DAwesomEL/BachelorProsjekt/Pictures/Components/Buck converter.jpg

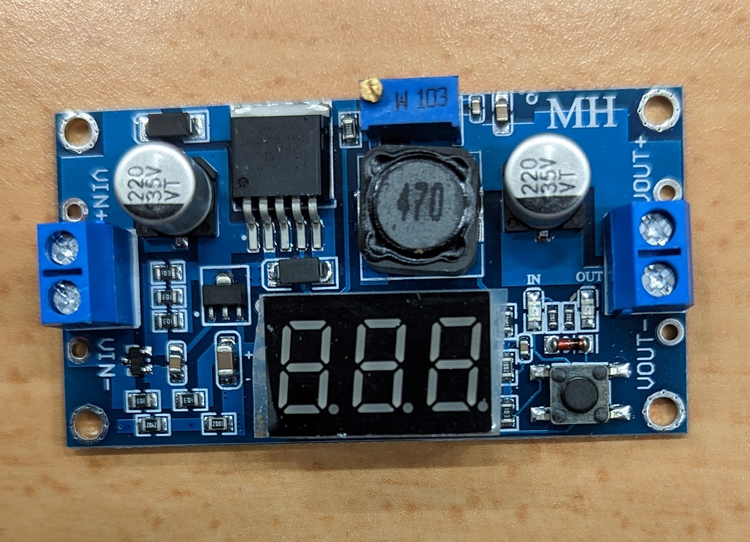
Pictures/Components/Buck converter.jpg
