DAwesomEL/BachelorProsjekt/Pictures/Components/Battery pack.jpg

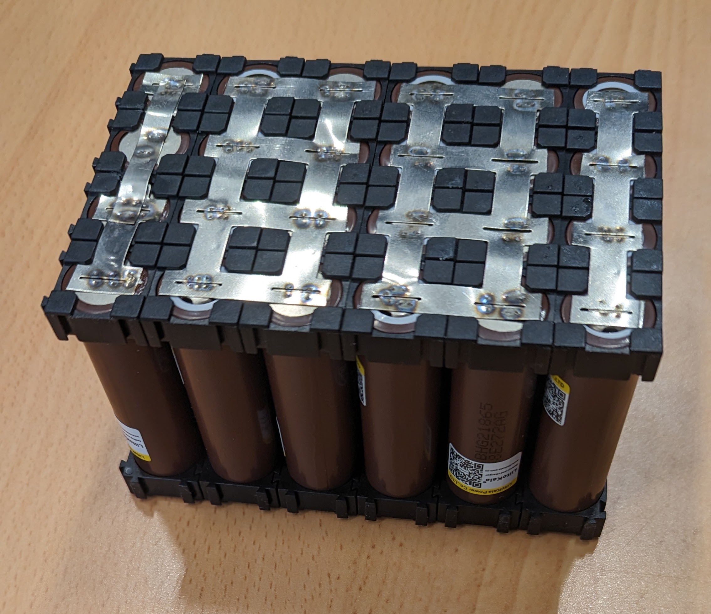
Pictures/Components/Battery pack.jpg
