DAwesomEL/BachelorProsjekt/NOTES/Ting vi har lært.docx

# Ting vi har lært

- Burde dimesjonere oppgjengede hull til oppborringsdiameter, hvis det da ikke gjenges opp kan dette gjøres etterpå. Hvis ikke kan en mennesklig feil gjøre at man må lage en helt ny del.
