DAwesomEL/BachelorProsjekt/NOTES/ToDo.docx

ToDo:

- Søke ntnu
  - Laste opp document når det kommer
- Beregne på akselerasjon
- Større vegg (sirkel rund hull for lokk før torsjon aksling) + deksel over motor hvis motoren blir varm
- Albue ledd
- Legge inn slepering i underarm
