DAwesomEL/BachelorProsjekt/NOTES/Gripper.docx

# Gripper

For å gjøre det simplest mulig, er det bare en motor som driver gripemekanismen. For å gjøre dette må alle fingrene styres av samme motor. Hensyn for at en av fingrene stopper før de andre kan det må tas hensyn til.

Dobbel vippe. Vippe 1: en side til tommel, andre til begge fingrene, vippe 2: festet I en av tauene fra vippe 1 og går til en finger hver. Dette løser alle problemene ved å bruke bare en motor. Trenger trinser og avansert print. Fingrene er trådbaserte. Bruk denne motoren: https://no.rs-online.com/web/p/dc-motors/2456102
