DAwesomEL/BachelorProsjekt/NOTES/Møte uke 6.docx

# Møte uke 6

Skal vi sette opp faste møter fra nå av? Hvilket tidspunkt passer isåfall?

Svar: Sett opp en repeterende outlook kalender invitasjon møter.

Dobbel eller enkel motor I skulder? Kapasisteten blir litt lav med en motor(og det er uten e.e), og vi har funnet en god løsning for beltedrift, men det blir en kontrollutfordring. Vil dette i så fall se bra ut i selve oppgaven? Sterkere motor er veldig vanskelig å finne. Vi kan gire ned motoren mer, men det tar mye plass så er ikke egentlig et alternativ.

Svar:

Beltedrift: Er et smalere belte mindre stift? Går det bra med så liten radius på pulley og idler? 15mm eller 9mm (må bestille 9 men er billig og gir mer mening til det vi lager)

Svar: Kjøp 9 mm

Maskinering av Akslinger fra m10 og m12 maskinskruer, kan det gjøres på huset, hjelp av Harald?

Svar: Vi gjør et forsøk

Vi tenker å bruke simeringer på akselene i kombinasjon med deep groove ball bearings. Tanker? For torsjon av albue, trengs det en thrustbearing?

Svar:

Har Morten fått tak i noen motorkontrollere?

Svar: Fikse selv, få nummer på mail fra Morten

Festeplate av alu, mulig å frese Harald?

Todo videre:

Prøve å flytte motorene bak, for å åpne opp området forran sensorene. Dele parten slik at den blir enklere å lage i alu etter hvert
