DAwesomEL/BachelorProsjekt/NOTES/Regning og gjøremål uke 3.docx

Armen må være 80cm lang fra skulder for å rekke opp til heisknappene. Moment i skulderledd varierer jo derfor av vekt på armen, men all last i hånd vil være mulig på 80cm fra skulderledd. Dette gjør at motorene må være kraftige

Antall | Type | Nummer | Bruk | Pris
4 | Motor | SKU:FIT0186 | 1 krage, 2 skulder, 1 rotasjon overarm | 4 * 290
3 | Motor | SKU:FIT0493 | 1 Albue, 2 end effector posisjonering | 3 * 300

Misc: Teppe fra europris, kartnåler

Gir: RS har løse gir

Motorkontroller

Batterilading?

MONOARM?!?!?!?!?
