DAwesomEL/BachelorProsjekt/NOTES/Presentasjonsforberedende.docx

Spørsmål

- Norsk? Vi kan velge ja
- Hva skal vi fokusere på å ha med i presentasjonen? Alt vi har gjort, så oppsummere rapporten på en måte. +
- Hvordan skal vi rette på de tingene som vi vet at er gjort feil i rapporten? Ha bisetning i muntlig tale på presentasjonen
- Får vi uttelling for å utvikle videre?

Velkommen til denne Bachelor presentasjonen. I dag vil vi vise frem manipulatorene for Loomo roboten som vi har designet og produsert, og tingene den kan gjøre.

Vi har brukt Dynamikk, Kinematikk,

Welcome to this Bachelor presentation. We will today present the manipulators of the Loomo robot and its capabilities.
