DAwesomEL/BachelorProsjekt/Bachelor video/Pictures/DiagonalManipulator.jpg

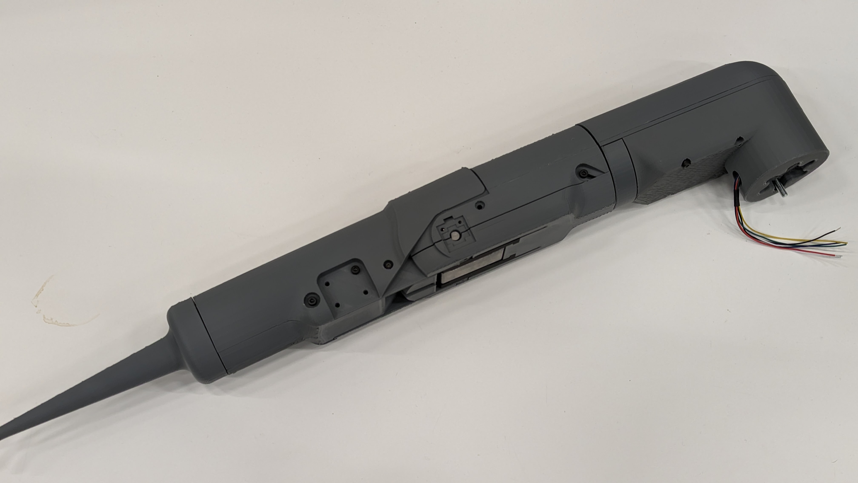
Bachelor video/Pictures/DiagonalManipulator.jpg
