DAwesomEL/BachelorProsjekt/Bachelor video/Pictures/HighHorizontalManipualtor.jpg

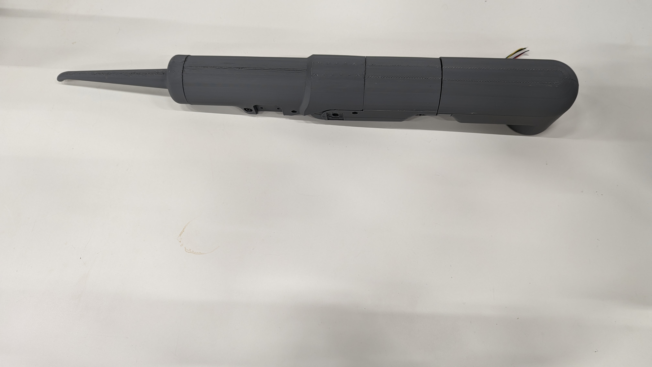
Bachelor video/Pictures/HighHorizontalManipualtor.jpg
