DAwesomEL/BachelorProsjekt/Bachelor video/Pictures/original_7249c3d5-0262-4994-b765-07d0fb0c7d41_PXL_20230512_184123654.jpg

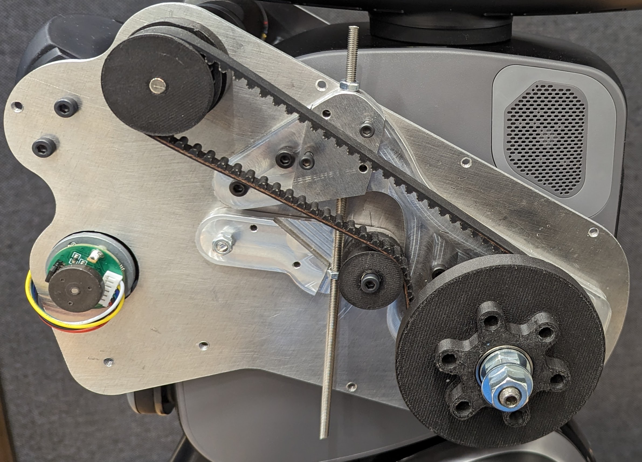
Bachelor video/Pictures/original_7249c3d5-0262-4994-b765-07d0fb0c7d41_PXL_20230512_184123654.jpg
