DAwesomEL/BachelorProsjekt/Bachelor video/Pictures/original_b9bfd44d-96fb-4090-b2bf-ea5d4d30f23f_PXL_20230512_185030678.jpg

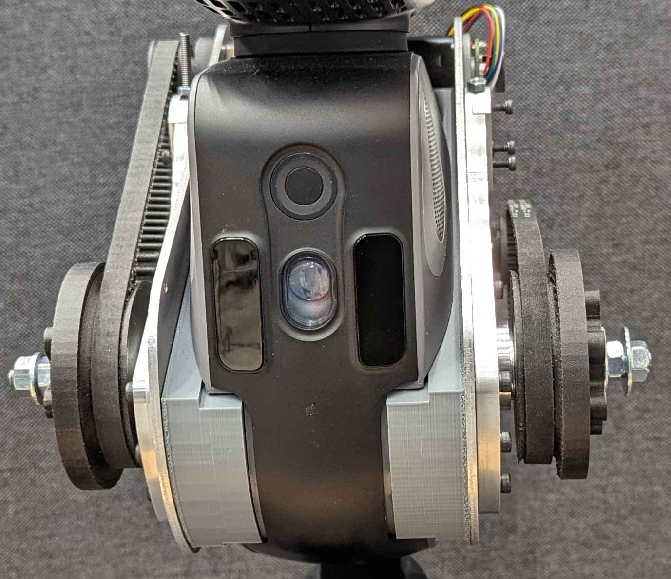
Bachelor video/Pictures/original_b9bfd44d-96fb-4090-b2bf-ea5d4d30f23f_PXL_20230512_185030678.jpg
