DAwesomEL/BachelorProsjekt/Bachelor video/Pictures/original_f11c79bc-f89f-42e6-9544-27d91f9917c7_PXL_20230512_184504795.jpg

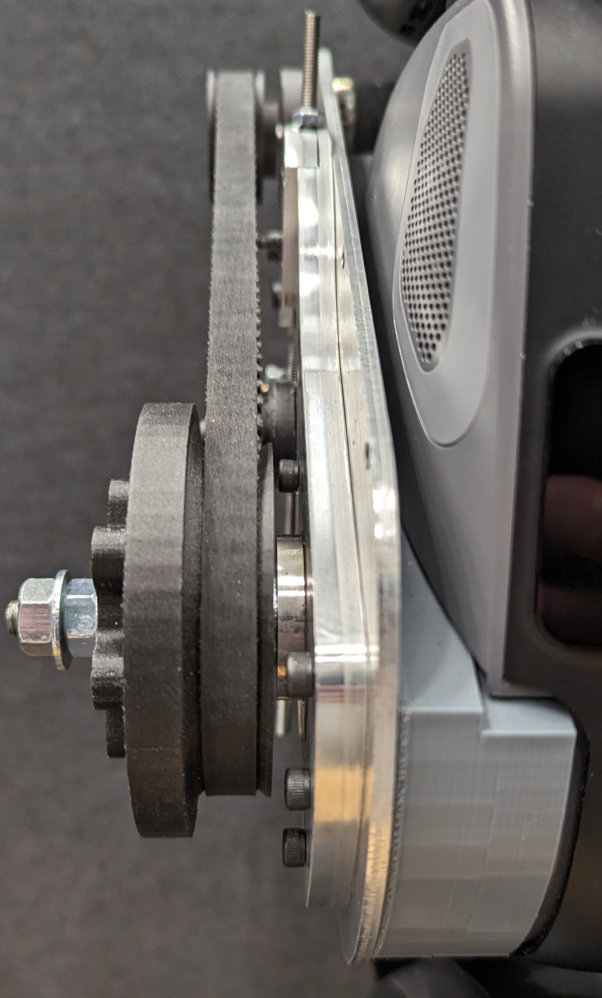
Bachelor video/Pictures/original_f11c79bc-f89f-42e6-9544-27d91f9917c7_PXL_20230512_184504795.jpg
