DAwesomEL/BachelorProsjekt/Bachelor video/Pictures/PXL_20230216_081418842.jpg

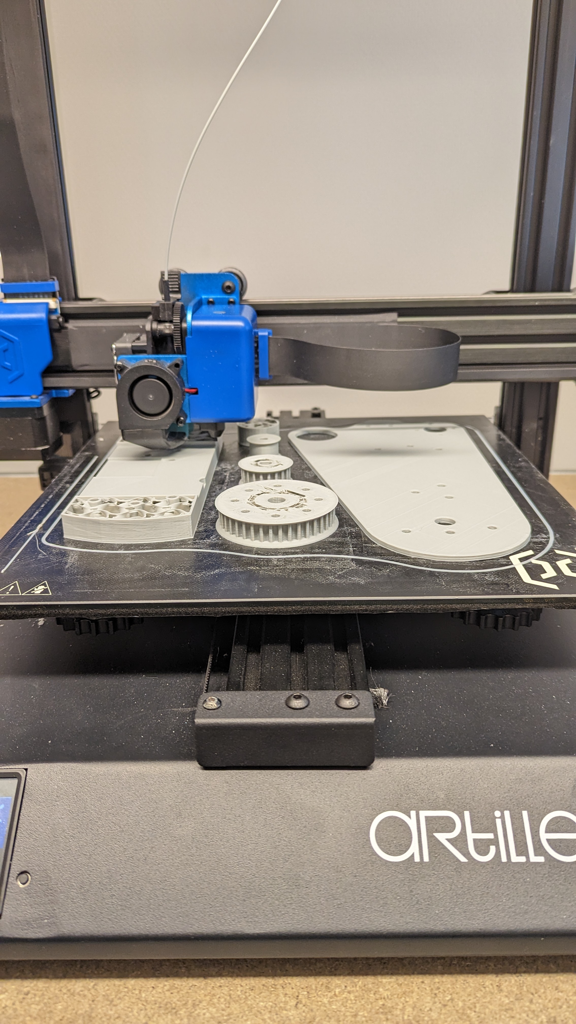
Bachelor video/Pictures/PXL_20230216_081418842.jpg
