DAwesomEL/BachelorProsjekt/Bachelor video/Pictures/PXL_20230216_141814692.jpg

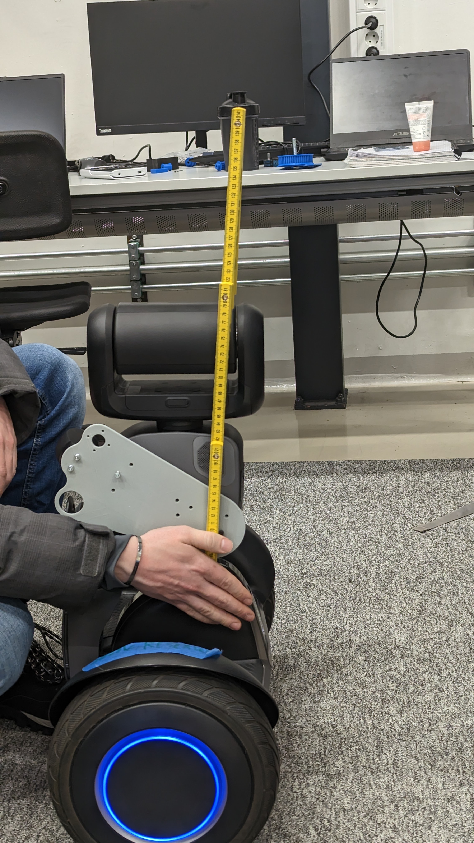
Bachelor video/Pictures/PXL_20230216_141814692.jpg
