DAwesomEL/BachelorProsjekt/Bachelor video/Pictures/PXL_20230216_141823561.jpg

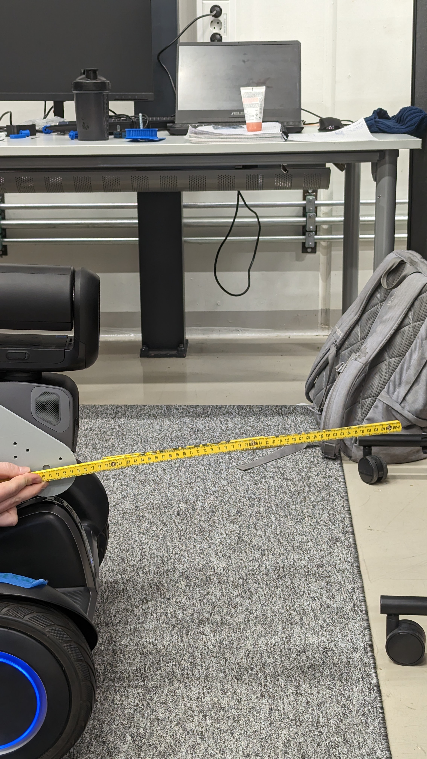
Bachelor video/Pictures/PXL_20230216_141823561.jpg
