DAwesomEL/BachelorProsjekt/Bachelor video/Pictures/PXL_20230405_074010291.jpg

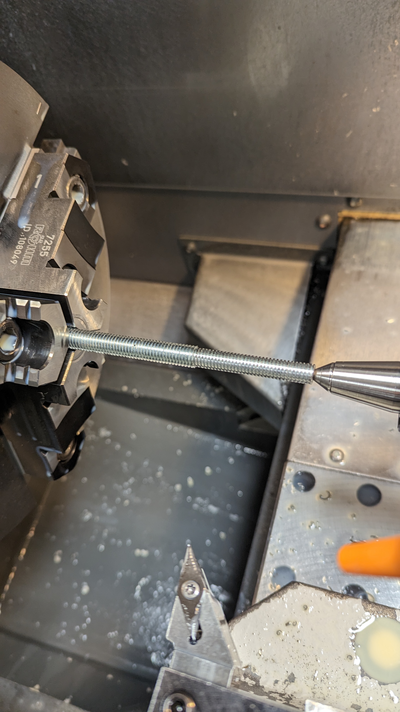
Bachelor video/Pictures/PXL_20230405_074010291.jpg
