DAwesomEL/BachelorProsjekt/Bachelor video/Pictures/PXL_20230425_102538347.jpg

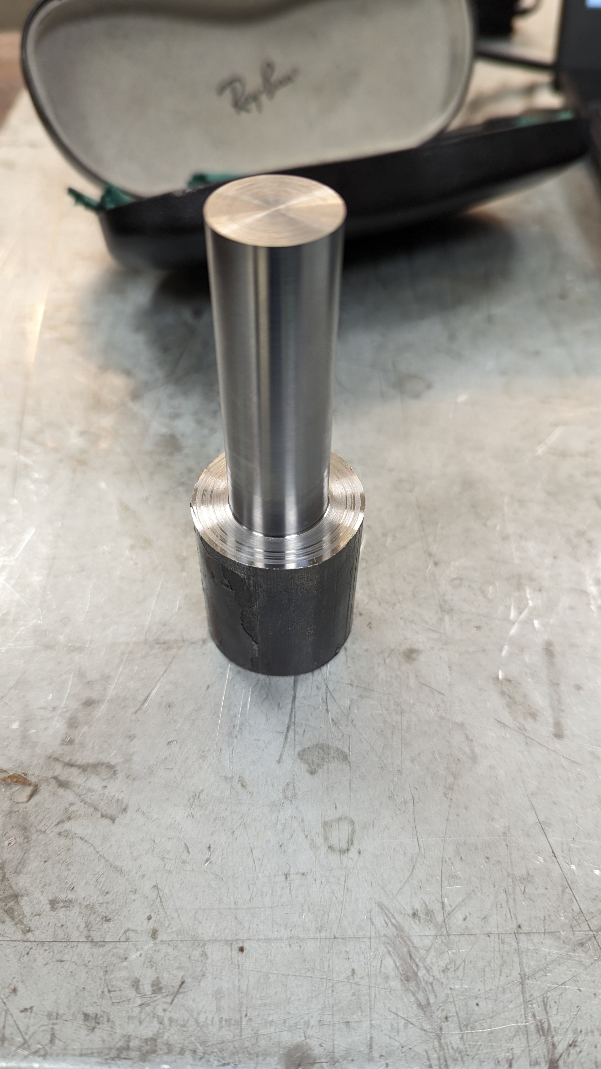
Bachelor video/Pictures/PXL_20230425_102538347.jpg
