DAwesomEL/BachelorProsjekt/Bachelor video/Pictures/PXL_20230426_081251921.jpg

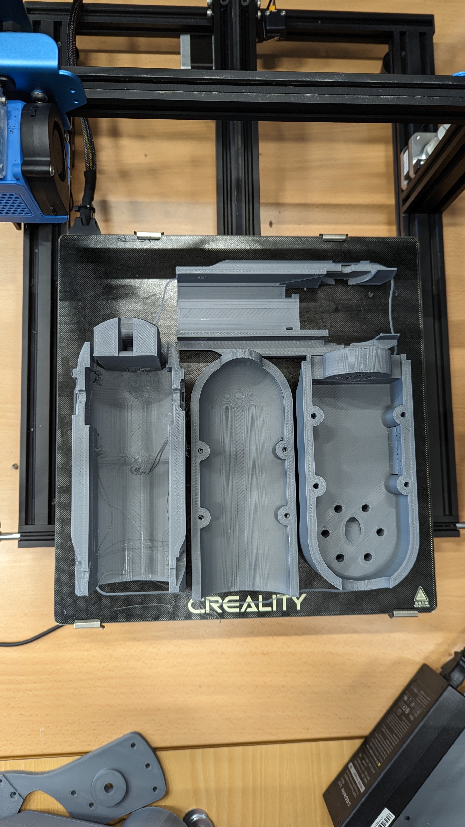
Bachelor video/Pictures/PXL_20230426_081251921.jpg
