DAwesomEL/BachelorProsjekt/Bachelor video/Pictures/PXL_20230428_134609052.jpg

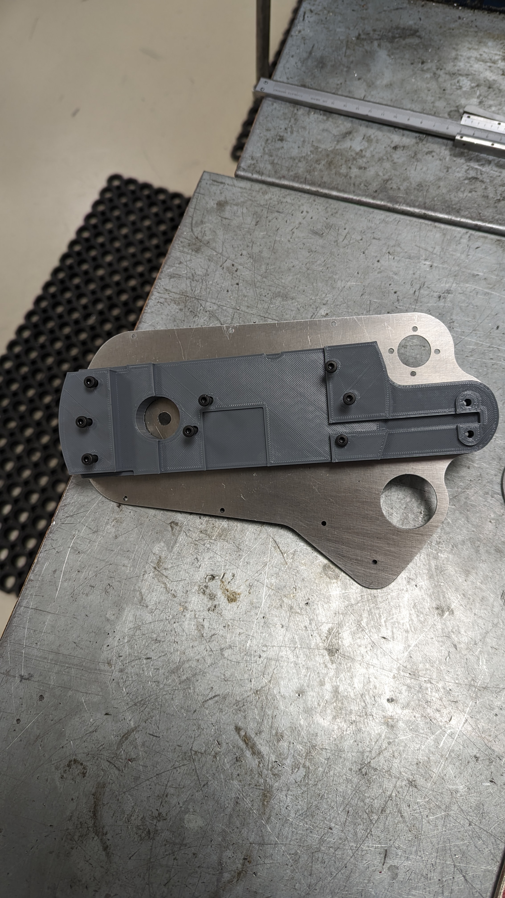
Bachelor video/Pictures/PXL_20230428_134609052.jpg
