DAwesomEL/BachelorProsjekt/Bachelor video/Pictures/PXL_20230429_090824855.jpg

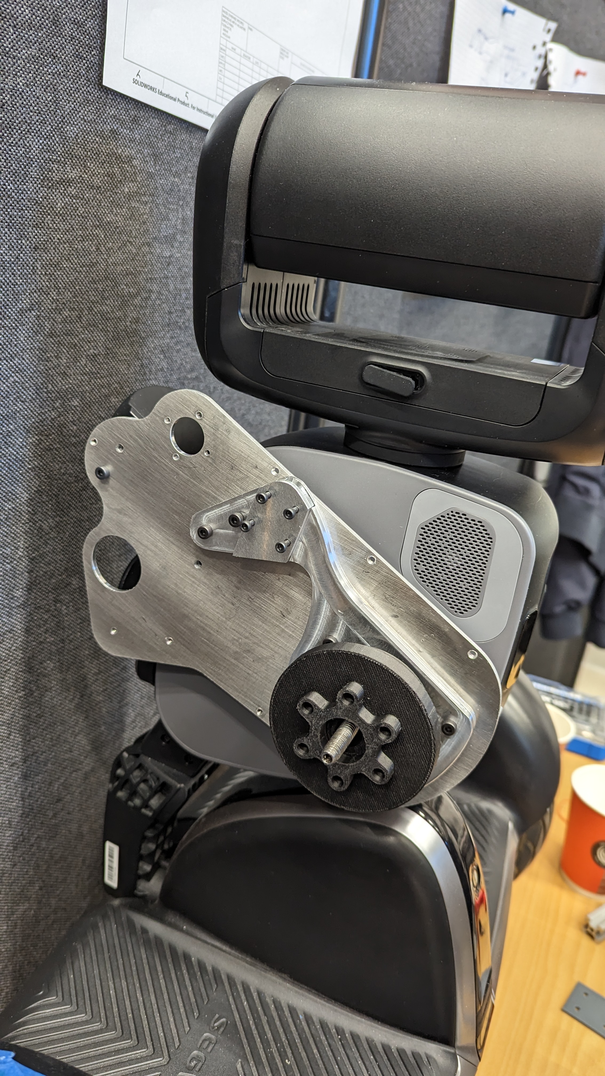
Bachelor video/Pictures/PXL_20230429_090824855.jpg
