DAwesomEL/BachelorProsjekt/Bachelor video/Pictures/PXL_20230430_144859800.jpg

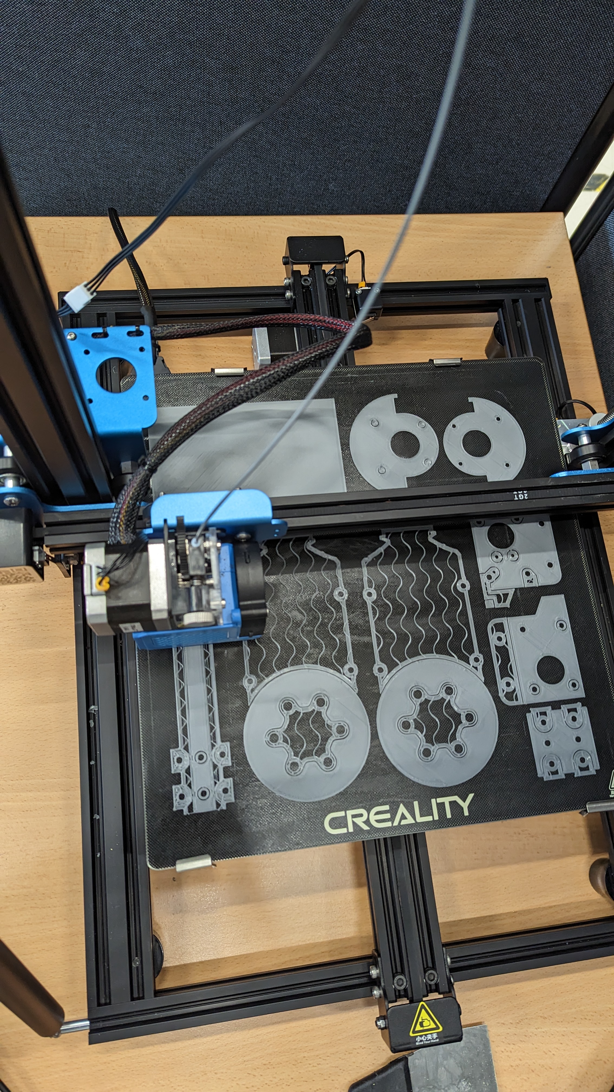
Bachelor video/Pictures/PXL_20230430_144859800.jpg
