DAwesomEL/BachelorProsjekt/Bachelor video/Pictures/PXL_20230506_135338604.jpg

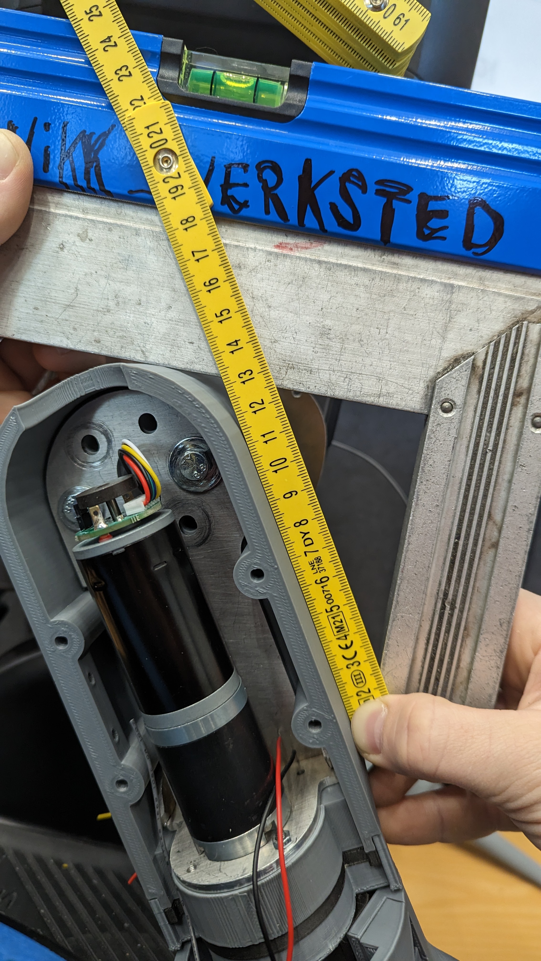
Bachelor video/Pictures/PXL_20230506_135338604.jpg
