DAwesomEL/BachelorProsjekt/Bachelor video/Pictures/PXL_20230509_191600151.jpg

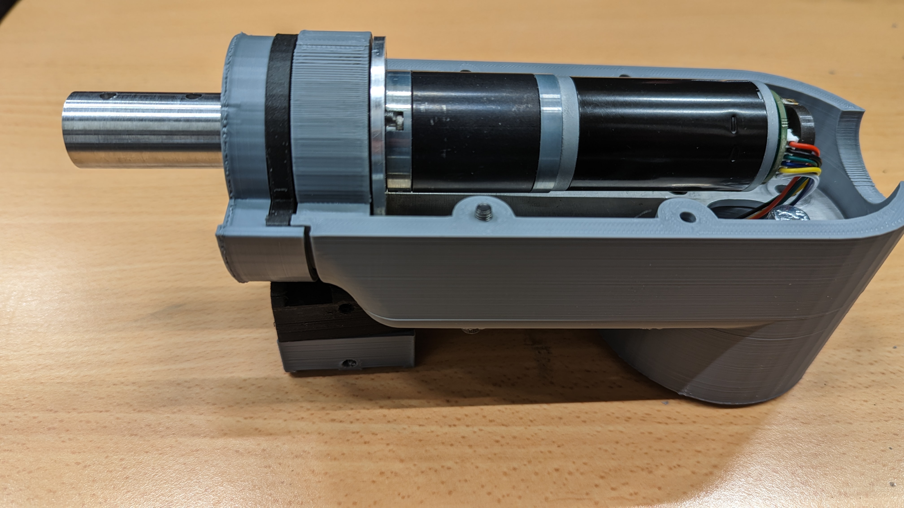
Bachelor video/Pictures/PXL_20230509_191600151.jpg
