DAwesomEL/BachelorProsjekt/Bachelor video/Pictures/PXL_20230512_173815619.jpg

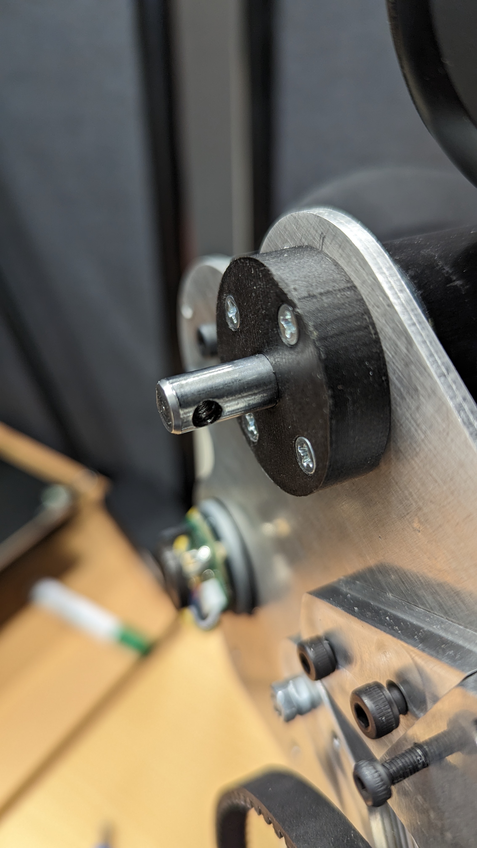
Bachelor video/Pictures/PXL_20230512_173815619.jpg
