DAwesomEL/BachelorProsjekt/Bachelor video/Pictures/SeperatedHorizontalManipulator.jpg

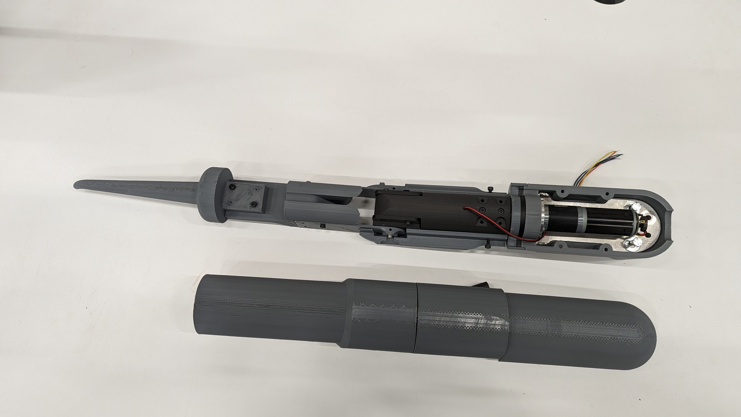
Bachelor video/Pictures/SeperatedHorizontalManipulator.jpg
