DAwesomEL/BachelorProsjekt/Bachelor video/Pictures/Shoulder link.jpg

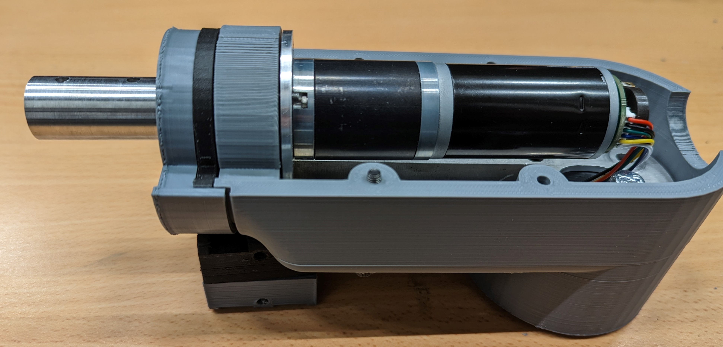
Bachelor video/Pictures/Shoulder link.jpg
