DAwesomEL/BachelorProsjekt/Bachelor video/VideoPicture.PNG

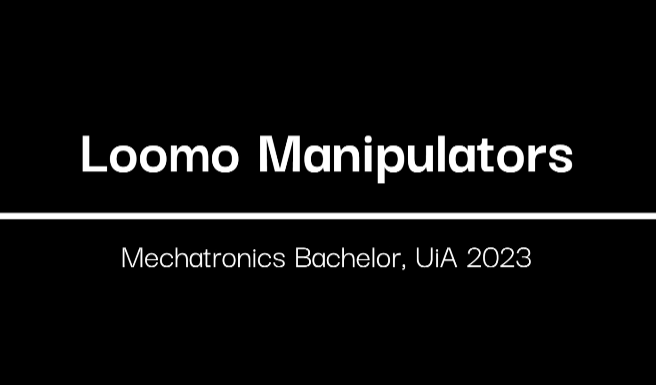
Bachelor video/VideoPicture.PNG
