DAwesomEL/BachelorProsjekt/Literature/Mechanics/A textbook of machine design_ Karwa/Capture.PNG

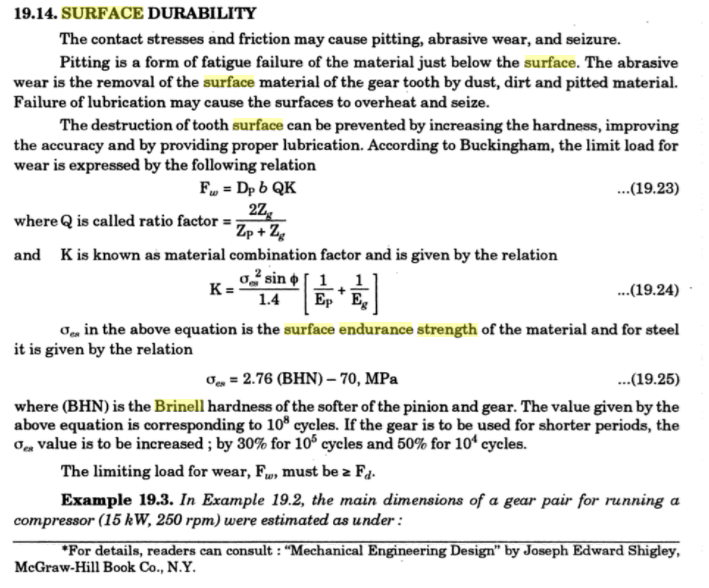
Literature/Mechanics/A textbook of machine design_ Karwa/Capture.PNG
