DAwesomEL/BachelorProsjekt/NOTES/Innkjøpsliste estimat.png

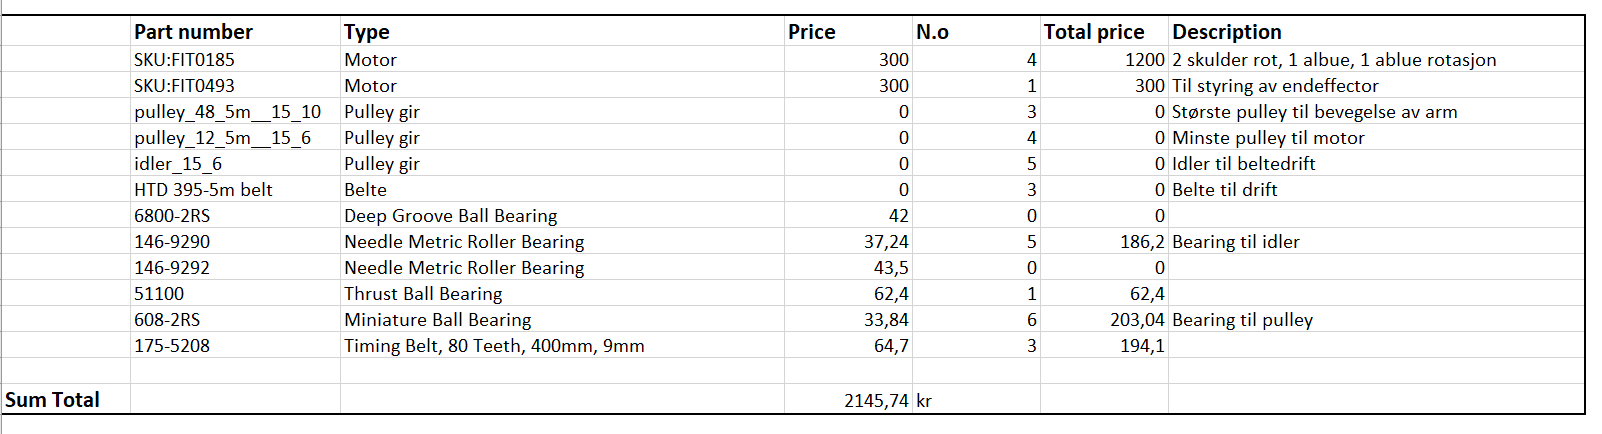
NOTES/Innkjøpsliste estimat.png
