DAwesomEL/BachelorProsjekt/NOTES/ReceiptBiltema1.jpg

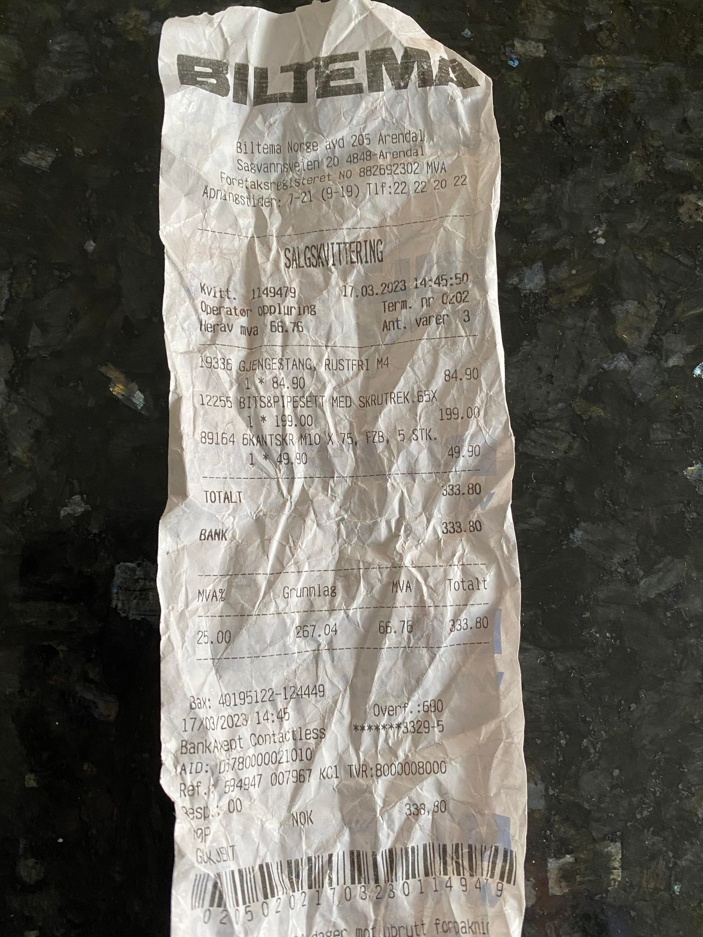
NOTES/ReceiptBiltema1.jpg
