DAwesomEL/BachelorProsjekt/Pictures/Android studio/User interface.png

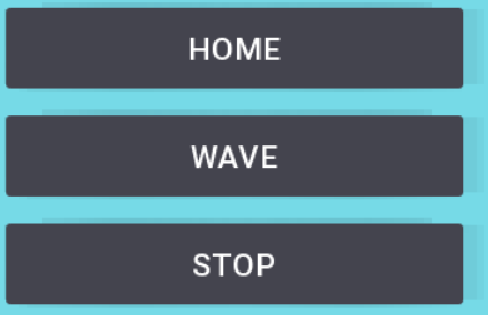
Pictures/Android studio/User interface.png
