DAwesomEL/BachelorProsjekt/Pictures/Angular top speed/SpeedCalcBotPos.PNG

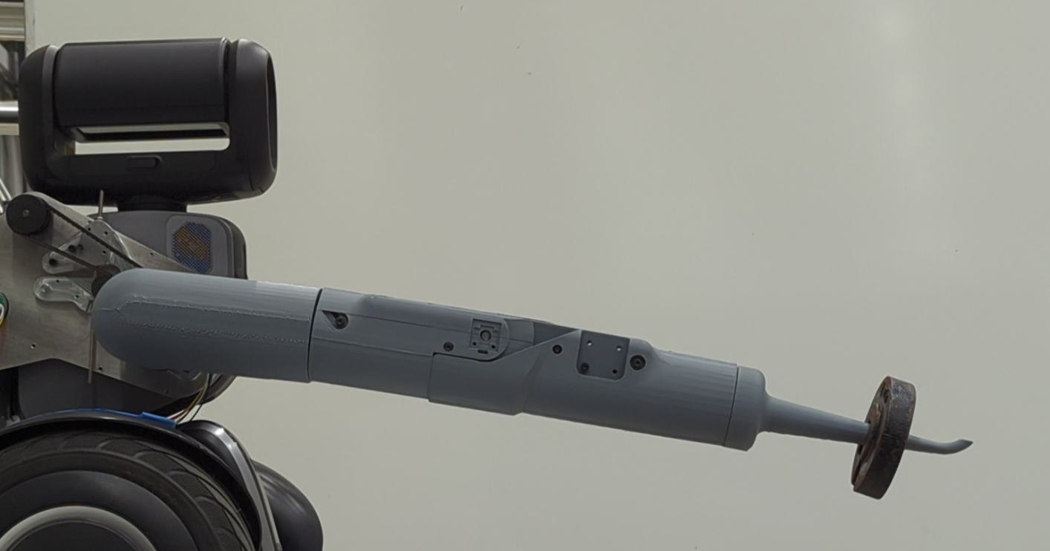
Pictures/Angular top speed/SpeedCalcBotPos.PNG
