DAwesomEL/BachelorProsjekt/Pictures/Angular top speed/SpeedCalcMidPos.PNG

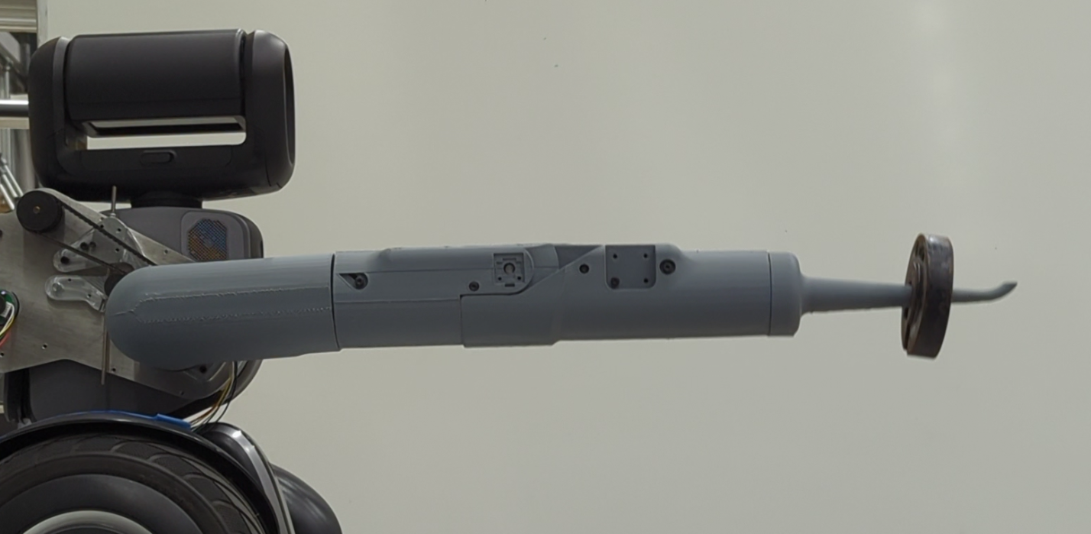
Pictures/Angular top speed/SpeedCalcMidPos.PNG
