DAwesomEL/BachelorProsjekt/Pictures/Angular top speed/SpeedCalcTopAndBot.png

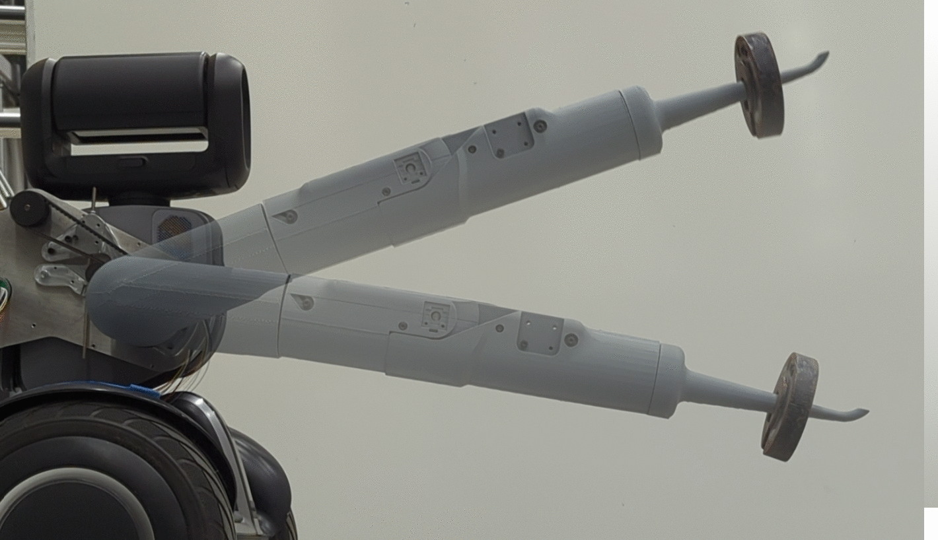
Pictures/Angular top speed/SpeedCalcTopAndBot.png
