DAwesomEL/BachelorProsjekt/Pictures/Angular top speed/SpeedCalcTopAndBotLines.png

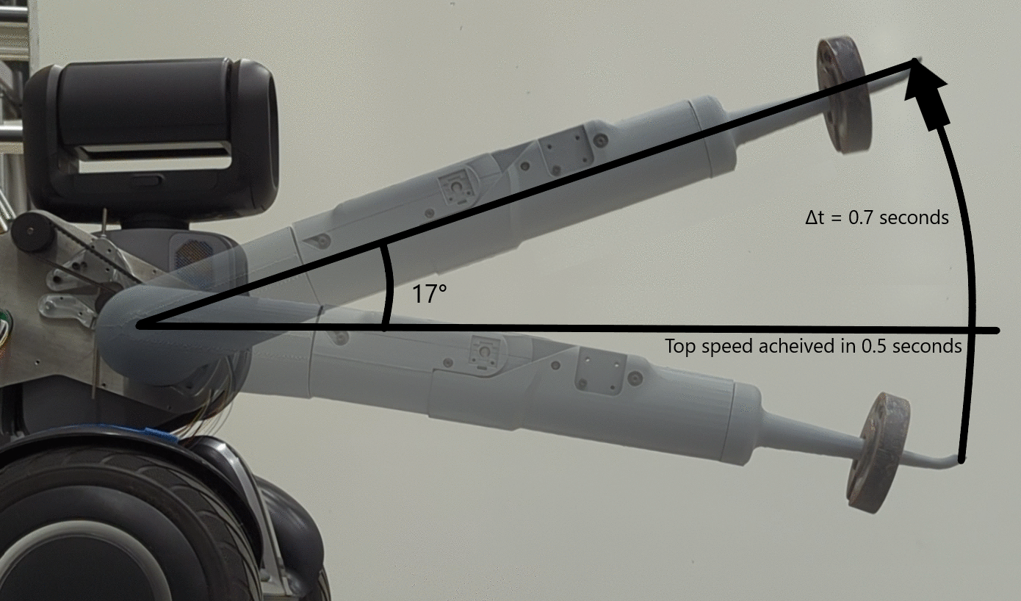
Pictures/Angular top speed/SpeedCalcTopAndBotLines.png
