DAwesomEL/BachelorProsjekt/Pictures/Angular top speed/SpeedCalcTopPos.PNG

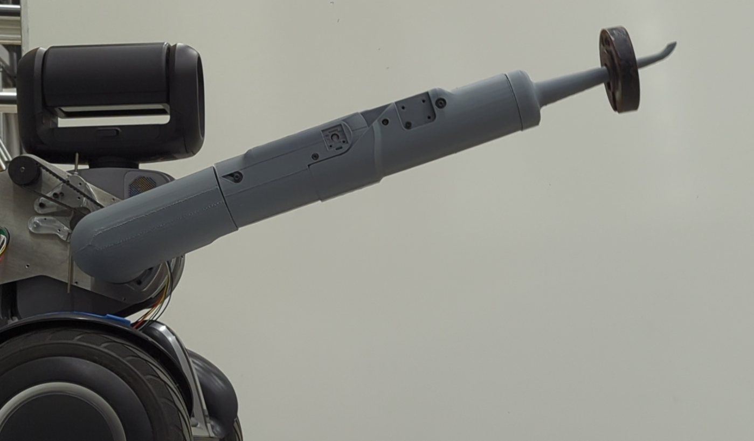
Pictures/Angular top speed/SpeedCalcTopPos.PNG
