DAwesomEL/BachelorProsjekt/Pictures/Arduino Code/CompFilter class.PNG

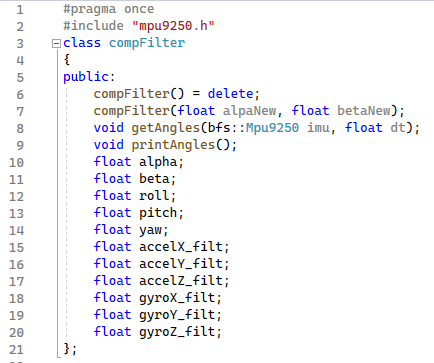
Pictures/Arduino Code/CompFilter class.PNG
