DAwesomEL/BachelorProsjekt/Pictures/Arduino Code/MagnetEncoder class.PNG

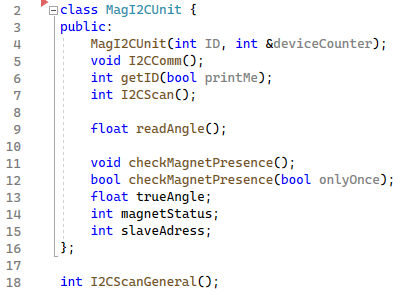
Pictures/Arduino Code/MagnetEncoder class.PNG
