DAwesomEL/BachelorProsjekt/Pictures/Arduino Code/Motor class.PNG

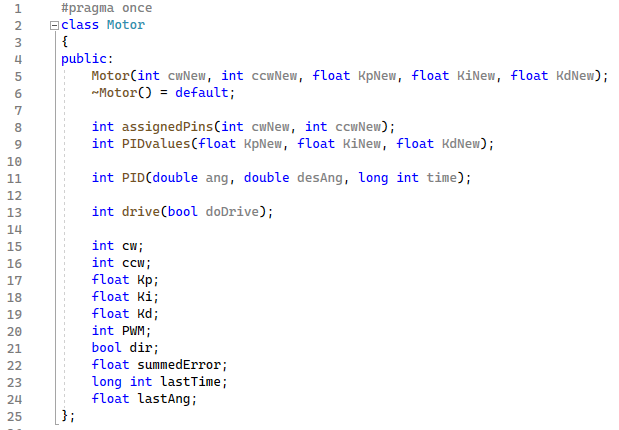
Pictures/Arduino Code/Motor class.PNG
