DAwesomEL/BachelorProsjekt/Pictures/Arm movement pictures/downInClose.png

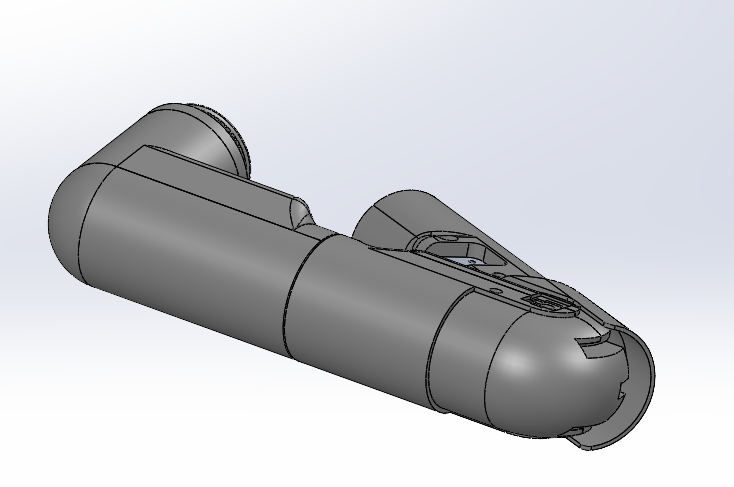
Pictures/Arm movement pictures/downInClose.png
