DAwesomEL/BachelorProsjekt/Pictures/Arm movement pictures/downInOpen.png

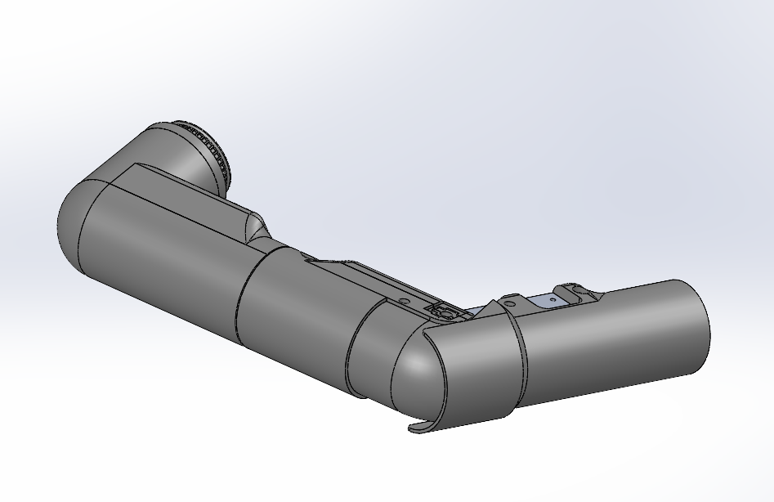
Pictures/Arm movement pictures/downInOpen.png
