DAwesomEL/BachelorProsjekt/Pictures/Arm movement pictures/downOutClose.png

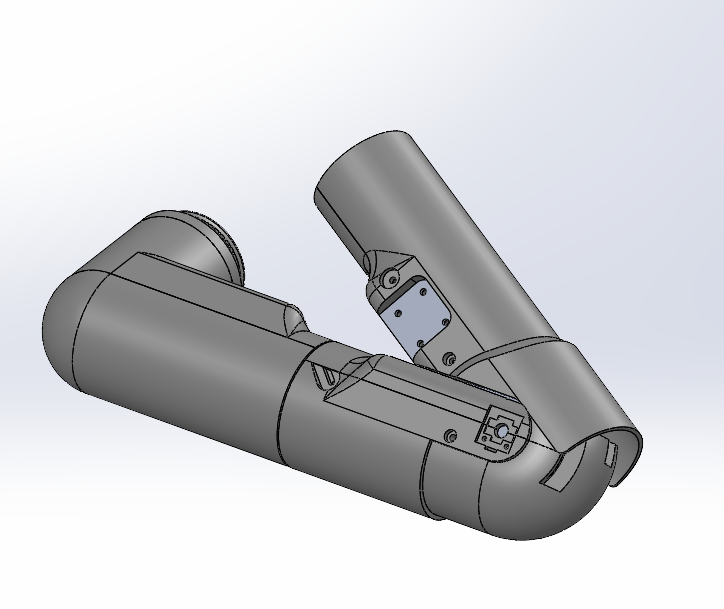
Pictures/Arm movement pictures/downOutClose.png
