DAwesomEL/BachelorProsjekt/Pictures/Arm movement pictures/upOutClose.png

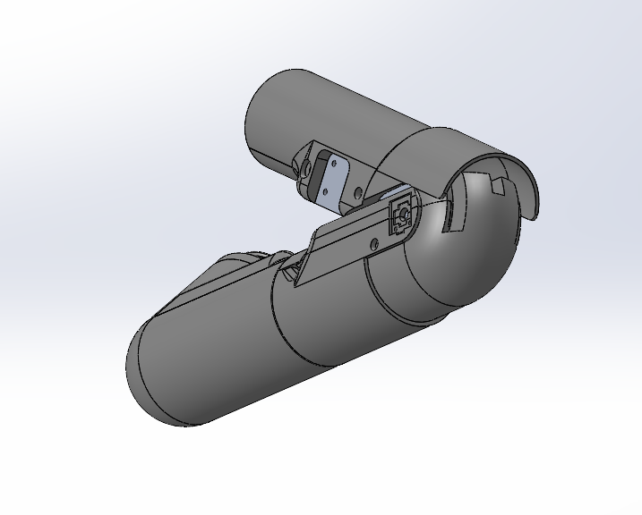
Pictures/Arm movement pictures/upOutClose.png
