DAwesomEL/BachelorProsjekt/Pictures/Bearing/AxialRotation upperarm.jpg

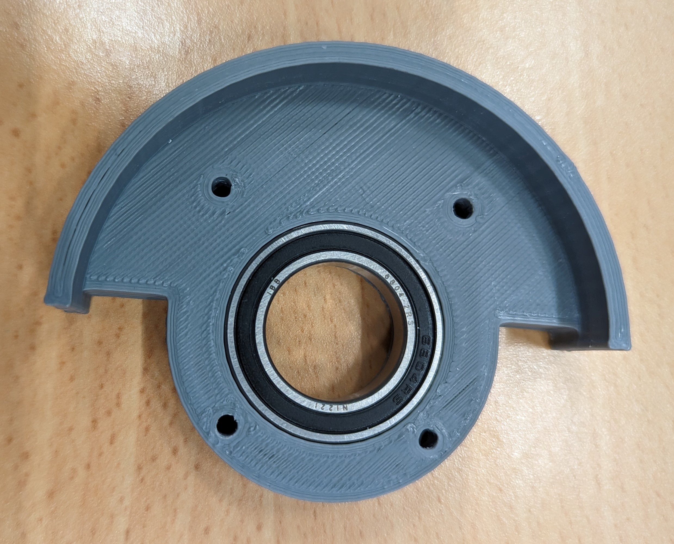
Pictures/Bearing/AxialRotation upperarm.jpg
