DAwesomEL/BachelorProsjekt/Pictures/Bearing/Axlesupport.jpg

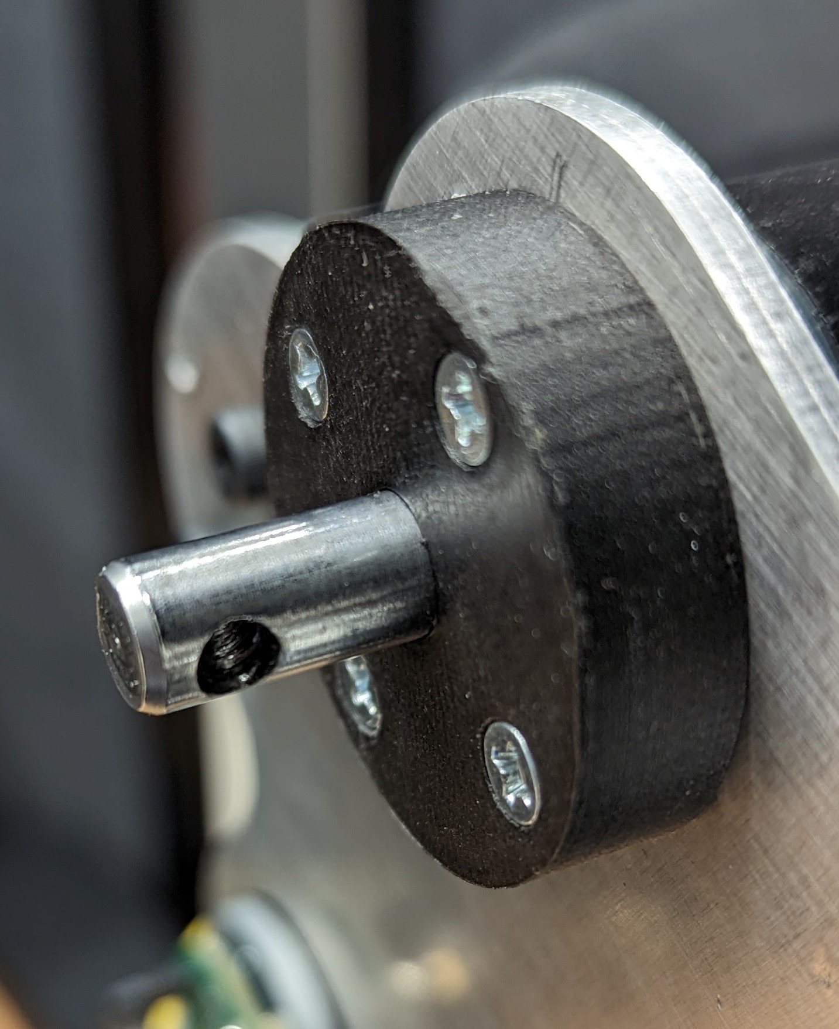
Pictures/Bearing/Axlesupport.jpg
