DAwesomEL/BachelorProsjekt/Pictures/Bearing/Idler mounted.jpg

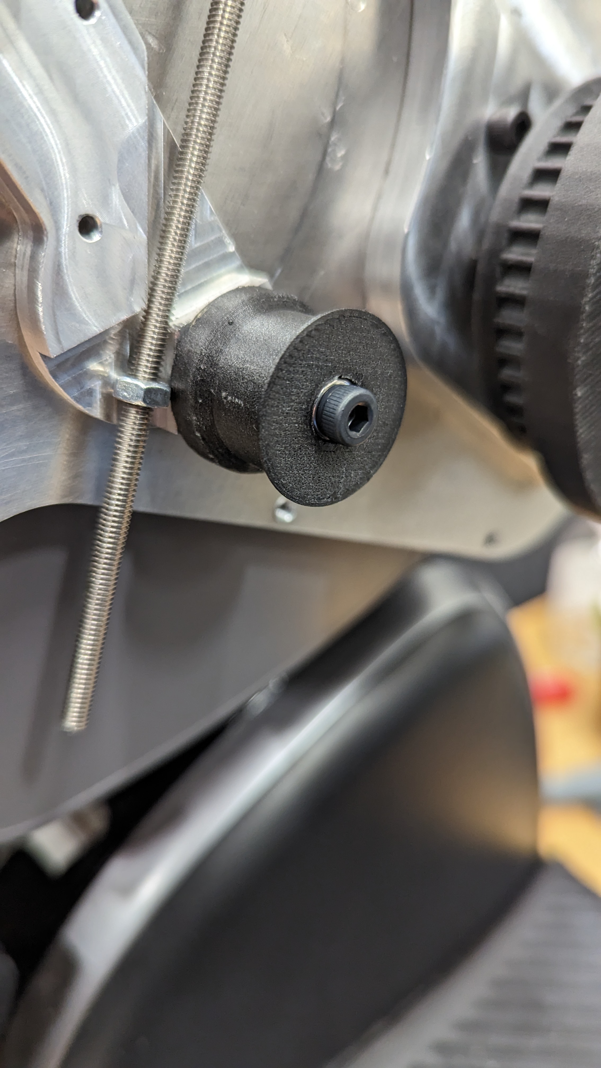
Pictures/Bearing/Idler mounted.jpg
