DAwesomEL/BachelorProsjekt/Pictures/Bearing/Idler.jpg

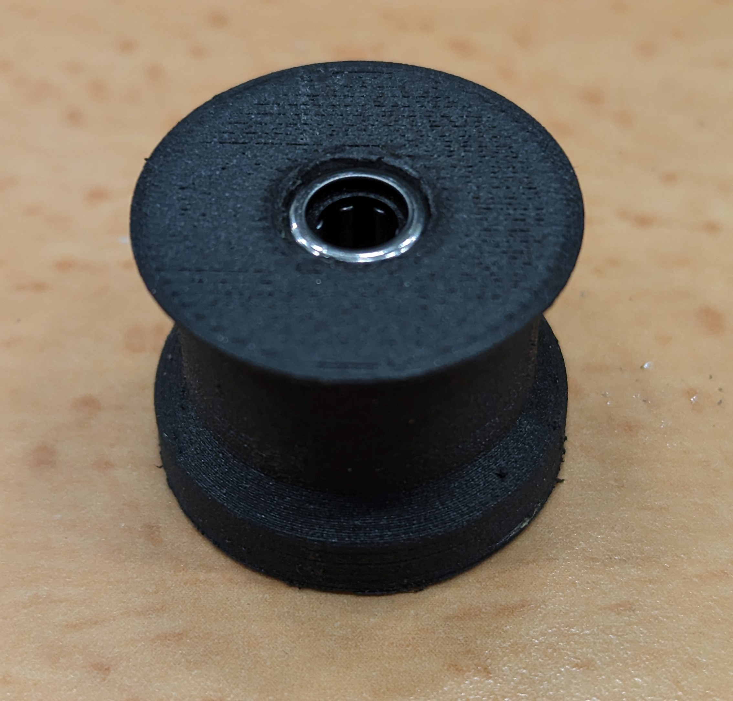
Pictures/Bearing/Idler.jpg
