DAwesomEL/BachelorProsjekt/Pictures/Bearing/Large pulley back.jpg

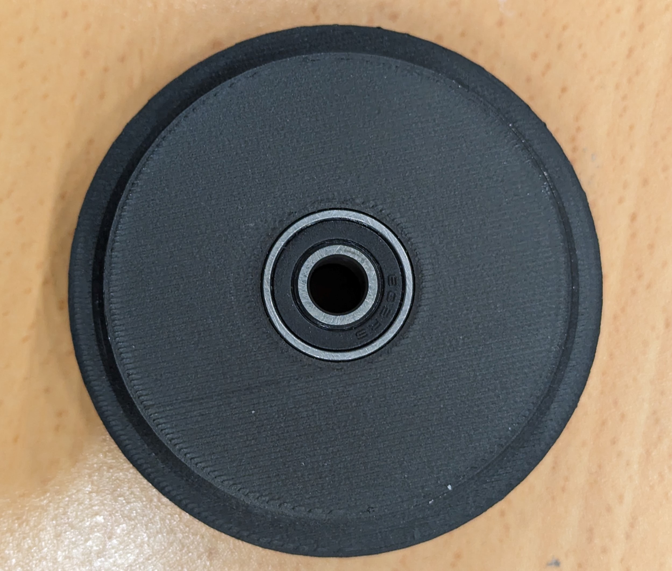
Pictures/Bearing/Large pulley back.jpg
