DAwesomEL/BachelorProsjekt/Pictures/Bearing/Large pulley front.jpg

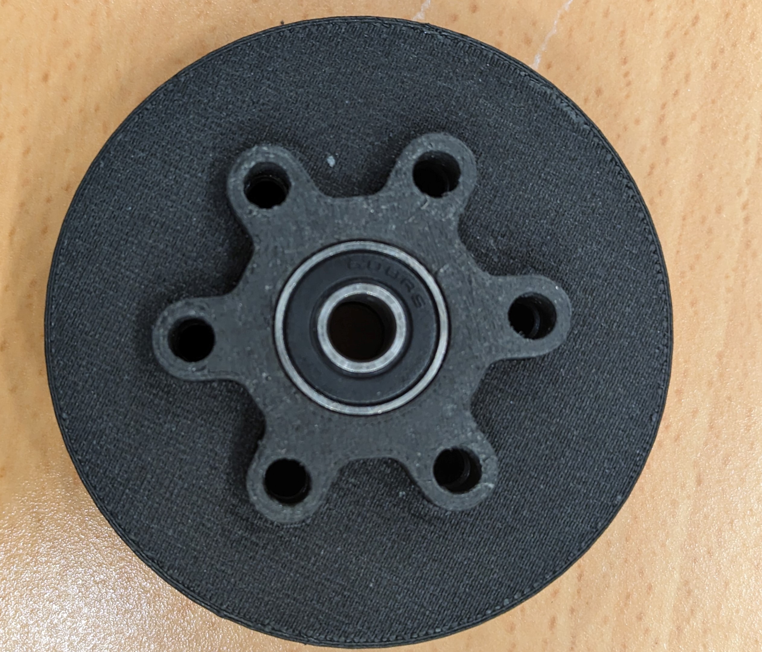
Pictures/Bearing/Large pulley front.jpg
