DAwesomEL/BachelorProsjekt/Pictures/Bearing/Large pulley mounted.jpg

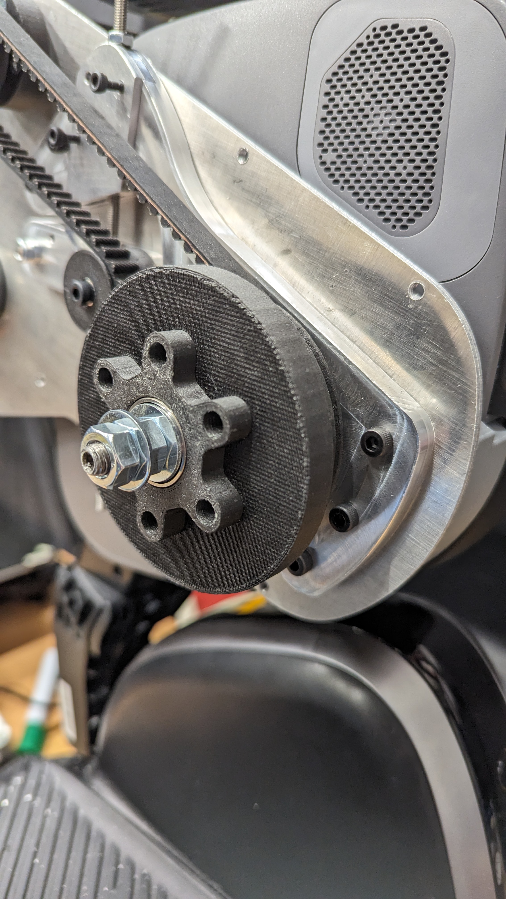
Pictures/Bearing/Large pulley mounted.jpg
