DAwesomEL/BachelorProsjekt/Pictures/Bearing/Small pulley.jpg

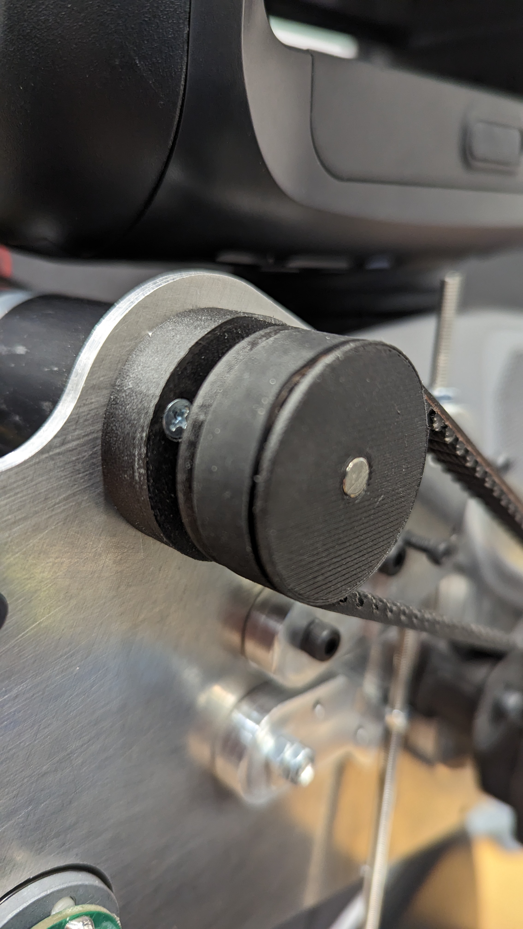
Pictures/Bearing/Small pulley.jpg
