DAwesomEL/BachelorProsjekt/Pictures/Bearing/Torsionaxle.jpg

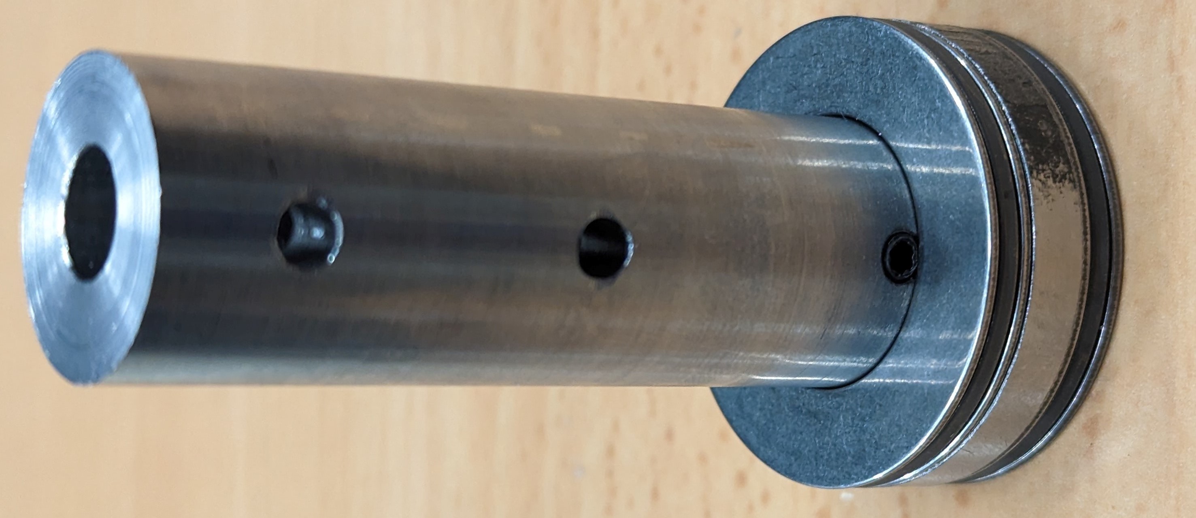
Pictures/Bearing/Torsionaxle.jpg
