DAwesomEL/BachelorProsjekt/Pictures/Center of mass with relaxed.PNG

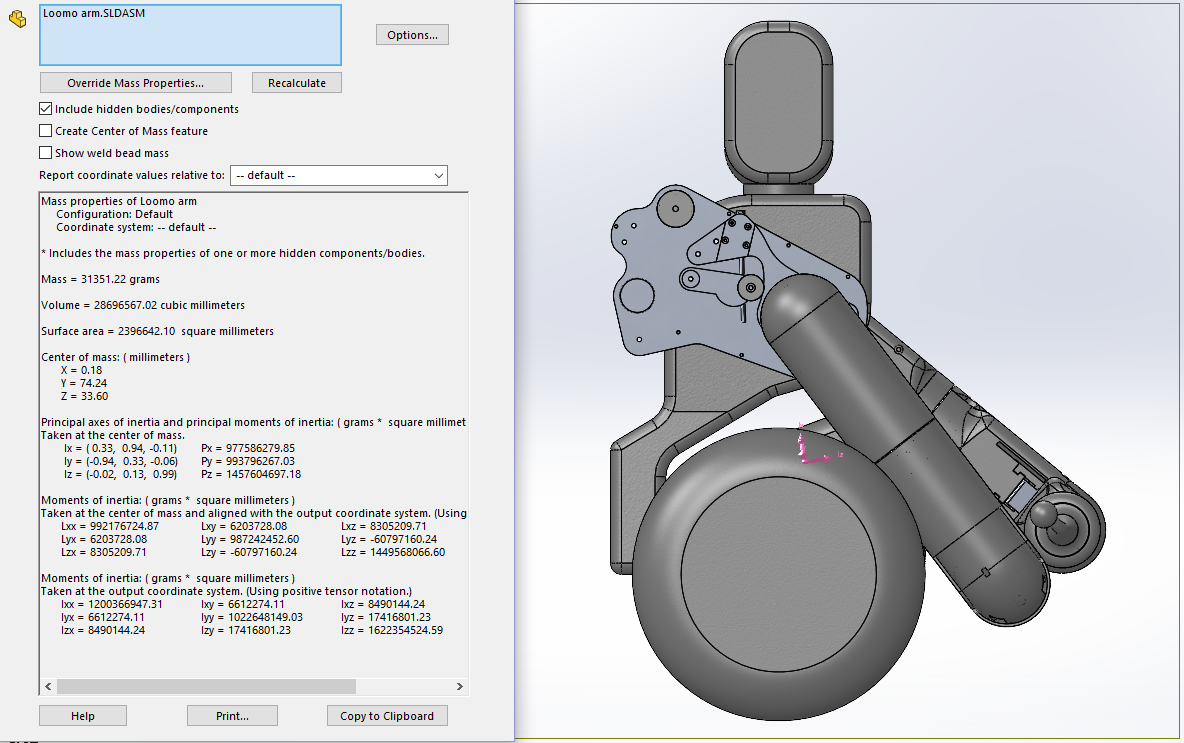
Pictures/Center of mass with relaxed.PNG
