DAwesomEL/BachelorProsjekt/Pictures/Center of mass with straight arms.PNG

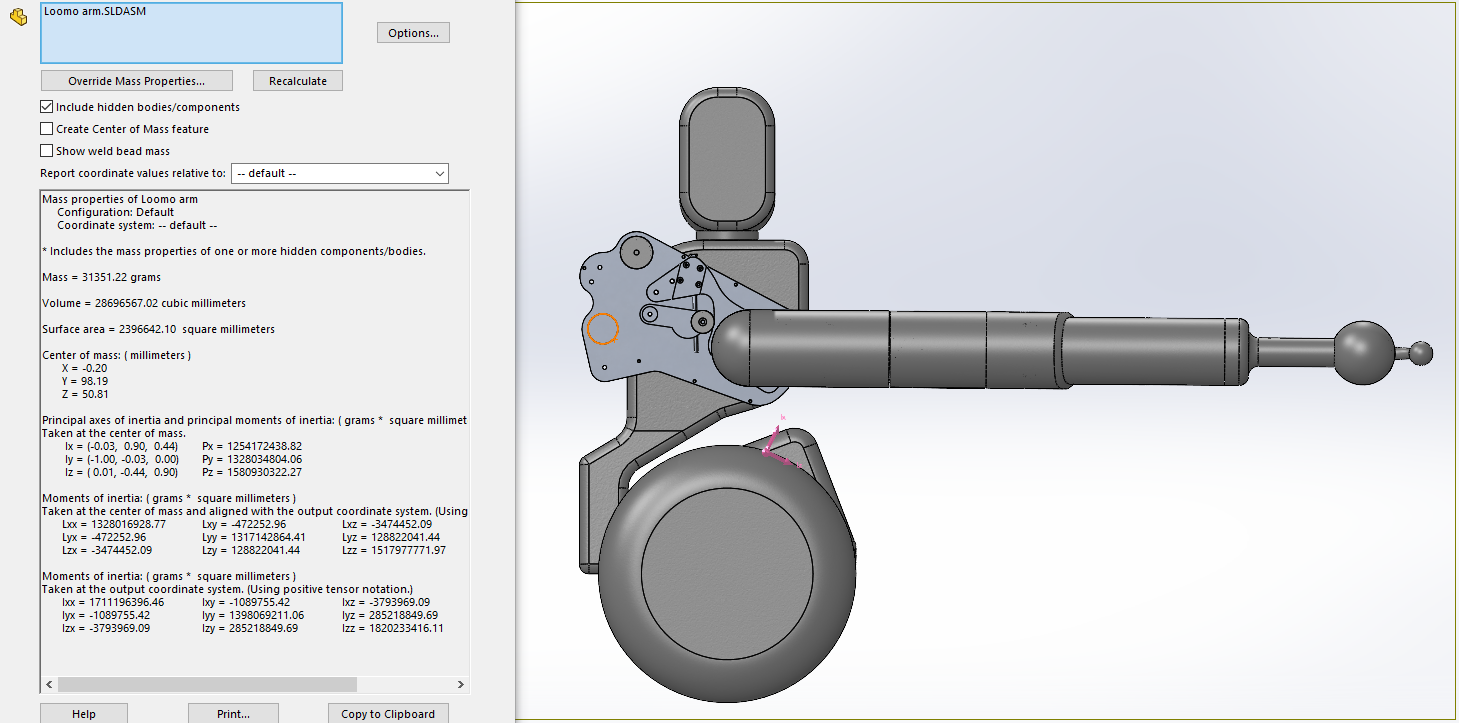
Pictures/Center of mass with straight arms.PNG
