DAwesomEL/BachelorProsjekt/Pictures/ComparasonTables/Arm Length.PNG

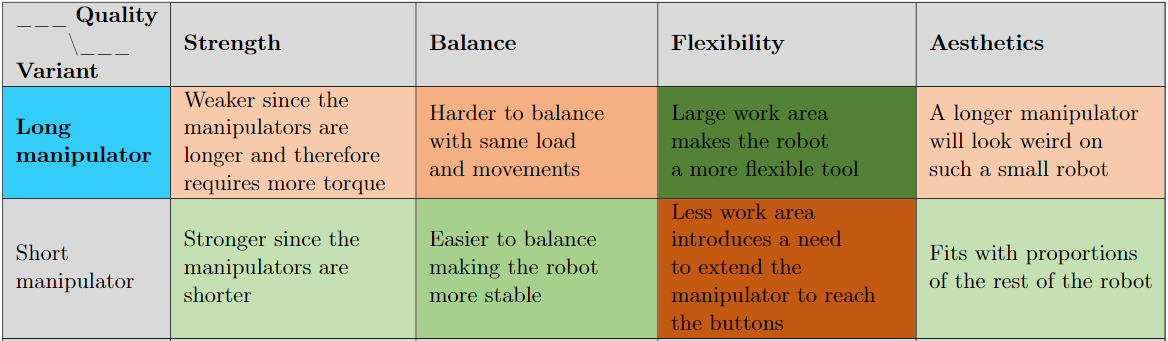
Pictures/ComparasonTables/Arm Length.PNG
