DAwesomEL/BachelorProsjekt/Pictures/ComparasonTables/DOFs.PNG

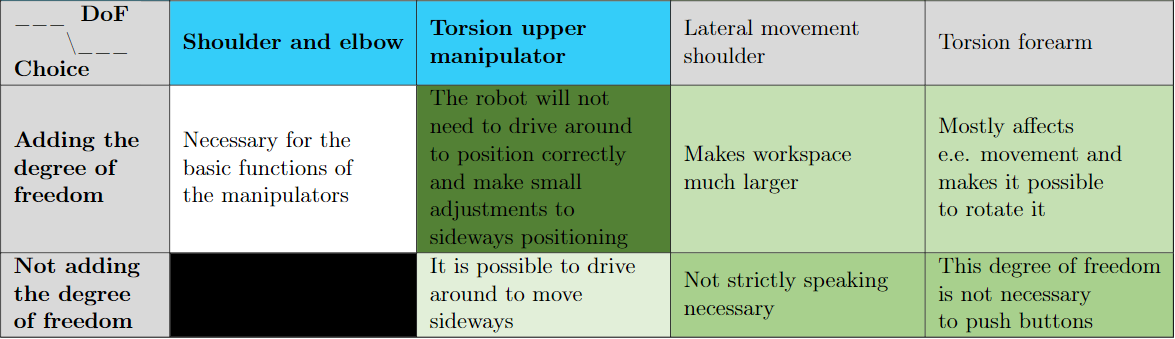
Pictures/ComparasonTables/DOFs.PNG
