DAwesomEL/BachelorProsjekt/Pictures/ComparasonTables/Shoulder and Drive.PNG

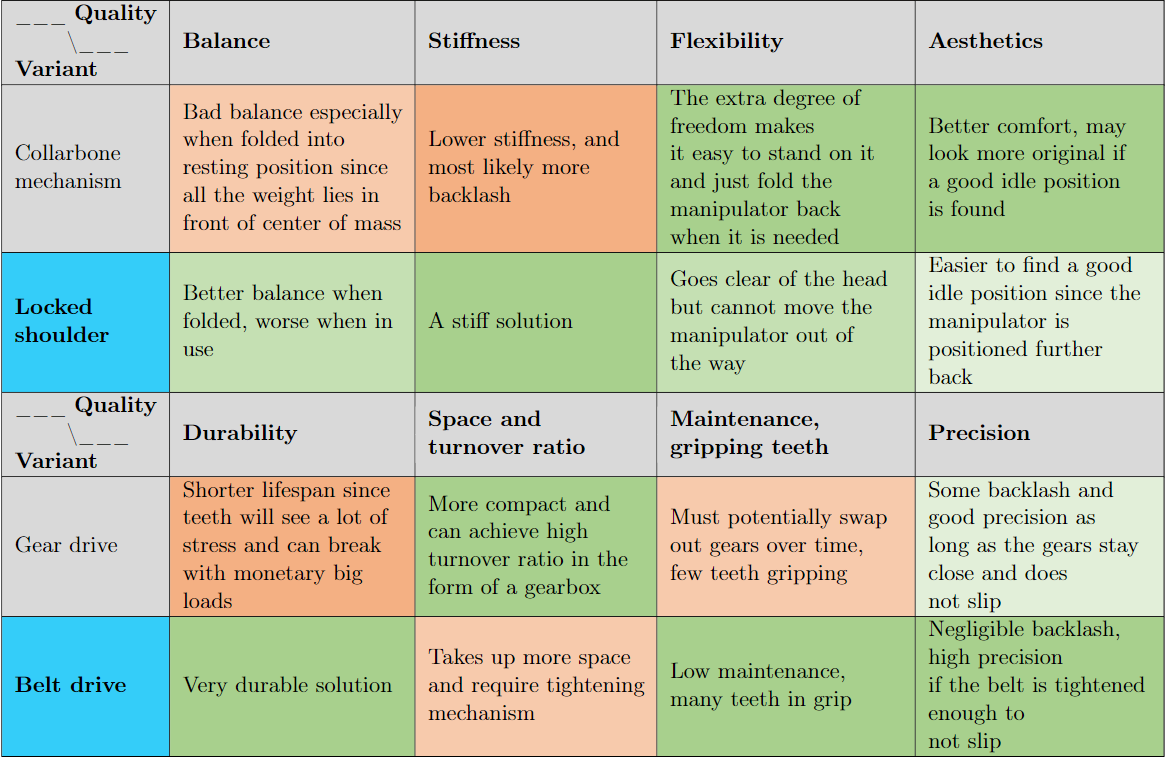
Pictures/ComparasonTables/Shoulder and Drive.PNG
