DAwesomEL/BachelorProsjekt/Pictures/FBD/Actual.png

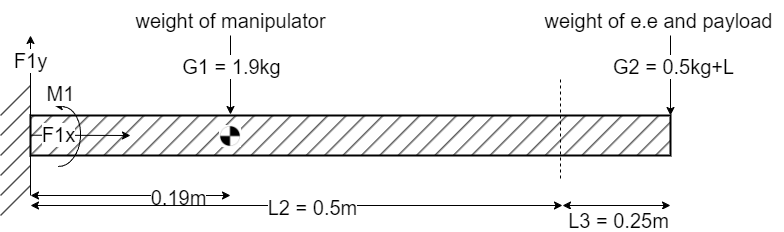
Pictures/FBD/Actual.png
