DAwesomEL/BachelorProsjekt/Pictures/FBD/ASB diagram cut 1.png

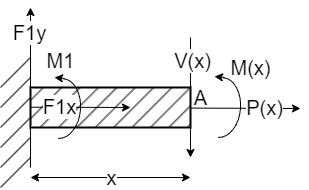
Pictures/FBD/ASB diagram cut 1.png
