DAwesomEL/BachelorProsjekt/Pictures/FBD/ASB diagram cut 2.png

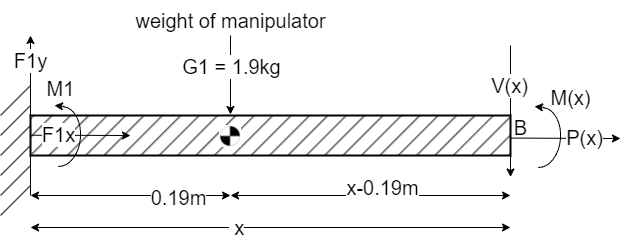
Pictures/FBD/ASB diagram cut 2.png
