DAwesomEL/BachelorProsjekt/Pictures/FBD/ASB graph.jpg

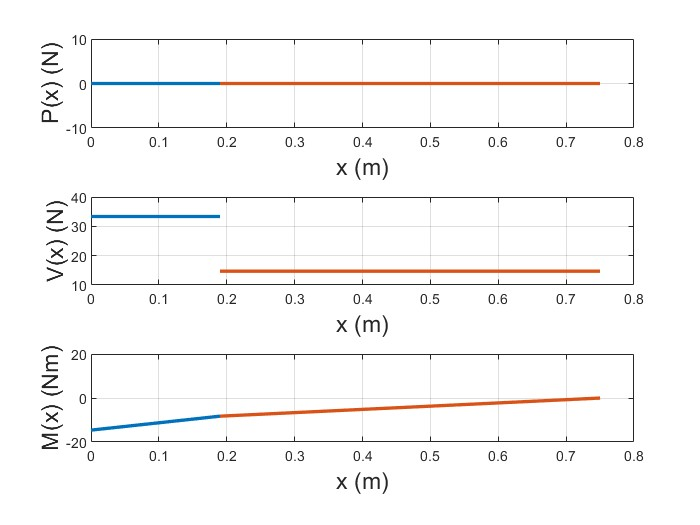
Pictures/FBD/ASB graph.jpg
