DAwesomEL/BachelorProsjekt/Pictures/FBD/Assumed.png

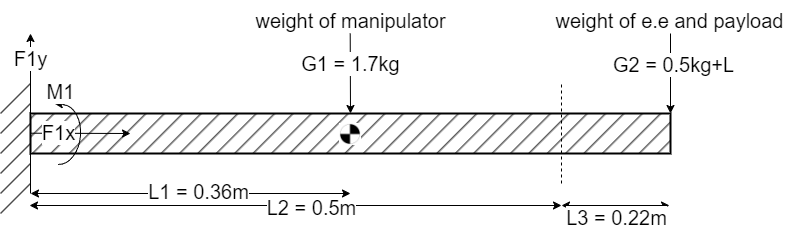
Pictures/FBD/Assumed.png
