DAwesomEL/BachelorProsjekt/Pictures/FBD/Elbow payload capacity.png

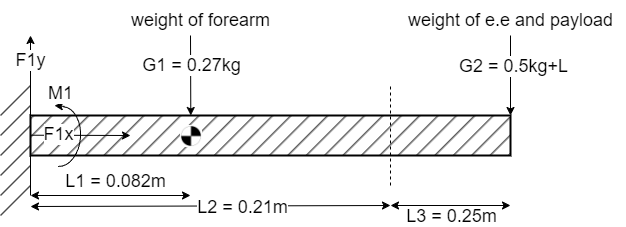
Pictures/FBD/Elbow payload capacity.png
