DAwesomEL/BachelorProsjekt/Pictures/FEM/EXTRANEW FEM/Convergence Study Sideways.png

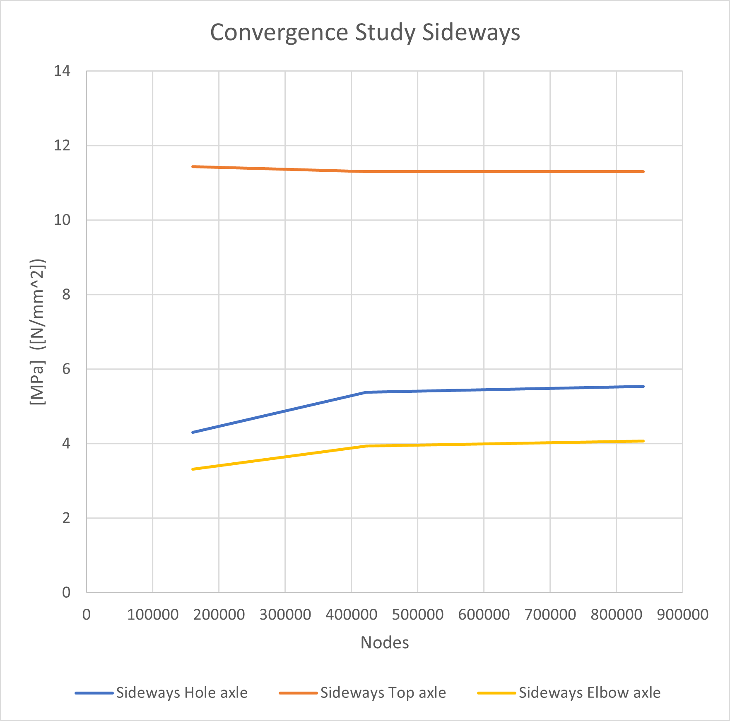
Pictures/FEM/EXTRANEW FEM/Convergence Study Sideways.png
