DAwesomEL/BachelorProsjekt/Pictures/FEM/EXTRANEW FEM/Convergence Study Upwards.png

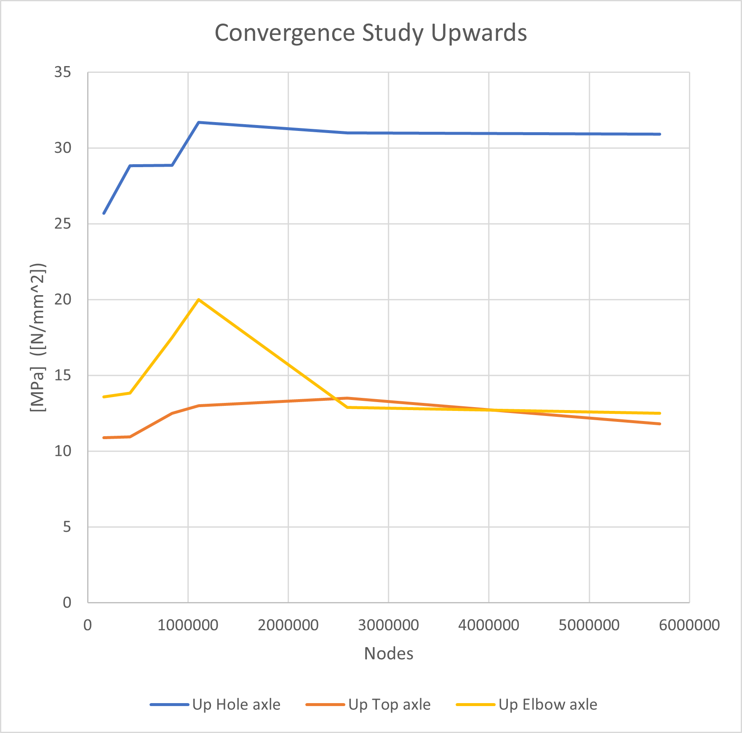
Pictures/FEM/EXTRANEW FEM/Convergence Study Upwards.png
