DAwesomEL/BachelorProsjekt/Pictures/FEM/EXTRANEW FEM/SidewaysDisplacement.PNG

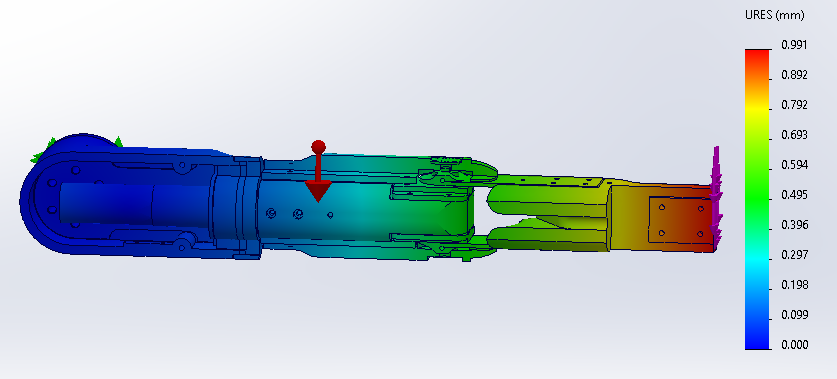
Pictures/FEM/EXTRANEW FEM/SidewaysDisplacement.PNG
