DAwesomEL/BachelorProsjekt/Pictures/FEM/EXTRANEW FEM/SidewaysProbe1.PNG

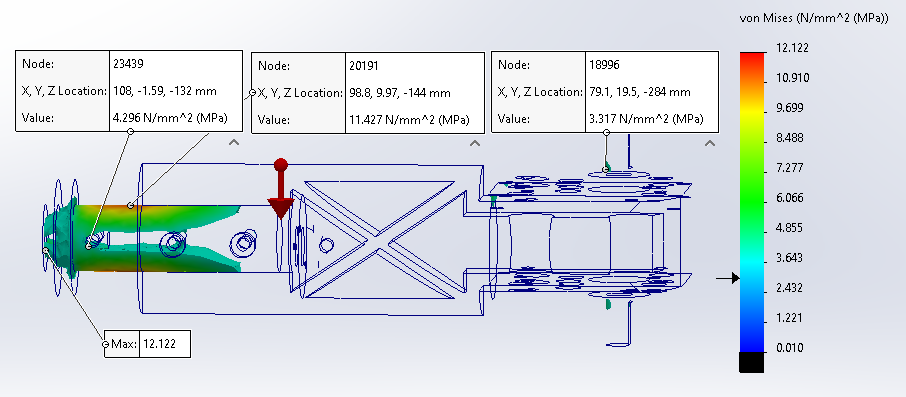
Pictures/FEM/EXTRANEW FEM/SidewaysProbe1.PNG
