DAwesomEL/BachelorProsjekt/Pictures/FEM/EXTRANEW FEM/SidewaysProbe2.PNG

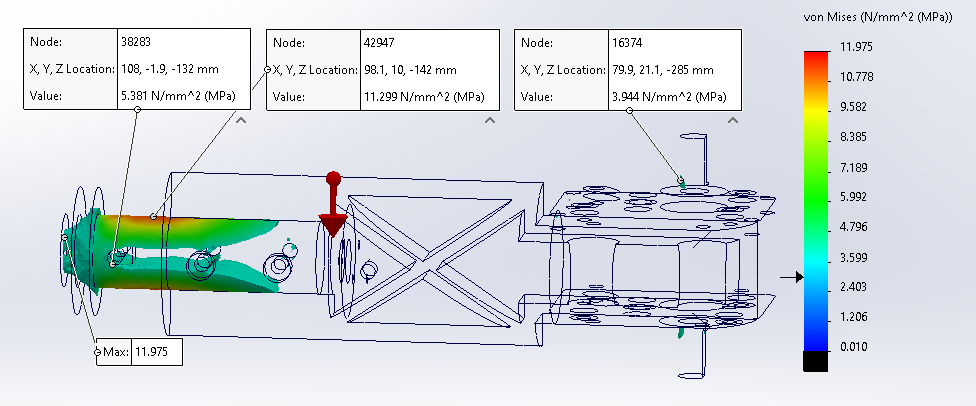
Pictures/FEM/EXTRANEW FEM/SidewaysProbe2.PNG
