DAwesomEL/BachelorProsjekt/Pictures/FEM/EXTRANEW FEM/SidewaysProbe3.PNG

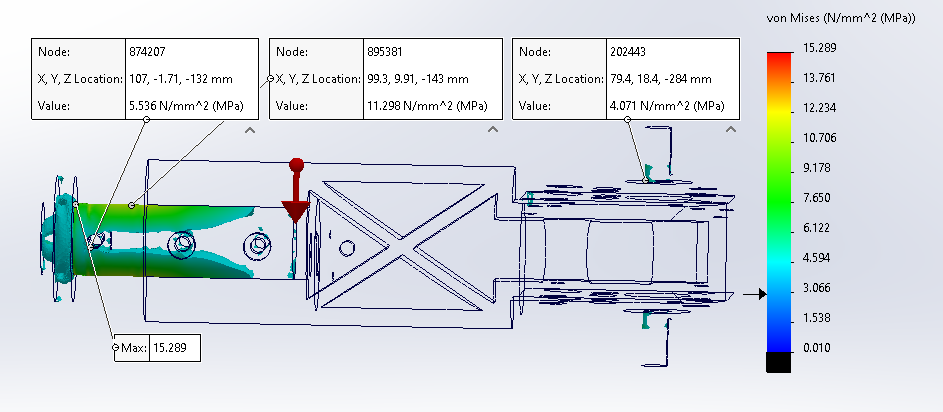
Pictures/FEM/EXTRANEW FEM/SidewaysProbe3.PNG
