DAwesomEL/BachelorProsjekt/Pictures/FEM/EXTRANEW FEM/Strain6.PNG

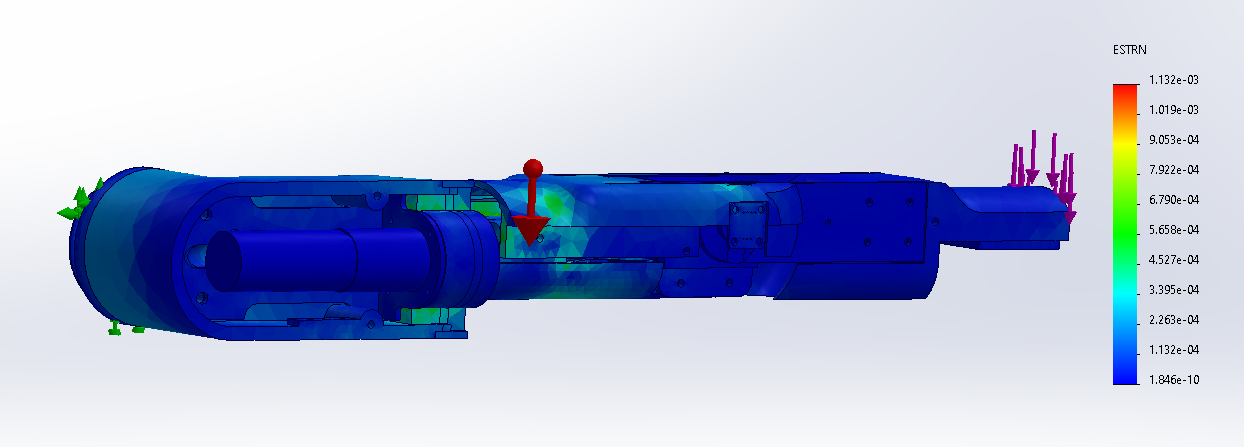
Pictures/FEM/EXTRANEW FEM/Strain6.PNG
