DAwesomEL/BachelorProsjekt/Pictures/FEM/EXTRANEW FEM/UpAllparts6.PNG

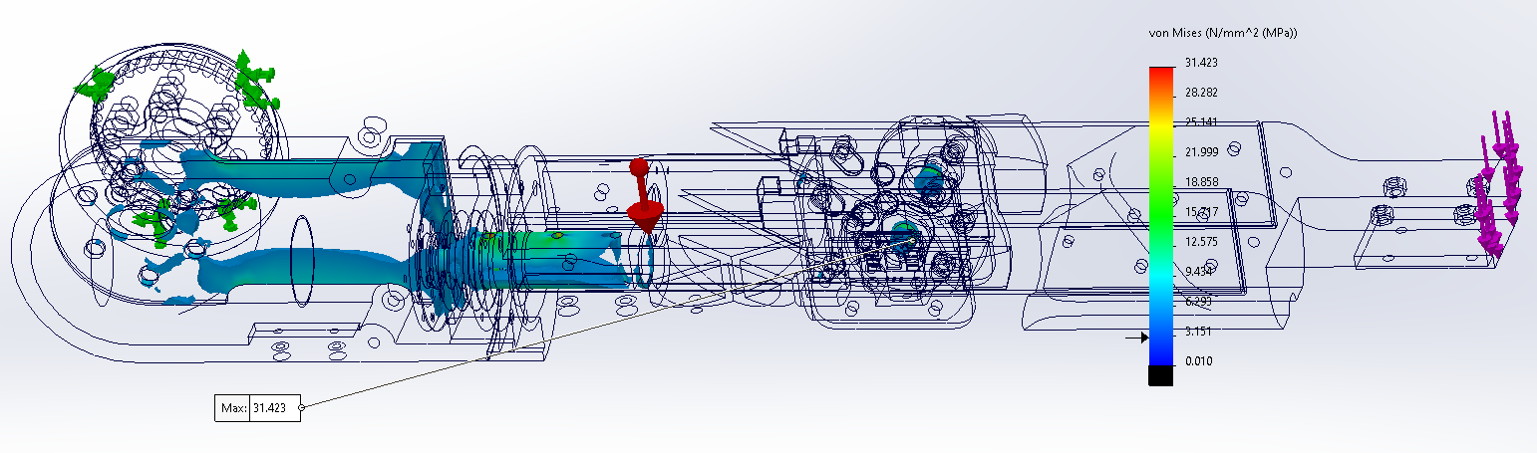
Pictures/FEM/EXTRANEW FEM/UpAllparts6.PNG
