DAwesomEL/BachelorProsjekt/Pictures/FEM/EXTRANEW FEM/UpDisplacement6.PNG

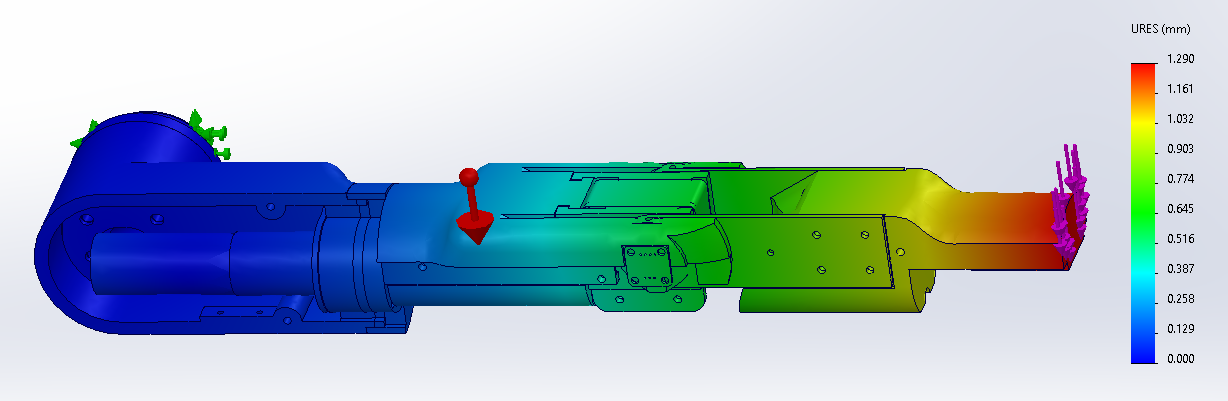
Pictures/FEM/EXTRANEW FEM/UpDisplacement6.PNG
