DAwesomEL/BachelorProsjekt/Pictures/FEM/EXTRANEW FEM/UpDisplacement.PNG

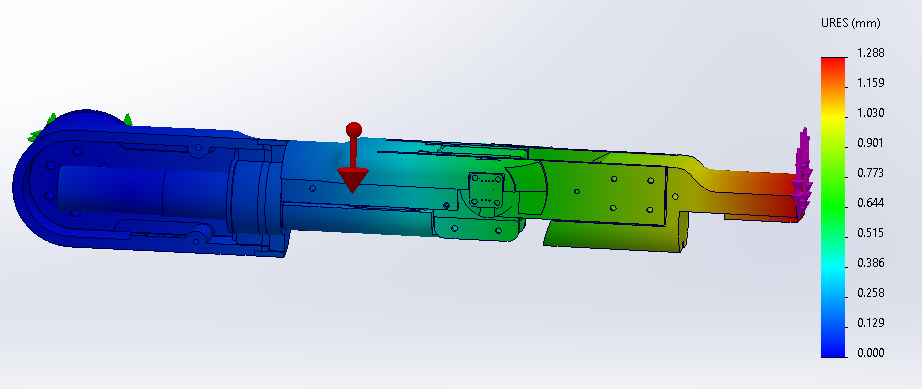
Pictures/FEM/EXTRANEW FEM/UpDisplacement.PNG
