DAwesomEL/BachelorProsjekt/Pictures/FEM/EXTRANEW FEM/UpMesh1.PNG

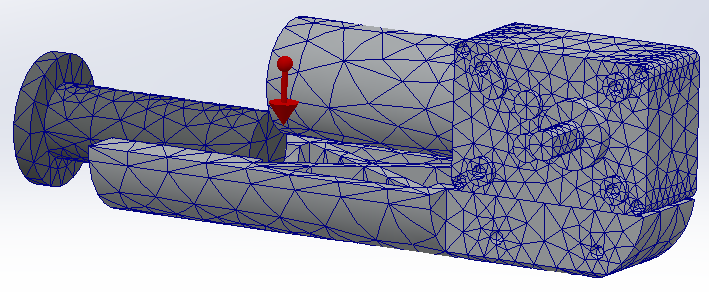
Pictures/FEM/EXTRANEW FEM/UpMesh1.PNG
