DAwesomEL/BachelorProsjekt/Pictures/FEM/EXTRANEW FEM/UpMesh2.PNG

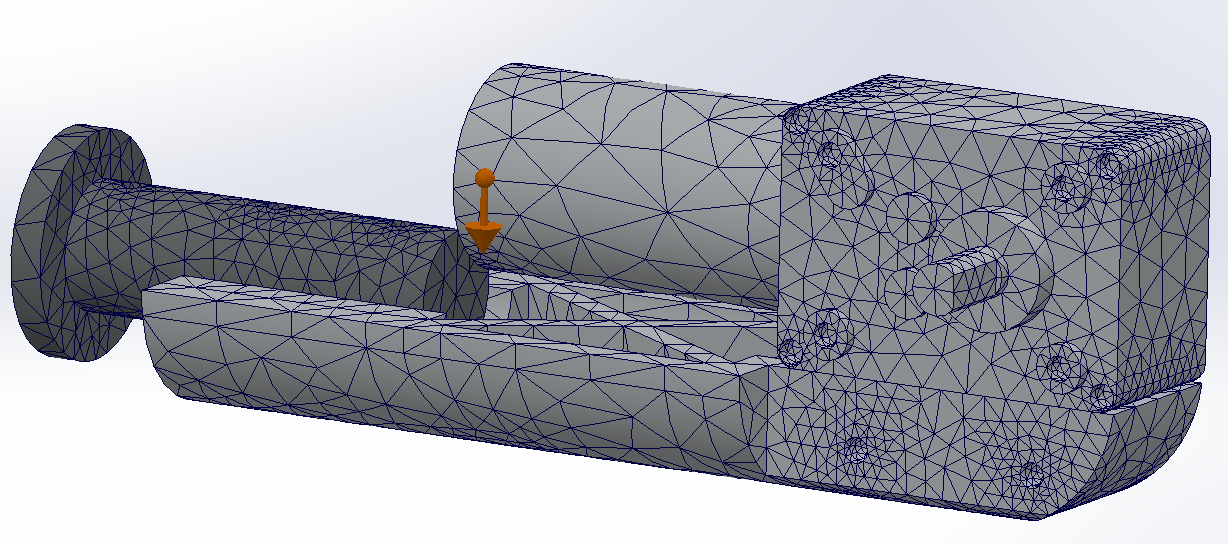
Pictures/FEM/EXTRANEW FEM/UpMesh2.PNG
