DAwesomEL/BachelorProsjekt/Pictures/FEM/EXTRANEW FEM/UpMesh3.PNG

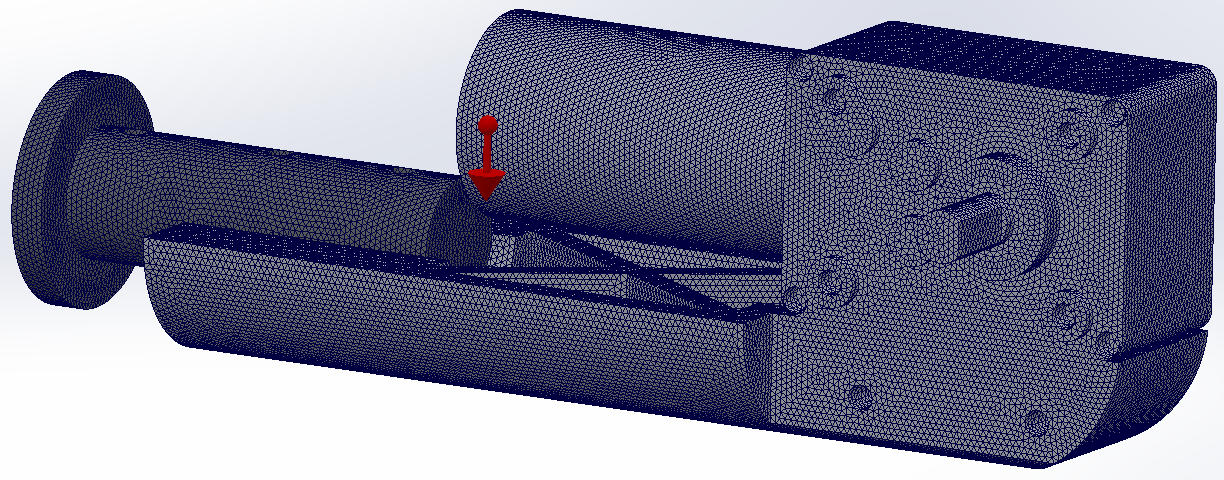
Pictures/FEM/EXTRANEW FEM/UpMesh3.PNG
