DAwesomEL/BachelorProsjekt/Pictures/FEM/EXTRANEW FEM/UpMesh4.PNG

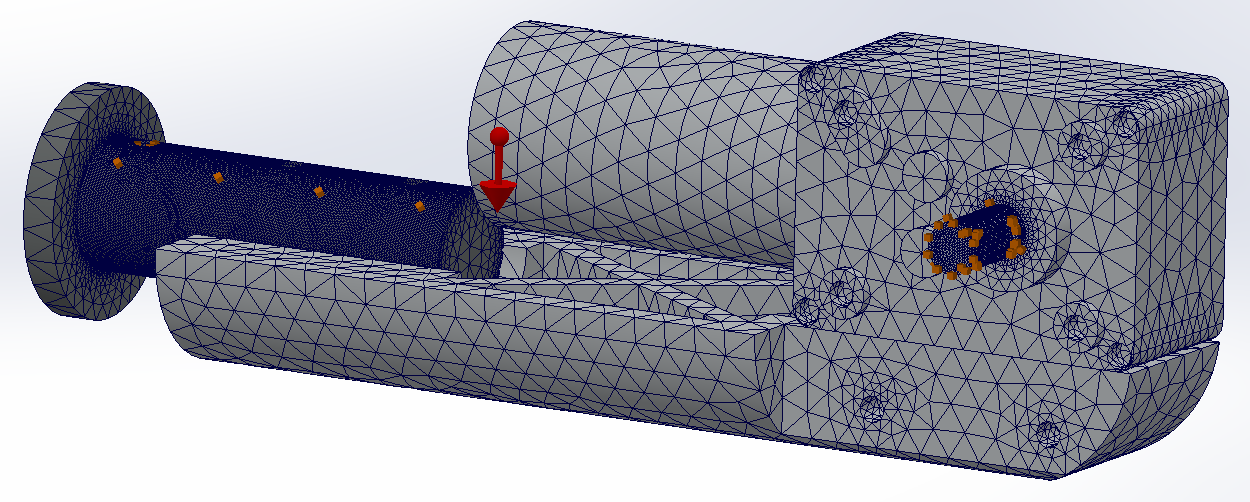
Pictures/FEM/EXTRANEW FEM/UpMesh4.PNG
