DAwesomEL/BachelorProsjekt/Pictures/FEM/EXTRANEW FEM/UpMesh5.PNG

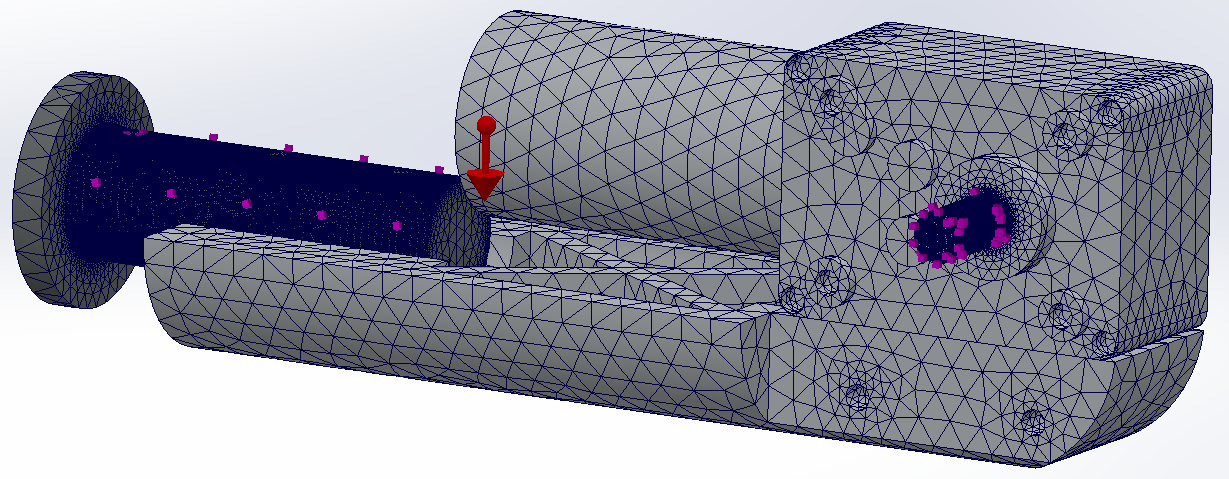
Pictures/FEM/EXTRANEW FEM/UpMesh5.PNG
