DAwesomEL/BachelorProsjekt/Pictures/FEM/EXTRANEW FEM/UpProbe1.PNG

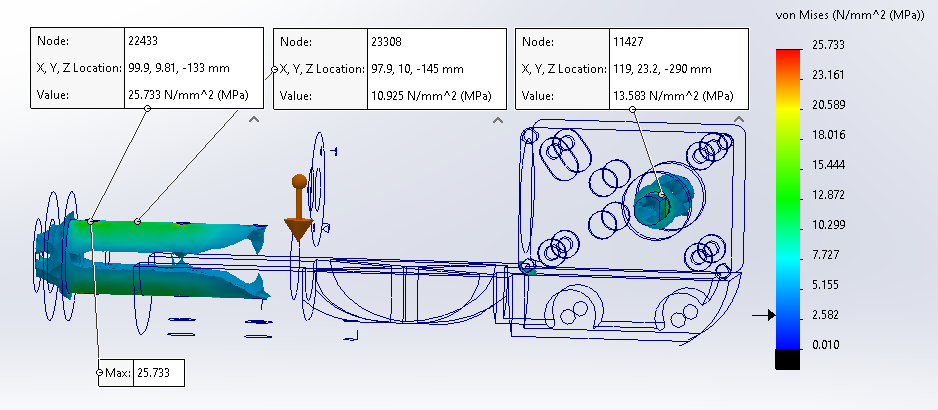
Pictures/FEM/EXTRANEW FEM/UpProbe1.PNG
