DAwesomEL/BachelorProsjekt/Pictures/FEM/EXTRANEW FEM/UpProbe2.PNG

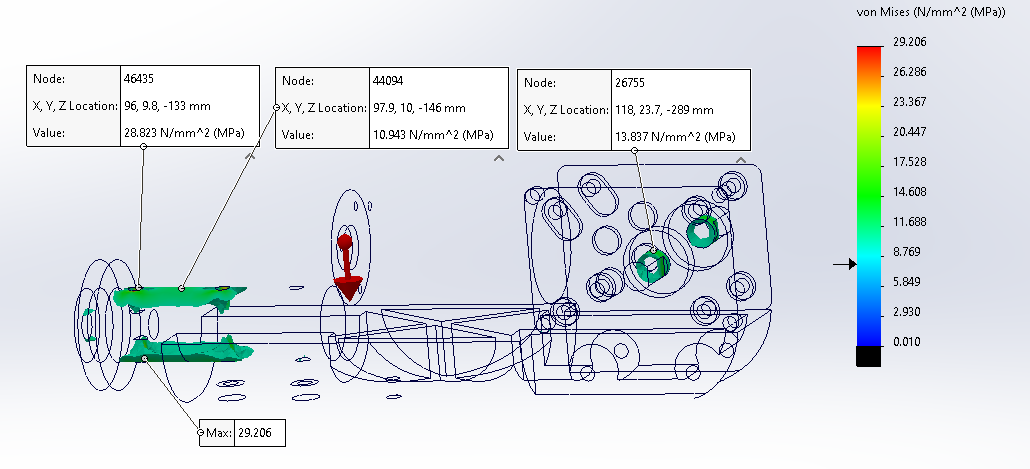
Pictures/FEM/EXTRANEW FEM/UpProbe2.PNG
