DAwesomEL/BachelorProsjekt/Pictures/FEM/EXTRANEW FEM/UpProbe3.PNG

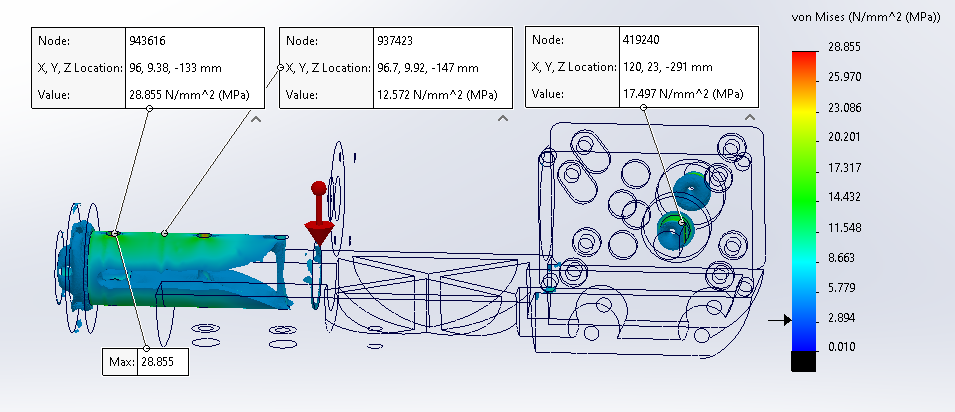
Pictures/FEM/EXTRANEW FEM/UpProbe3.PNG
