DAwesomEL/BachelorProsjekt/Pictures/FEM/EXTRANEW FEM/UpProbe4.PNG

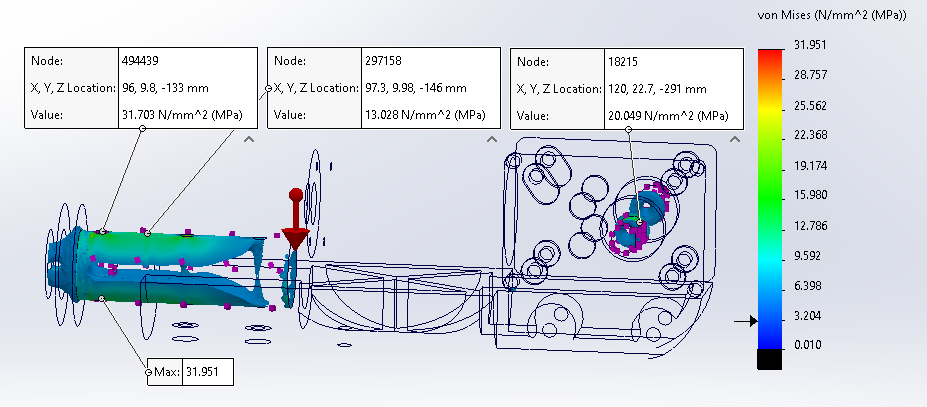
Pictures/FEM/EXTRANEW FEM/UpProbe4.PNG
