DAwesomEL/BachelorProsjekt/Pictures/FEM/EXTRANEW FEM/UpProbe5.PNG

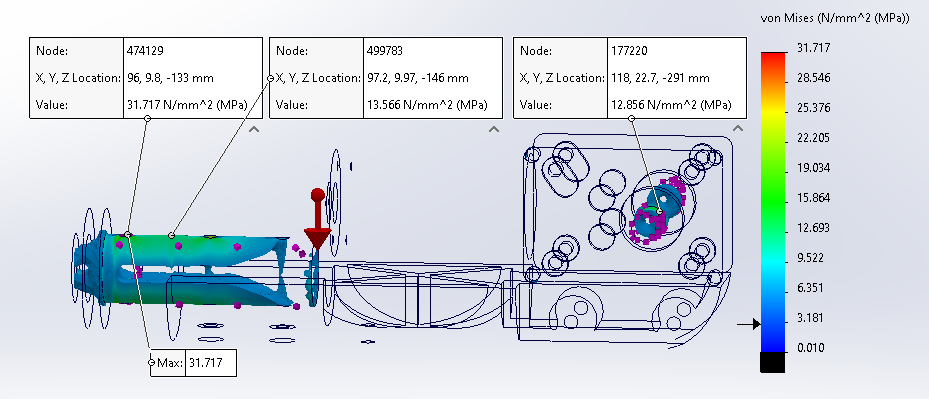
Pictures/FEM/EXTRANEW FEM/UpProbe5.PNG
