DAwesomEL/BachelorProsjekt/Pictures/FEM/EXTRANEW FEM/UpProbe6.PNG

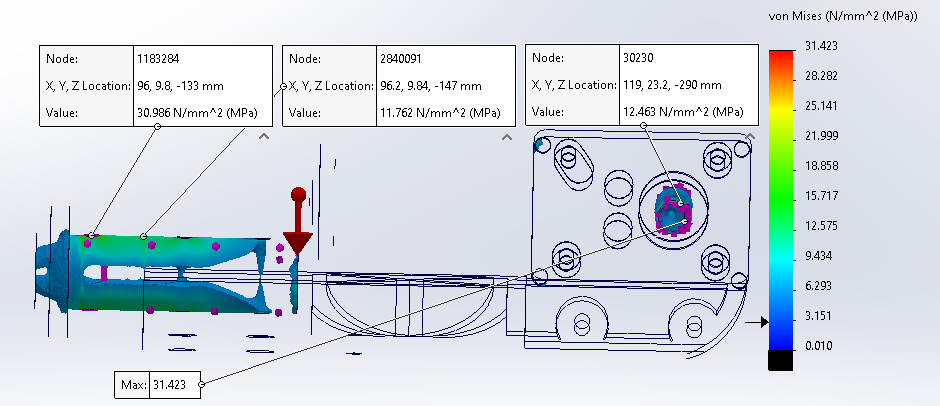
Pictures/FEM/EXTRANEW FEM/UpProbe6.PNG
