DAwesomEL/BachelorProsjekt/Pictures/FEM/New FEM/axle.PNG

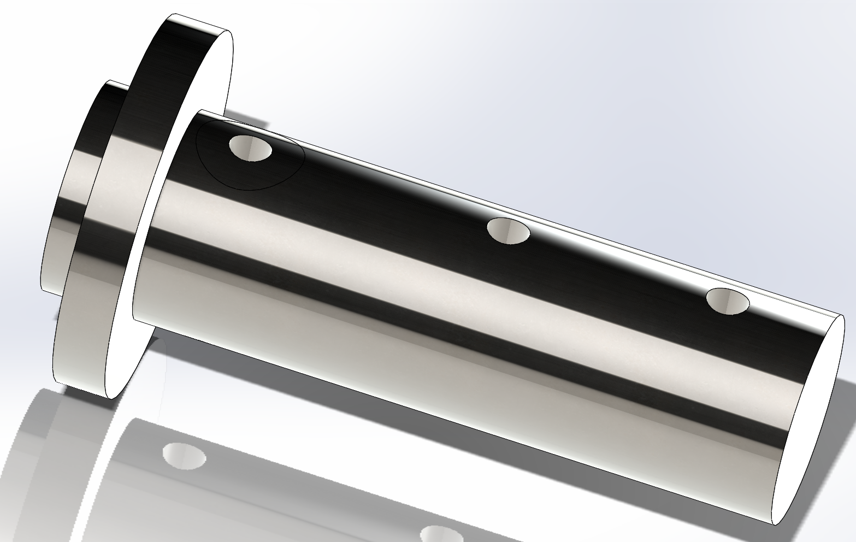
Pictures/FEM/New FEM/axle.PNG
