DAwesomEL/BachelorProsjekt/Pictures/FEM/New FEM/External Load.PNG

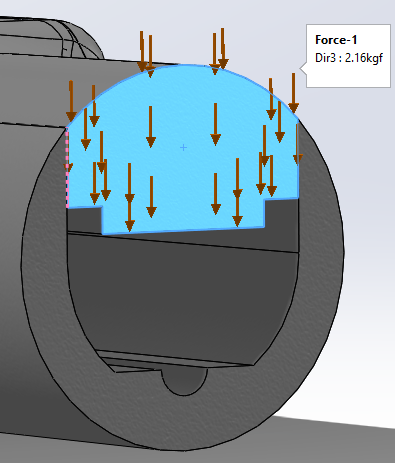
Pictures/FEM/New FEM/External Load.PNG
