DAwesomEL/BachelorProsjekt/Pictures/FEM/New FEM/Fixture.PNG

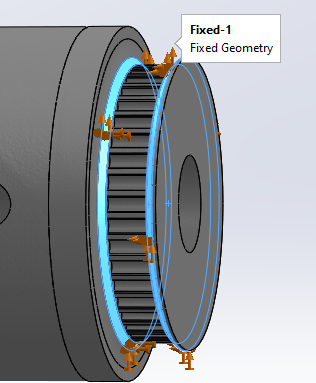
Pictures/FEM/New FEM/Fixture.PNG
