DAwesomEL/BachelorProsjekt/Pictures/FEM/New FEM/Gravity.PNG

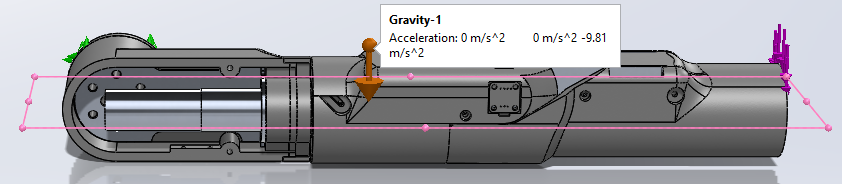
Pictures/FEM/New FEM/Gravity.PNG
