DAwesomEL/BachelorProsjekt/Pictures/FEM/New FEM/Sideways Coarse Mesh.PNG

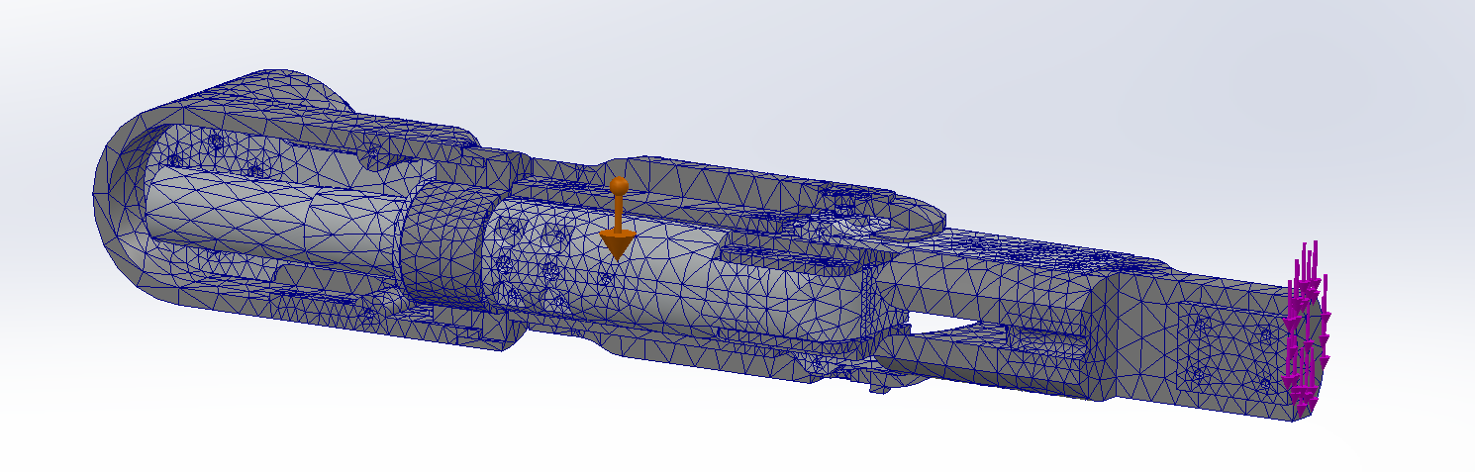
Pictures/FEM/New FEM/Sideways Coarse Mesh.PNG
