DAwesomEL/BachelorProsjekt/Pictures/FEM/New FEM/Sideways Displacement.PNG

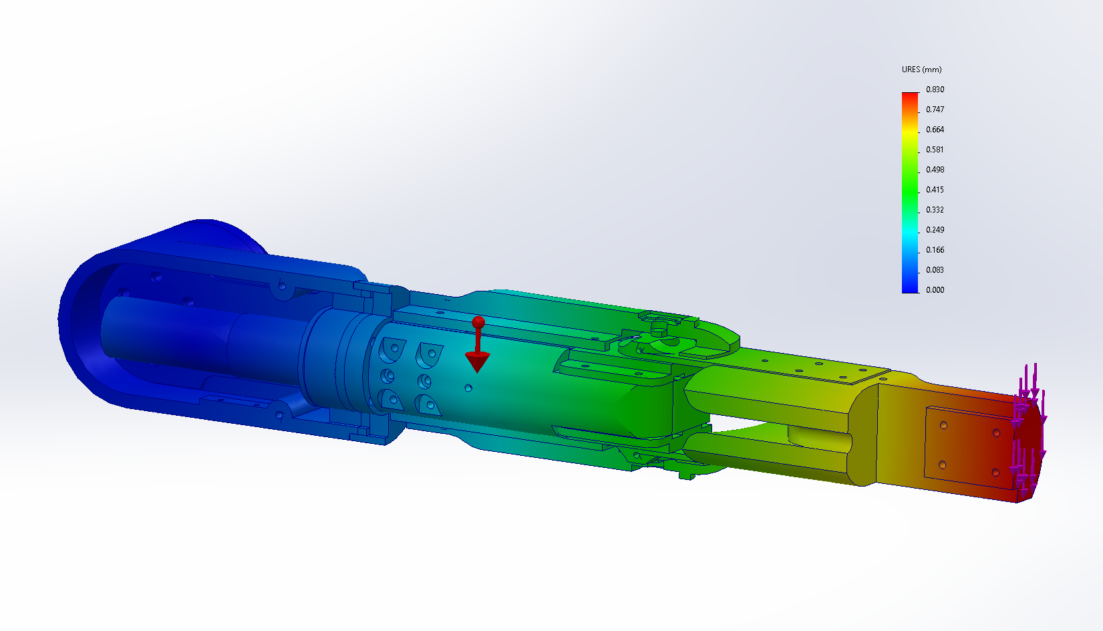
Pictures/FEM/New FEM/Sideways Displacement.PNG
