DAwesomEL/BachelorProsjekt/Pictures/FEM/New FEM/Sideways Stress ISO Clipping.PNG

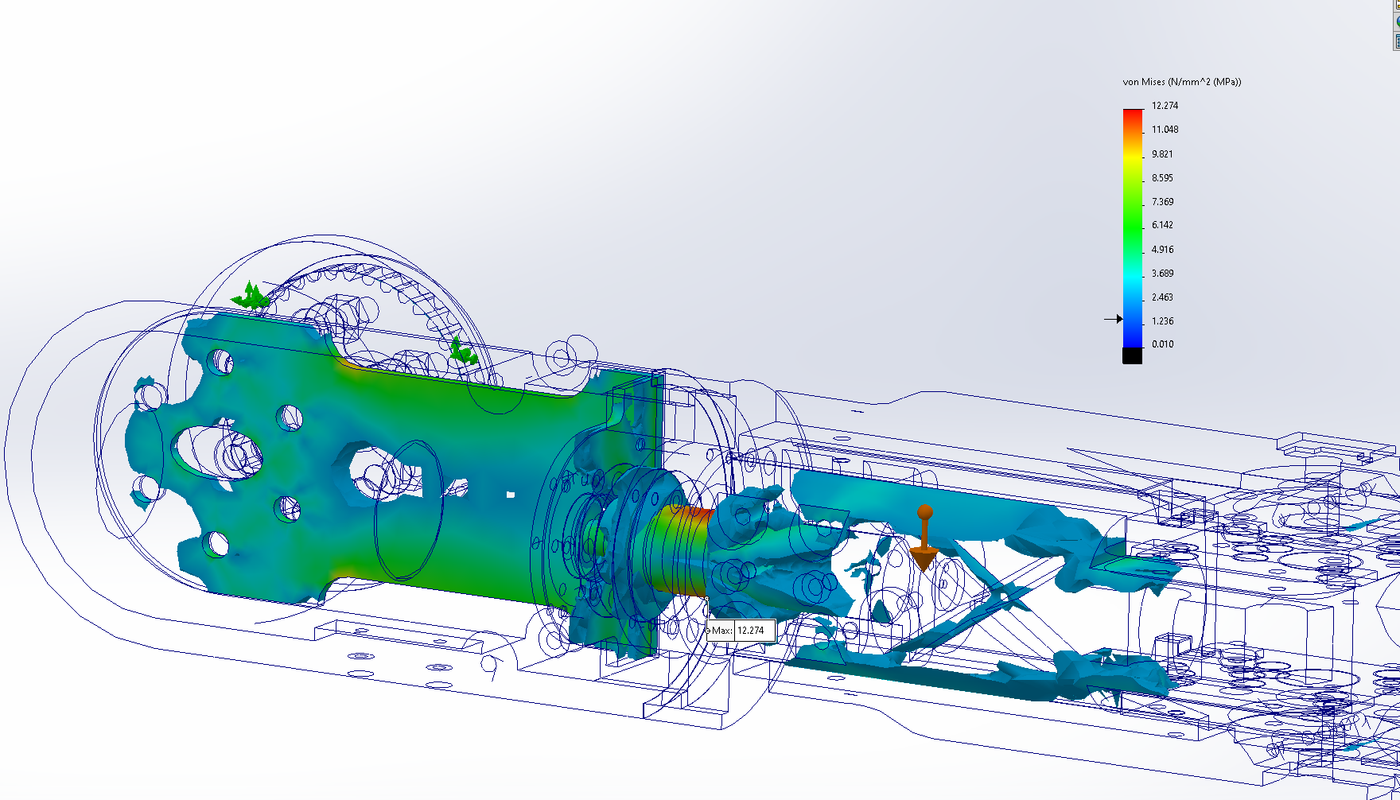
Pictures/FEM/New FEM/Sideways Stress ISO Clipping.PNG
