DAwesomEL/BachelorProsjekt/Pictures/FEM/New FEM/Sideways Upper arm axle.PNG

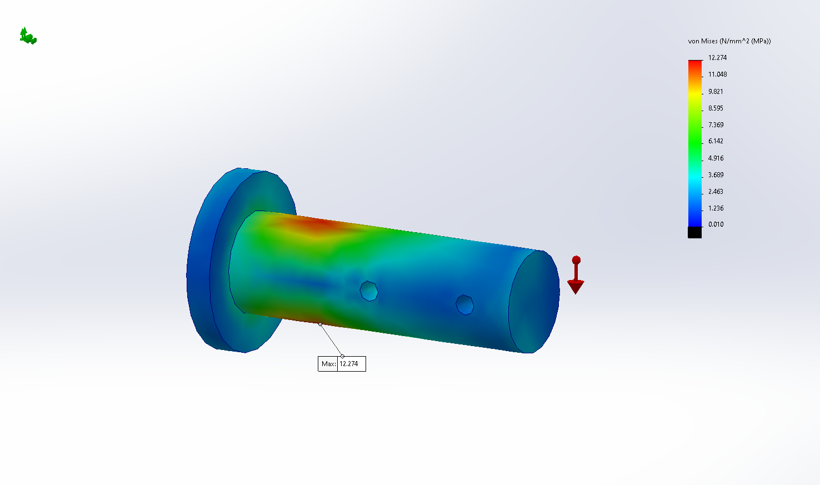
Pictures/FEM/New FEM/Sideways Upper arm axle.PNG
