DAwesomEL/BachelorProsjekt/Pictures/FEM/New FEM/System Manipulator.PNG

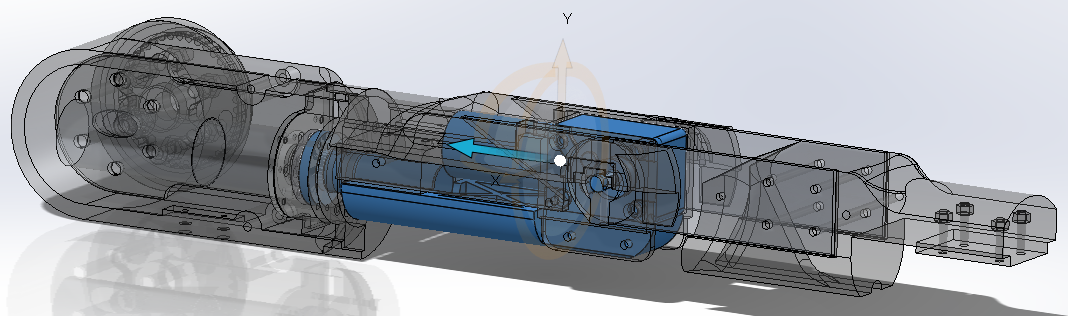
Pictures/FEM/New FEM/System Manipulator.PNG
