DAwesomEL/BachelorProsjekt/Pictures/FEM/New FEM/Up Coarse Mesh.PNG

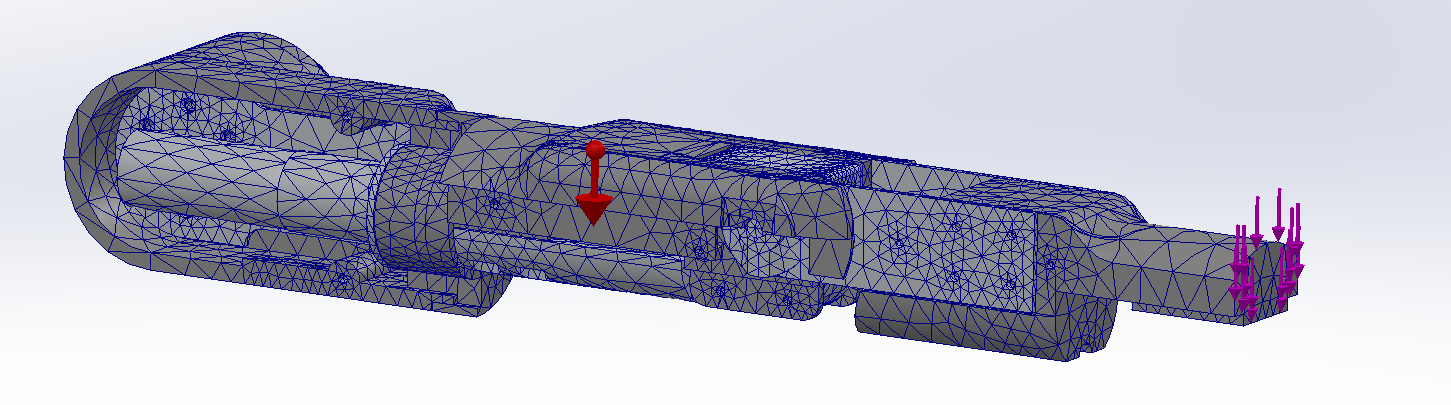
Pictures/FEM/New FEM/Up Coarse Mesh.PNG
