DAwesomEL/BachelorProsjekt/Pictures/FEM/New FEM/Up Displacement.PNG

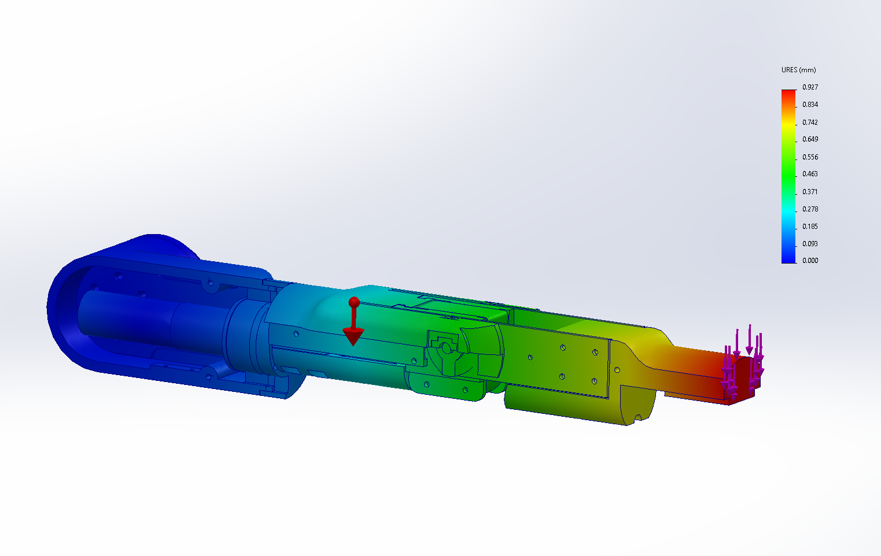
Pictures/FEM/New FEM/Up Displacement.PNG
