DAwesomEL/BachelorProsjekt/Pictures/FEM/New FEM/Upper arm axle finer mesh 1 stress.PNG

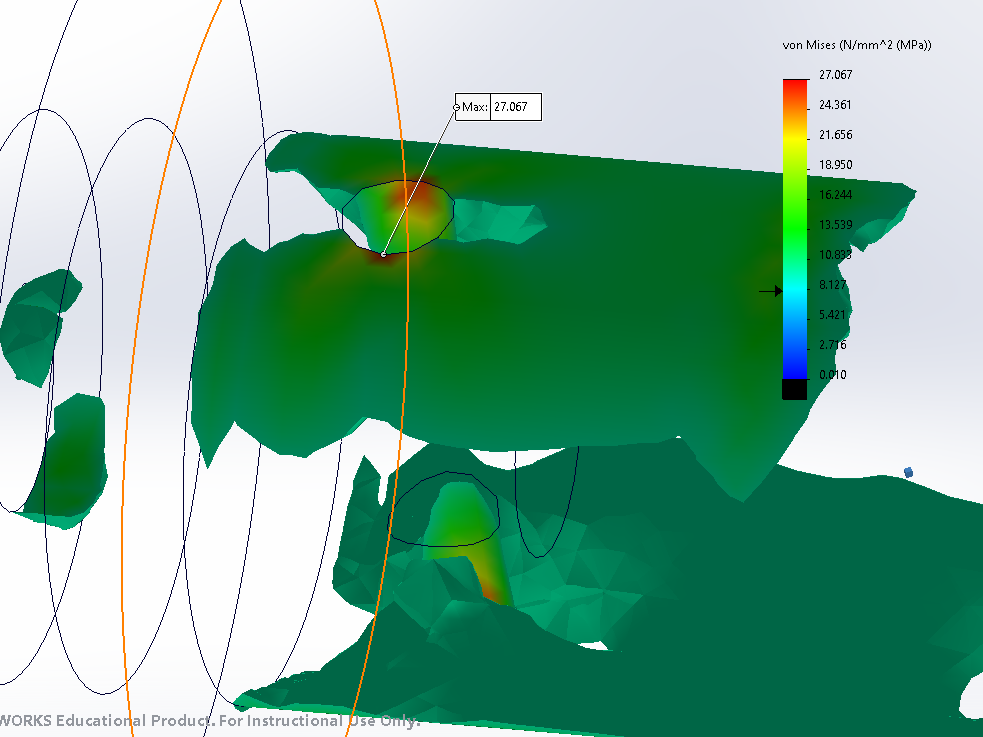
Pictures/FEM/New FEM/Upper arm axle finer mesh 1 stress.PNG
