DAwesomEL/BachelorProsjekt/Pictures/FEM/New FEM/Upper arm axle finer mesh 2.PNG

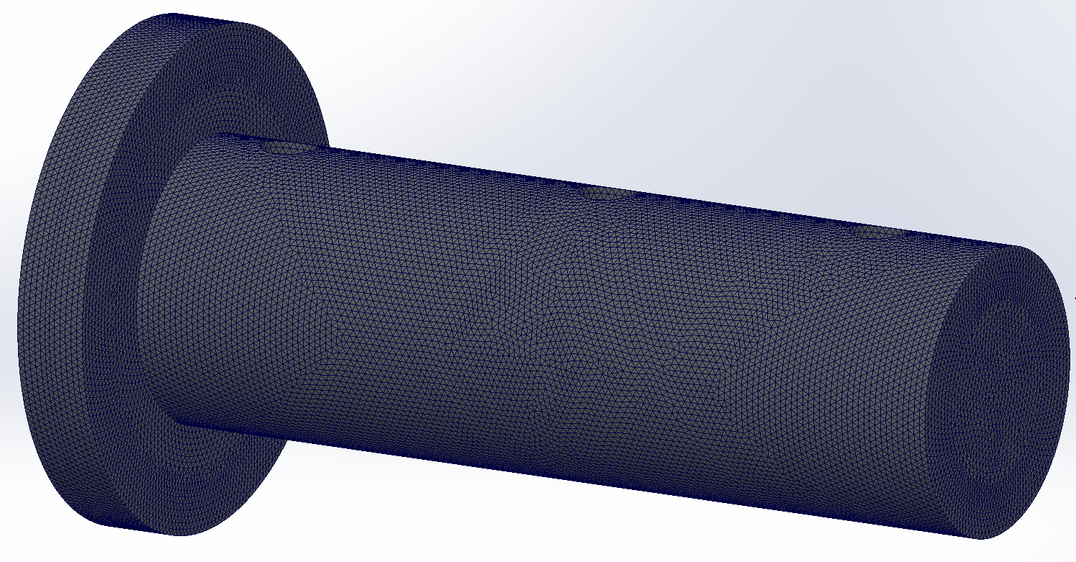
Pictures/FEM/New FEM/Upper arm axle finer mesh 2.PNG
