DAwesomEL/BachelorProsjekt/Pictures/FEM/New FEM/Upper arm axle finer mesh 3 detail.PNG

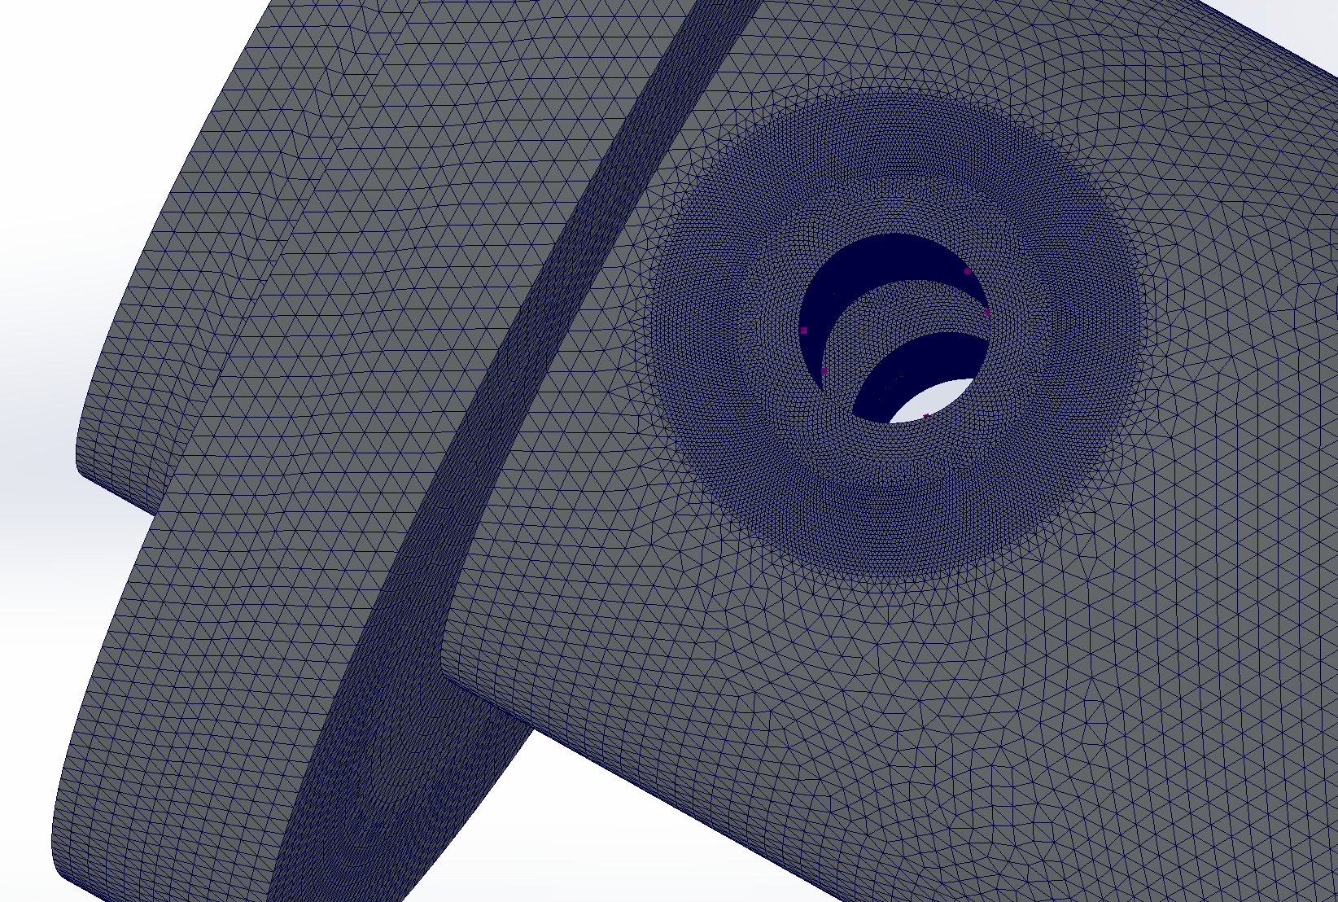
Pictures/FEM/New FEM/Upper arm axle finer mesh 3 detail.PNG
