DAwesomEL/BachelorProsjekt/Pictures/FEM/New FEM/Upper arm axle finer mesh 3 stress detail.PNG

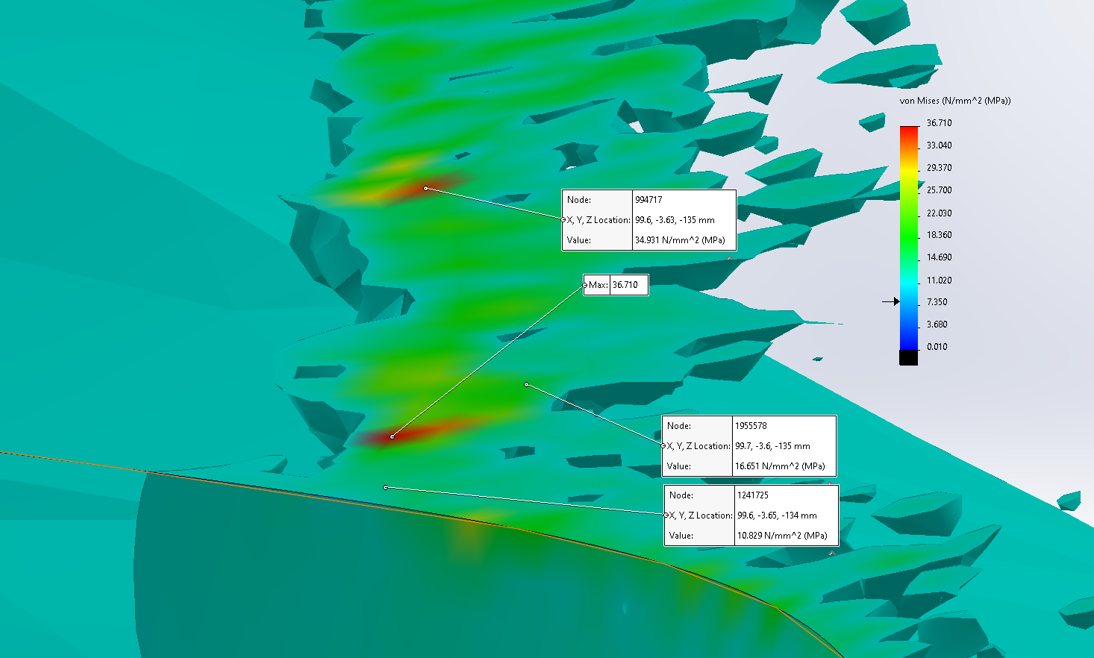
Pictures/FEM/New FEM/Upper arm axle finer mesh 3 stress detail.PNG
