DAwesomEL/BachelorProsjekt/Pictures/FEM/New FEM/Upper arm axle finer mesh 3.PNG

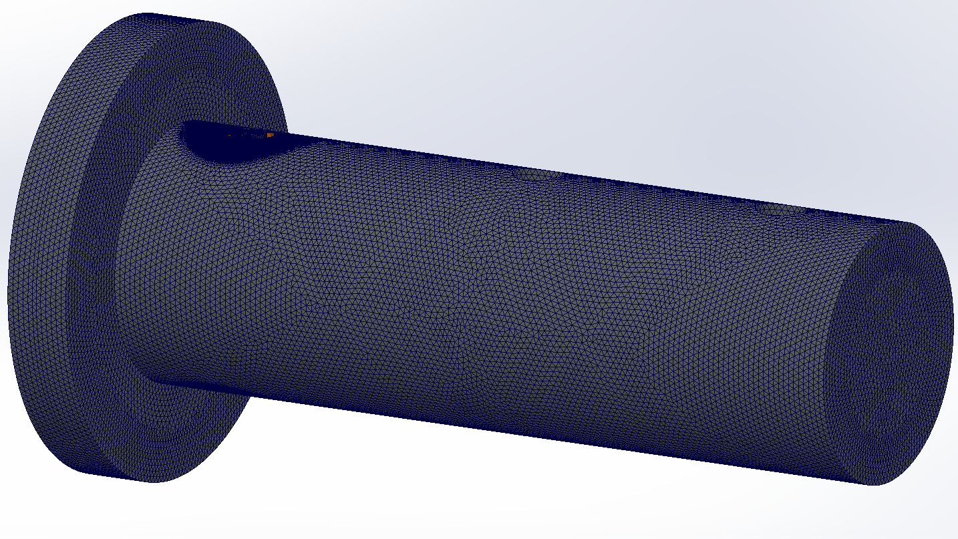
Pictures/FEM/New FEM/Upper arm axle finer mesh 3.PNG
