DAwesomEL/BachelorProsjekt/Pictures/Home Position.PNG

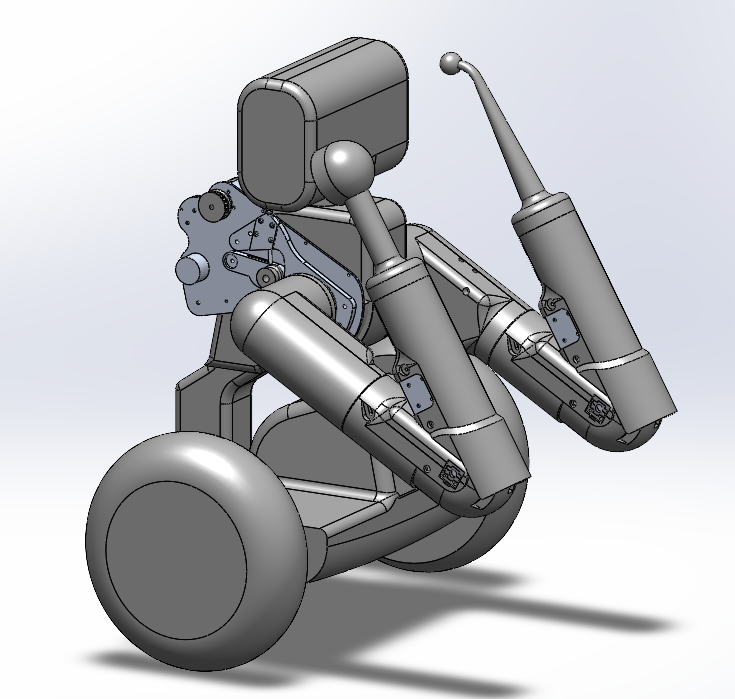
Pictures/Home Position.PNG
