DAwesomEL/BachelorProsjekt/Pictures/Klaring.jpg

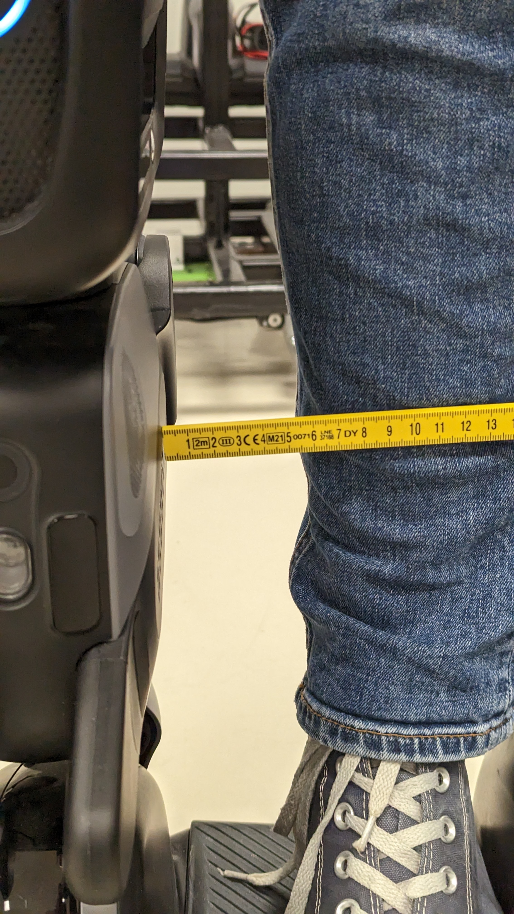
Pictures/Klaring.jpg
