DAwesomEL/BachelorProsjekt/Pictures/Kretstegning/Angular sensor 1.jpg

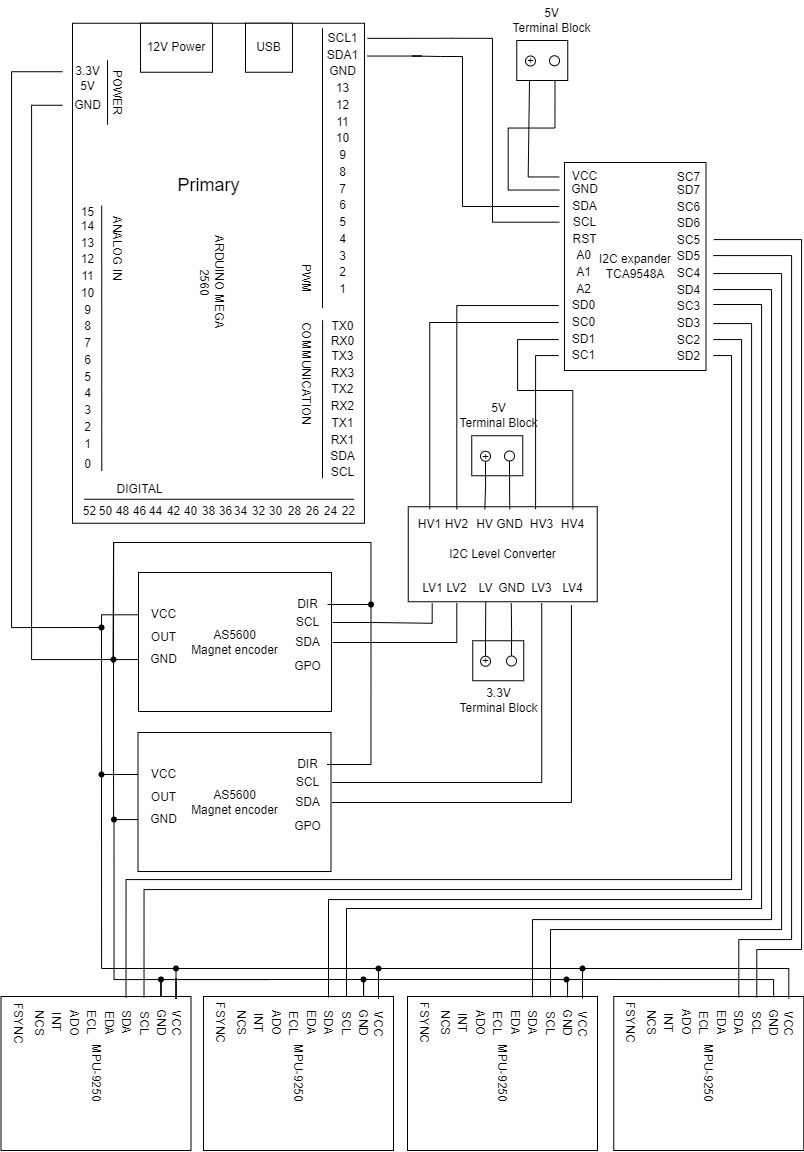
Pictures/Kretstegning/Angular sensor 1.jpg
