DAwesomEL/BachelorProsjekt/Pictures/Kretstegning/Motorkontroller 1.jpg

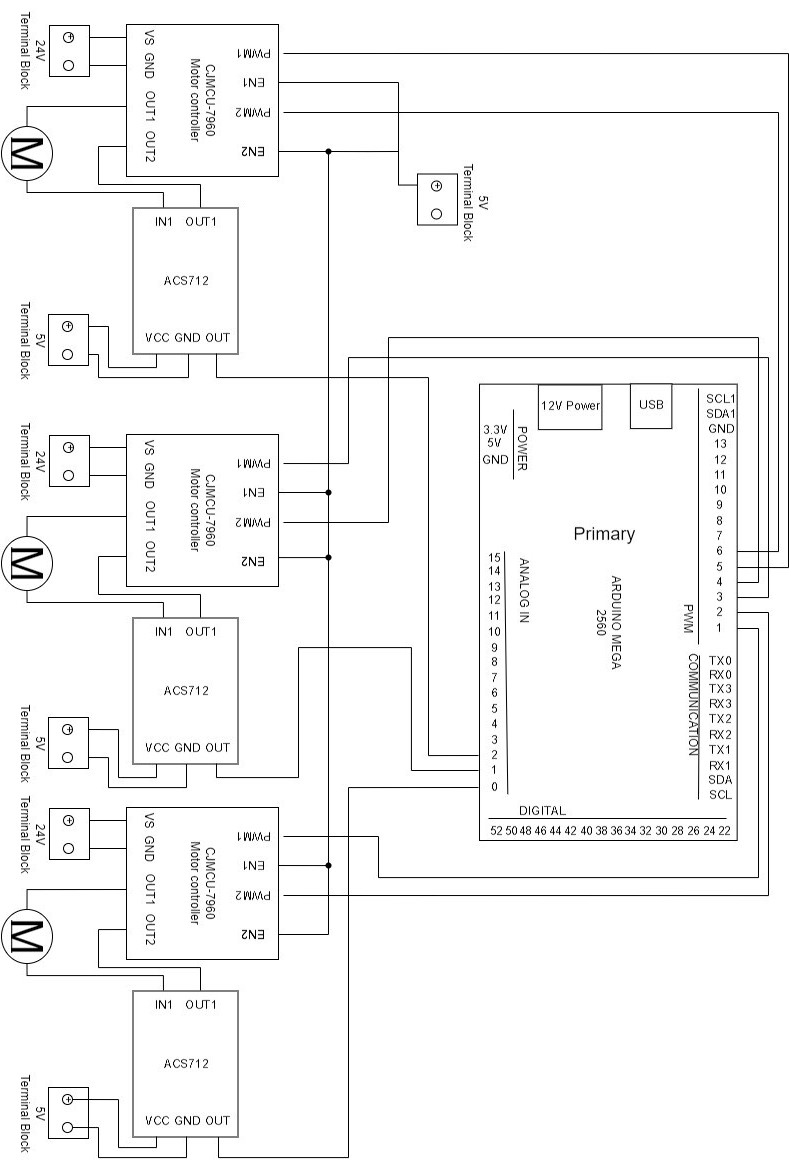
Pictures/Kretstegning/Motorkontroller 1.jpg
