DAwesomEL/BachelorProsjekt/Pictures/Kretstegning/MPU backback.jpg

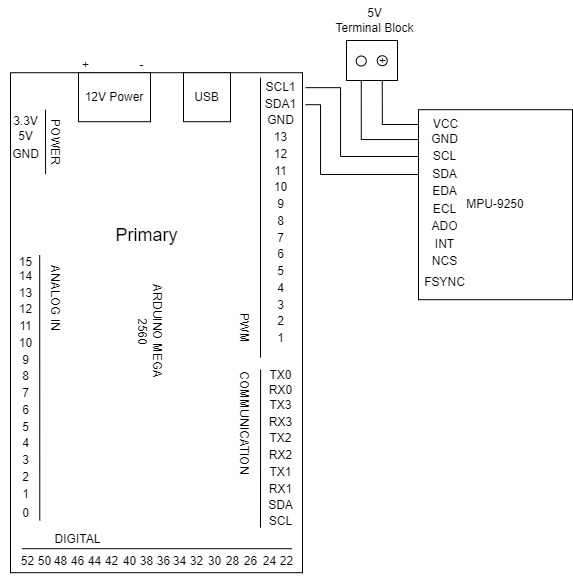
Pictures/Kretstegning/MPU backback.jpg
