DAwesomEL/BachelorProsjekt/Pictures/Kretstegning/Power supply.jpg

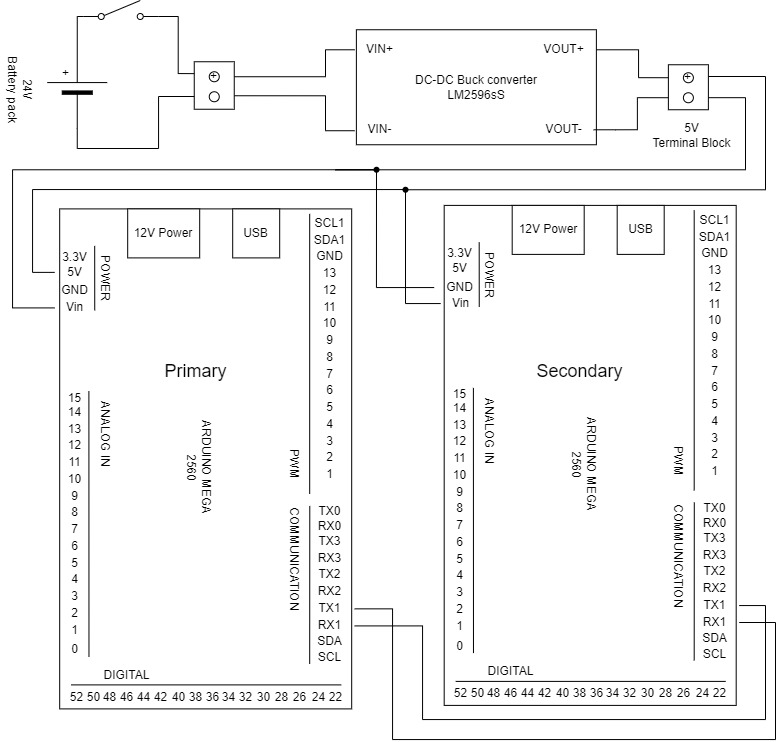
Pictures/Kretstegning/Power supply.jpg
