DAwesomEL/BachelorProsjekt/Pictures/Libraries in cpp.PNG

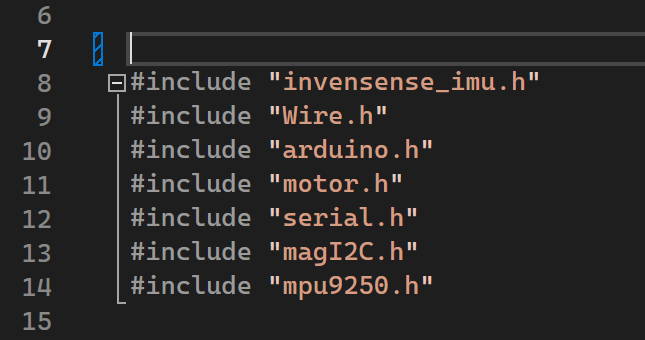
Pictures/Libraries in cpp.PNG
