DAwesomEL/BachelorProsjekt/Pictures/Loomo manipulator.jpg

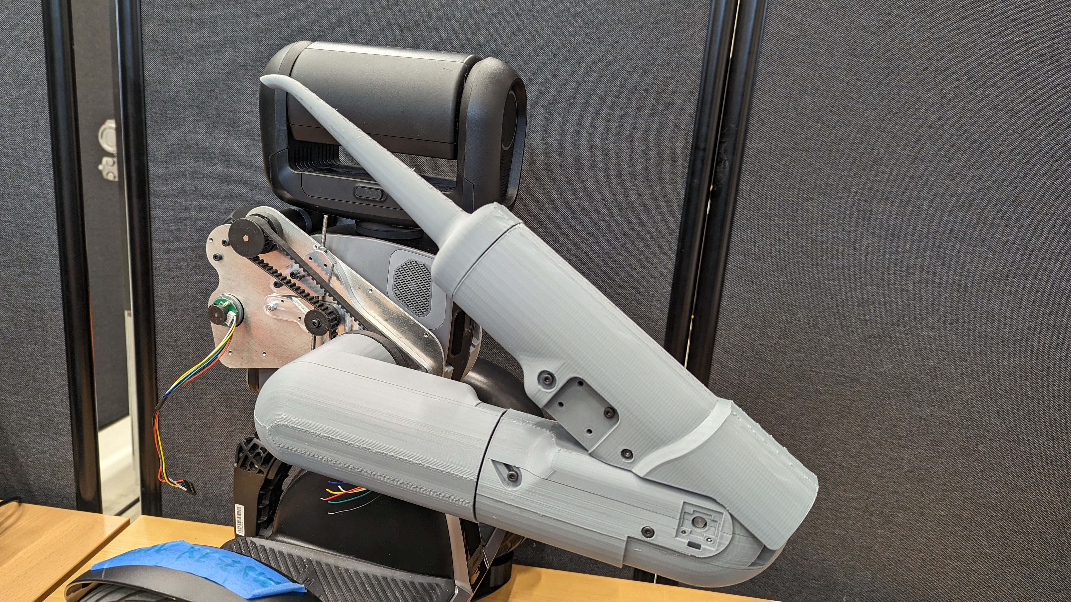
Pictures/Loomo manipulator.jpg
