DAwesomEL/BachelorProsjekt/Pictures/Loomo with person.PNG

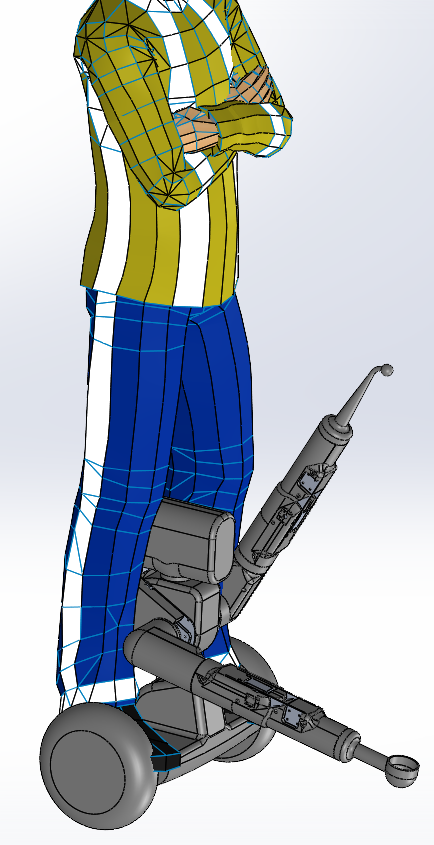
Pictures/Loomo with person.PNG
