DAwesomEL/BachelorProsjekt/Pictures/LoomoHumanLikeArms.PNG

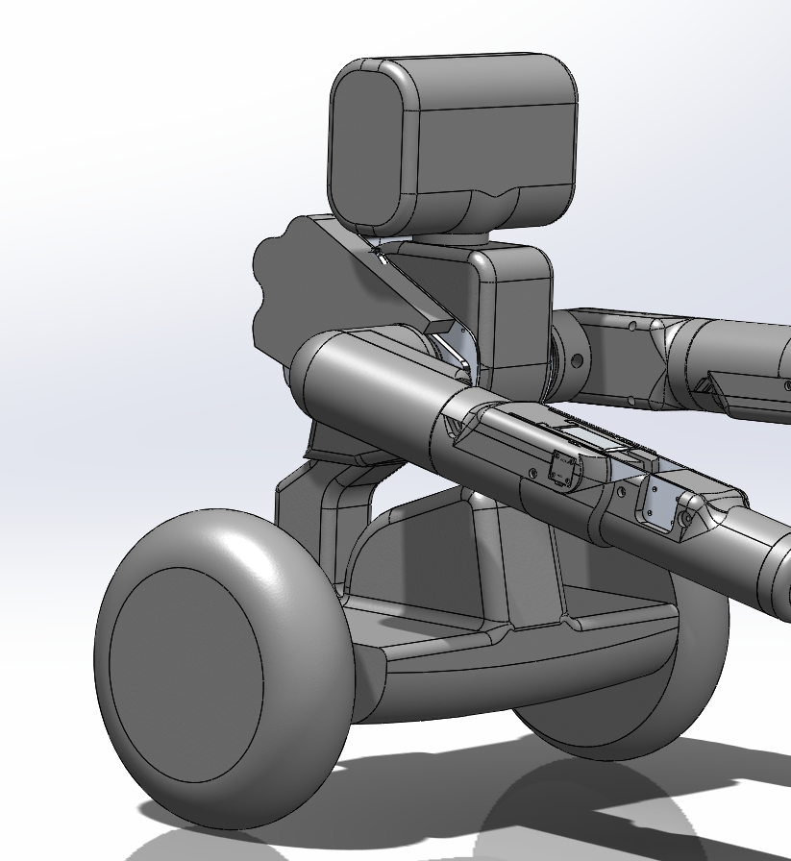
Pictures/LoomoHumanLikeArms.PNG
