DAwesomEL/BachelorProsjekt/Pictures/Markforge.png

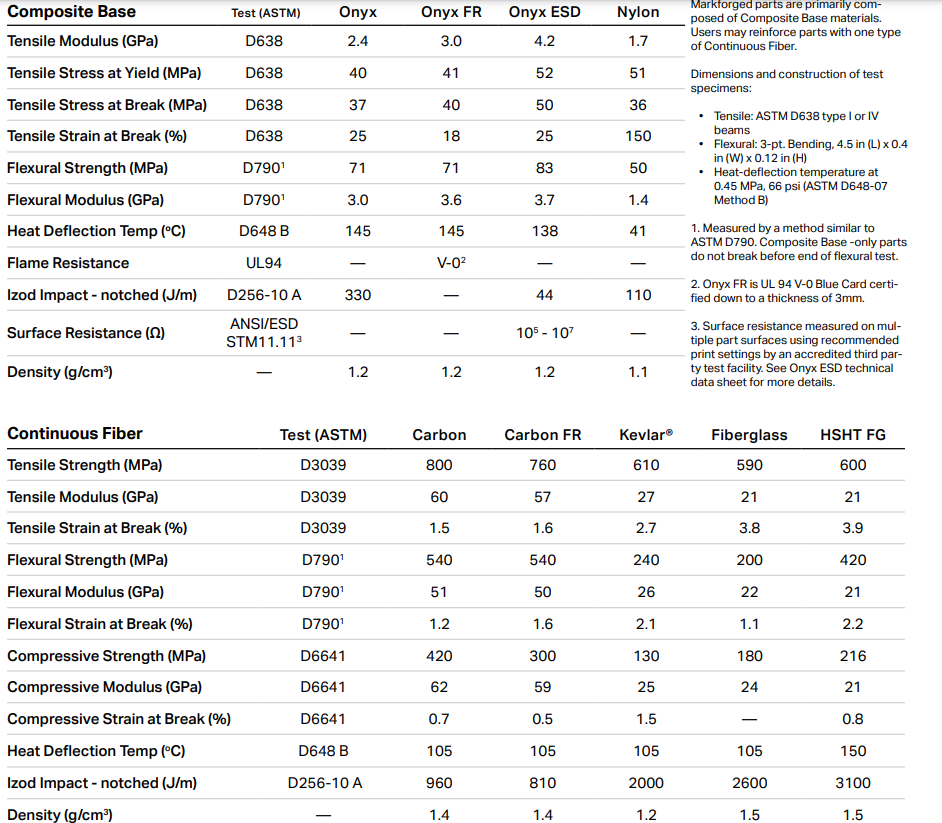
Pictures/Markforge.png
