DAwesomEL/BachelorProsjekt/Pictures/Modified axle.jpg

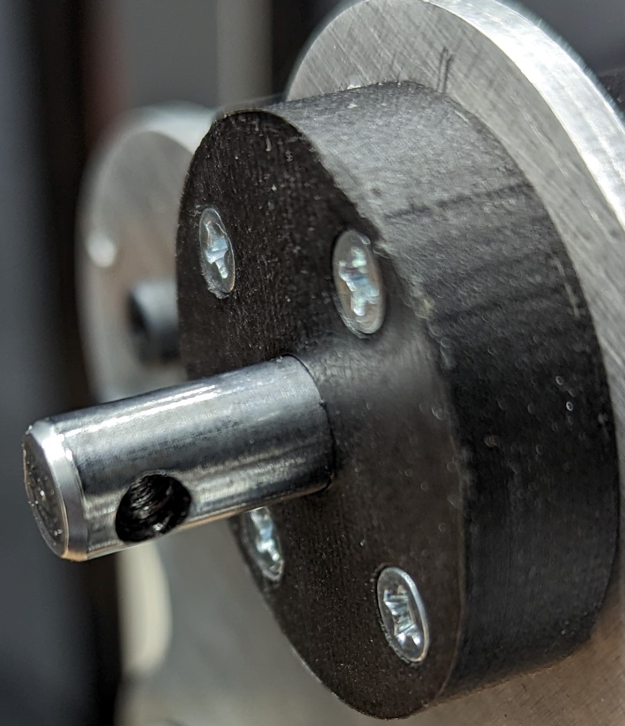
Pictures/Modified axle.jpg
