DAwesomEL/BachelorProsjekt/Pictures/Motor datablad/20mm planetgear.png

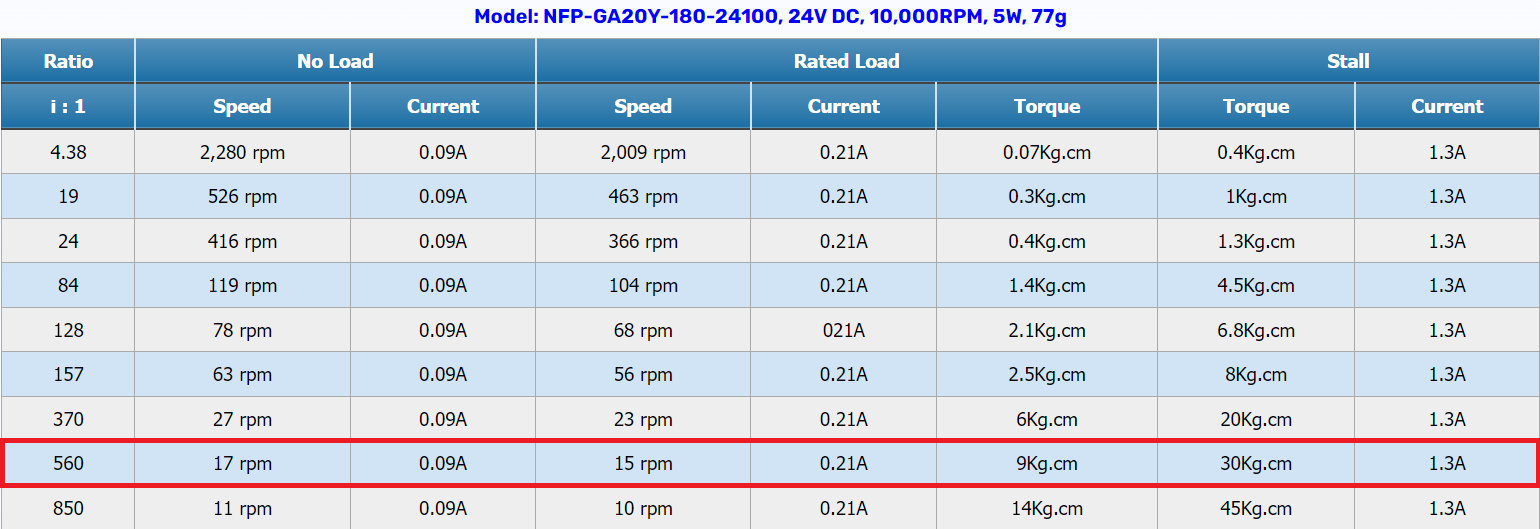
Pictures/Motor datablad/20mm planetgear.png
