DAwesomEL/BachelorProsjekt/Pictures/Motor datablad/31mm planetgear.png

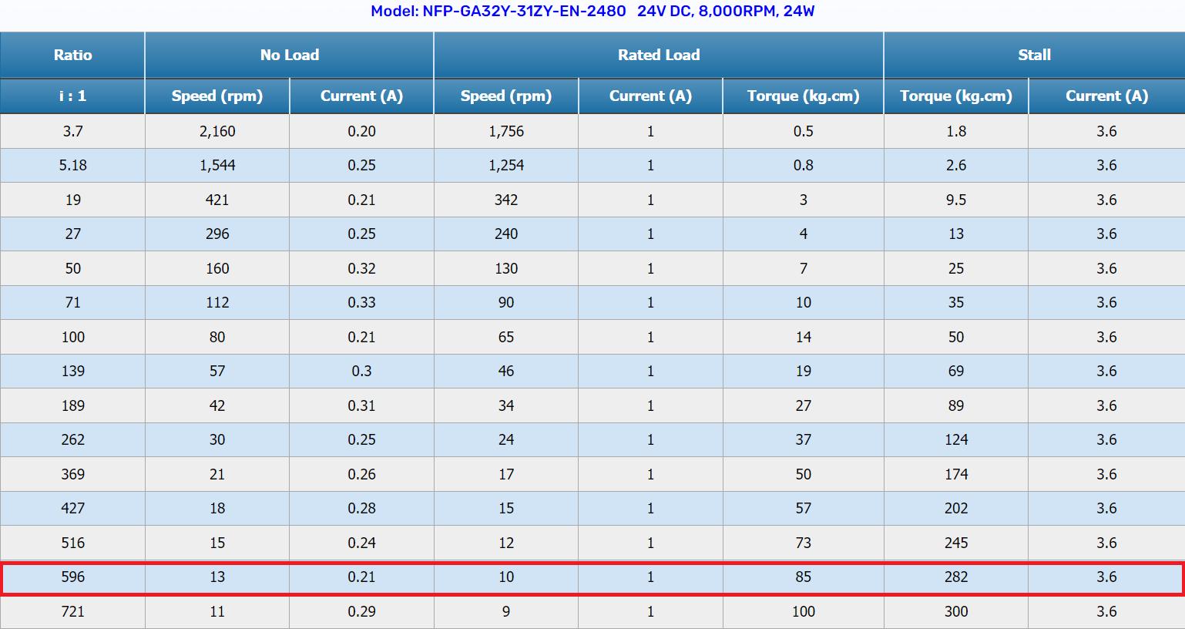
Pictures/Motor datablad/31mm planetgear.png
