DAwesomEL/BachelorProsjekt/Pictures/Motor datablad/Worm gear.png

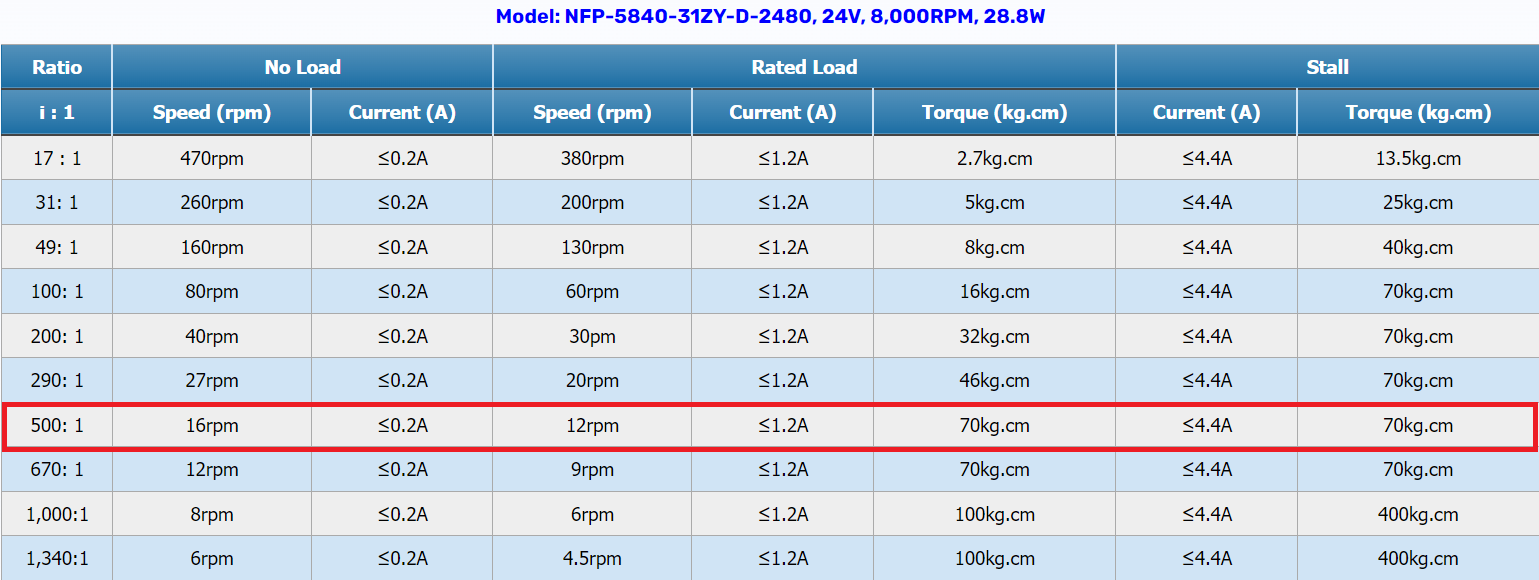
Pictures/Motor datablad/Worm gear.png
