DAwesomEL/BachelorProsjekt/Pictures/Robotics/Left Side Schematic.png

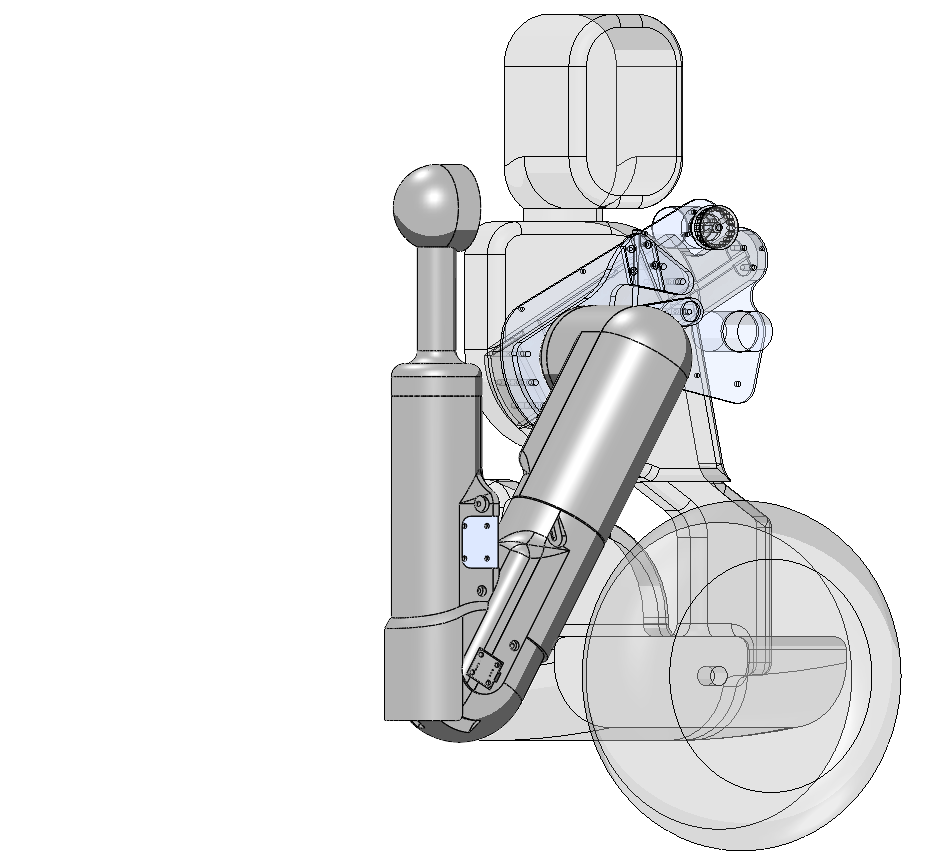
Pictures/Robotics/Left Side Schematic.png
