DAwesomEL/BachelorProsjekt/Pictures/Robotics/Right Side Schematic.PNG

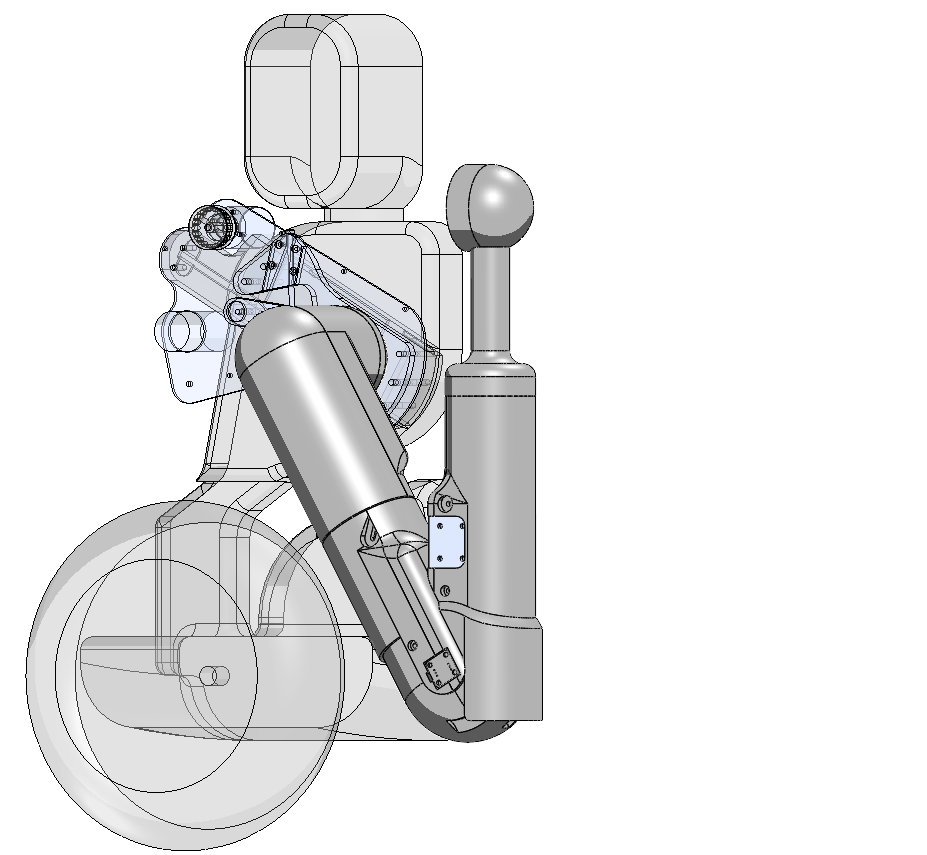
Pictures/Robotics/Right Side Schematic.PNG
