DAwesomEL/BachelorProsjekt/Pictures/Skulder/BelteHøy.JPG

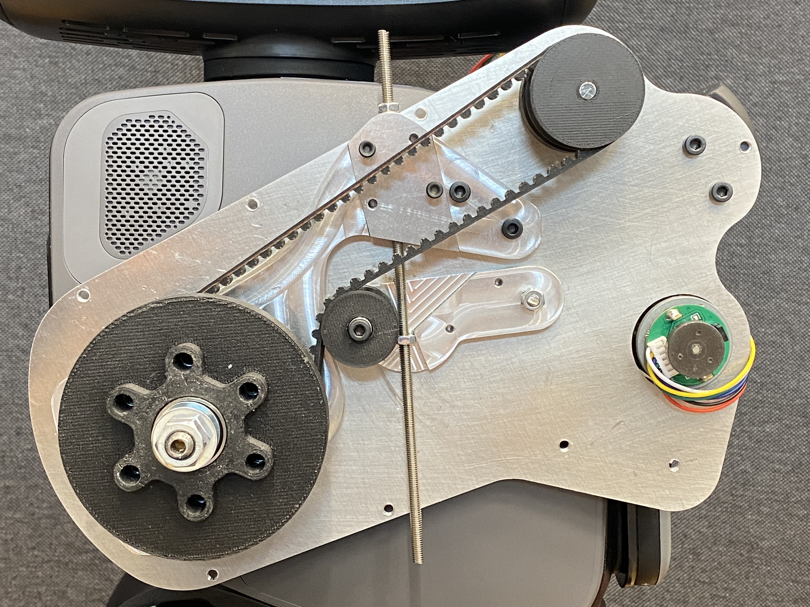
Pictures/Skulder/BelteHøy.JPG
