DAwesomEL/BachelorProsjekt/Pictures/Skulder/BelteLav.JPG

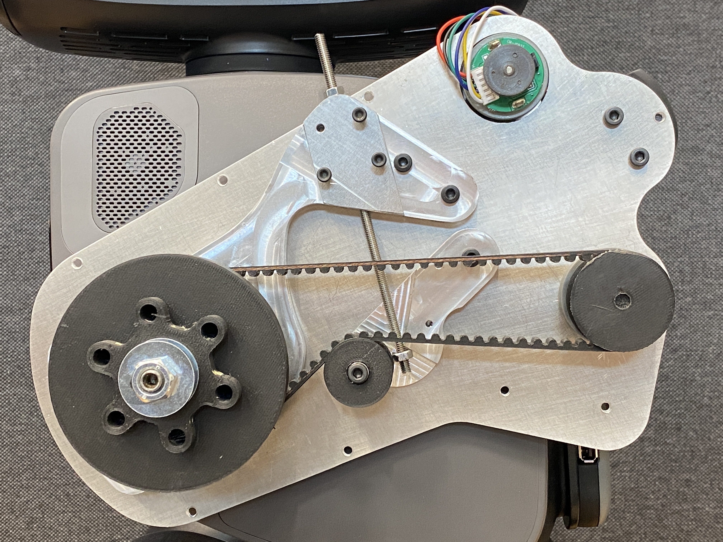
Pictures/Skulder/BelteLav.JPG
