DAwesomEL/BachelorProsjekt/Pictures/Skulder/Kragemekanisme/Kragemekanisme inne.PNG

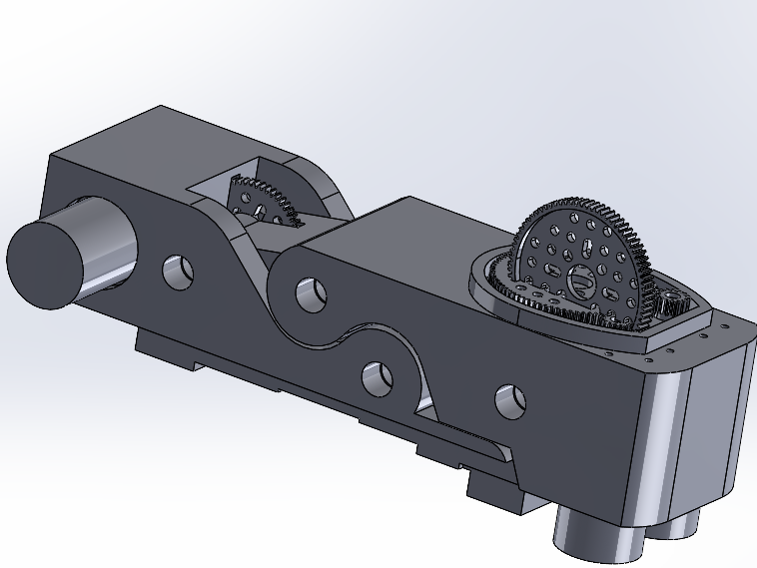
Pictures/Skulder/Kragemekanisme/Kragemekanisme inne.PNG
