DAwesomEL/BachelorProsjekt/Pictures/Skulder/Kragemekanisme/Kragemekanisme ute.PNG

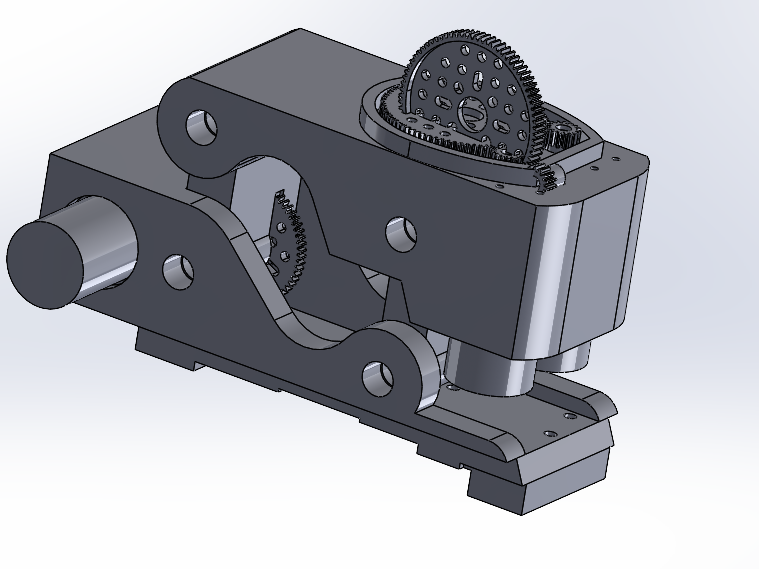
Pictures/Skulder/Kragemekanisme/Kragemekanisme ute.PNG
