DAwesomEL/BachelorProsjekt/Pictures/Workspace from behind.PNG

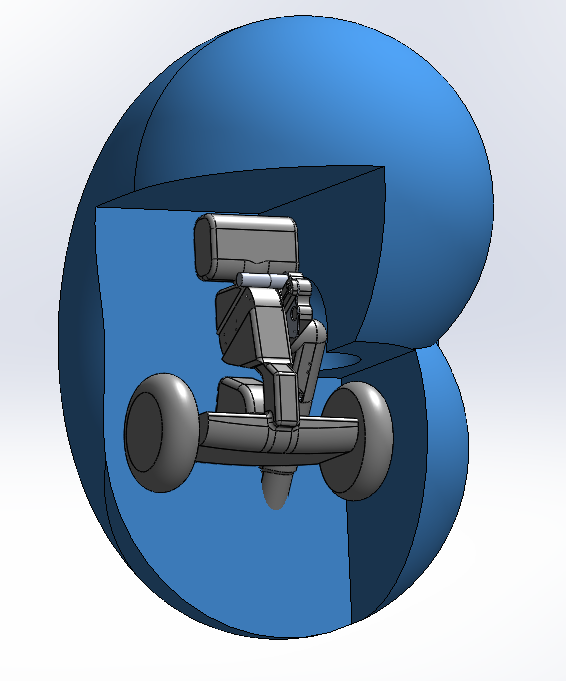
Pictures/Workspace from behind.PNG
