DAwesomEL/BachelorProsjekt/Pictures/Workspace from front.PNG

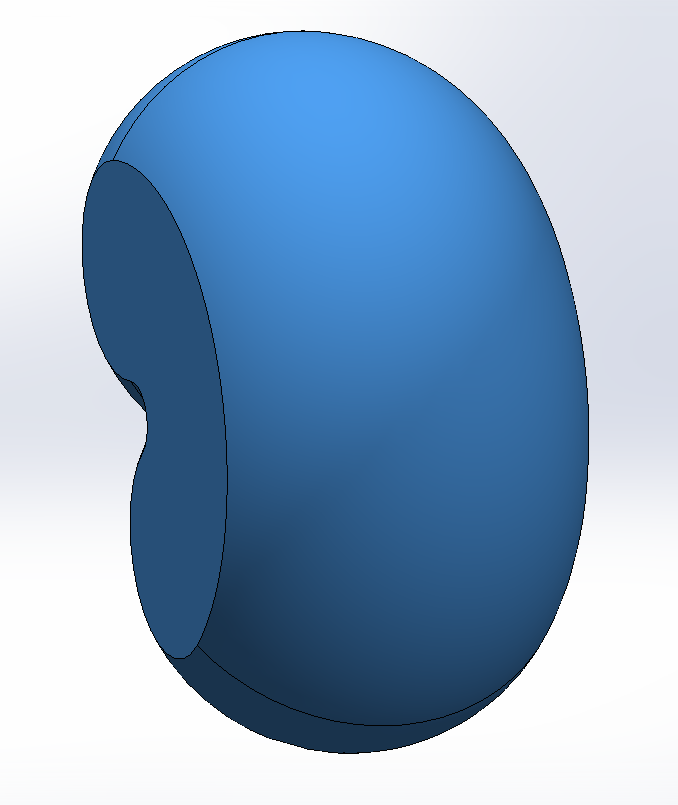
Pictures/Workspace from front.PNG
