DAwesomEL/BachelorProsjekt/Pictures/Workspace from side.PNG

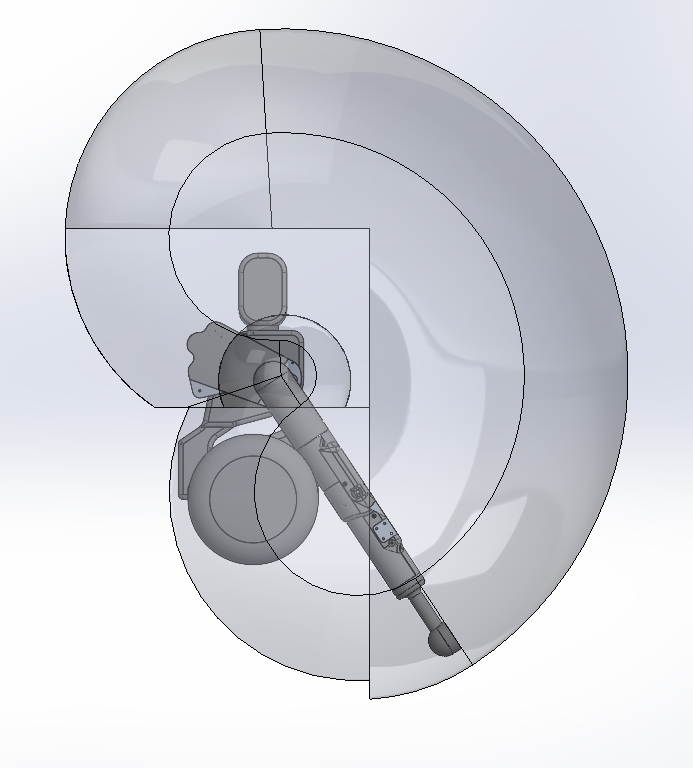
Pictures/Workspace from side.PNG
