DAwesomEL/BachelorProsjekt/Pictures/Workspace see through.PNG

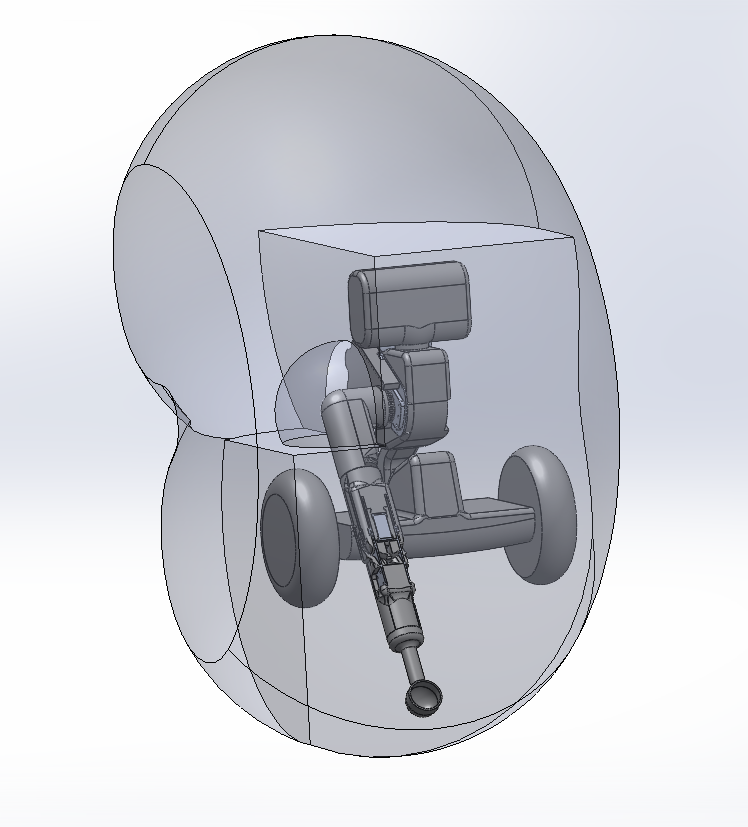
Pictures/Workspace see through.PNG
