DAwesomEL/BachelorProsjekt/NOTES/Budsjett.xlsx

Sheet: Budsjett
Place | Part number | Type | Price | Amount | Part total | Notes
Microdcmotor | NFP-GA32Y-31ZY-EN | Motor | 260 | 4 | 1040
 | NFP-5840-31ZYS-D | Motor | 195 | 2 | 390
 | NFP-GA20Y-180 | Motor | 115 | 4 | 460
 |  |  |  |  | 1890
RS component | 608-2RS | Miniature ball bearing | 34 | 10 | 340
 | 51100 | Thrust bearing | 63 | 2 | 126
 | 146-9289 | Roller bearing | 42 | 2 | 84 | Ideler
 | 175-5215 | HTD Timing Belt | 77.68 | 2 | 155.36
 |  |  |  |  | 705.36
 | 619-0323 | Ball Bearing | 47 | 2 | 94 | Axial rot upper arm
 | 198-8894 | Thrust Bearing | 80 | 4 | 320 | Axial rot upper arm
 |  |  |  |  | 0
Biltema
Amazon |  | Motor controller | 146 | 2 | 292
 |  | Buck converter | 166 | 1 | 166
 |  | Position sensor | 122 | 5 | 610
 |  | I2C level converter | 111 | 2 | 222
 |  |  |  |  | 1830 | Total amazon + frakt
Selfmade | pulley_40_5m__09_10 | Pulley | 0 | 2 | 0
 | pulley_20_5m__09_8 | Pulley | 0 | 2 | 0
 | idler_09_6 | Idler | 0 | 2 | 0
 |  |  |  |  | 4425.36 | Sum total kostnad

Sheet: Part List
Place | Part number | Type | Price | Amount | Part total | Notes
Microdcmotor | NFP-GA32Y-31ZY-EN | Motor | 260 | 4 | 1040
 | NFP-5840-31ZYS-D | Motor | 195 | 2 | 390
 | NFP-GA20Y-180 | Motor | 115 | 4 | 460
 |  |  |  |  | 1890
 | RS stock number
RS component | 618-9957 | Miniature ball bearing | 33.84 | 4 | 135.36
 | 198-8894 | Thrust bearing | 80.28 | 4 | 321.12
 | 146-9289 | Roller bearing | 41.31 | 2 | 82.62
 | 475-0254 | HTD Timing Belt | 95.48 | 2 | 190.96
 | 619-0323 | Deep Groove Ball Bearing | 46.75 | 2 | 93.5
 |  |  |  |  | 823.56
Biltema
Andre | CJMCU-7960 | Motor controller | 0 | 5 | 0
 |  | Buck converter | 166 | 1 | 166
 |  | Position sensor | 122 | 5 | 610
 |  | I2C level converter | 111 | 2 | 222
 |  |  |  |  | 1830 | Total amazon + frakt
Selfmade | pulley_40_5m__09_10 | Pulley | 0 | 2 | 0
 | pulley_20_5m__09_8 | Pulley | 0 | 2 | 0
 | idler_09_6 | Idler | 0 | 2 | 0
 |  |  |  |  | 4543.56 | Sum total kostnad
