DAwesomEL/BachelorProsjekt/Pictures/ComparasonTables/Style and Components.PNG

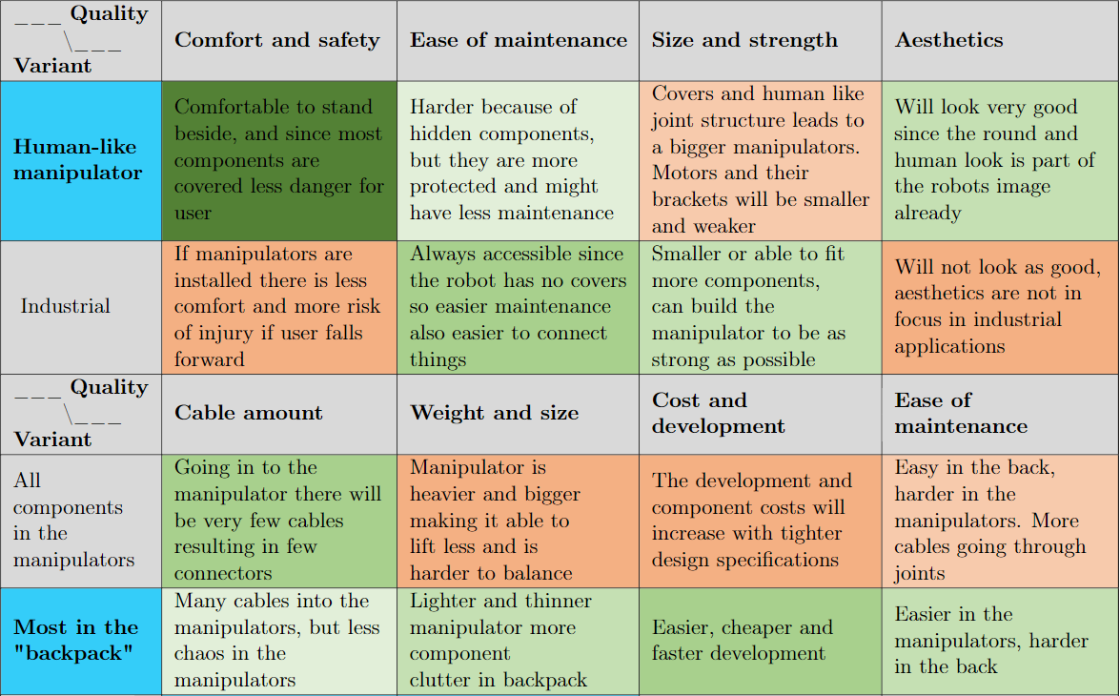
Pictures/ComparasonTables/Style and Components.PNG
