DAwesomEL/BachelorProsjekt/Pictures/Components/AS5600.jpg

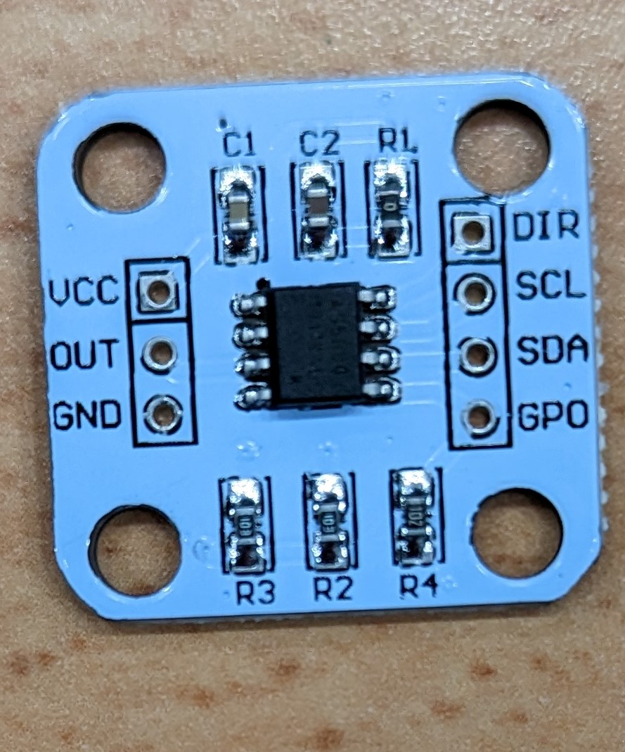
Pictures/Components/AS5600.jpg
