DAwesomEL/BachelorProsjekt/Pictures/Components/Current sensor.jpg

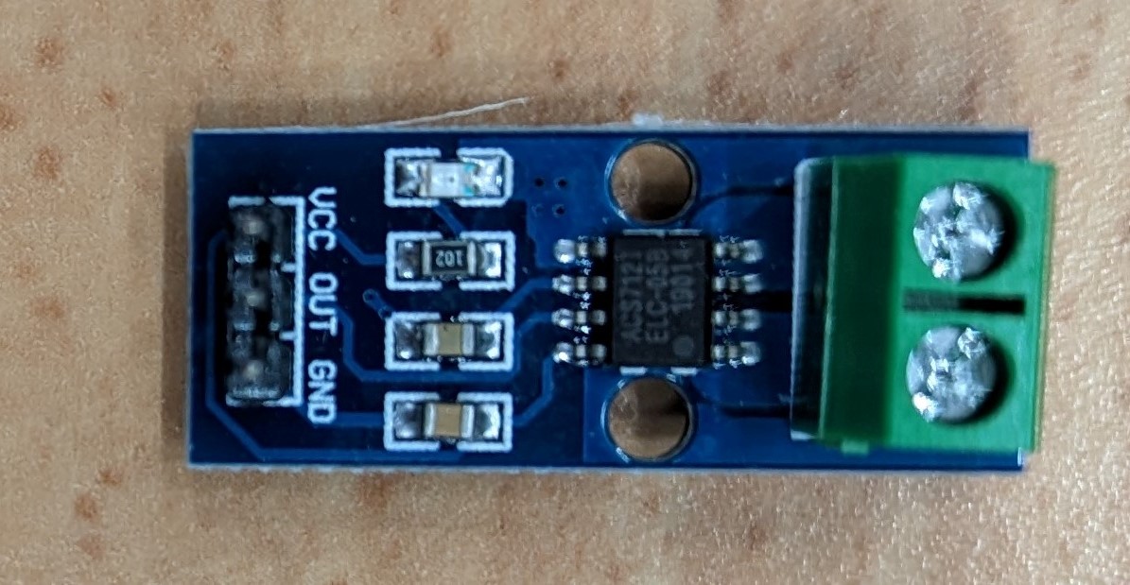
Pictures/Components/Current sensor.jpg
