DAwesomEL/BachelorProsjekt/Pictures/Components/I2C level converter.jpg

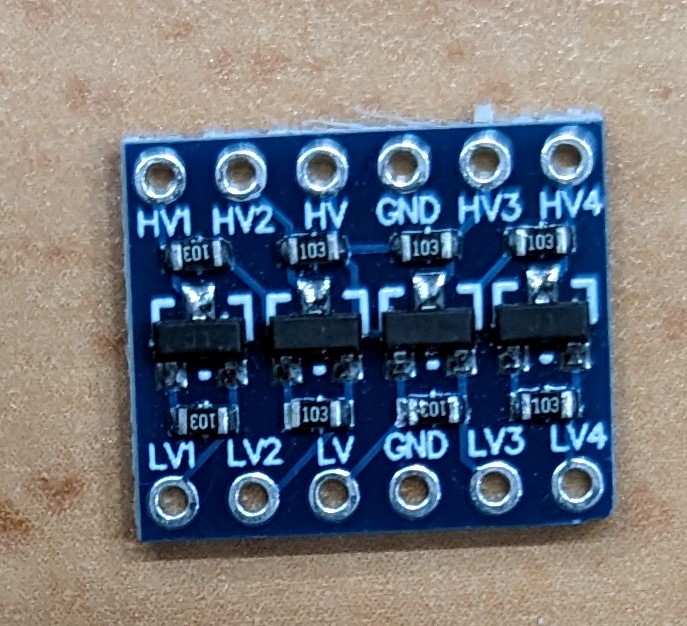
Pictures/Components/I2C level converter.jpg
