DAwesomEL/BachelorProsjekt/Pictures/Components/Motor controller.jpg

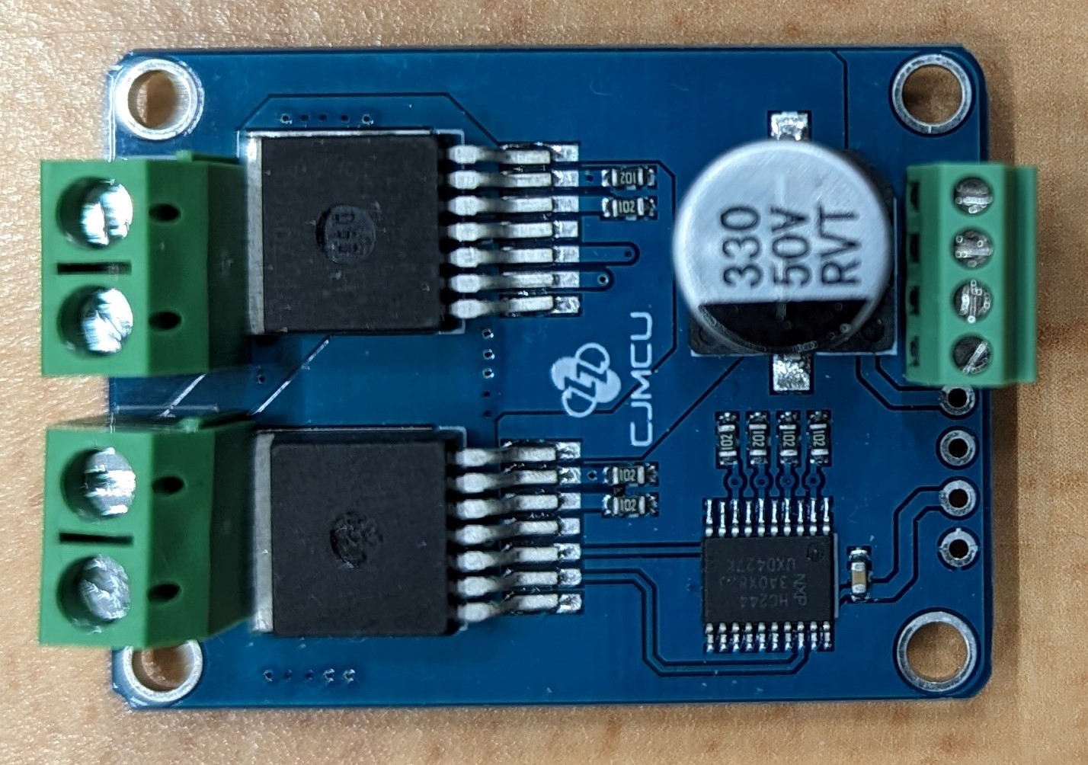
Pictures/Components/Motor controller.jpg
