DAwesomEL/BachelorProsjekt/Pictures/Components/MPU9250.jpg

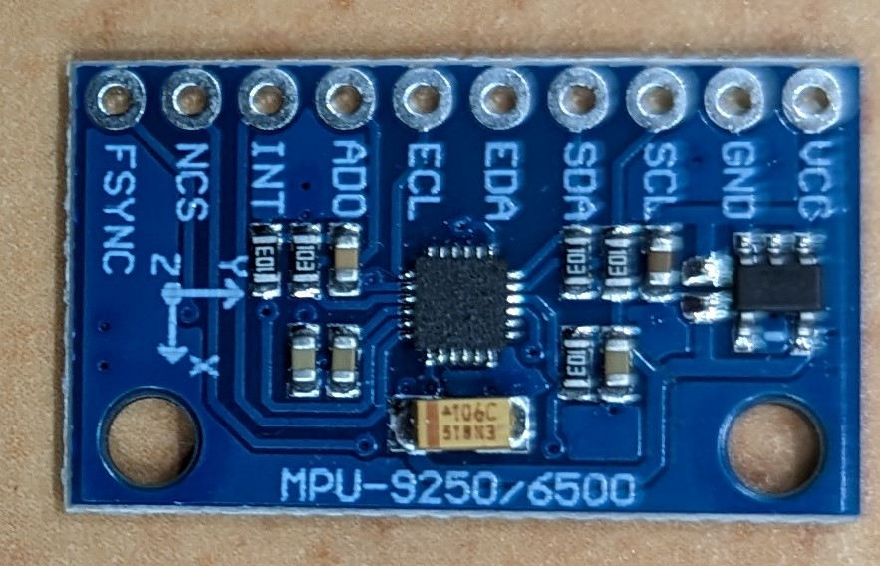
Pictures/Components/MPU9250.jpg
