DAwesomEL/BachelorProsjekt/Pictures/Components/Mux.jpg

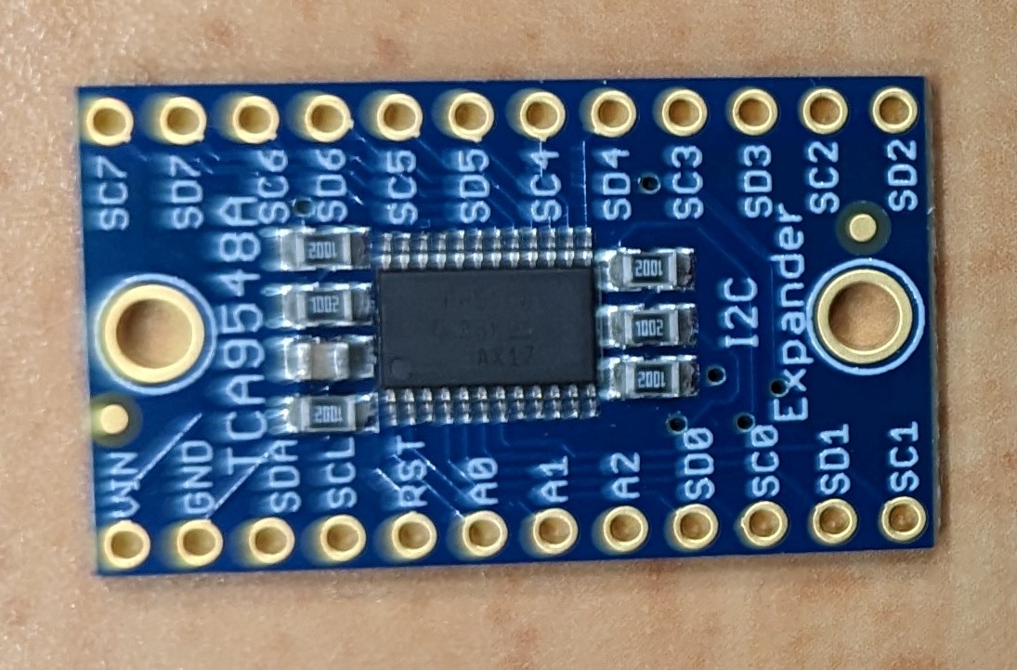
Pictures/Components/Mux.jpg
