DAwesomEL/BachelorProsjekt/Pictures/Components/Power indicator.png

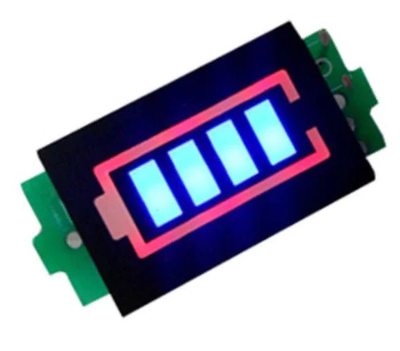
Pictures/Components/Power indicator.png
