DAwesomEL/BachelorProsjekt/Pictures/Components/Terminal block shield.jpg

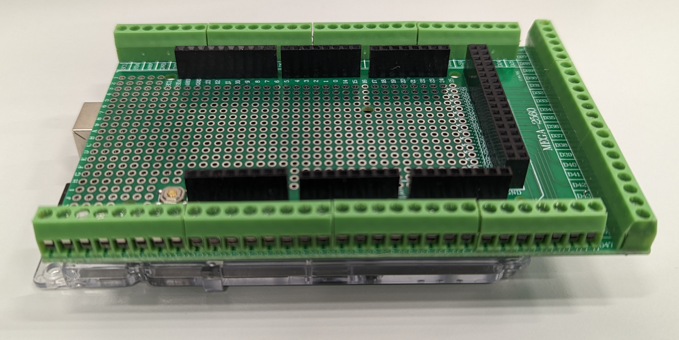
Pictures/Components/Terminal block shield.jpg
