DAwesomEL/BachelorProsjekt/Pictures/FEM/EXTRANEW FEM/FocusedParts.PNG

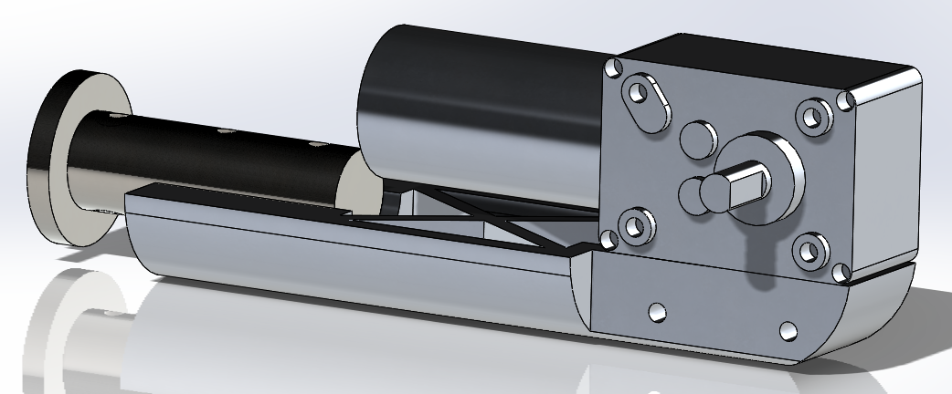
Pictures/FEM/EXTRANEW FEM/FocusedParts.PNG
