DAwesomEL/BachelorProsjekt/Pictures/Material/5754 Aluminium.PNG

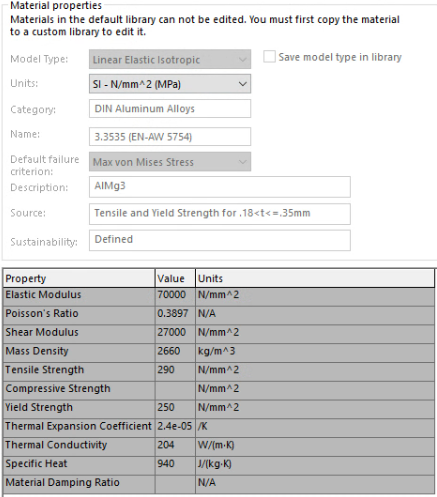
Pictures/Material/5754 Aluminium.PNG
