DAwesomEL/BachelorProsjekt/Pictures/Material/PLA self defined.PNG

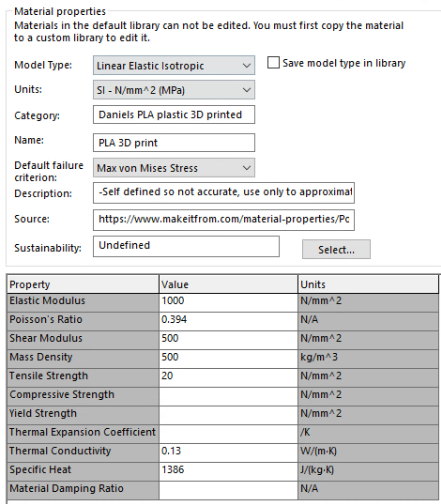
Pictures/Material/PLA self defined.PNG
