DAwesomEL/BachelorProsjekt/Pictures/Material/S235.PNG

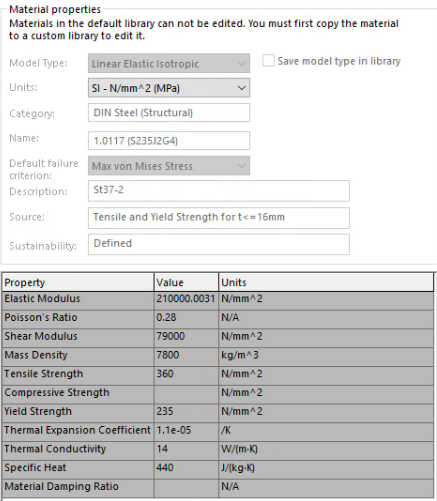
Pictures/Material/S235.PNG
