DAwesomEL/BachelorProsjekt/Deler til maskinering/TorsjonOverarmMotorBrakett/SammenstillingTorsjonOverarmMotorBrakett.SLDASM

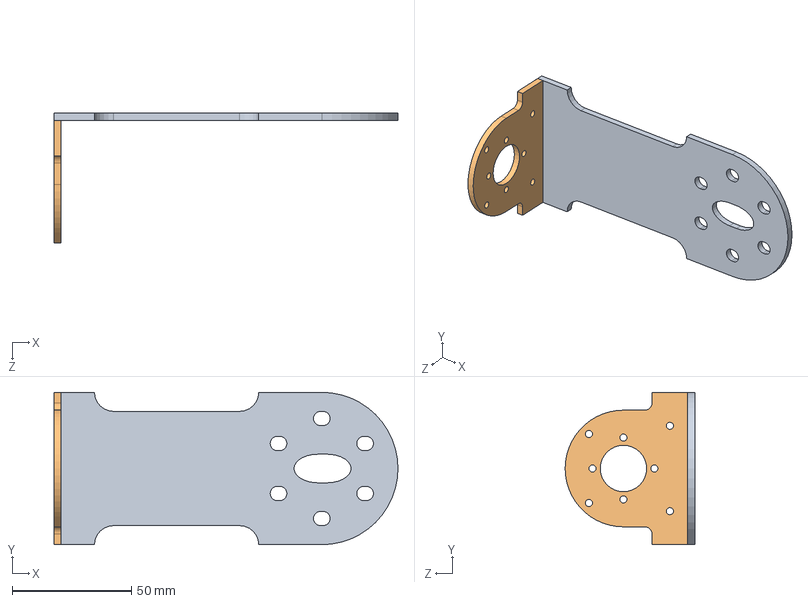
[picture p136: CAD file, 2023-05-16]
Deler til maskinering/TorsjonOverarmMotorBrakett/SammenstillingTorsjonOverarmMotorBrakett.SLDASM
144.5 x 64.0 x 54.5 mm
TorsjonOverarmMotorBrakettFesteside
TorsjonOverarmMotorBrakettMotorside
