DAwesomEL/BachelorProsjekt/FastSkulder/sm_m08t15h10.sldasm

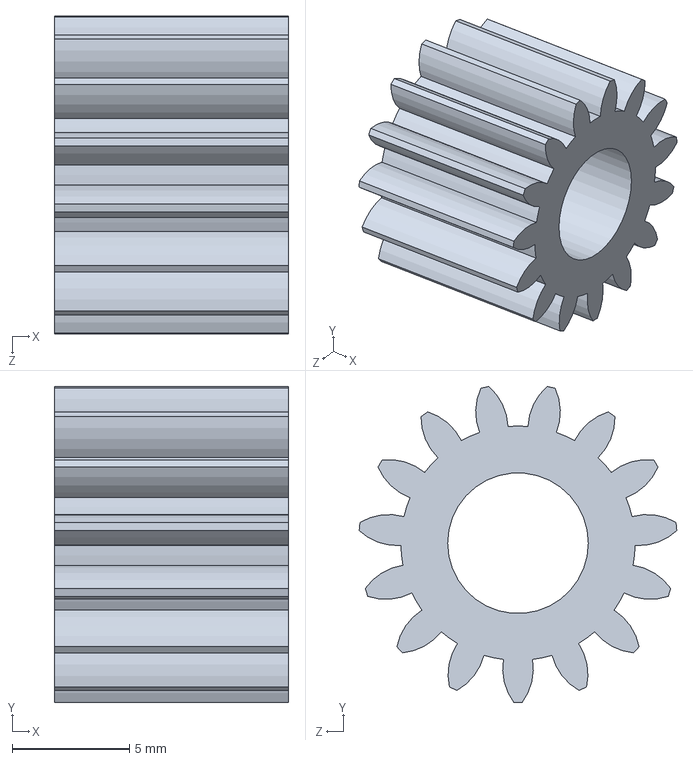
[picture p137: CAD file, 2023-02-21]
FastSkulder/sm_m08t15h10.sldasm
10.0 x 13.5 x 13.6 mm
