DAwesomEL/BachelorProsjekt/Loomo model/Loomo.SLDASM

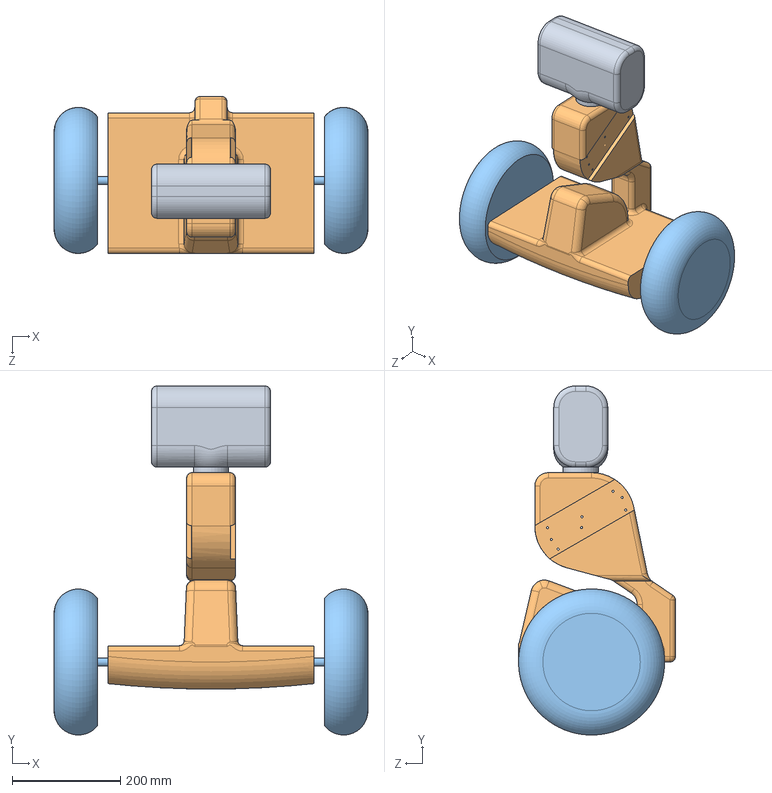
[picture p138: CAD file, 2023-05-28]
Loomo model/Loomo.SLDASM
580.0 x 644.9 x 290.0 mm
Loomo Head
Loomo Body
Loomo Wheel x 2
