DAwesomEL/BachelorProsjekt/Pictures/Simuleringer/Hele armen/Skulderledd.SLDASM

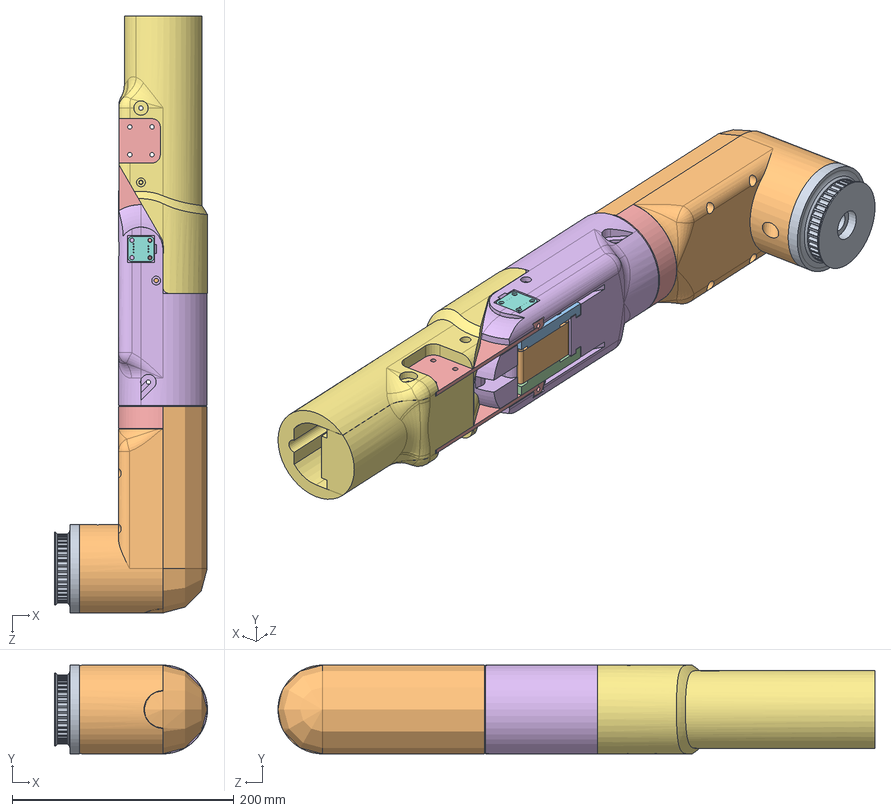
[picture p139: CAD file, 2023-04-21]
Pictures/Simuleringer/Hele armen/Skulderledd.SLDASM
137.9 x 80.0 x 538.2 mm
pulley_40_5m__09_10
Skulder
31mm360gMotor
TorsjonOverarmMotorBrakett
AxialRotationUpperArmLid
AkslingTorsjonOverarm
Thrust203504 x 2
TorsionElbowSide
AlbueMotorBrakett
31mm360WormMotor
GrønnePrinsen
GrønnePrinsSideUtenSkruer
GrønnePrinsessen x 2
DekselKabelgateOrmegir
Underarm
