DAwesomEL/BachelorProsjekt/plate tester/HullplateTESTmålAssembly.SLDASM

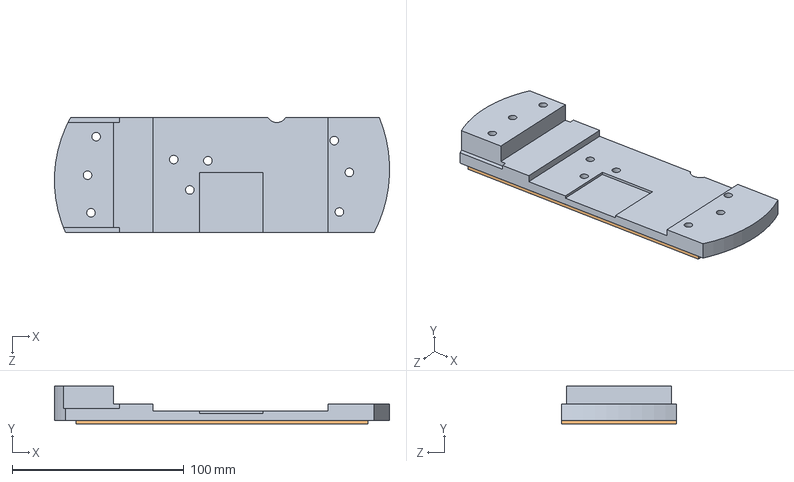
[picture p140: CAD file, 2023-02-21]
plate tester/HullplateTESTmålAssembly.SLDASM
194.9 x 22.0 x 67.0 mm
Bracket11jan
TestPlateIAssembly
