DAwesomEL/BachelorProsjekt/WORK/ASSEMBLY/BelteDekselLeft/BelteDekselLeftMain.SLDPRT

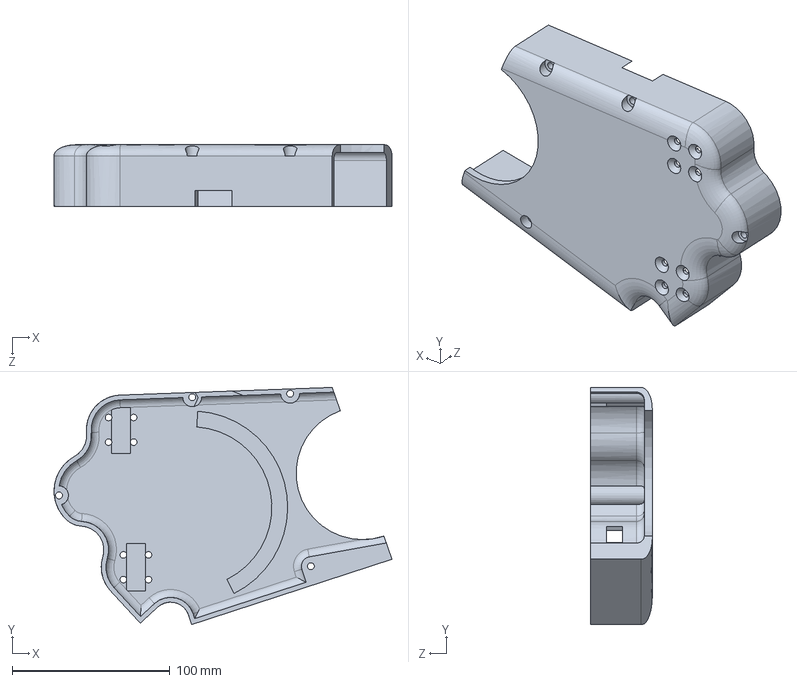
[picture p141: CAD file, 2023-05-28]
WORK/ASSEMBLY/BelteDekselLeft/BelteDekselLeftMain.SLDPRT
214.0 x 150.1 x 39.0 mm
