DAwesomEL/BachelorProsjekt/WORK/ASSEMBLY/Loomo arm.SLDASM

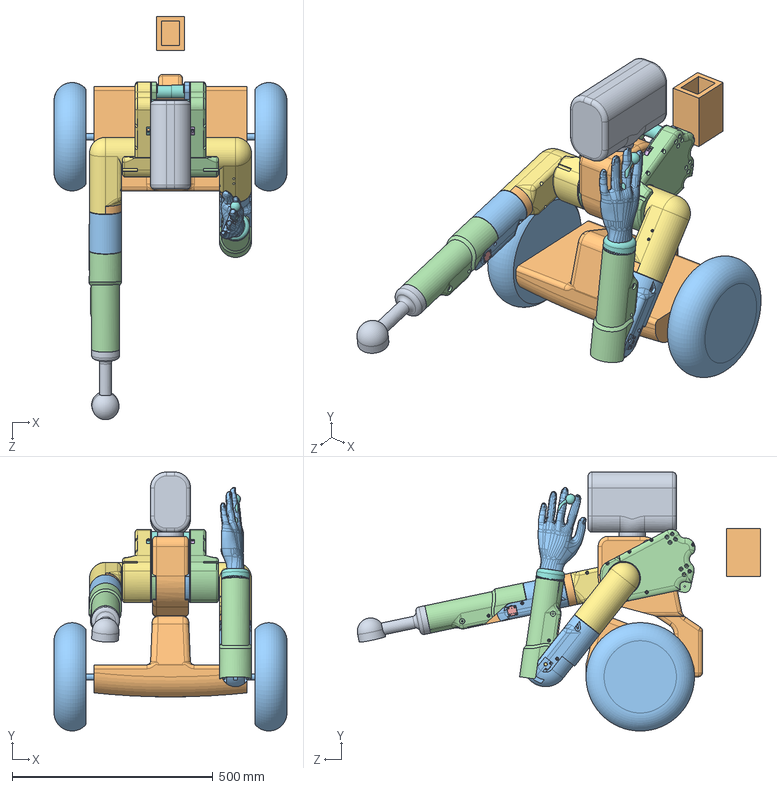
[picture p142: CAD file, 2023-05-28]
WORK/ASSEMBLY/Loomo arm.SLDASM
580.0 x 644.9 x 1004.6 mm
Loomo Head
Loomo Body
Loomo Wheel x 2
BracketBottom
MonteringsplateRightFinal
pulley_40_5m__09_10 x 2
Skulder x 2
31mm360gMotor x 4
TorsjonOverarmMotorBrakett x 2
AxialRotationUpperArmLid x 2
AkslingTorsjonOverarm x 2
Thrust203504 x 4
TorsionElbowSide x 2
AlbueMotorBrakett x 2
31mm360WormMotor x 2
ElbowMotorFastnerBracket x 2
ElbowMotorFastnerBracketMirrored x 2
ElbowMotorOutputBracket x 4
DekselKabelgateOrmegir x 2
Underarm x 2
Magnetisk Abs Enkoder AS5600
idler_09_4 x 2
pulley_20_5m__09_8 x 2
SkulderAkslingsbrakett
PulleyStrammerRight
IdelerM4100mmFasteningScrew
BracketBottomLeft
MonteringsplateLeftFinal
PulleyStrammerLeft
SkulderAkslingsbrakettLeft
Sleiv
Batteri vekt kompensasjon
LeftHand
BelteDekselLeft
