DAwesomEL/BachelorProsjekt/WORK/LeftShoulder/FastSkulderMotorBakL.SLDASM

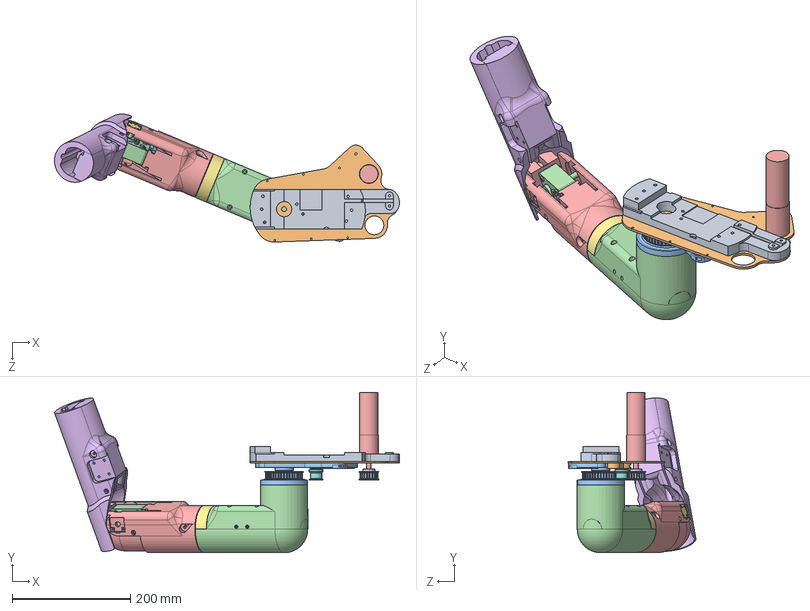
[picture p143: CAD file, 2023-05-28]
WORK/LeftShoulder/FastSkulderMotorBakL.SLDASM
584.1 x 271.7 x 216.7 mm
BracketBottomLeft
MonteringsplateLeftFinal
pulley_40_5m__09_10
Skulder
31mm360gMotor x 2
TorsjonOverarmMotorBrakett
AxialRotationUpperArmLid
AkslingTorsjonOverarm
Thrust203504 x 2
TorsionElbowSide
AlbueMotorBrakett
31mm360WormMotor
DekselKabelgateOrmegir
Underarm
Magnetisk Abs Enkoder AS5600
idler_09_4
pulley_20_5m__09_8
PulleyStrammerLeft
SkulderAkslingsbrakettLeft
