DAwesomEL/BachelorProsjekt/WORK/RightShoulder/FastSkulderMotorBak.SLDASM

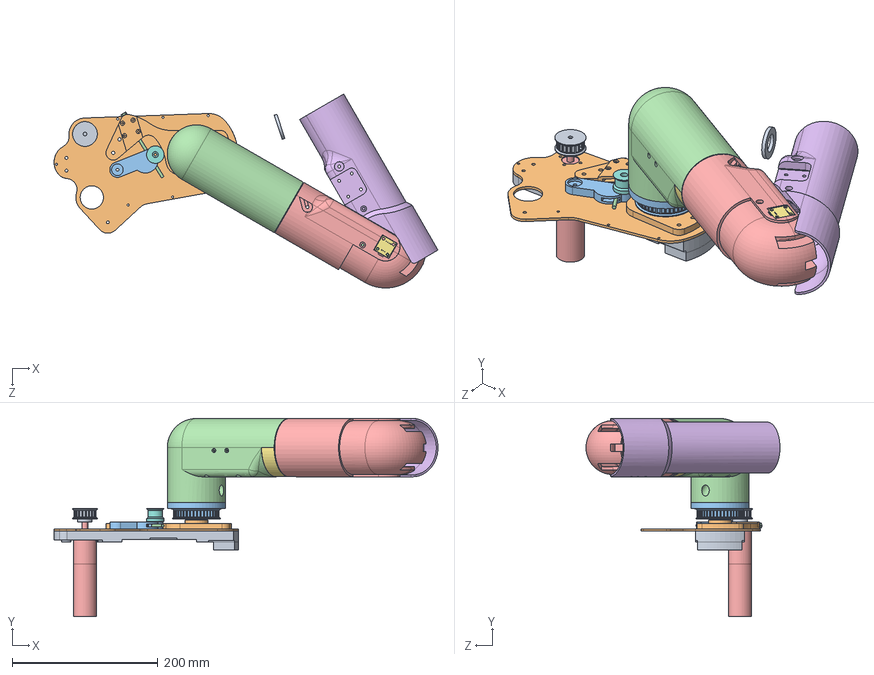
[picture p144: CAD file, 2023-05-28]
WORK/RightShoulder/FastSkulderMotorBak.SLDASM
526.6 x 271.7 x 266.1 mm
BracketBottom
MonteringsplateRightFinal
pulley_40_5m__09_10
Skulder
31mm360gMotor x 2
TorsjonOverarmMotorBrakett
AxialRotationUpperArmLid
AkslingTorsjonOverarm
Thrust203504 x 2
TorsionElbowSide
AlbueMotorBrakett
31mm360WormMotor
DekselKabelgateOrmegir
Underarm
Magnetisk Abs Enkoder AS5600
idler_09_4
pulley_20_5m__09_8
SkulderAkslingsbrakett
PulleyStrammerRight
