DAwesomEL/BachelorProsjekt/Skulderledd/Skulderledd.SLDASM

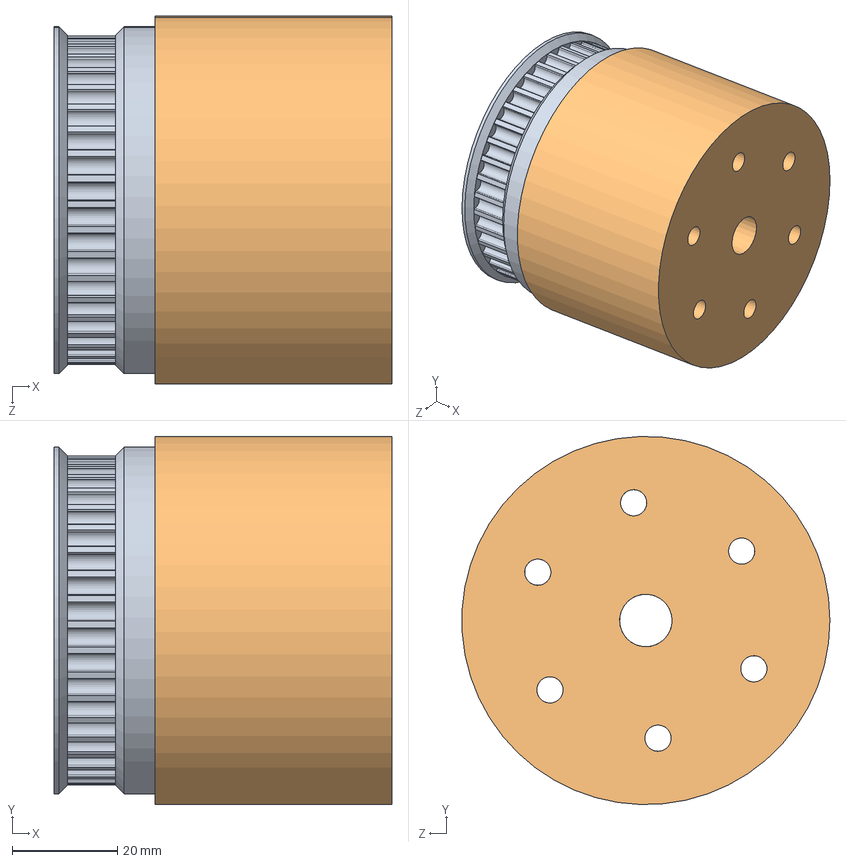
[picture p145: CAD file, 2023-02-21]
Skulderledd/Skulderledd.SLDASM
64.2 x 70.0 x 69.9 mm
pulley_40_5m__09_10
Overarm
