DAwesomEL/BachelorProsjekt/WORK/Skulderledd/Skulderledd.SLDASM

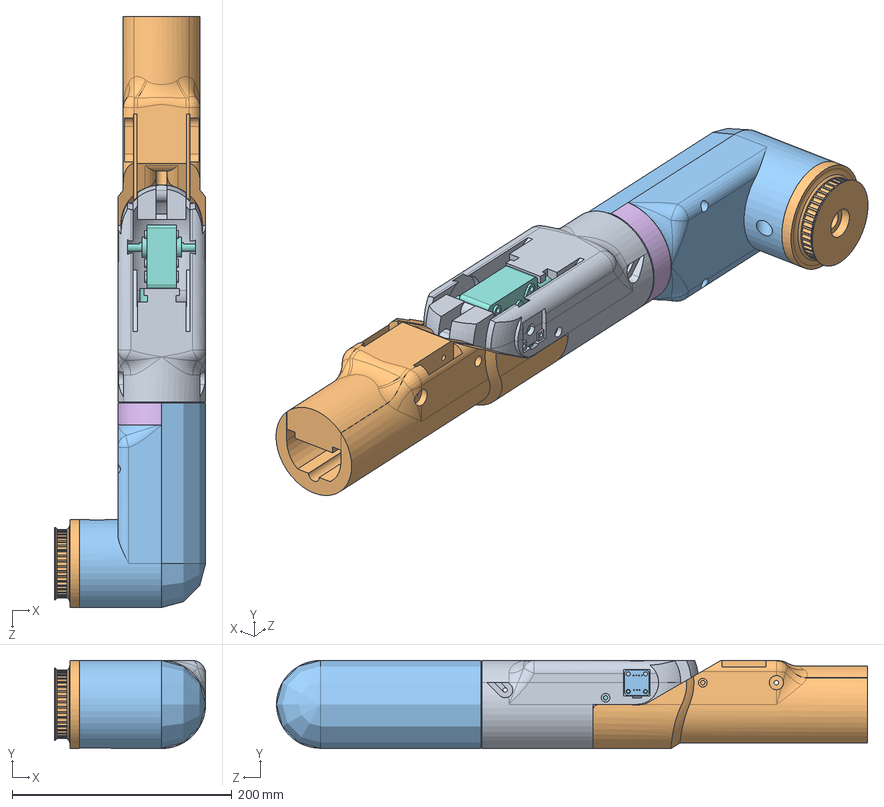
[picture p146: CAD file, 2023-05-28]
WORK/Skulderledd/Skulderledd.SLDASM
137.7 x 80.2 x 538.2 mm
pulley_40_5m__09_10
Skulder
31mm360gMotor
TorsjonOverarmMotorBrakett
AxialRotationUpperArmLid
AkslingTorsjonOverarm
Thrust203504 x 2
31mm360WormMotor
DekselKabelgateOrmegir
Underarm
Magnetisk Abs Enkoder AS5600
