DAwesomEL/BachelorProsjekt/Deler til maskinering/SkulderAkslingsbrakett/SammenstillingPulleystrammerRight.SLDASM

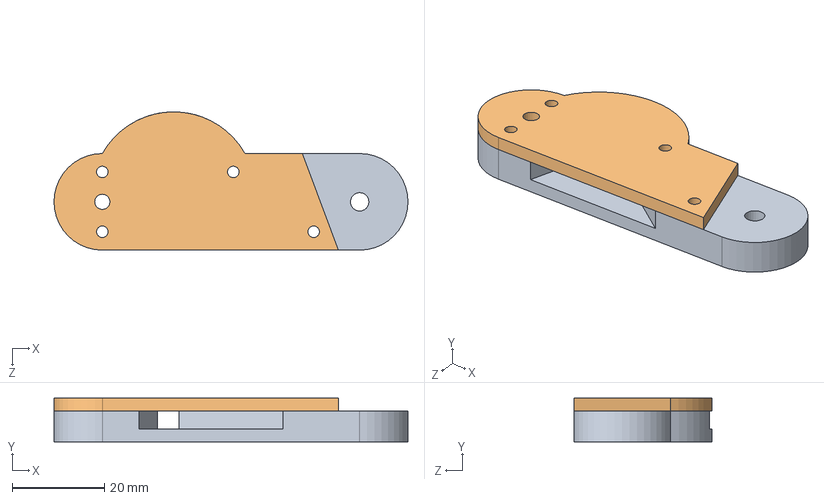
[picture p147: CAD file, 2023-05-16]
Deler til maskinering/SkulderAkslingsbrakett/SammenstillingPulleystrammerRight.SLDASM
76.9 x 9.50 x 30.1 mm
PulleyStrammerBottomRight
PulleyStrammerLidRight
