DAwesomEL/BachelorProsjekt/plate tester/TestPlateIAssembly.SLDPRT

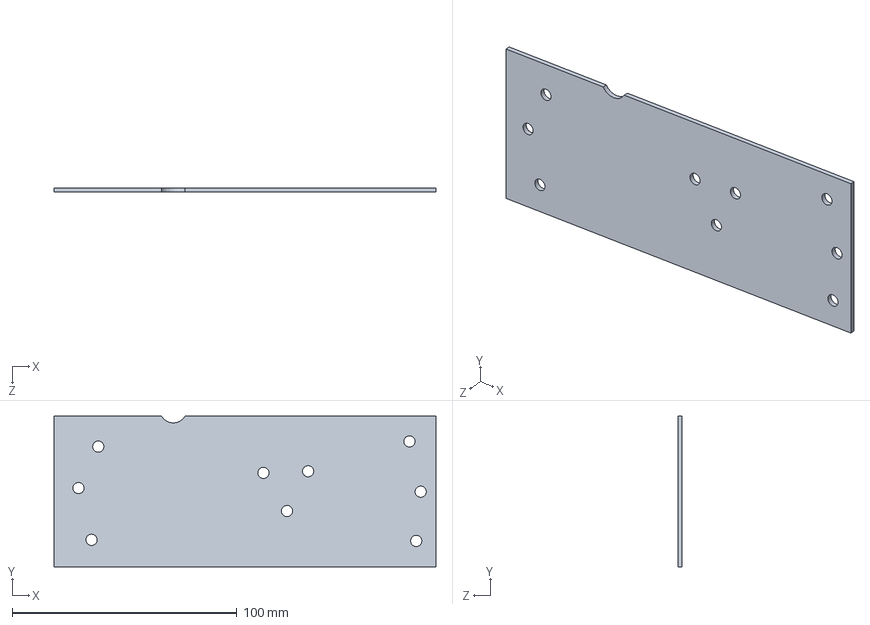
[picture p148: CAD file, 2023-02-21]
plate tester/TestPlateIAssembly.SLDPRT
170.0 x 67.0 x 2.00 mm
