DAwesomEL/BachelorProsjekt/WORK/ASSEMBLY/DekselForBelteR.SLDASM

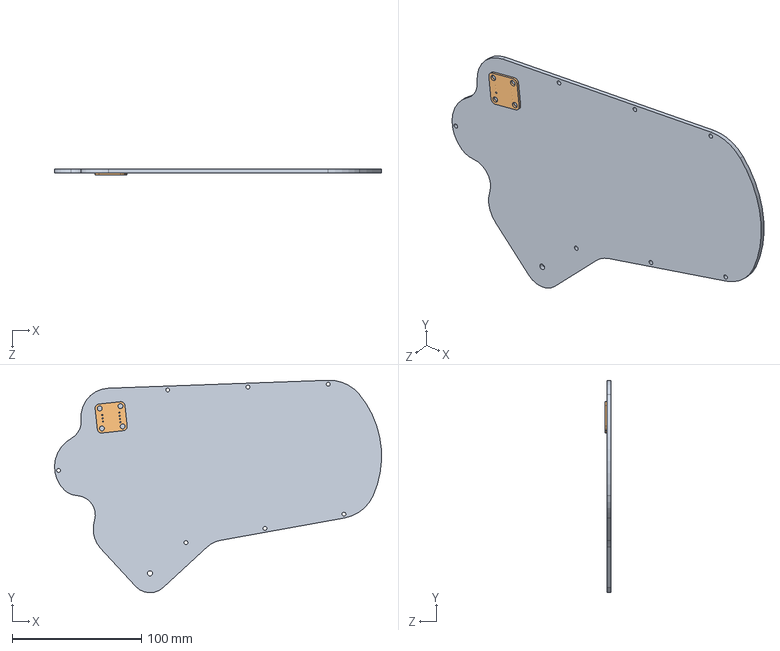
[picture p149: CAD file, 2023-05-13]
WORK/ASSEMBLY/DekselForBelteR.SLDASM
252.7 x 164.2 x 4.65 mm
DekselForBelte
Magnetisk Abs Enkoder AS5600
