DAwesomEL/BachelorProsjekt/WORK/Elbow/Elbow.SLDASM

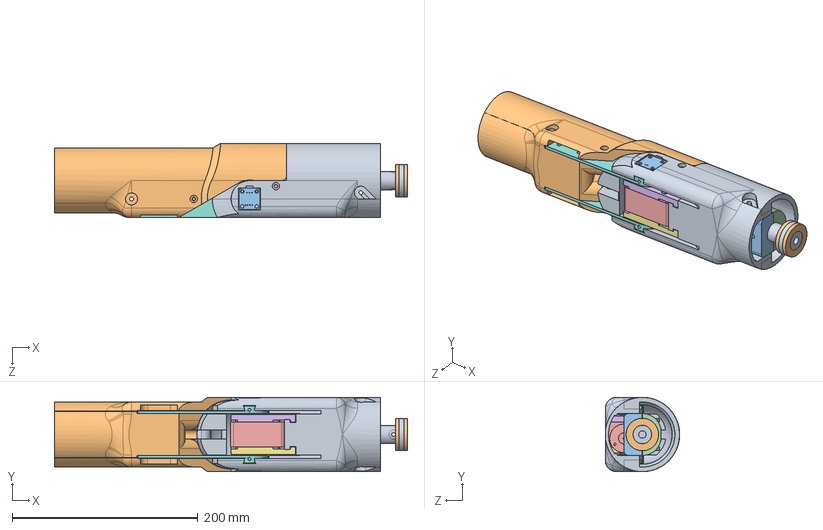
[picture p150: CAD file, 2023-05-28]
WORK/Elbow/Elbow.SLDASM
380.2 x 80.0 x 80.2 mm
AkslingTorsjonOverarm
Thrust203504 x 2
TorsionElbowSide
AlbueMotorBrakett
31mm360WormMotor
ElbowMotorFastnerBracket
ElbowMotorFastnerBracketMirrored
ElbowMotorOutputBracket x 2
DekselKabelgateOrmegir
Underarm
Magnetisk Abs Enkoder AS5600
