DAwesomEL/BachelorProsjekt/WORK/Testing/Motor test.SLDASM

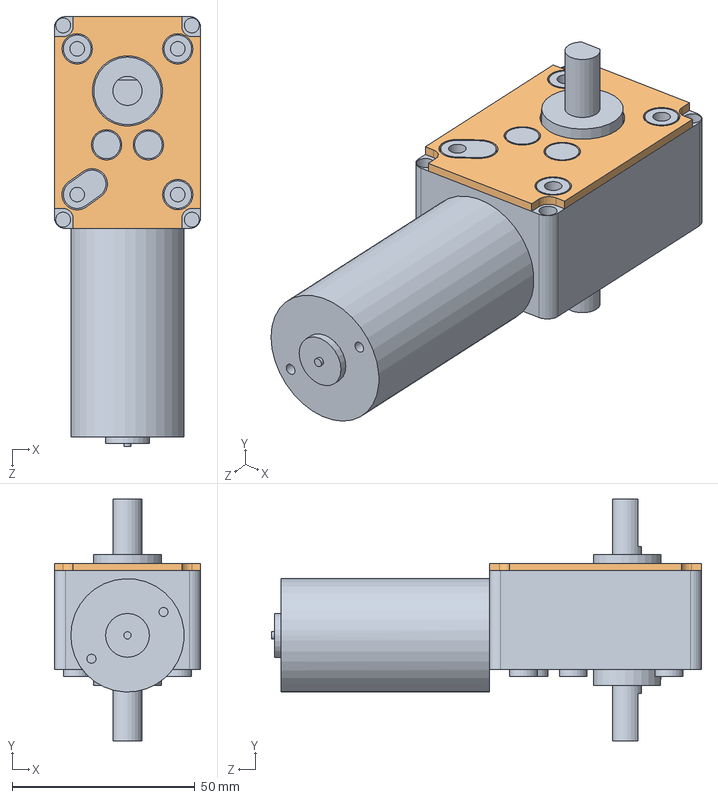
[picture p151: CAD file, 2023-03-07]
WORK/Testing/Motor test.SLDASM
40.0 x 66.2 x 117.6 mm
31mm360WormMotor
Testplate
