DAwesomEL/BachelorProsjekt/FastSkulder/FastSkulder.SLDASM

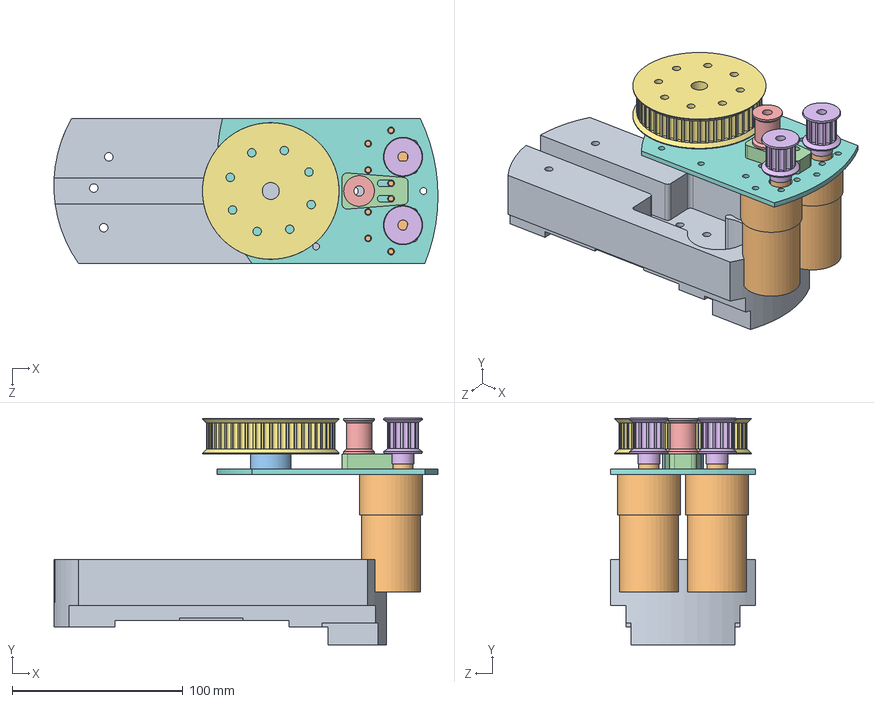
[picture p152: CAD file, 2023-02-21]
FastSkulder/FastSkulder.SLDASM
224.9 x 133.0 x 85.0 mm
BracketBottom
200gMotor x 2
RollerBearing
IdlerSlider
idler_15_6
pulley_12_5m__15_6 x 2
pulley_48_5m__15_10
MetalStiffBracket
