DAwesomEL/BachelorProsjekt/FastSkulderNy/sm_m08t80h10.sldasm

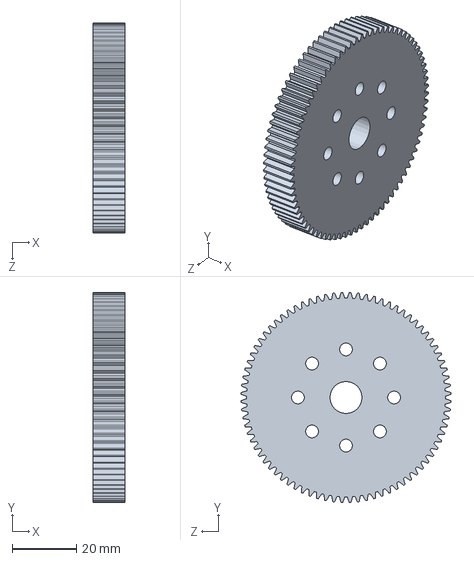
[picture p153: CAD file, 2023-02-21]
FastSkulderNy/sm_m08t80h10.sldasm
10.0 x 65.6 x 65.6 mm
