DAwesomEL/BachelorProsjekt/Deler til maskinering/SkulderAkslingsbrakett/SammenstillingSkulderAkslingsbrakettRight.SLDASM

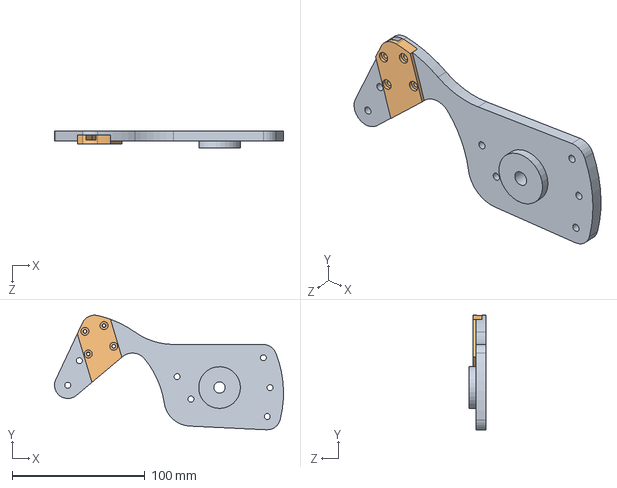
[picture p154: CAD file, 2023-04-26]
Deler til maskinering/SkulderAkslingsbrakett/SammenstillingSkulderAkslingsbrakettRight.SLDASM
172.2 x 86.2 x 12.5 mm
SkulderAkslingsbrakettBottomRight
SkulderAkslingsbrakettLidRight
