DAwesomEL/BachelorProsjekt/Kragemekanisme/Kragemekanisme.SLDASM

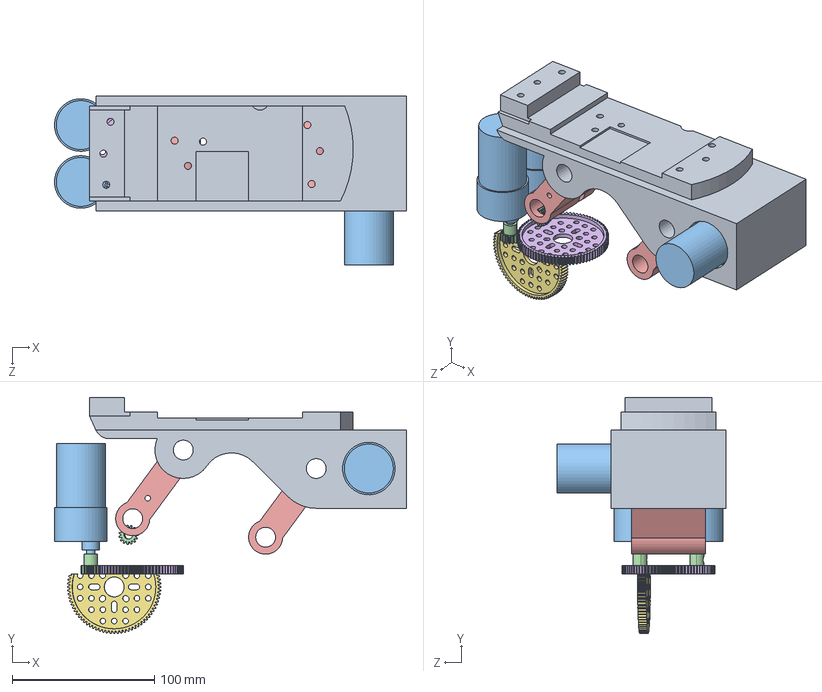
[picture p155: CAD file, 2023-02-21]
Kragemekanisme/Kragemekanisme.SLDASM
247.6 x 166.1 x 119.0 mm
Bracket
krageGirStor_mod08tooth60
200gMotor x 3
15toothMod08 x 4
Arm x 2
80toothmod08
80toothmod08 Cut
