DAwesomEL/BachelorProsjekt/Deler til maskinering/SkulderAkslingsbrakett/SammenstillingSkulderAkslingsbrakettLeft.SLDASM

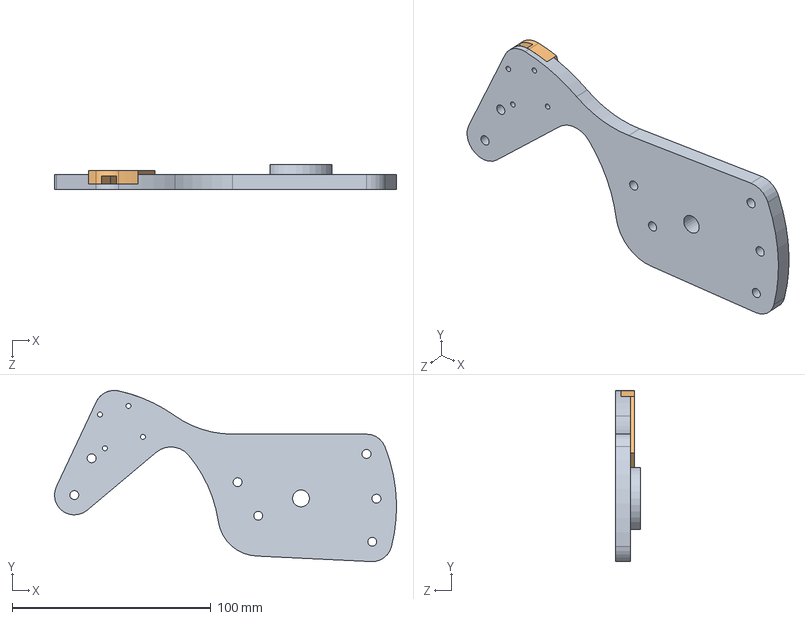
[picture p156: CAD file, 2023-04-21]
Deler til maskinering/SkulderAkslingsbrakett/SammenstillingSkulderAkslingsbrakettLeft.SLDASM
172.2 x 86.2 x 12.5 mm
SkulderAkslingsbrakettBottomLeft
SkulderAkslingsbrakettLidLeft
