DAwesomEL/BachelorProsjekt/FastSkulderNy/FastSkulder.SLDASM

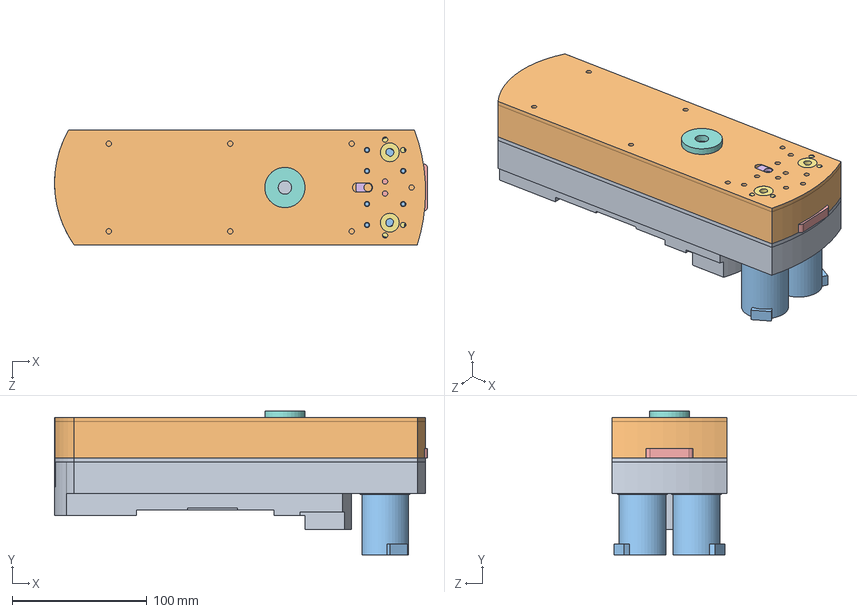
[picture p157: CAD file, 2023-02-21]
FastSkulderNy/FastSkulder.SLDASM
276.4 x 106.7 x 85.0 mm
BracketBottom
BracketTop
200gMotor x 2
RollerBearing
IdlerSlider
idler_15_6
pulley_12_5m__15_6 x 2
pulley_48_5m__15_10
MetalStiffBracket
BeinSjold
