DAwesomEL/BachelorProsjekt/STL/BracketBottomNewHole.STL

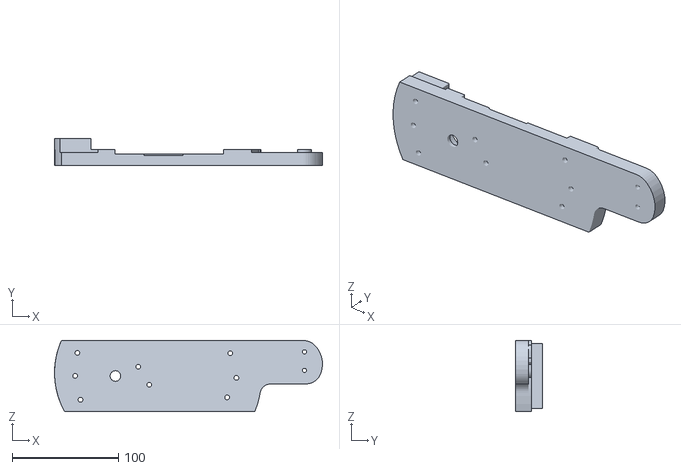
[picture p158: CAD file, 2023-03-08]
STL/BracketBottomNewHole.STL
252.8 x 25.4 x 67.0
