DAwesomEL/BachelorProsjekt/Deler til maskinering/AkslingTorsjonOverarm/AkslingTorsjonOverarm.SLDPRT

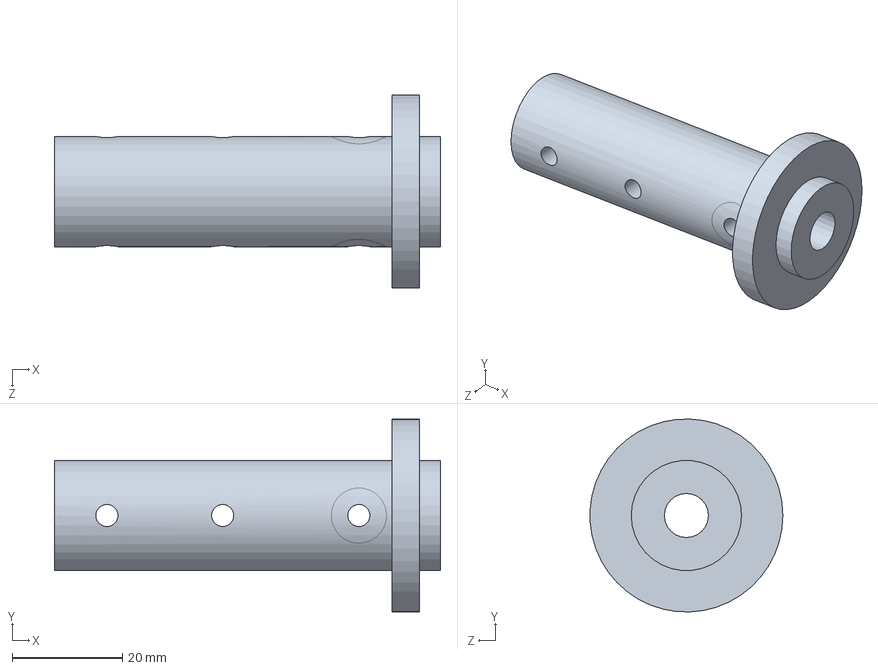
[picture p159: CAD file, 2023-05-24]
Deler til maskinering/AkslingTorsjonOverarm/AkslingTorsjonOverarm.SLDPRT
70.0 x 35.0 x 35.0 mm
