DAwesomEL/BachelorProsjekt/Deler til maskinering/ElbowWormGear/ElbowWormGear.SLDPRT

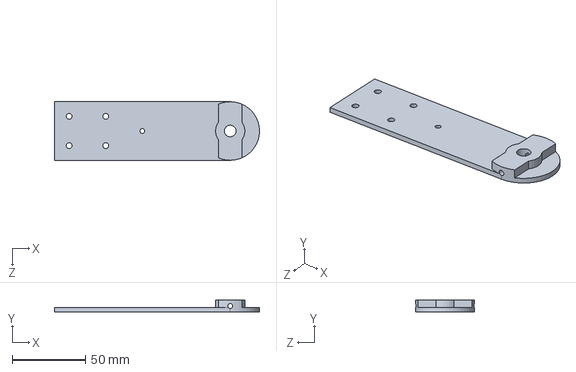
[picture p160: CAD file, 2023-04-26]
Deler til maskinering/ElbowWormGear/ElbowWormGear.SLDPRT
140.0 x 8.00 x 40.0 mm
