DAwesomEL/BachelorProsjekt/Deler til maskinering/Monteringsplate/MonteringsplateLeftFinal.SLDPRT

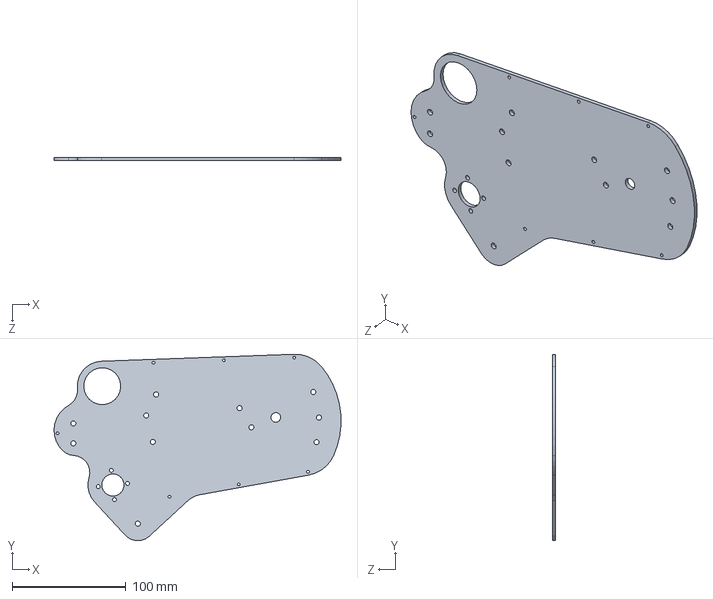
[picture p161: CAD file, 2023-04-26]
Deler til maskinering/Monteringsplate/MonteringsplateLeftFinal.SLDPRT
252.7 x 164.2 x 3.00 mm
