DAwesomEL/BachelorProsjekt/FastSkulder/gamle gir/krageGirStor_mod08tooth56.SLDPRT

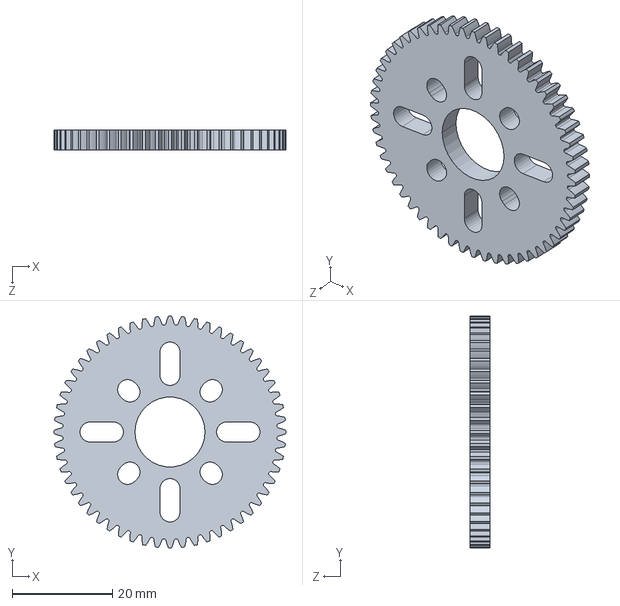
[picture p163: CAD file, 2023-02-21]
FastSkulder/gamle gir/krageGirStor_mod08tooth56.SLDPRT
46.4 x 46.4 x 4.00 mm
