DAwesomEL/BachelorProsjekt/FastSkulderMotorBak/idler_09_4.SLDPRT

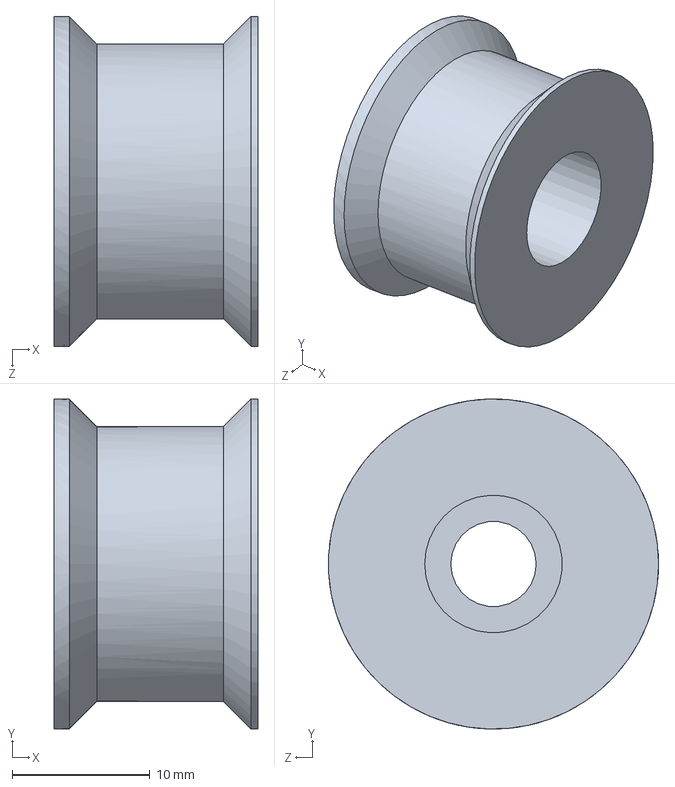
[picture p164: CAD file, 2023-03-06]
FastSkulderMotorBak/idler_09_4.SLDPRT
14.8 x 24.0 x 24.0 mm
