DAwesomEL/BachelorProsjekt/FastSkulderNy/BracketBottom.SLDPRT

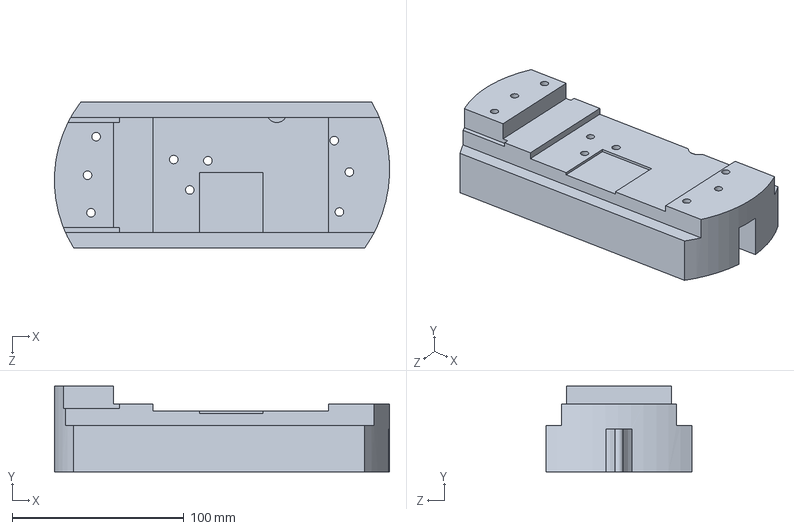
[picture p165: CAD file, 2023-02-21]
FastSkulderNy/BracketBottom.SLDPRT
194.8 x 50.0 x 85.0 mm
