DAwesomEL/BachelorProsjekt/FastSkulderNy/gamle gir/80toothmod08 Cut.SLDPRT

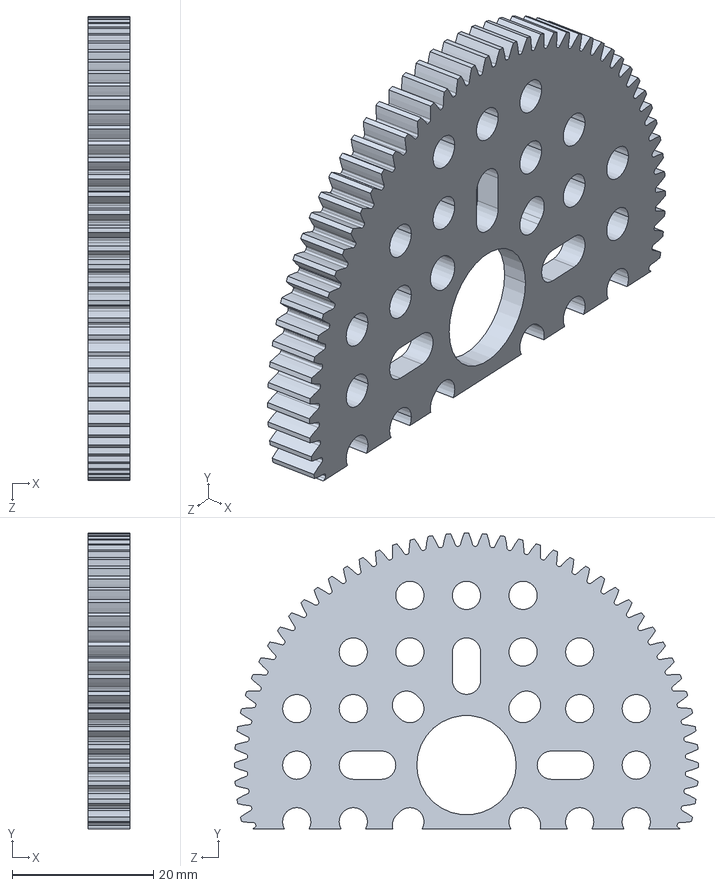
[picture p166: CAD file, 2023-02-21]
FastSkulderNy/gamle gir/80toothmod08 Cut.SLDPRT
6.00 x 41.8 x 65.6 mm
