DAwesomEL/BachelorProsjekt/Gammel Arbeidstegninger/BracketBottom/BracketBottomCutSpacer.SLDPRT

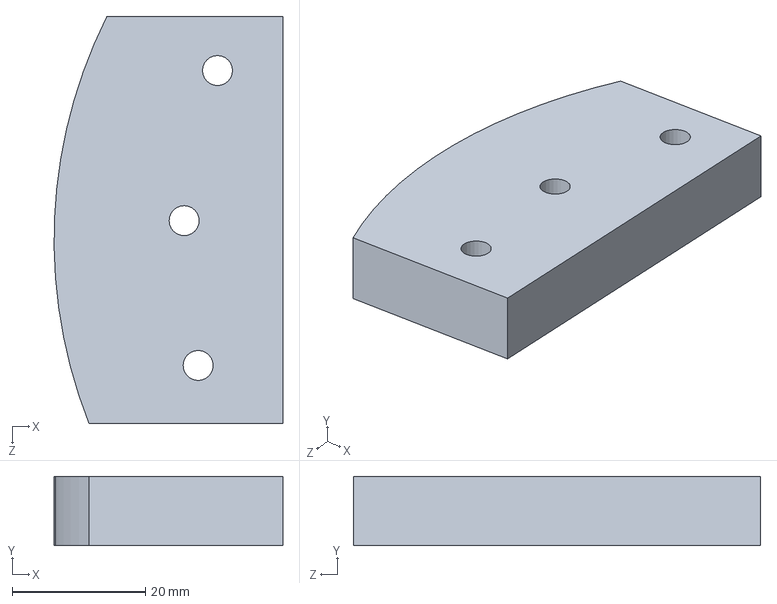
[picture p167: CAD file, 2023-04-13]
Gammel Arbeidstegninger/BracketBottom/BracketBottomCutSpacer.SLDPRT
34.3 x 10.4 x 61.0 mm
