DAwesomEL/BachelorProsjekt/Gammel Arbeidstegninger/ThrustBearingLidOverarmSkulderside/ThrustBearingLidOverarmSkulderside.SLDPRT

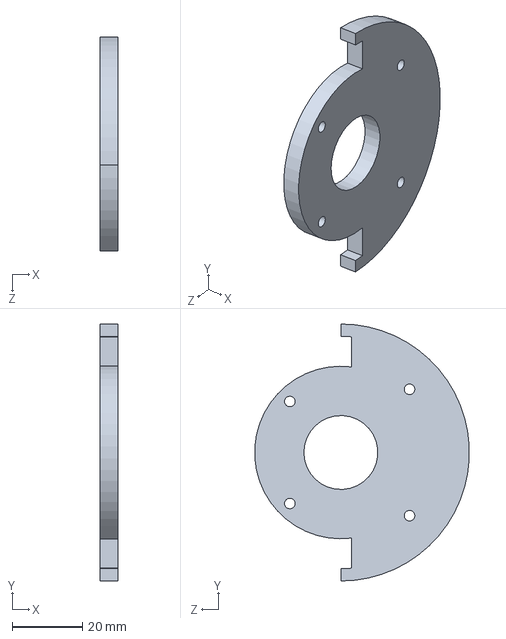
[picture p168: CAD file, 2023-04-16]
Gammel Arbeidstegninger/ThrustBearingLidOverarmSkulderside/ThrustBearingLidOverarmSkulderside.SLDPRT
5.00 x 73.0 x 60.9 mm
