DAwesomEL/BachelorProsjekt/Loomo model/stand-for-loomo-model_files/nologo_central_right.stl

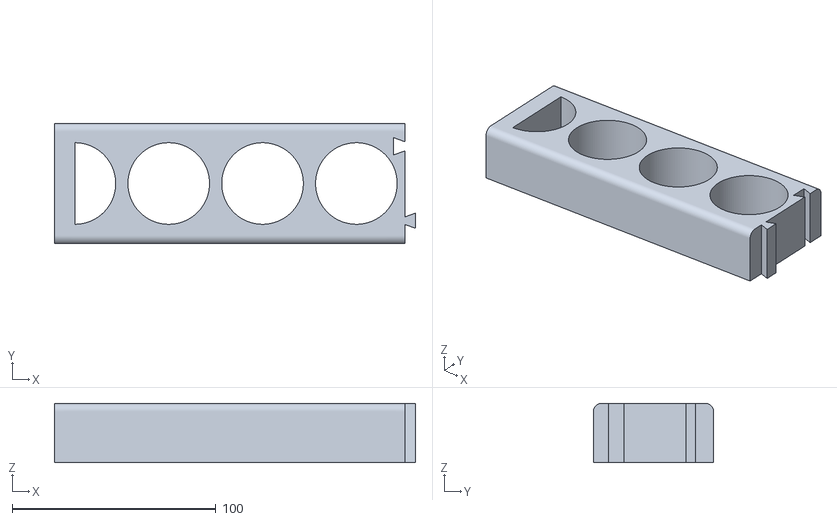
[picture p169: CAD file, 2023-02-21]
Loomo model/stand-for-loomo-model_files/nologo_central_right.stl
177.0 x 59.0 x 29.0
