DAwesomEL/BachelorProsjekt/Markeforge/Akslingsupport.SLDPRT

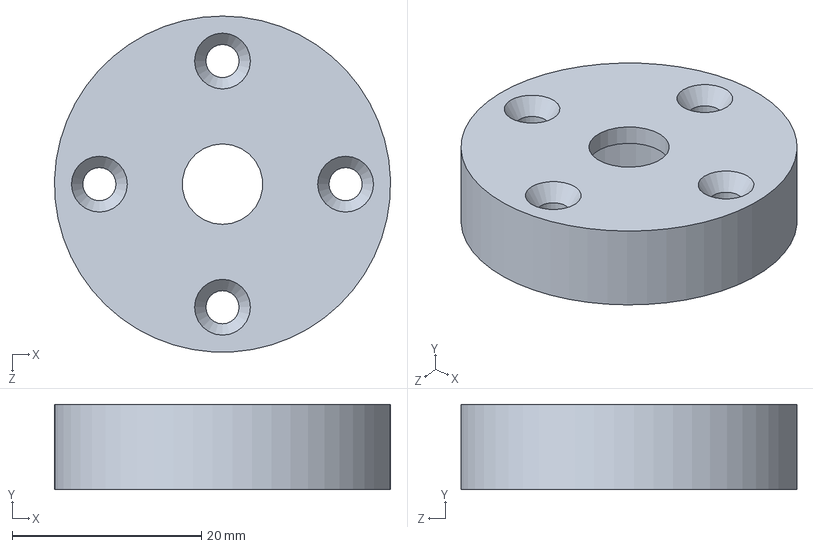
[picture p170: CAD file, 2023-04-19]
Markeforge/Akslingsupport.SLDPRT
35.5 x 9.00 x 35.5 mm
