DAwesomEL/BachelorProsjekt/NOTES/Hylle.SLDPRT

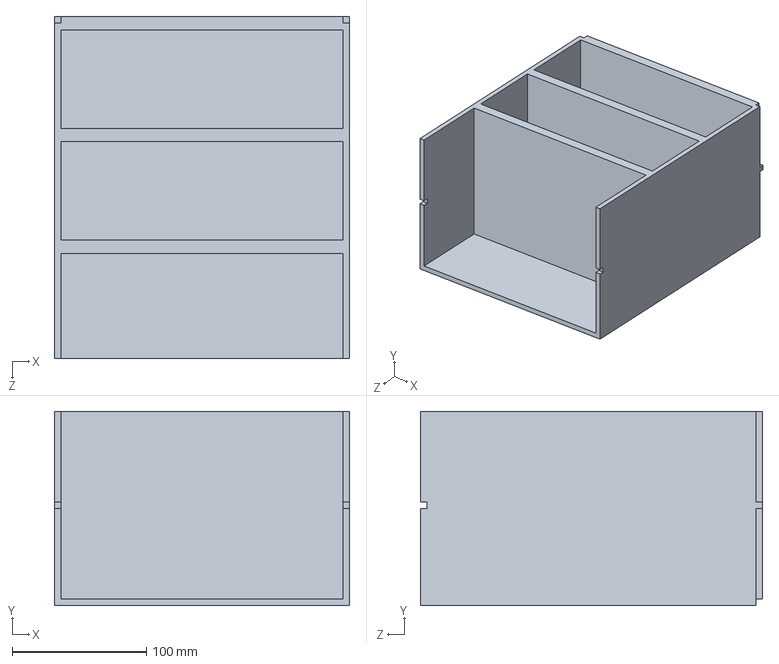
[picture p171: CAD file, 2023-04-13]
NOTES/Hylle.SLDPRT
220.0 x 145.0 x 255.0 mm
