DAwesomEL/BachelorProsjekt/STL/DekselKabelgateOrmegirYtre.STL

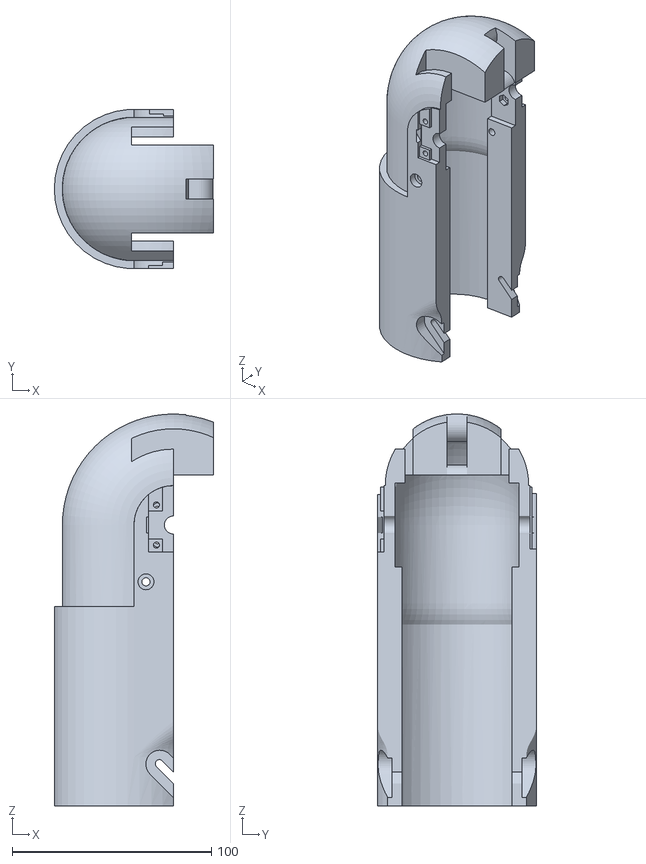
[picture p172: CAD file, 2023-05-29]
STL/DekselKabelgateOrmegirYtre.STL
80.0 x 80.0 x 196.7
