DAwesomEL/BachelorProsjekt/STL/Krageboy/Bracket.STL

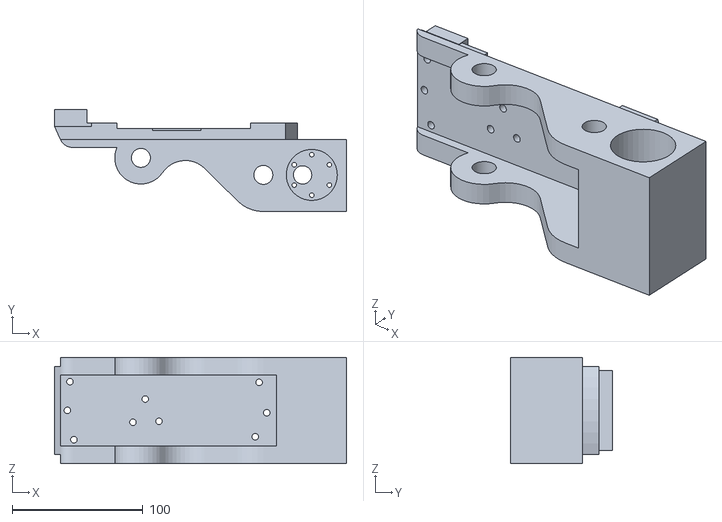
[picture p173: CAD file, 2023-05-28]
STL/Krageboy/Bracket.STL
223.0 x 78.0 x 81.0
