DAwesomEL/BachelorProsjekt/WORK/Batteripakke/BatteriCaseV3.SLDPRT

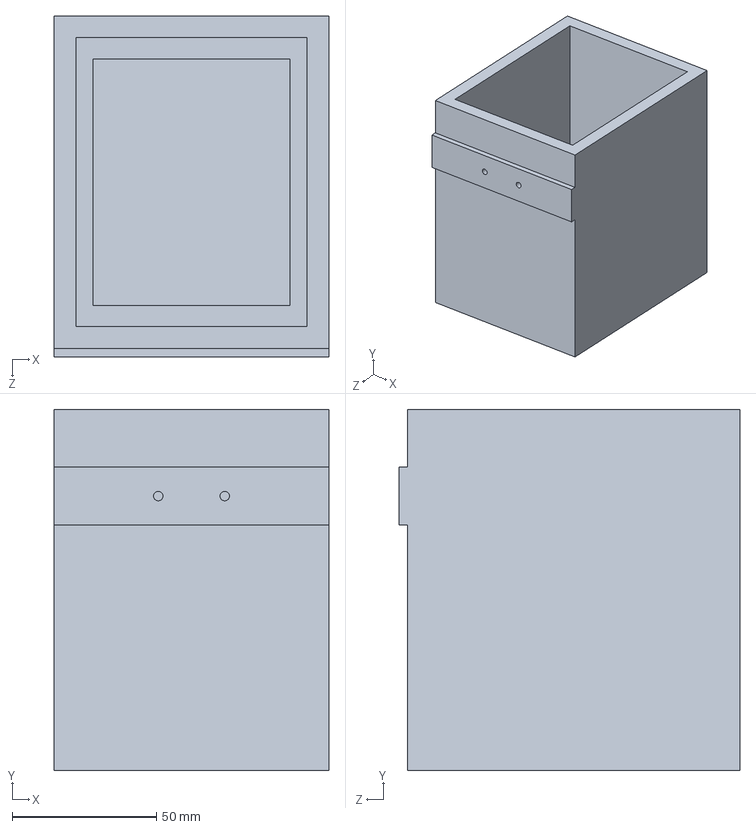
[picture p174: CAD file, 2023-05-29]
WORK/Batteripakke/BatteriCaseV3.SLDPRT
95.0 x 125.0 x 118.0 mm
