DAwesomEL/BachelorProsjekt/WORK/Elbow/DekselKabelgateOrmegir.SLDPRT

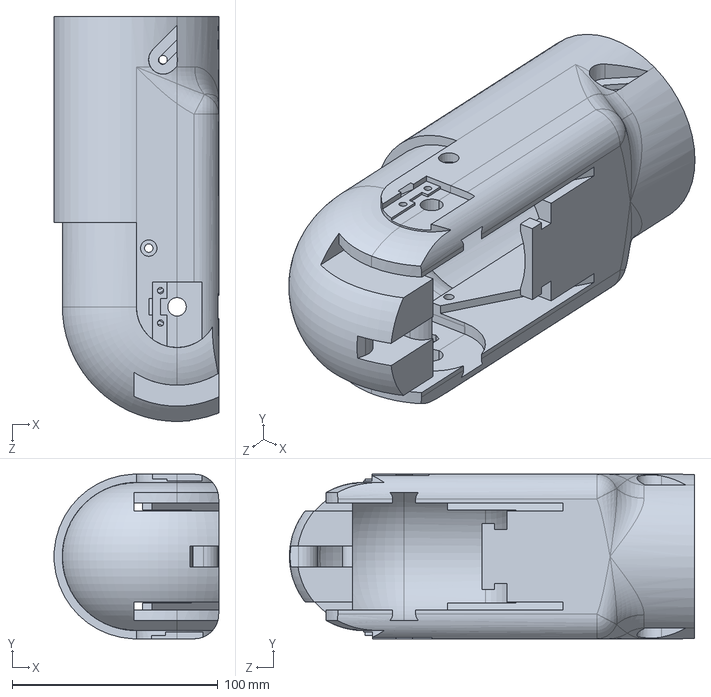
[picture p175: CAD file, 2023-05-29]
WORK/Elbow/DekselKabelgateOrmegir.SLDPRT
79.9 x 80.0 x 196.7 mm
