DAwesomEL/BachelorProsjekt/WORK/PARTS/Aluminiumsprofil/45mmLedd.SLDPRT

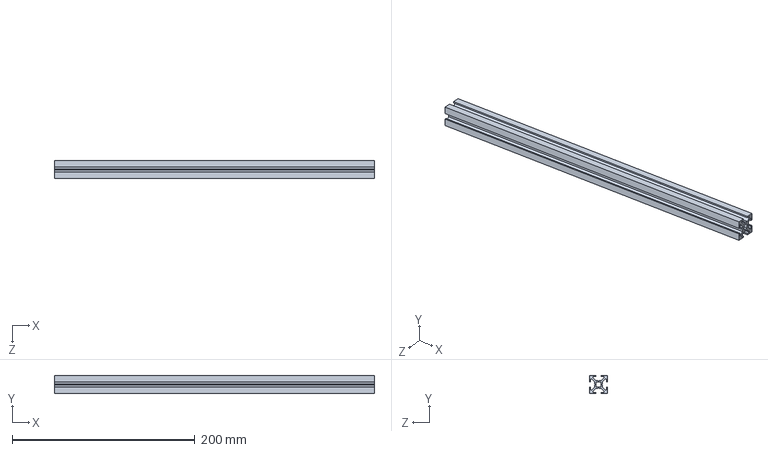
[picture p176: CAD file, 2023-02-24]
WORK/PARTS/Aluminiumsprofil/45mmLedd.SLDPRT
350.0 x 20.0 x 20.0 mm
