DAwesomEL/BachelorProsjekt/WORK/PARTS/Bearing/Thrust203504.SLDPRT

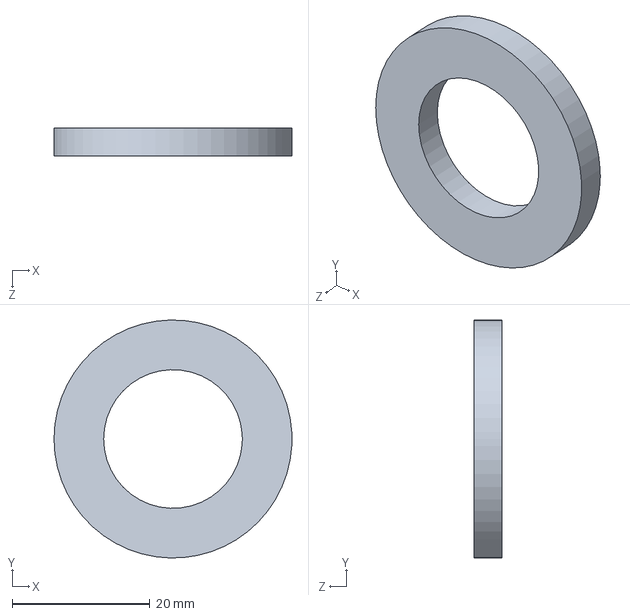
[picture p177: CAD file, 2023-05-28]
WORK/PARTS/Bearing/Thrust203504.SLDPRT
34.5 x 34.5 x 4.00 mm
