DAwesomEL/BachelorProsjekt/WORK/PARTS/Belt/Gir/pulley_40_5m__09_10.sldprt

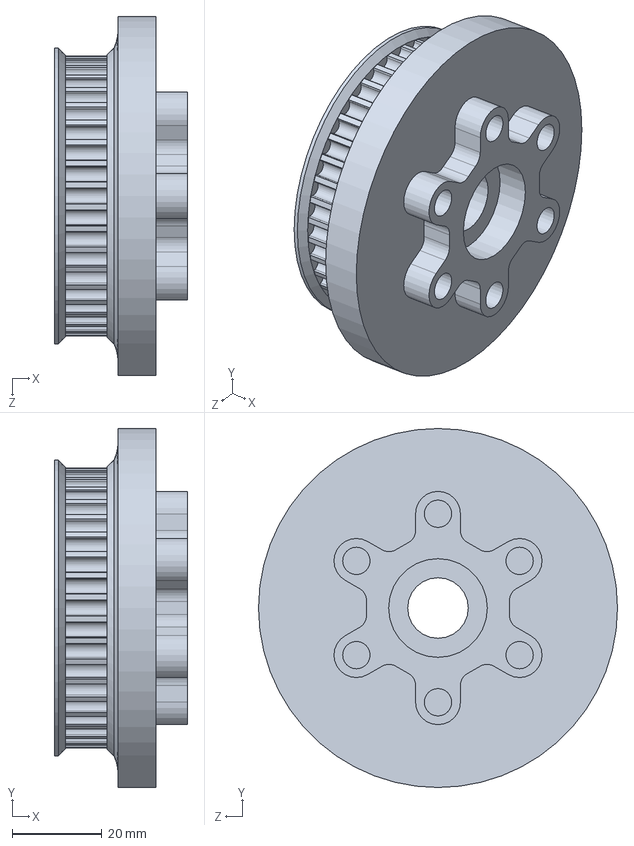
[picture p178: CAD file, 2023-05-16]
WORK/PARTS/Belt/Gir/pulley_40_5m__09_10.sldprt
29.7 x 80.0 x 80.0 mm
