DAwesomEL/BachelorProsjekt/WORK/PARTS/Motor/31mm360WormMotor.SLDPRT

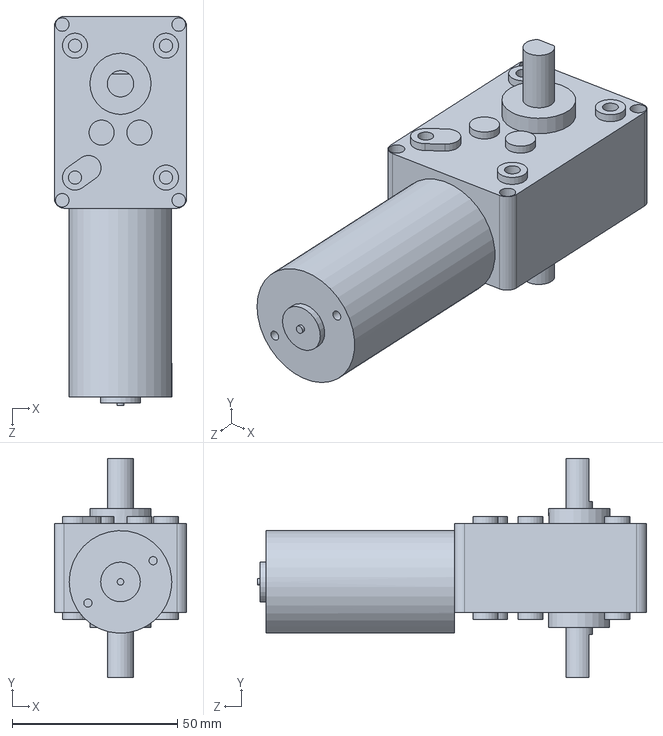
[picture p179: CAD file, 2023-04-18]
WORK/PARTS/Motor/31mm360WormMotor.SLDPRT
40.0 x 66.2 x 117.6 mm
