DAwesomEL/BachelorProsjekt/WORK/PARTS/Sensors/Magnetisk Abs Enkoder AS5600.SLDPRT

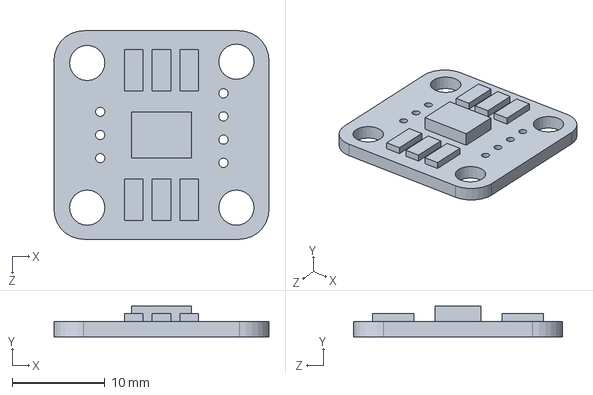
[picture p180: CAD file, 2023-04-21]
WORK/PARTS/Sensors/Magnetisk Abs Enkoder AS5600.SLDPRT
23.2 x 3.30 x 22.5 mm
