DAwesomEL/BachelorProsjekt/WORK/Skulderledd/Skulder.SLDPRT

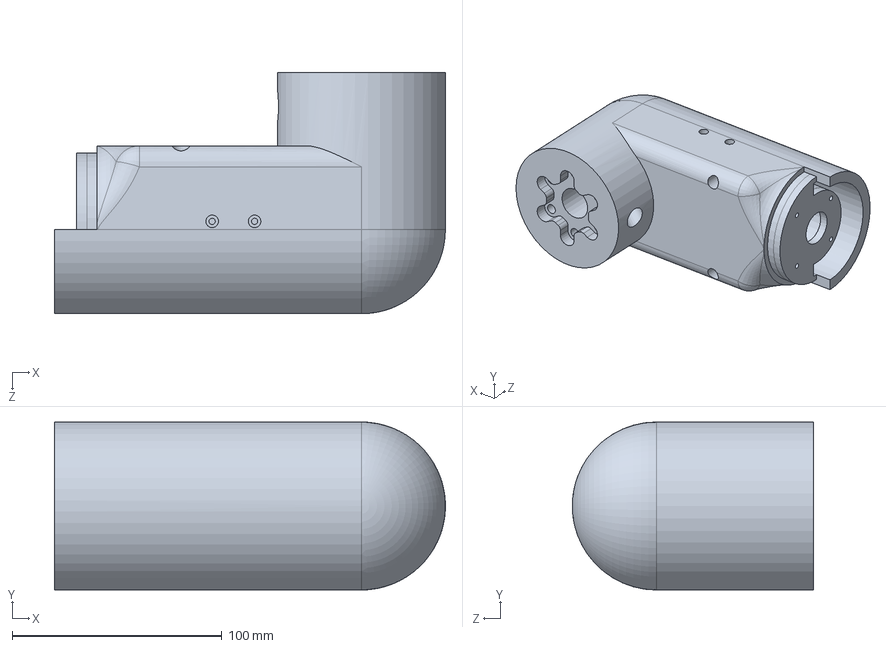
[picture p181: CAD file, 2023-05-28]
WORK/Skulderledd/Skulder.SLDPRT
186.2 x 80.0 x 115.0 mm
