DAwesomEL/BachelorProsjekt/WORK/Testing/Skuldertest.SLDPRT

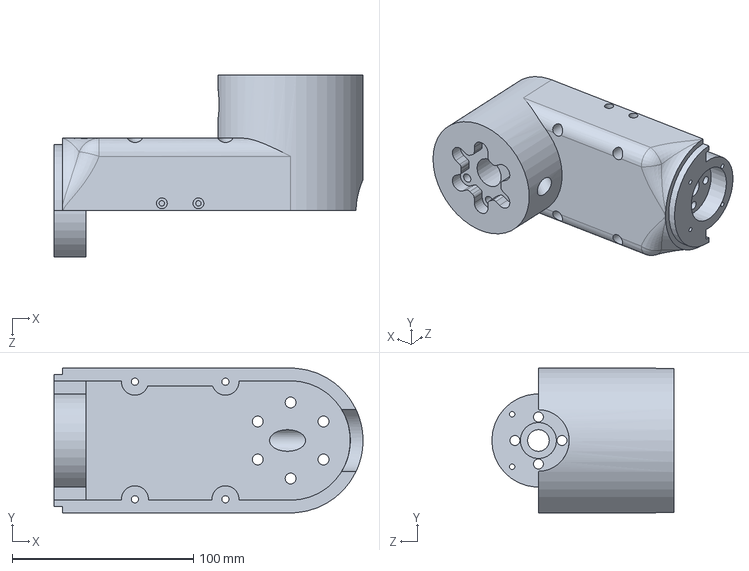
[picture p182: CAD file, 2023-05-04]
WORK/Testing/Skuldertest.SLDPRT
170.7 x 80.0 x 100.8 mm
