DAwesomEL/BachelorProsjekt/Deler til maskinering/SkulderAkslingsbrakett/PulleyStrammerLidRight.SLDPRT

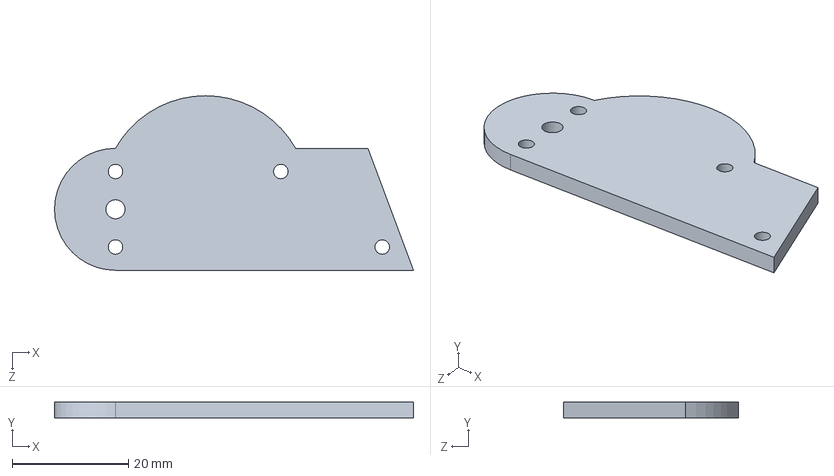
[picture p183: CAD file, 2023-05-16]
Deler til maskinering/SkulderAkslingsbrakett/PulleyStrammerLidRight.SLDPRT
61.8 x 2.75 x 30.1 mm
