DAwesomEL/BachelorProsjekt/Deler til maskinering/TorsjonOverarmMotorBrakett/TorsjonOverarmMotorBrakettMotorside.SLDPRT

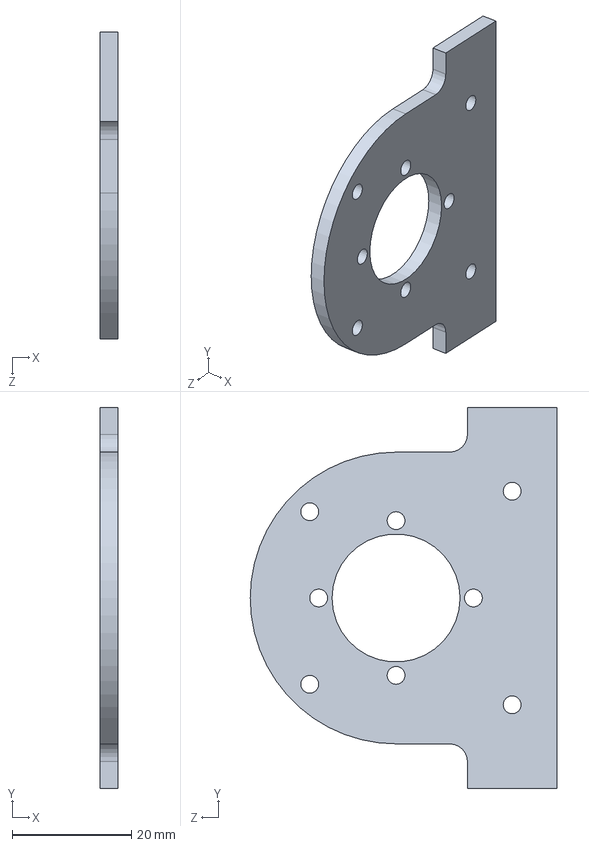
[picture p184: CAD file, 2023-05-16]
Deler til maskinering/TorsjonOverarmMotorBrakett/TorsjonOverarmMotorBrakettMotorside.SLDPRT
3.00 x 64.0 x 51.5 mm
