DAwesomEL/BachelorProsjekt/FastSkulder/gamle gir/krageGirStor_mod08tooth60.SLDPRT

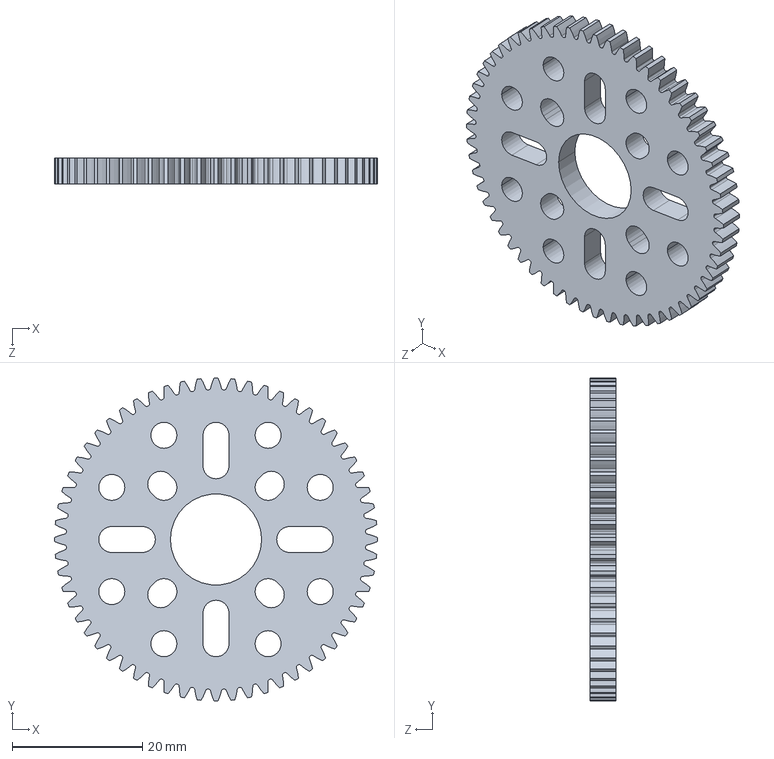
[picture p185: CAD file, 2023-02-21]
FastSkulder/gamle gir/krageGirStor_mod08tooth60.SLDPRT
49.6 x 49.6 x 4.00 mm
