DAwesomEL/BachelorProsjekt/FastSkulder/IdlerSlider.SLDPRT

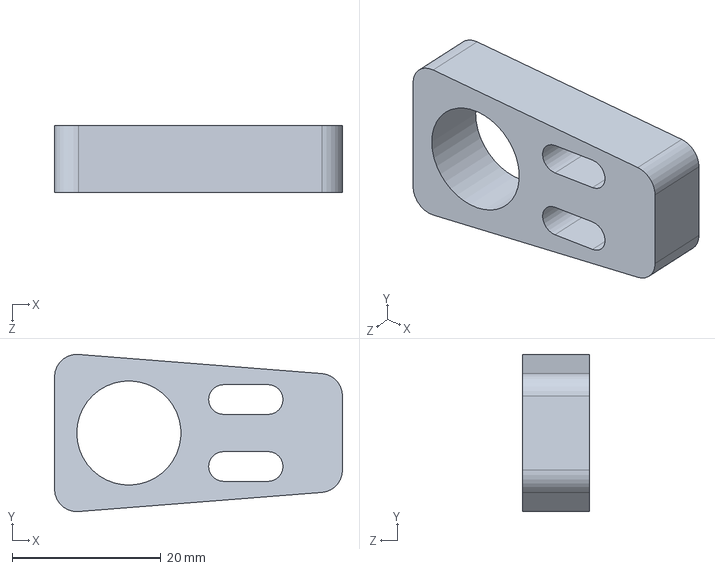
[picture p186: CAD file, 2023-02-21]
FastSkulder/IdlerSlider.SLDPRT
38.7 x 21.1 x 9.00 mm
