DAwesomEL/BachelorProsjekt/FastSkulderMotorBak/idler_09_6.sldprt

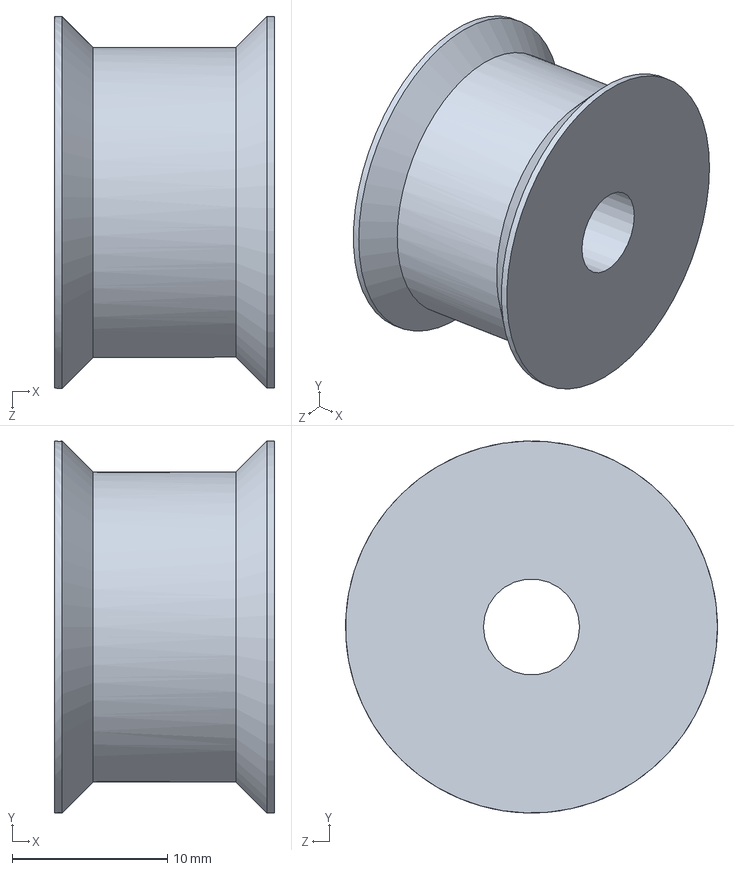
[picture p187: CAD file, 2023-03-06]
FastSkulderMotorBak/idler_09_6.sldprt
14.2 x 24.0 x 24.0 mm
