DAwesomEL/BachelorProsjekt/FastSkulderNy/pulley_12_5m__15_6.sldprt

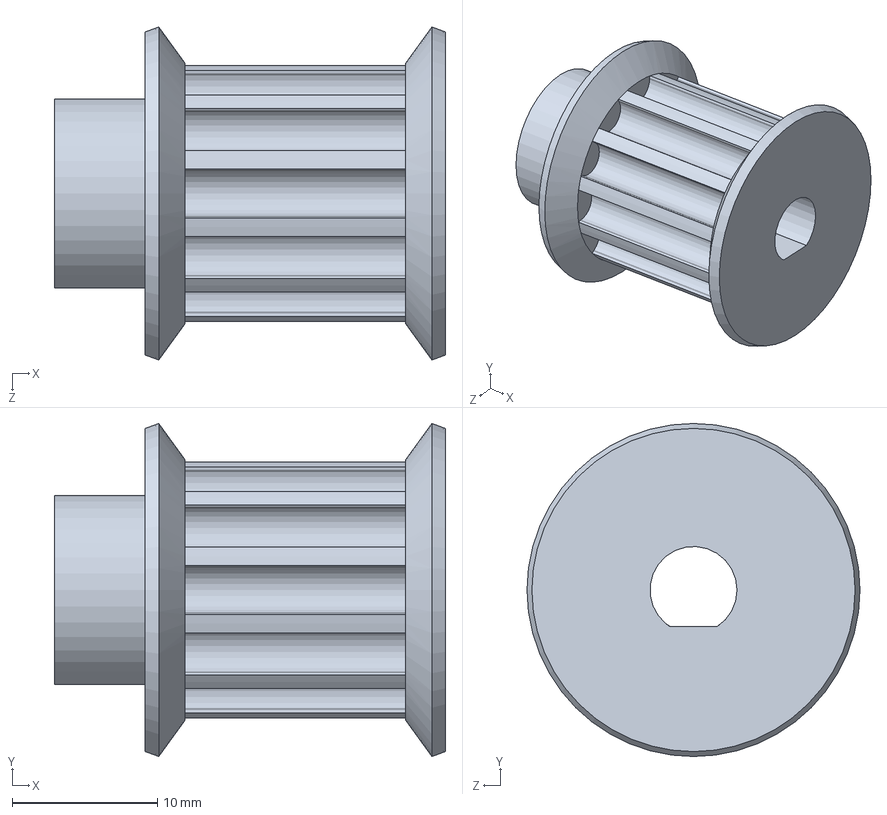
[picture p188: CAD file, 2023-02-21]
FastSkulderNy/pulley_12_5m__15_6.sldprt
27.0 x 23.0 x 23.0 mm
