DAwesomEL/BachelorProsjekt/Gammel Arbeidstegninger/BracketBottom/BracketBottomRightLow.SLDPRT

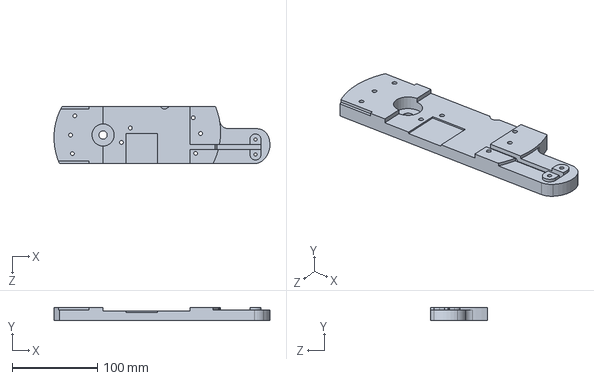
[picture p189: CAD file, 2023-04-13]
Gammel Arbeidstegninger/BracketBottom/BracketBottomRightLow.SLDPRT
252.7 x 15.0 x 67.0 mm
