DAwesomEL/BachelorProsjekt/Kragemekanisme/Arm.SLDPRT

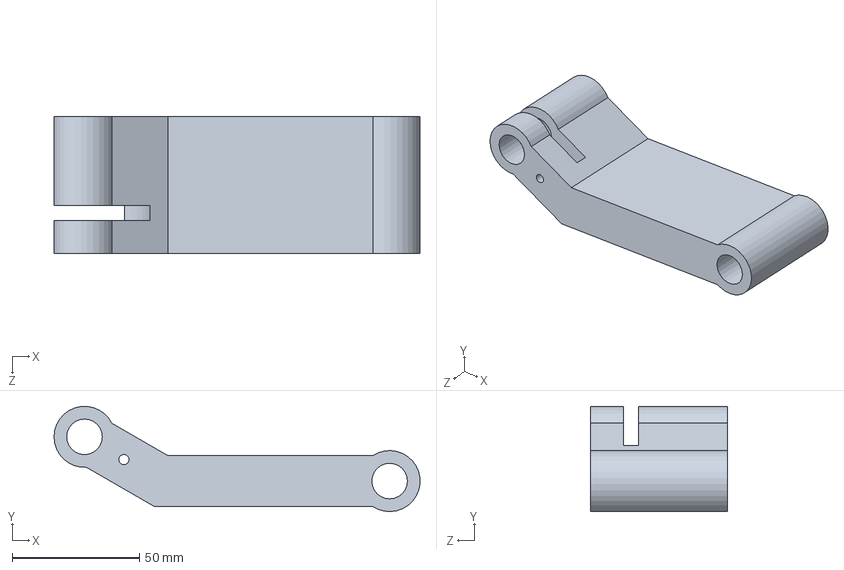
[picture p190: CAD file, 2023-02-21]
Kragemekanisme/Arm.SLDPRT
143.9 x 41.4 x 54.0 mm
