DAwesomEL/BachelorProsjekt/Loomo model/Loomo Body.SLDPRT

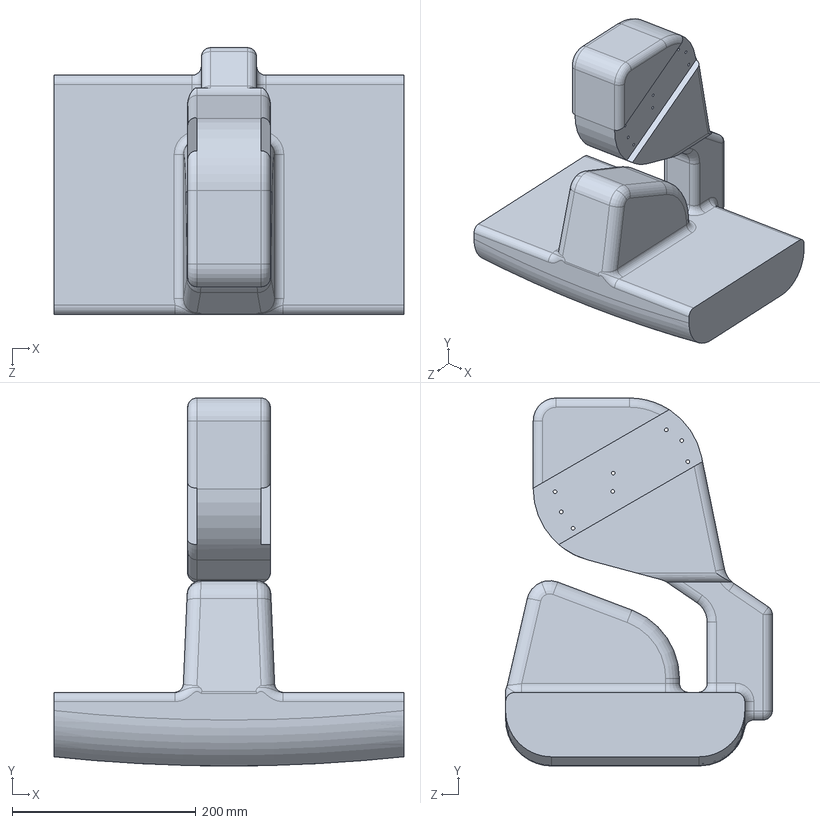
[picture p191: CAD file, 2023-05-13]
Loomo model/Loomo Body.SLDPRT
380.0 x 400.0 x 290.0 mm
