DAwesomEL/BachelorProsjekt/Loomo model/stand-for-loomo-model_files/loomo.stl

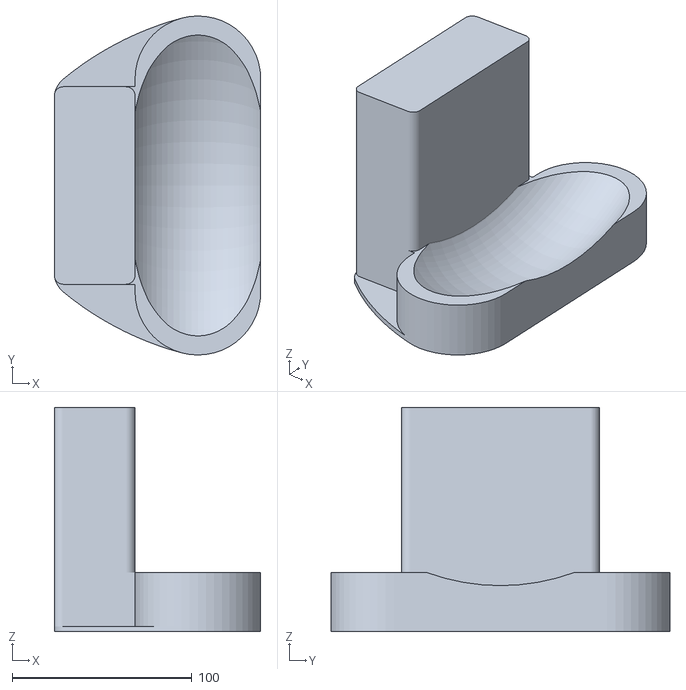
[picture p192: CAD file, 2023-02-21]
Loomo model/stand-for-loomo-model_files/loomo.stl
115.0 x 188.8 x 125.0
