DAwesomEL/BachelorProsjekt/Markeforge/AlbueMotorBrakett.SLDPRT

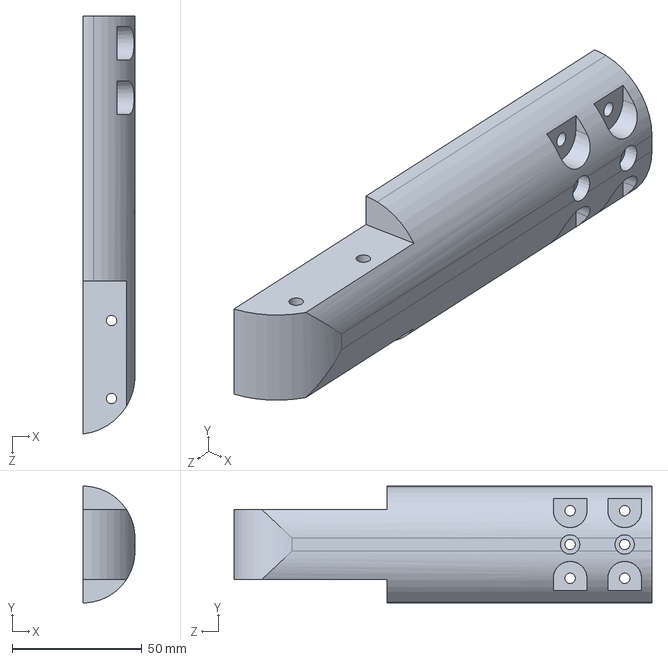
[picture p193: CAD file, 2023-04-19]
Markeforge/AlbueMotorBrakett.SLDPRT
20.0 x 45.0 x 160.9 mm
