DAwesomEL/BachelorProsjekt/plate tester/HullplateTEST.SLDPRT

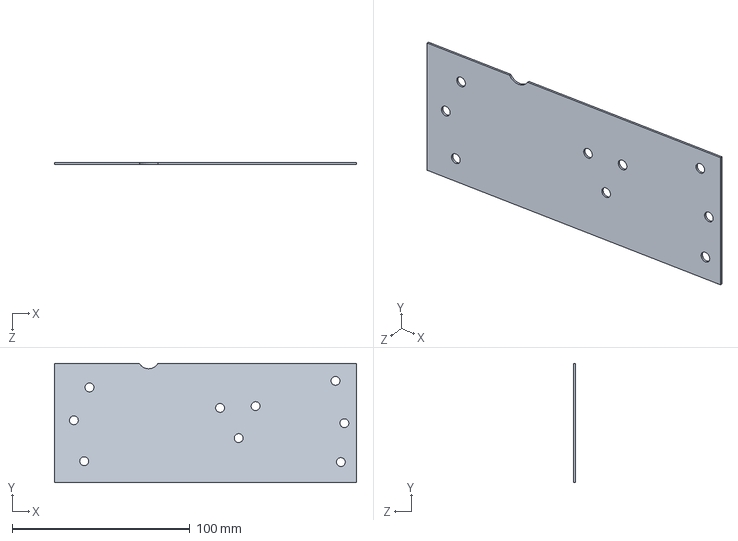
[picture p194: CAD file, 2023-02-21]
plate tester/HullplateTEST.SLDPRT
170.0 x 67.0 x 1.00 mm
