DAwesomEL/BachelorProsjekt/STL/DekselKabelgateOrmegirIndre.STL

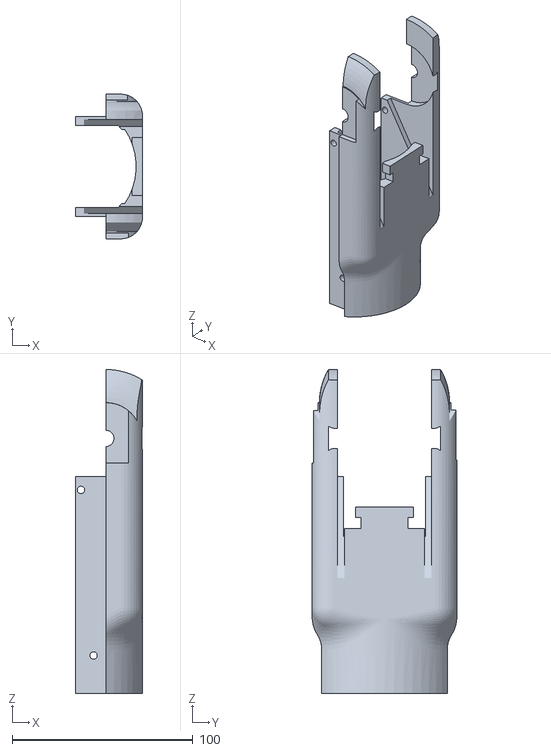
[picture p195: CAD file, 2023-05-29]
STL/DekselKabelgateOrmegirIndre.STL
37.0 x 80.0 x 179.1
