DAwesomEL/BachelorProsjekt/STL/Krageboy/Arm.STL

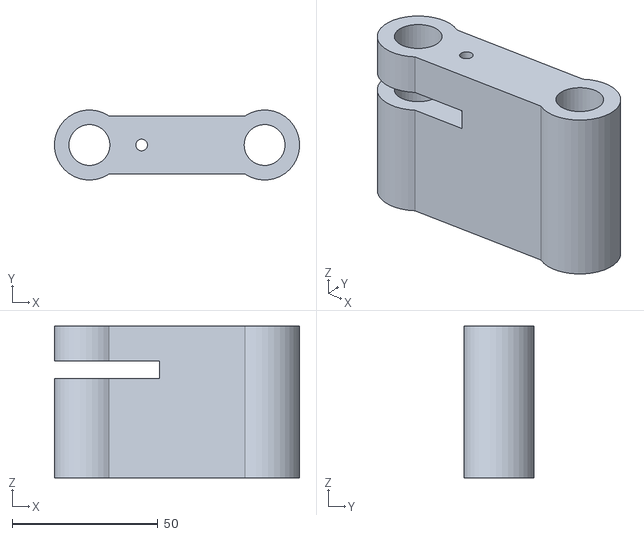
[picture p196: CAD file, 2023-05-28]
STL/Krageboy/Arm.STL
83.9 x 23.9 x 52.0
