DAwesomEL/BachelorProsjekt/WORK/ASSEMBLY/BelteDekselLeft/BelteDekselLeftHigh.SLDPRT

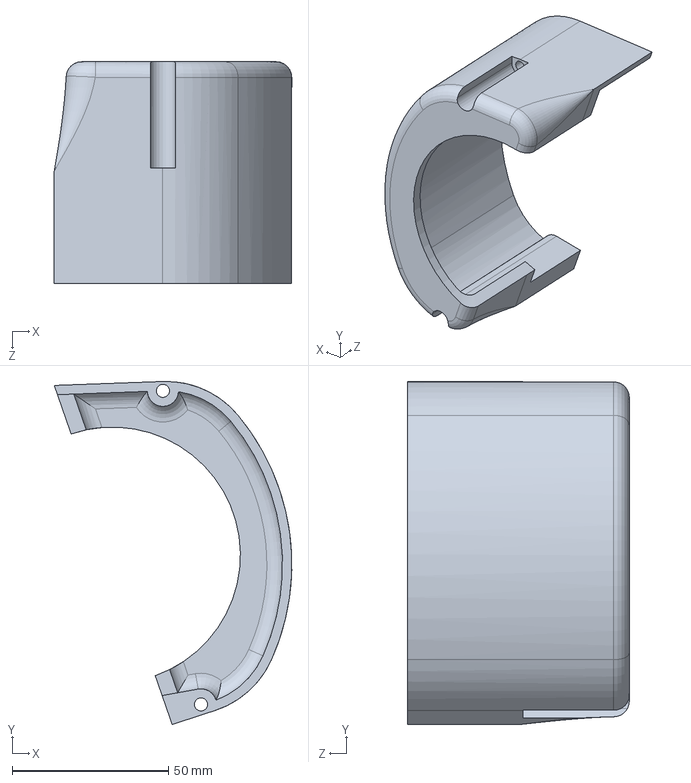
[picture p197: CAD file, 2023-05-28]
WORK/ASSEMBLY/BelteDekselLeft/BelteDekselLeftHigh.SLDPRT
76.1 x 109.9 x 71.0 mm
