DAwesomEL/BachelorProsjekt/WORK/ASSEMBLY/BelteDekselRight/BelteDekselRightHigh.SLDPRT

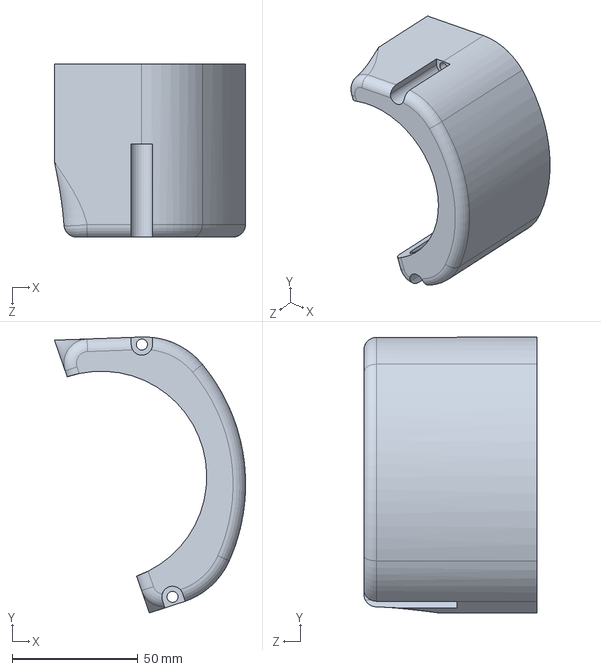
[picture p198: CAD file, 2023-05-28]
WORK/ASSEMBLY/BelteDekselRight/BelteDekselRightHigh.SLDPRT
76.1 x 109.9 x 69.0 mm
