DAwesomEL/BachelorProsjekt/WORK/ASSEMBLY/DekselForBelte.SLDPRT

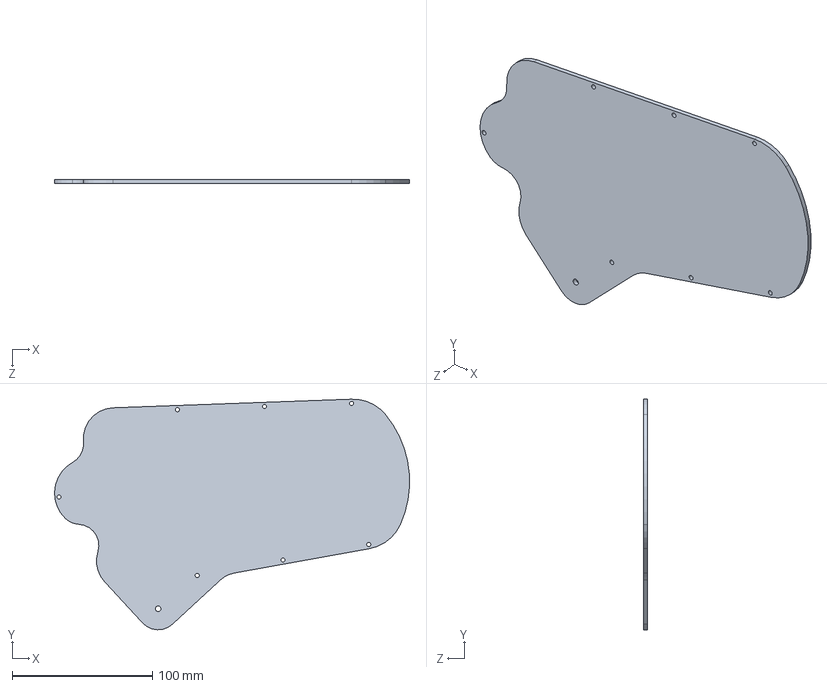
[picture p199: CAD file, 2023-05-13]
WORK/ASSEMBLY/DekselForBelte.SLDPRT
252.7 x 164.2 x 3.00 mm
