DAwesomEL/BachelorProsjekt/WORK/Batteripakke/BMSV2.SLDPRT

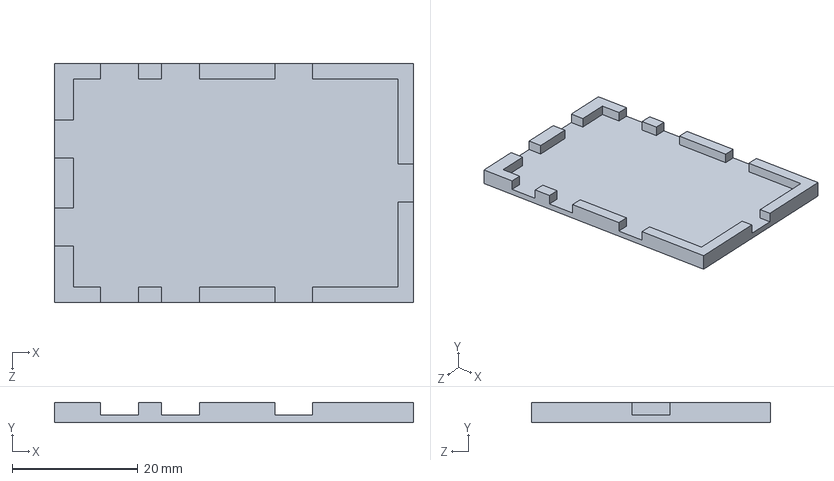
[picture p200: CAD file, 2023-05-28]
WORK/Batteripakke/BMSV2.SLDPRT
57.0 x 3.20 x 38.0 mm
