DAwesomEL/BachelorProsjekt/WORK/LeftShoulder/BracketBottomLeft.SLDPRT

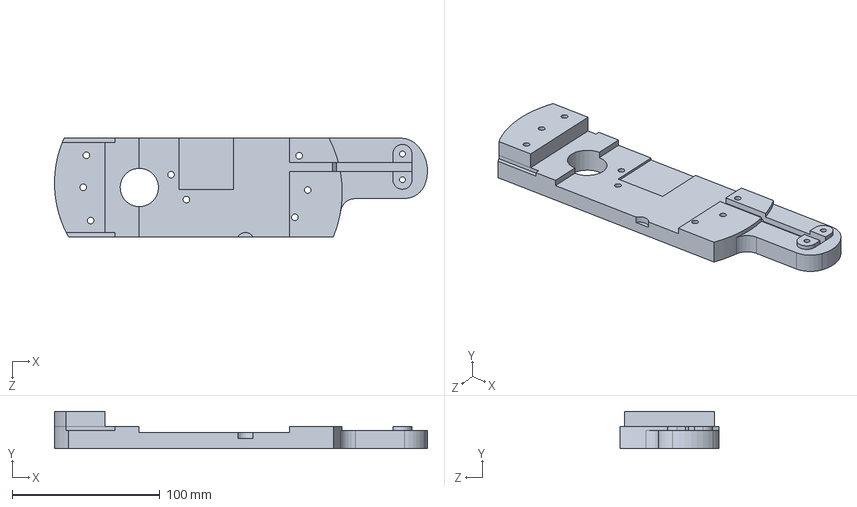
[picture p201: CAD file, 2023-05-24]
WORK/LeftShoulder/BracketBottomLeft.SLDPRT
252.8 x 25.4 x 67.0 mm
