DAwesomEL/BachelorProsjekt/WORK/PARTS/Bearing/Thrust50mm70mm.SLDPRT

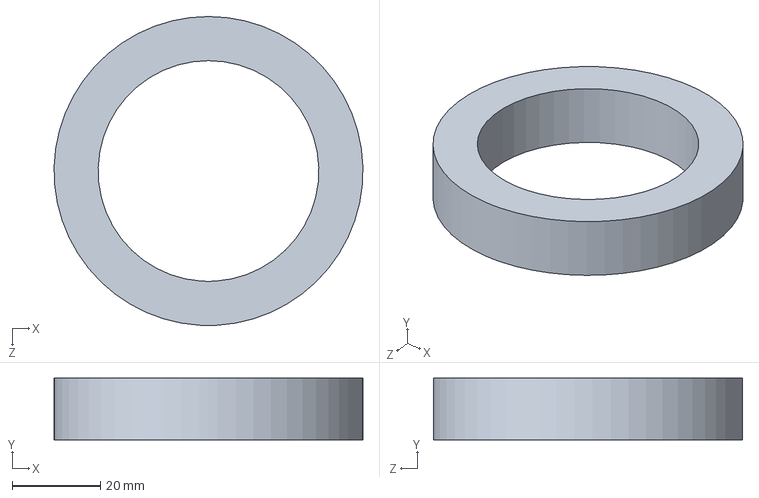
[picture p202: CAD file, 2023-02-23]
WORK/PARTS/Bearing/Thrust50mm70mm.SLDPRT
70.0 x 14.0 x 70.0 mm
