DAwesomEL/BachelorProsjekt/WORK/PARTS/Belt/Gir/pulley_20_5m__09_8.sldprt

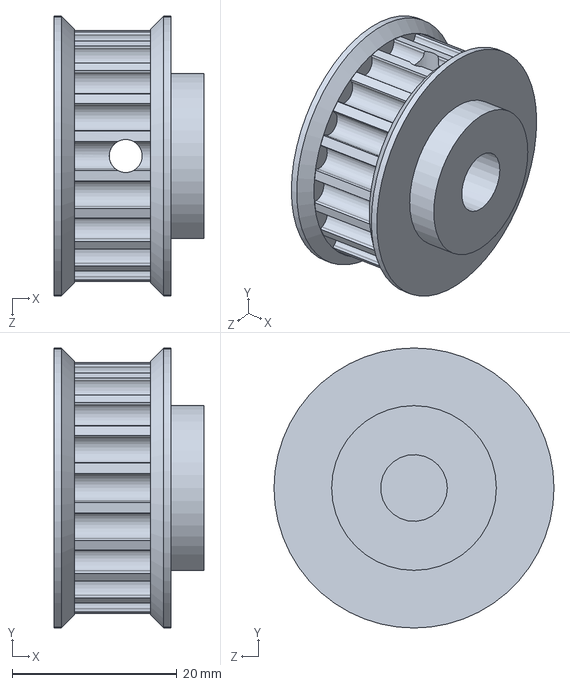
[picture p203: CAD file, 2023-05-04]
WORK/PARTS/Belt/Gir/pulley_20_5m__09_8.sldprt
18.2 x 34.0 x 34.0 mm
