DAwesomEL/BachelorProsjekt/WORK/PARTS/Motor/31mm360gMotor.sldprt

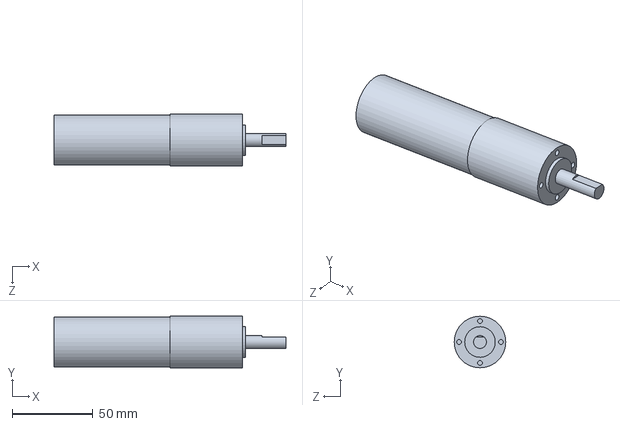
[picture p204: CAD file, 2023-04-18]
WORK/PARTS/Motor/31mm360gMotor.sldprt
144.0 x 32.0 x 32.0 mm
