DAwesomEL/BachelorProsjekt/WORK/Testing/Testplate3.SLDPRT

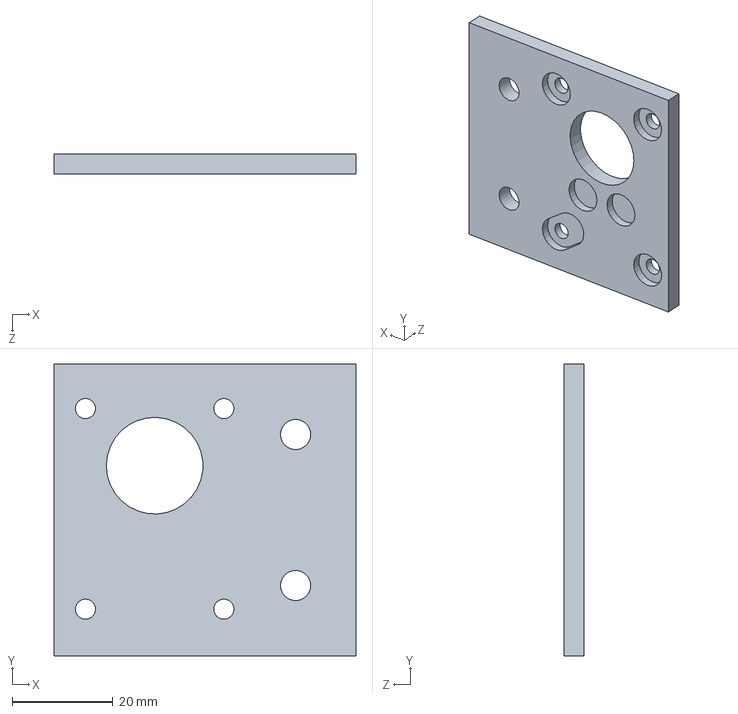
[picture p205: CAD file, 2023-03-14]
WORK/Testing/Testplate3.SLDPRT
60.0 x 58.0 x 4.00 mm
