DAwesomEL/BachelorProsjekt/Deler til maskinering/TorsjonOverarmMotorBrakett/TorsjonOverarmMotorBrakettFesteside.SLDPRT

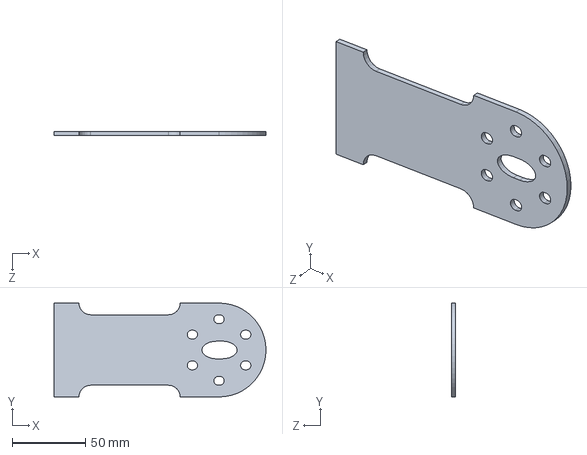
[picture p206: CAD file, 2023-05-16]
Deler til maskinering/TorsjonOverarmMotorBrakett/TorsjonOverarmMotorBrakettFesteside.SLDPRT
144.5 x 64.0 x 3.00 mm
