DAwesomEL/BachelorProsjekt/FastSkulder/gamle gir/15toothMod08.SLDPRT

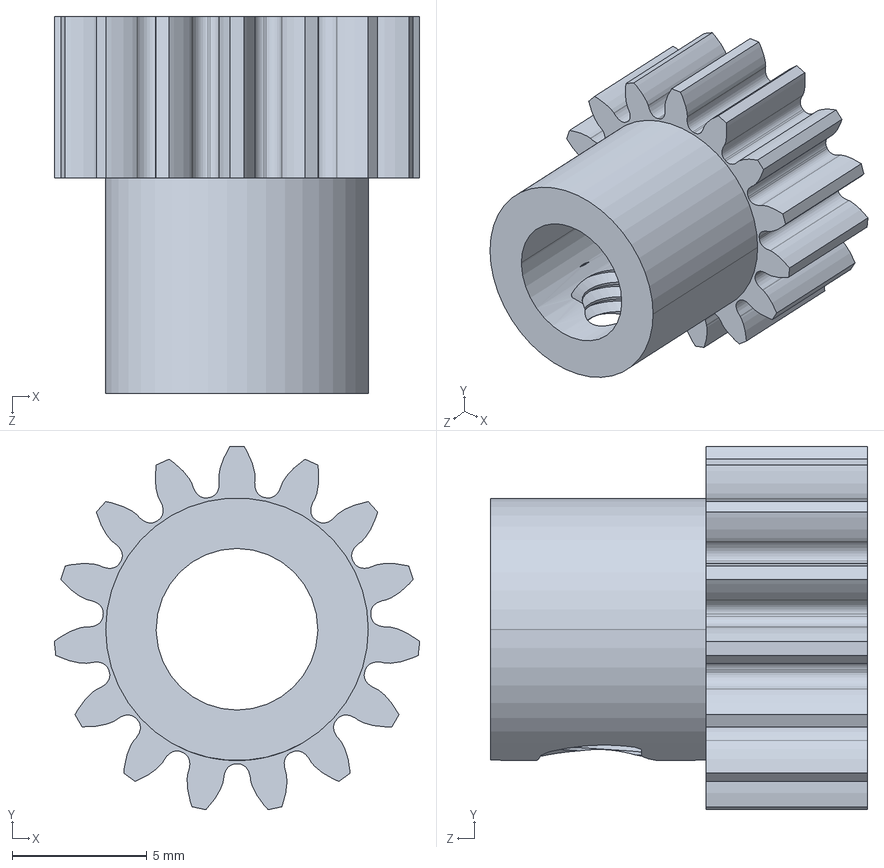
[picture p207: CAD file, 2023-02-21]
FastSkulder/gamle gir/15toothMod08.SLDPRT
13.6 x 13.5 x 14.0 mm
