DAwesomEL/BachelorProsjekt/FastSkulderMotorBak/pulley_40_5m__09_10.sldprt

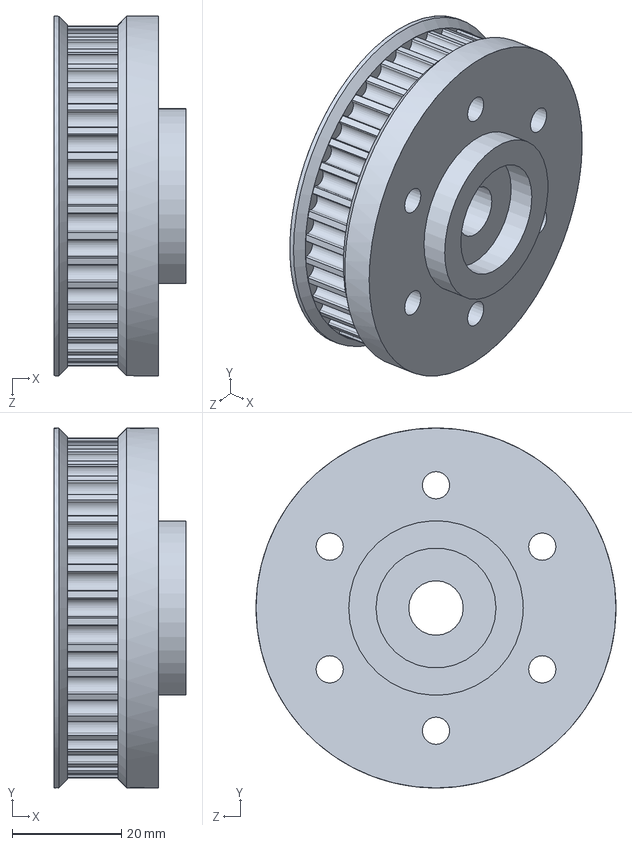
[picture p208: CAD file, 2023-02-24]
FastSkulderMotorBak/pulley_40_5m__09_10.sldprt
24.2 x 66.0 x 66.0 mm
