DAwesomEL/BachelorProsjekt/FastSkulderNy/gamle gir/80toothmod08.SLDPRT

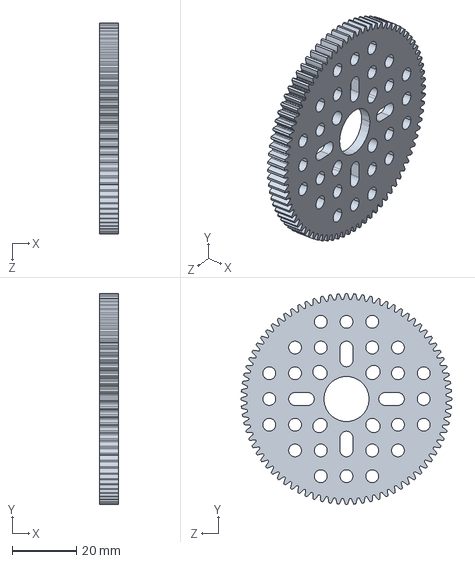
[picture p209: CAD file, 2023-02-21]
FastSkulderNy/gamle gir/80toothmod08.SLDPRT
6.00 x 65.6 x 65.6 mm
