DAwesomEL/BachelorProsjekt/Loomo model/Loomo Wheel.SLDPRT

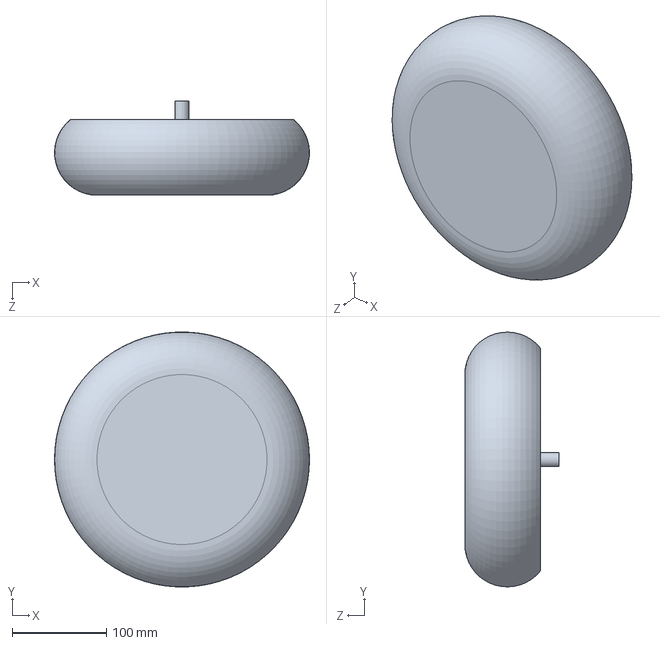
[picture p210: CAD file, 2023-04-21]
Loomo model/Loomo Wheel.SLDPRT
270.0 x 269.7 x 100.0 mm
