DAwesomEL/BachelorProsjekt/Overarm/200gMotor.SLDPRT

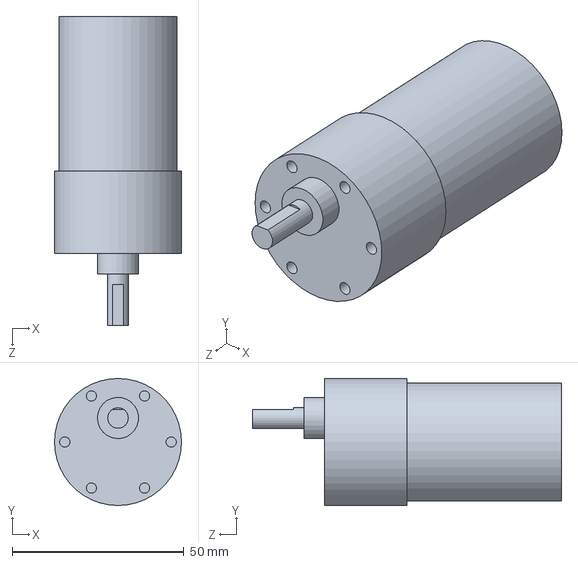
[picture p211: CAD file, 2023-02-21]
Overarm/200gMotor.SLDPRT
37.0 x 37.0 x 90.0 mm
