DAwesomEL/BachelorProsjekt/STL/Krageboy/skulderFeste.STL

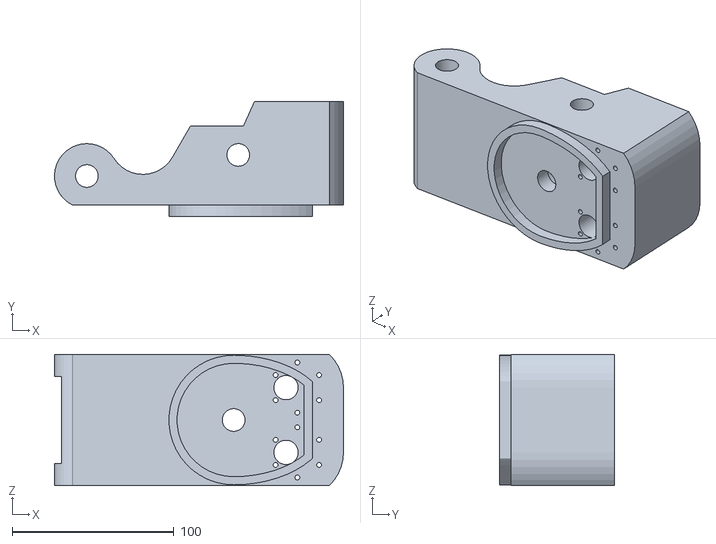
[picture p212: CAD file, 2023-05-28]
STL/Krageboy/skulderFeste.STL
178.5 x 71.0 x 81.0
