DAwesomEL/BachelorProsjekt/WORK/ASSEMBLY/BelteDekselLeft/BelteDekselLeft.SLDPRT

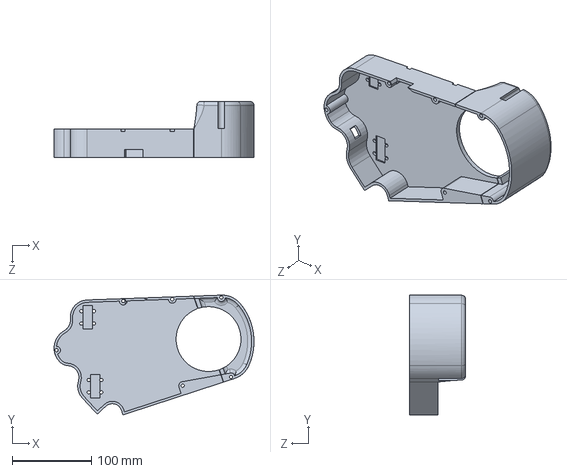
[picture p213: CAD file, 2023-05-28]
WORK/ASSEMBLY/BelteDekselLeft/BelteDekselLeft.SLDPRT
252.8 x 151.4 x 71.0 mm
