DAwesomEL/BachelorProsjekt/WORK/ASSEMBLY/BelteDekselRight/BelteDekselRight.SLDPRT

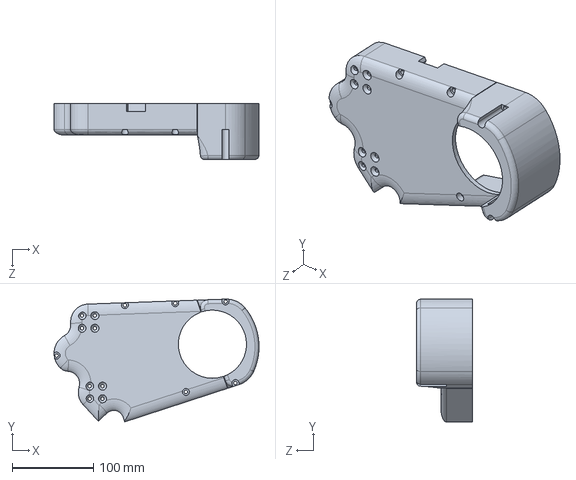
[picture p214: CAD file, 2023-05-28]
WORK/ASSEMBLY/BelteDekselRight/BelteDekselRight.SLDPRT
252.8 x 151.4 x 69.0 mm
