DAwesomEL/BachelorProsjekt/WORK/LeftShoulder/PulleyStrammerLeft.SLDPRT

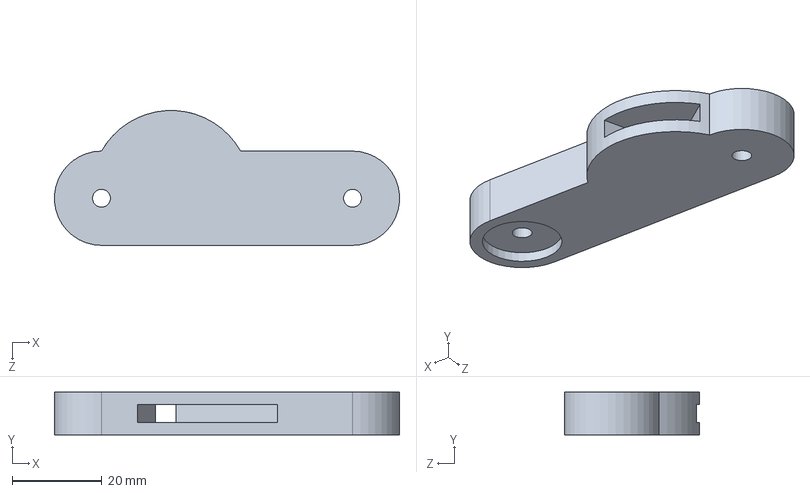
[picture p215: CAD file, 2023-04-21]
WORK/LeftShoulder/PulleyStrammerLeft.SLDPRT
76.9 x 9.50 x 30.0 mm
