DAwesomEL/BachelorProsjekt/WORK/PARTS/Belt/Gir/idler_09_4.SLDPRT

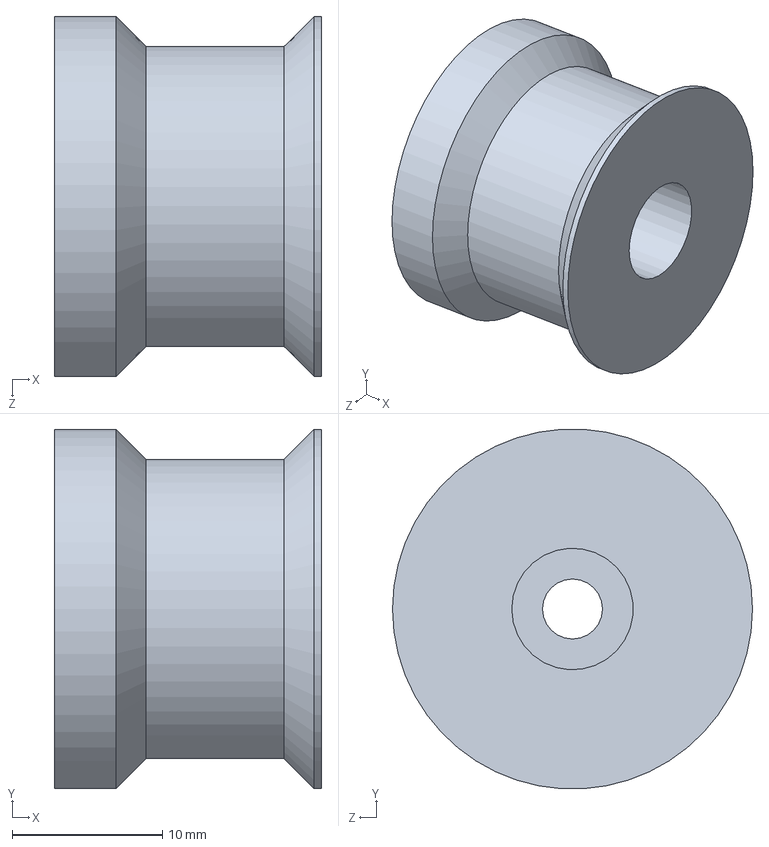
[picture p216: CAD file, 2023-04-21]
WORK/PARTS/Belt/Gir/idler_09_4.SLDPRT
17.8 x 24.0 x 24.0 mm
