DAwesomEL/BachelorProsjekt/WORK/PARTS/Motor/MotorBracket.SLDPRT

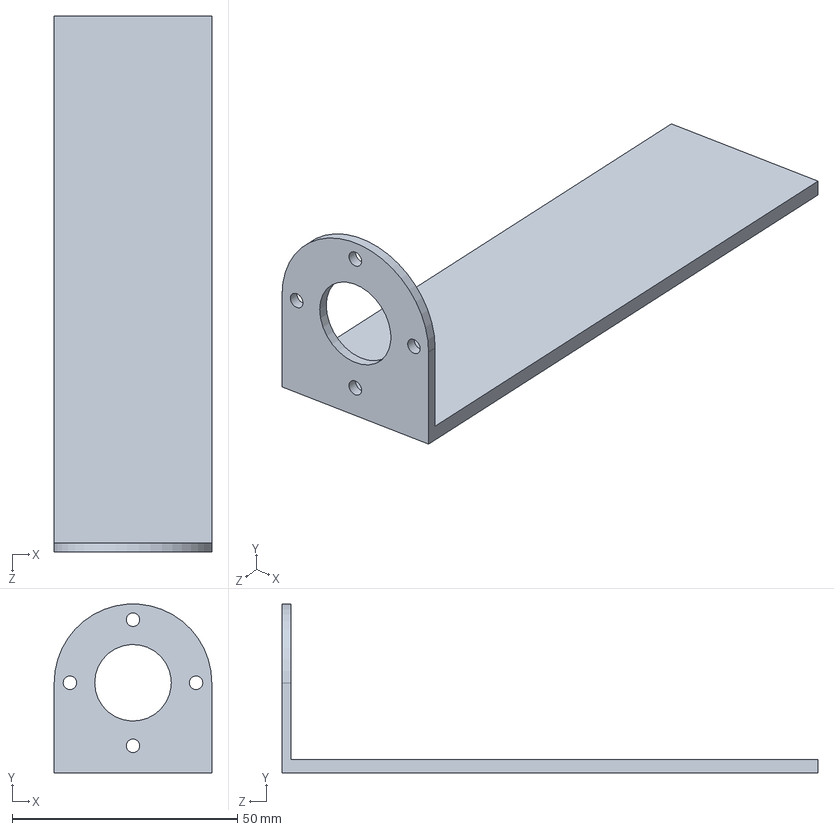
[picture p217: CAD file, 2023-02-24]
WORK/PARTS/Motor/MotorBracket.SLDPRT
35.0 x 37.5 x 119.0 mm
