DAwesomEL/BachelorProsjekt/WORK/Skulderledd/HoveddelOverarmSkulderside.SLDPRT

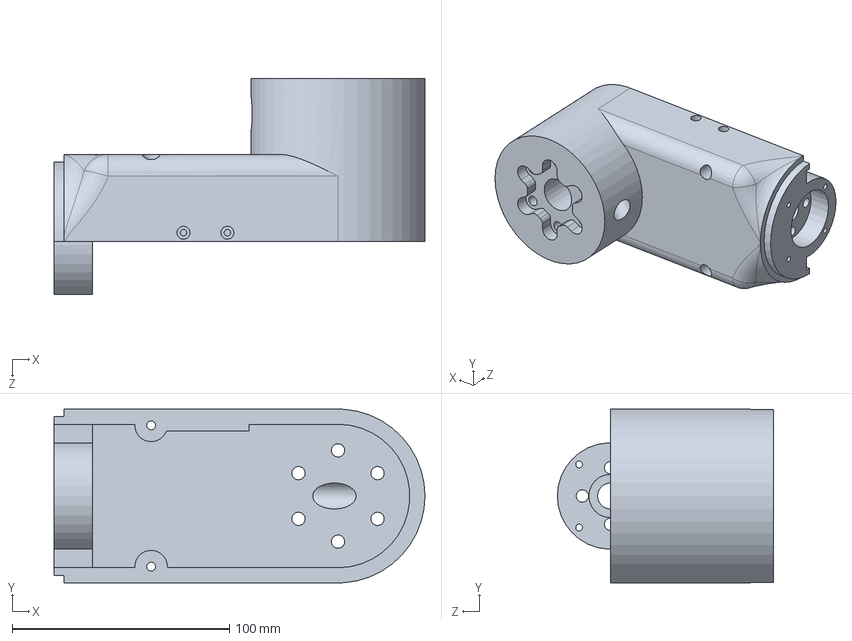
[picture p218: CAD file, 2023-05-28]
WORK/Skulderledd/HoveddelOverarmSkulderside.SLDPRT
170.7 x 80.0 x 99.5 mm
