DAwesomEL/BachelorProsjekt/WORK/Testing/Testplate2.SLDPRT

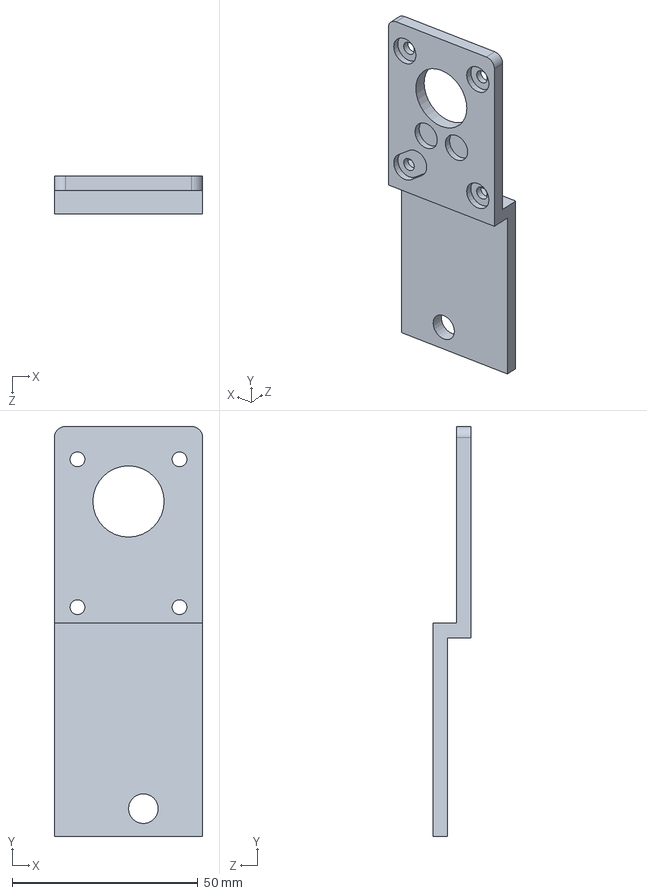
[picture p219: CAD file, 2023-03-08]
WORK/Testing/Testplate2.SLDPRT
40.0 x 110.5 x 10.3 mm
