DAwesomEL/BachelorProsjekt/Deler til maskinering/SkulderAkslingsbrakett/PulleyStrammerBottomLeft.SLDPRT

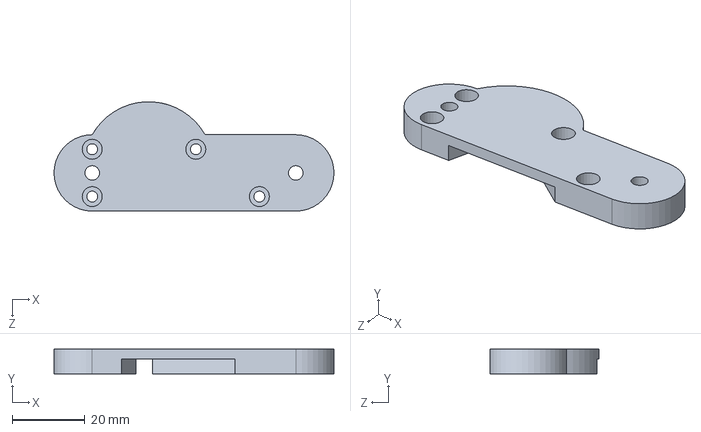
[picture p220: CAD file, 2023-05-16]
Deler til maskinering/SkulderAkslingsbrakett/PulleyStrammerBottomLeft.SLDPRT
76.9 x 6.75 x 30.0 mm
