DAwesomEL/BachelorProsjekt/FastSkulder/pulley_48_5m__15_10.sldprt

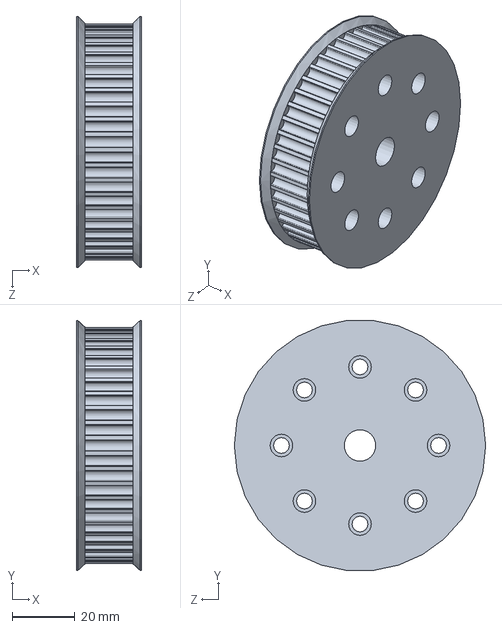
[picture p221: CAD file, 2023-02-21]
FastSkulder/pulley_48_5m__15_10.sldprt
20.7 x 79.6 x 80.0 mm
