DAwesomEL/BachelorProsjekt/FastSkulderNy/BeinSjold.SLDPRT

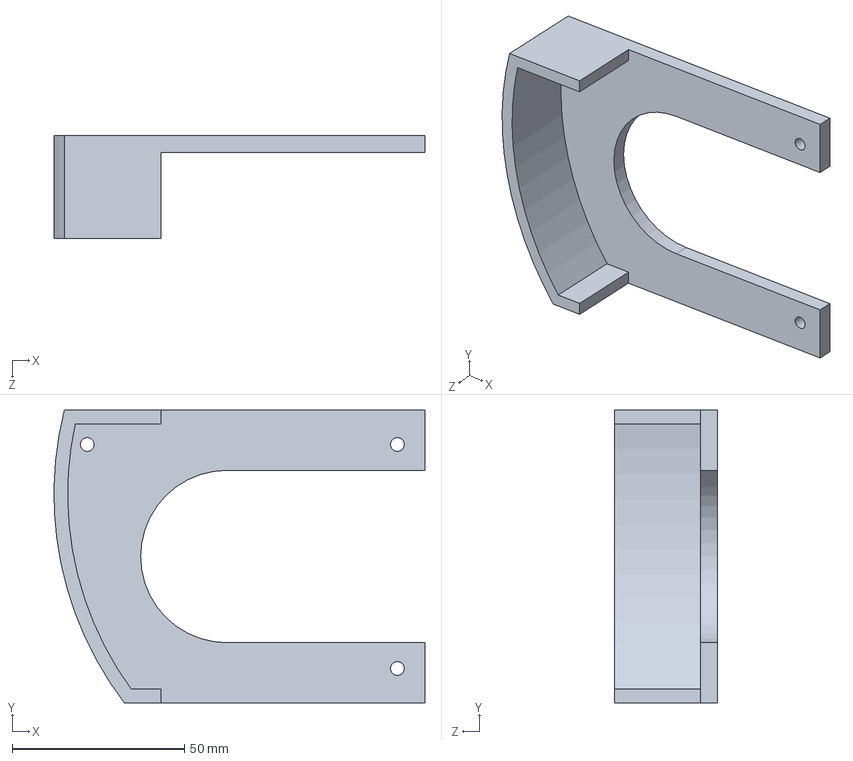
[picture p222: CAD file, 2023-02-21]
FastSkulderNy/BeinSjold.SLDPRT
107.7 x 85.0 x 30.0 mm
