DAwesomEL/BachelorProsjekt/Loomo model/Loomo Head.SLDPRT

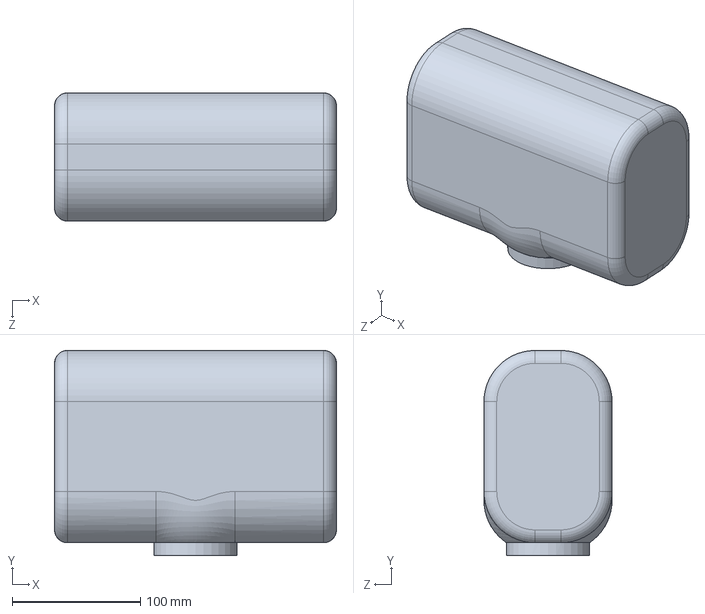
[picture p223: CAD file, 2023-04-21]
Loomo model/Loomo Head.SLDPRT
220.0 x 160.0 x 100.0 mm
