DAwesomEL/BachelorProsjekt/Overarm/idler_09_6.sldprt

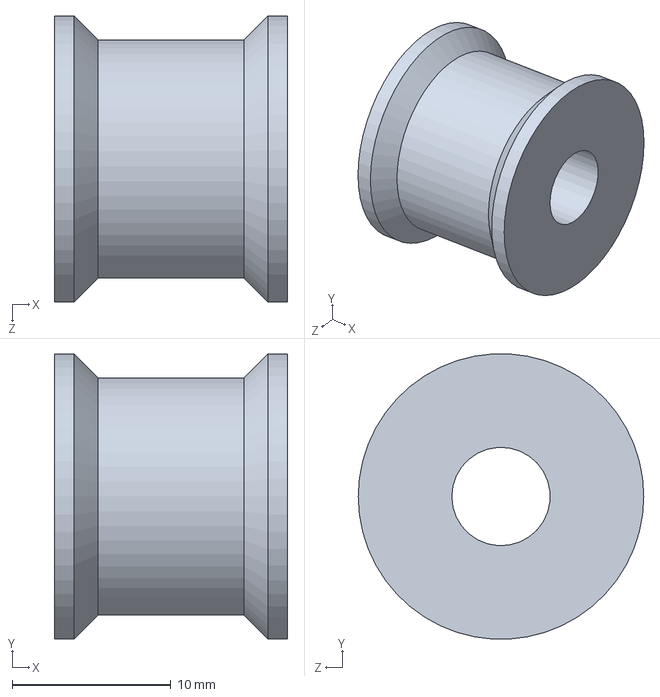
[picture p224: CAD file, 2023-02-21]
Overarm/idler_09_6.sldprt
14.7 x 18.0 x 18.0 mm
