DAwesomEL/BachelorProsjekt/STL/Krageboy/Aksling.STL

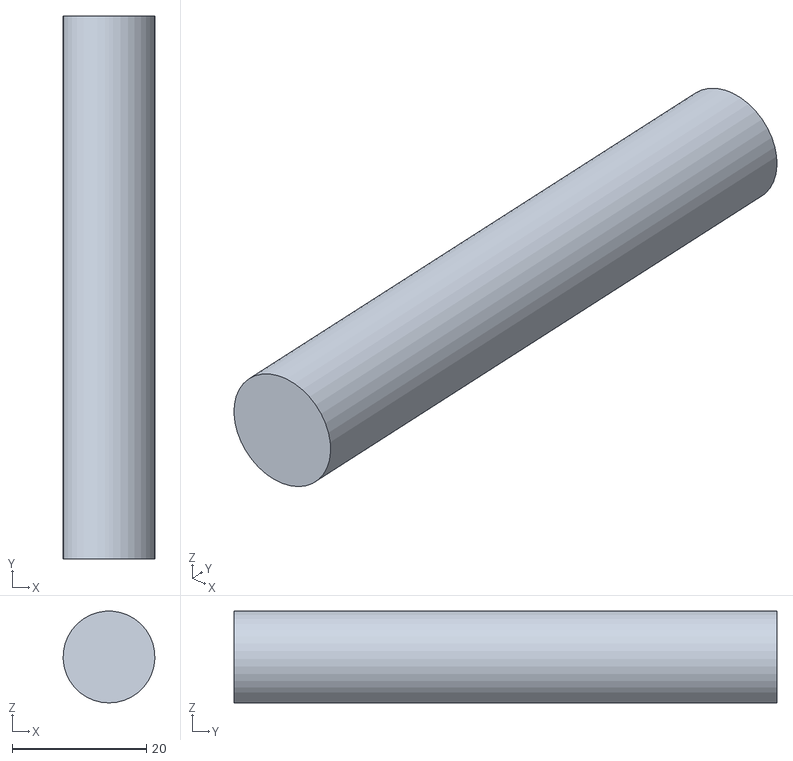
[picture p225: CAD file, 2023-05-28]
STL/Krageboy/Aksling.STL
13.7 x 81.0 x 13.7
