DAwesomEL/BachelorProsjekt/STL/RightHand.STL

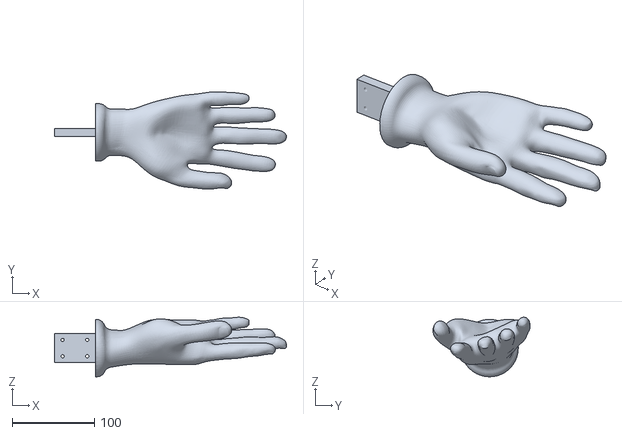
[picture p226: CAD file, 2023-05-28]
STL/RightHand.STL
282.9 x 118.5 x 72.7
