DAwesomEL/BachelorProsjekt/WORK/PARTS/Belt/Gir/PulleTesting.SLDPRT

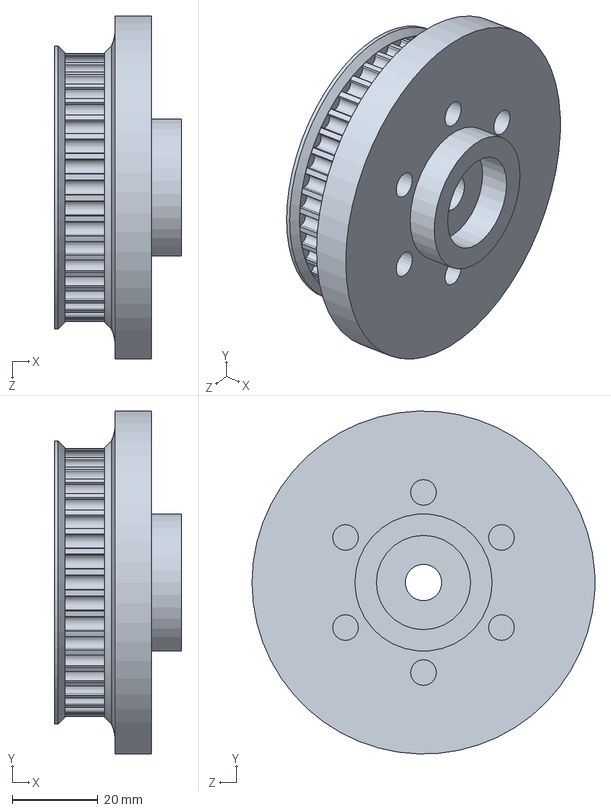
[picture p227: CAD file, 2023-04-16]
WORK/PARTS/Belt/Gir/PulleTesting.SLDPRT
29.7 x 80.0 x 80.0 mm
