DAwesomEL/BachelorProsjekt/WORK/PARTS/Motor/20mm77gMotor.SLDPRT

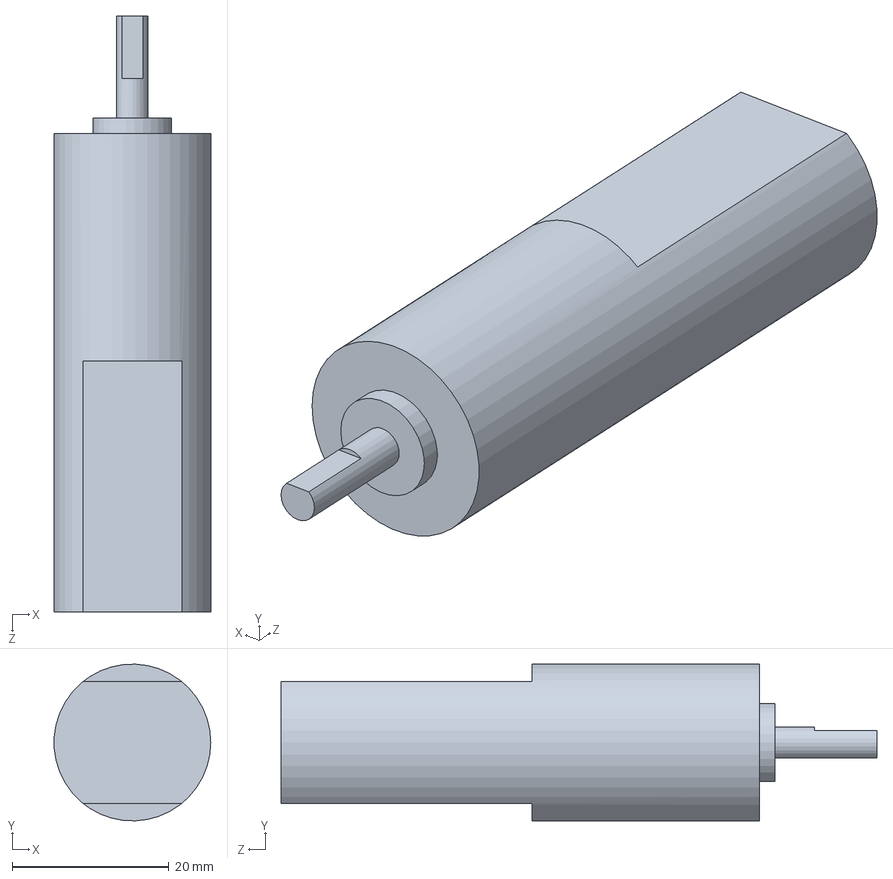
[picture p228: CAD file, 2023-02-21]
WORK/PARTS/Motor/20mm77gMotor.SLDPRT
20.0 x 20.0 x 76.0 mm
