DAwesomEL/BachelorProsjekt/WORK/Skulderledd/AxialRotationUpperArmLid.SLDPRT

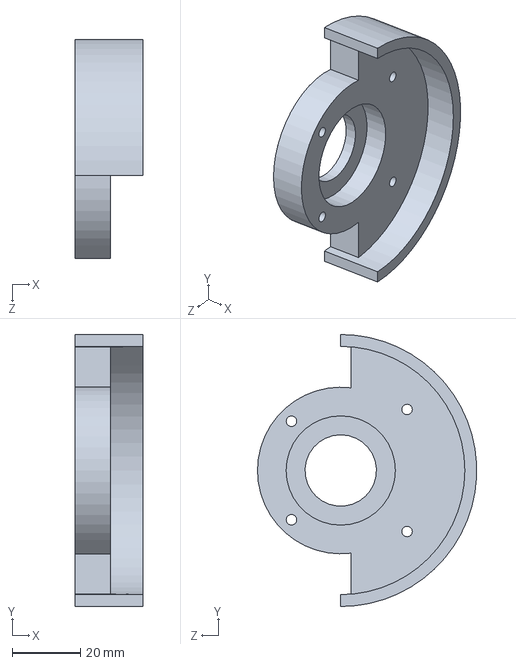
[picture p229: CAD file, 2023-05-28]
WORK/Skulderledd/AxialRotationUpperArmLid.SLDPRT
20.0 x 80.0 x 64.4 mm
