DAwesomEL/BachelorProsjekt/FastSkulderMotorBak/MotorBracket.SLDPRT

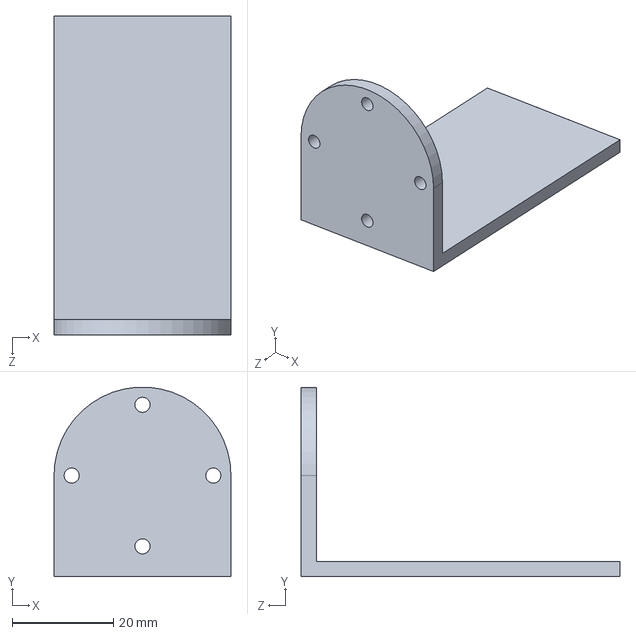
[picture p230: CAD file, 2023-02-22]
FastSkulderMotorBak/MotorBracket.SLDPRT
35.0 x 37.5 x 63.0 mm
