DAwesomEL/BachelorProsjekt/Loomo model/BracketLeft.SLDPRT

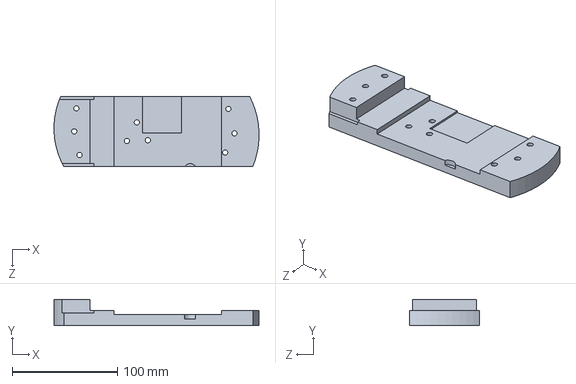
[picture p231: CAD file, 2023-02-21]
Loomo model/BracketLeft.SLDPRT
194.9 x 25.0 x 67.0 mm
