DAwesomEL/BachelorProsjekt/Markeforge/pulley_20_5m__09_8.SLDPRT

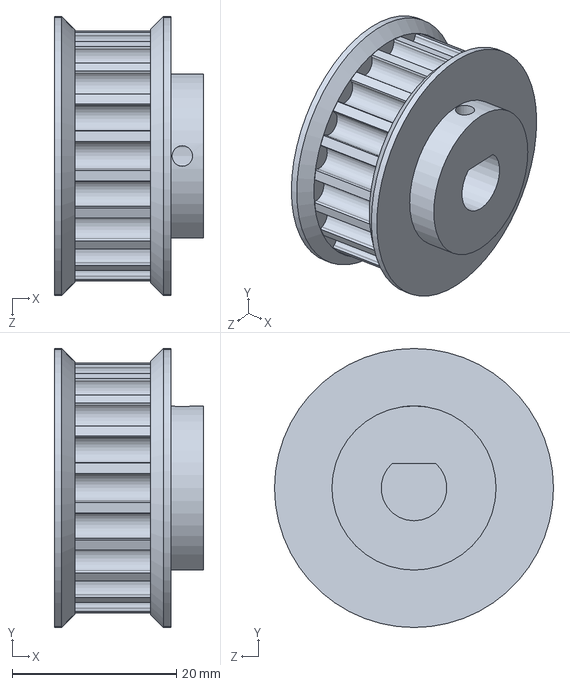
[picture p232: CAD file, 2023-04-19]
Markeforge/pulley_20_5m__09_8.SLDPRT
18.2 x 34.0 x 34.0 mm
