DAwesomEL/BachelorProsjekt/Overarm/pulley_48_5m__09_10.sldprt

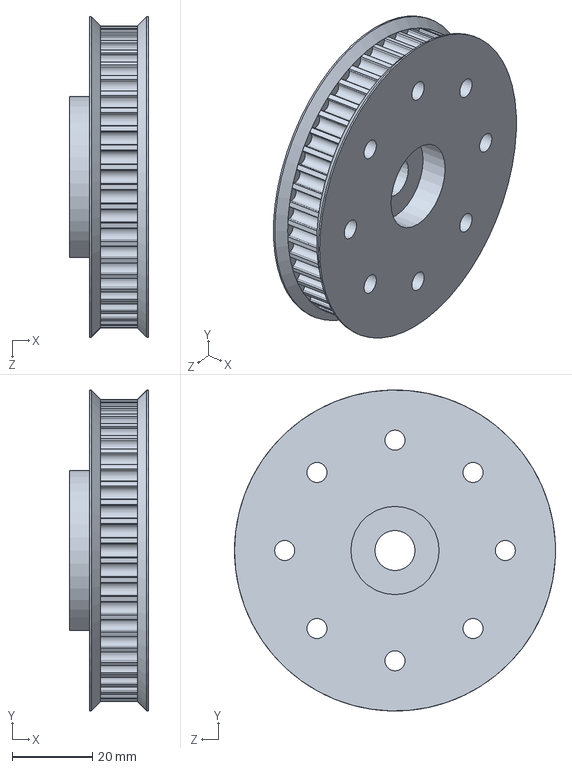
[picture p233: CAD file, 2023-02-21]
Overarm/pulley_48_5m__09_10.sldprt
19.7 x 80.0 x 80.0 mm
