DAwesomEL/BachelorProsjekt/WORK/ASSEMBLY/Batteri vekt kompensasjon.SLDPRT

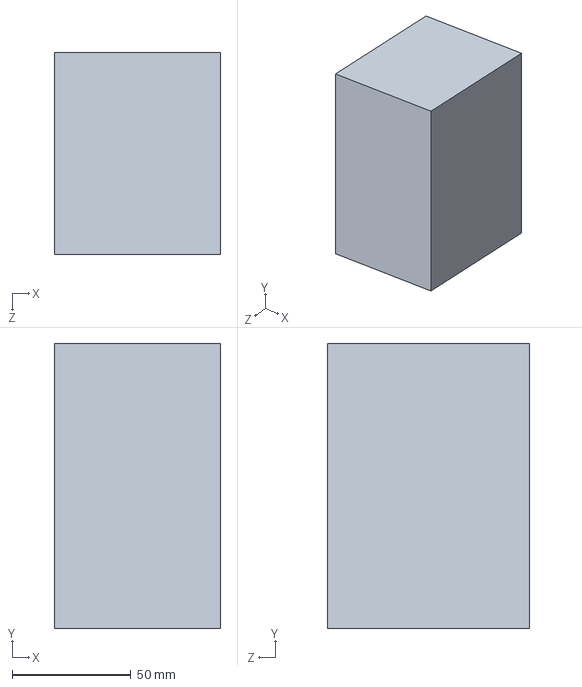
[picture p234: CAD file, 2023-04-26]
WORK/ASSEMBLY/Batteri vekt kompensasjon.SLDPRT
70.0 x 120.0 x 85.0 mm
