DAwesomEL/BachelorProsjekt/WORK/Batteripakke/BatteryHolder.SLDPRT

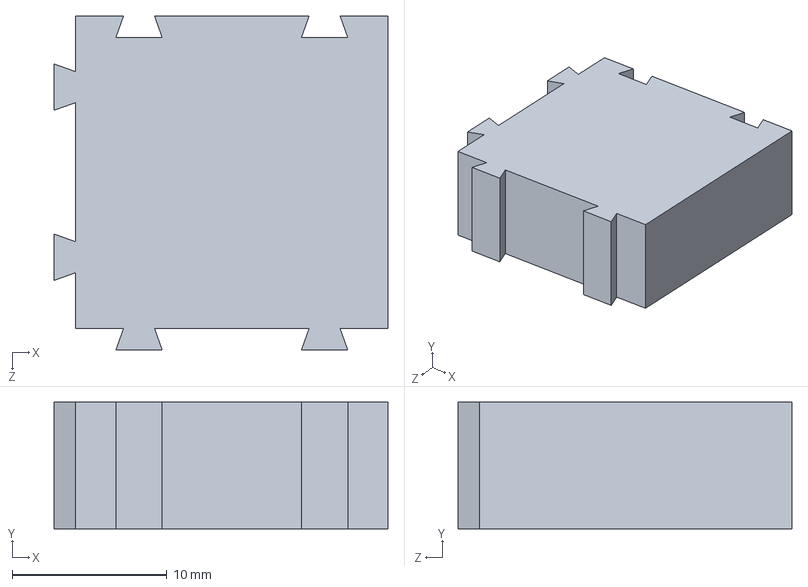
[picture p235: CAD file, 2023-05-02]
WORK/Batteripakke/BatteryHolder.SLDPRT
21.6 x 8.20 x 21.6 mm
