DAwesomEL/BachelorProsjekt/WORK/PARTS/Belt/Gir/Upper.SLDPRT

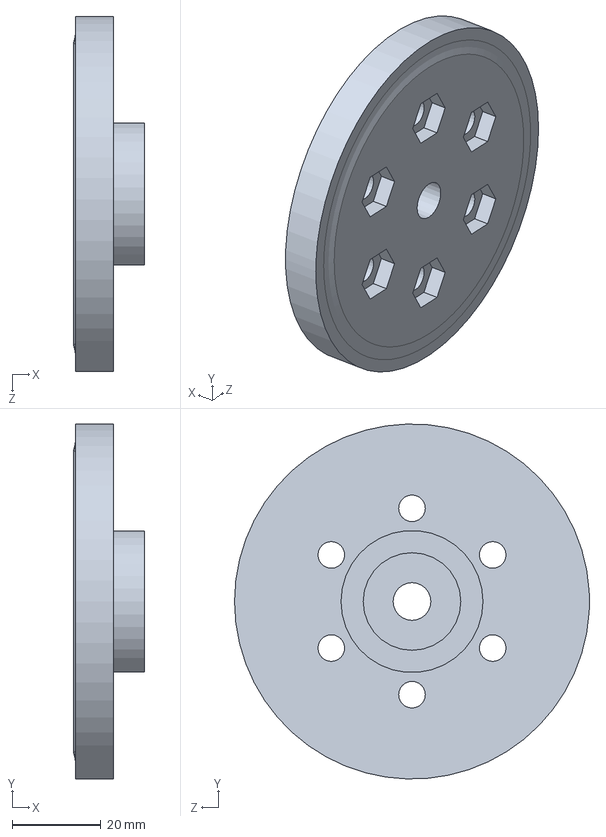
[picture p236: CAD file, 2023-04-16]
WORK/PARTS/Belt/Gir/Upper.SLDPRT
16.0 x 80.0 x 80.0 mm
