DAwesomEL/BachelorProsjekt/WORK/Skulderledd/LokkOverarmSkulderside.SLDPRT

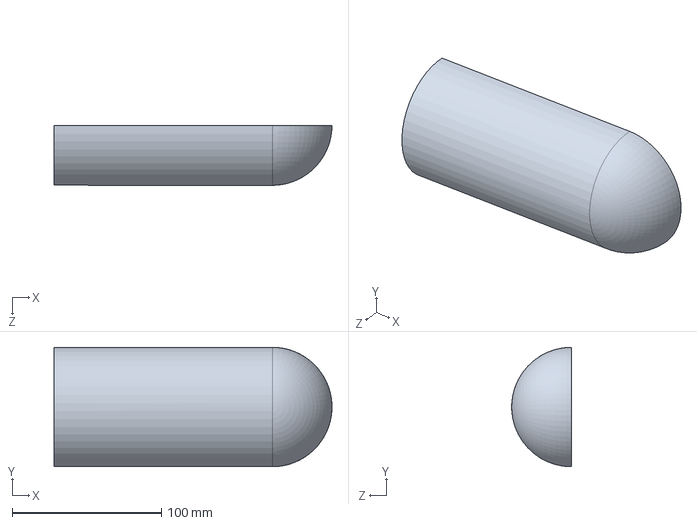
[picture p237: CAD file, 2023-05-24]
WORK/Skulderledd/LokkOverarmSkulderside.SLDPRT
186.2 x 80.0 x 40.0 mm
