DAwesomEL/BachelorProsjekt/WORK/Testing/Testplate.SLDPRT

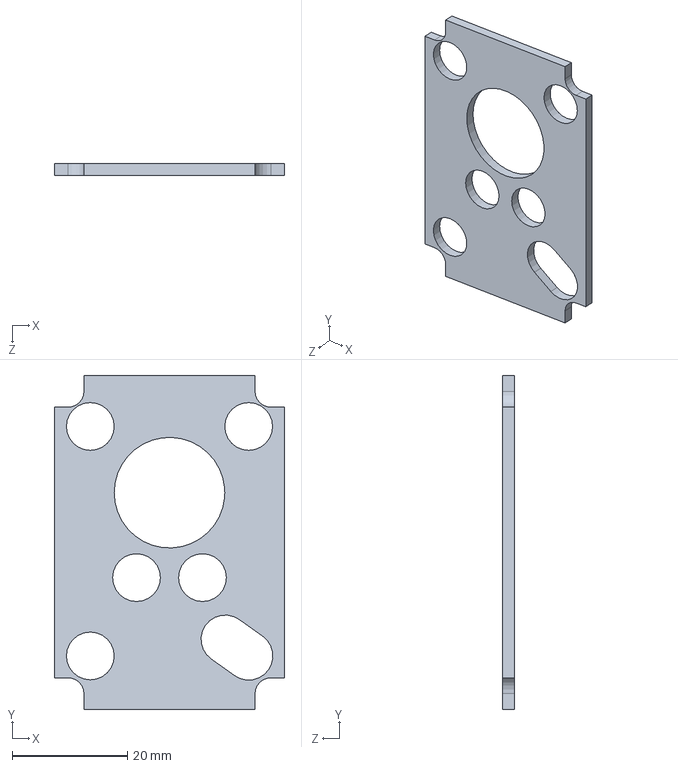
[picture p238: CAD file, 2023-03-07]
WORK/Testing/Testplate.SLDPRT
40.0 x 58.0 x 2.00 mm
