DAwesomEL/BachelorProsjekt/Overarm/OverarmFirst.SLDASM

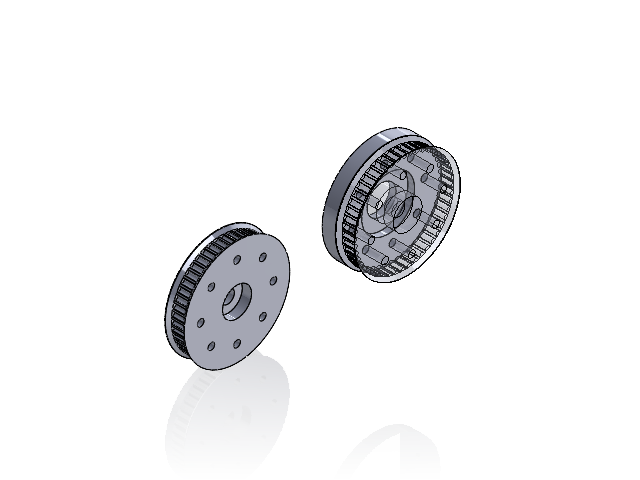
[picture p239: CAD file, 2023-02-21]
Overarm/OverarmFirst.SLDASM
pulley_48_5m__09_10 x 2
