DAwesomEL/BachelorProsjekt/(list of files, cad)

Other CAD files:
WORK/ASSEMBLY/BelteDekselRight/BelteDekselRightMain.SLDPRT
STL/BelteDekselLeftMain.STL
Deler til maskinering/SkulderAkslingsbrakett/SammenstillingPulleystrammerLeft.SLDASM
STL/BelteDekselRightMain.STL
Deler til maskinering/UsplittedeDeler/PulleyStrammerRight.SLDPRT
Overarm/Part3.SLDPRT
Skulderledd/Overarm.SLDPRT
Deler til maskinering/Monteringsplate/MonteringsplateRightFinal.SLDPRT
Deler til maskinering/UsplittedeDeler/PulleyStrammerLeft.SLDPRT
WORK/Elbow/DekselKabelgateOrmegirYtre.SLDPRT
WORK/RightShoulder/MonteringsplateRightFinal.SLDPRT
Deler til maskinering/UsplittedeDeler/SkulderAkslingsbrakettRight.SLDPRT
FastSkulder/BracketTop.SLDPRT
FastSkulderNy/BracketTop.SLDPRT
Gammel Arbeidstegninger/BracketBottom/BracketBottom.SLDPRT
Loomo model/stand-for-loomo-model_files/nologo_central_left.stl
Markeforge/pulley_40_5m__09_10.SLDPRT
WORK/Elbow/DekselKabelgateOrmegirIndre.SLDPRT
WORK/RightShoulder/BracketBottom.SLDPRT
Deler til maskinering/TorsjonOverarmMotorBrakett/TorsjonOverarmMotorBrakett.SLDPRT
Deler til maskinering/UsplittedeDeler/SkulderAkslingsbrakettLeft.SLDPRT
FastSkulderMotorBak/31mm360gMotor.sldprt
Gammel Arbeidstegninger/BracketBottom/BracketBottomLeftLow.SLDPRT
Markeforge/idler_09_4.SLDPRT
WORK/ASSEMBLY/WorkspaceRight.SLDPRT
WORK/LeftShoulder/SkulderAkslingsbrakettLeft.SLDPRT
WORK/RightShoulder/PulleyStrammerRight.SLDPRT
Kragemekanisme/200gMotor.SLDPRT
STL/Krageboy/200gMotor.STL
STL/LeftHand.STL
WORK/Elbow/AkslingTorsjonOverarm.SLDPRT
WORK/LeftShoulder/MonteringsplateLeftFinal.SLDPRT
WORK/RightShoulder/SkulderAkslingsbrakett.SLDPRT
Deler til maskinering/SkulderAkslingsbrakett/PulleyStrammerBottomRight.SLDPRT
Deler til maskinering/AkslingTorsjonOverarm/AkslingTorsjonOverarm.SLDDRW
Deler til maskinering/ElbowWormGear/ElbowWormGear.SLDDRW
Deler til maskinering/Monteringsplate/Monteringsplate.SLDDRW
Deler til maskinering/SkulderAkslingsbrakett/SkulderAkslingsbrakett.SLDDRW
Deler til maskinering/SkulderAkslingsbrakett/SkulderAkslingsbrakettBottomLeft.SLDPRT
Deler til maskinering/SkulderAkslingsbrakett/SkulderAkslingsbrakettBottomRight.SLDPRT
Deler til maskinering/SkulderAkslingsbrakett/SkulderAkslingsbrakettLidLeft.SLDPRT
Deler til maskinering/SkulderAkslingsbrakett/SkulderAkslingsbrakettLidRight.SLDPRT
Deler til maskinering/TorsjonOverarmMotorBrakett/TorsjonOverarmMotorBrakett.SLDDRW
FastSkulder/BracketBottom.SLDPRT
FastSkulder/FastSkulder - Copy.SLDASM
FastSkulder/MetalStiffBracket.SLDPRT
FastSkulder/idler_15_6.sldprt
FastSkulderMotorBak/31mm360gMotor.STL
FastSkulderMotorBak/Monteringsplate2.STL
FastSkulderNy/200gMotor.SLDPRT
FastSkulderNy/BeinSjold.STL
FastSkulderNy/IdlerSlider.SLDPRT
FastSkulderNy/IdlerSlider.STL
FastSkulderNy/MetalStiffBracket.SLDPRT
FastSkulderNy/MetalStiffBracket.STL
FastSkulderNy/RollerBearing.SLDPRT
FastSkulderNy/idler_15_6.sldprt
FastSkulderNy/pulley_48_5m__15_10.sldprt
Gammel Arbeidstegninger/BracketBottom/BracketBottomLow.SLDDRW
Gammel Arbeidstegninger/M10 Bolt/M10 Bolt Aksling.SLDDRW
Gammel Arbeidstegninger/ThrustBearingLidOverarmSkulderside/ThrustBearingLidOverarmSkulderside.SLDDRW
Kragemekanisme/Bracket.SLDPRT
Kragemekanisme/skulderFeste.SLDPRT
Loomo model/BracketRight.SLDPRT
Markeforge/GrønnePrinsSideUtenSkruer.SLDPRT
Markeforge/GrønnePrinsen.SLDPRT
Markeforge/ThrustBearingLidOverarmSkulderside.SLDPRT
Markeforge/TorsionElbowSide.SLDPRT
OLD/FastSkulder/BracketBottom.SLDPRT
OLD/FastSkulder/BracketTop.SLDPRT
OLD/FastSkulder/FastSkulder - Copy.SLDASM
OLD/FastSkulder/MetalStiffBracket.SLDPRT
OLD/FastSkulder/MiniutureBallBearing_h8.SLDPRT
OLD/FastSkulder/RollerBearing_h6.SLDPRT
OLD/FastSkulder/ThrustBearing_h10.SLDPRT
OLD/FastSkulder/idler_15_6.sldprt
OLD/FastSkulderMotorBak/31mm360gMotor.STL
OLD/FastSkulderMotorBak/31mm360gMotor.sldprt
OLD/FastSkulderMotorBak/BracketBottom.SLDPRT
OLD/FastSkulderMotorBak/FastSkulderMotorBak.SLDASM
OLD/FastSkulderMotorBak/MiniutureBallBearing_h8.SLDPRT
OLD/FastSkulderMotorBak/Monteringsplate.SLDPRT
OLD/FastSkulderMotorBak/Monteringsplate2.SLDPRT
OLD/FastSkulderMotorBak/Monteringsplate2.STL
OLD/FastSkulderMotorBak/RollerBearing_h6.SLDPRT
OLD/FastSkulderMotorBak/ThrustBearing_h10.SLDPRT
OLD/FastSkulderMotorBak/pulley_20_5m__09_8.sldprt
OLD/FastSkulderNy/200gMotor.SLDPRT
OLD/FastSkulderNy/BeinSjold.STL
OLD/FastSkulderNy/BracketTop.SLDPRT
OLD/FastSkulderNy/IdlerSlider.SLDPRT
OLD/FastSkulderNy/IdlerSlider.STL
OLD/FastSkulderNy/MetalStiffBracket.SLDPRT
OLD/FastSkulderNy/MetalStiffBracket.STL
OLD/FastSkulderNy/RollerBearing.SLDPRT
OLD/FastSkulderNy/idler_15_6.sldprt
OLD/FastSkulderNy/pulley_48_5m__15_10.sldprt
OLD/Kragemekanisme/200gMotor.SLDPRT
OLD/Kragemekanisme/Aksling.SLDPRT
OLD/Kragemekanisme/Arm.SLDPRT
OLD/Kragemekanisme/Bracket.SLDPRT
OLD/Kragemekanisme/Kragemekanisme.SLDASM
OLD/Kragemekanisme/skulderFeste.SLDPRT
OLD/Overarm/MiniutureBallBearing_h8.SLDPRT
OLD/Overarm/Part3.SLDPRT
OLD/Overarm/RollerBearing_h6.SLDPRT
OLD/Overarm/ThrustBearing_h10.SLDPRT
OLD/Overarm/pulley_12_5m__09_6.sldprt
OLD/Skulderledd/Overarm.SLDPRT
OLD/plate tester/HullplateTEST.STL
OLD/plate tester/TestPlateIAssembly.STL
Overarm/pulley_12_5m__09_6.sldprt
STL/31mm360WormMotor.STL
STL/31mm360gMotor.STL
STL/AkslingTorsjonOverarm.STL
STL/Archive/AkslingTorsjonOverarm.STL
STL/Archive/Akslingsupport.STL
STL/Archive/AlbueMotorBrakett.STL
STL/Archive/BatteryHolder.STL
STL/Archive/BracketBottom.STL
STL/Archive/BracketBottomLeft.STL
STL/Archive/GrønnePrinsSideUtenSkruer.STL
STL/Archive/GrønnePrinsen.STL
STL/Archive/GrønnePrinsenHøyre.STL
STL/Archive/GrønnePrinsenVenstre.STL
STL/Archive/MonteringsplateLeftFinal.STL
STL/Archive/MonteringsplateRightFinal.STL
STL/Archive/PulleyStrammer.STL
STL/Archive/SkulderAkslingsbrakett.STL
STL/Archive/Testplate.STL
STL/Archive/Testplate2.STL
STL/Archive/Testplate3.STL
STL/Archive/TorsionElbowSide.STL
STL/Archive/hoyremontering.STL
STL/Archive/testing.STL
STL/AxialRotationUpperArmLid.STL
STL/BMSV2.STL
STL/BatteriCase.STL
STL/BatteriCaseV2.STL
STL/BatteriCaseV3.STL
STL/BelteDekselLeft.STL
STL/BelteDekselLeftHigh.STL
STL/BelteDekselRight.STL
STL/BelteDekselRightHigh.STL
STL/BracketBottom.STL
STL/ElbowMotorFastnerBracket.STL
STL/GrønnePrinsenHøyre.STL
STL/GrønnePrinsenVenstre.STL
STL/HAND.STL
STL/HoveddelOverarmSkulderside.STL
STL/Krageboy/15toothMod08.STL
STL/Krageboy/krageGirStor_mod08tooth60.STL
STL/LokkOverarmSkulderside.STL
STL/MonteringsplateLeftFinal.STL
STL/MonteringsplateRightFinal.STL
STL/PulleyStrammer.STL
STL/PulleyStrammerRight.STL
STL/SkulderAkslingsbrakett.STL
STL/Testplate.STL
STL/Testplate2.STL
STL/Testplate3.STL
STL/Thrust203504.STL
STL/TorsjonOverarmMotorBrakett.STL
STL/UnderarmBottom.STL
STL/UnderarmLokk.STL
STL/hoyremontering.STL
STL/testing.STL
WORK/Batteripakke/BatteriCase.SLDPRT
WORK/Batteripakke/BatteriCaseV2.SLDPRT
WORK/Elbow/AlbueMotorBrakett.SLDPRT
WORK/Elbow/ElbowMotorFastnerBracket.SLDPRT
WORK/Elbow/ElbowMotorFastnerBracketMirrored.SLDPRT
WORK/Elbow/ElbowMotorOutputBracket.SLDPRT
WORK/Elbow/Finger.SLDPRT
WORK/Elbow/Sleiv.SLDPRT
WORK/Elbow/SlipRingMST005-22-06A.SLDPRT
WORK/Elbow/TestUnderarmLengde.SLDPRT
WORK/Elbow/TorsionElbowSide.SLDPRT
WORK/Elbow/Underarm.SLDPRT
WORK/Elbow/UnderarmBottom.SLDPRT
WORK/Elbow/UnderarmLokk.SLDPRT
WORK/LeftShoulder/MirrorBracketBottom.SLDPRT
WORK/PARTS/Belt/Gir/Lower.SLDPRT
WORK/PARTS/Fasteners/IdelerM4100mmFasteningScrew.SLDPRT
WORK/PARTS/Fasteners/M10 Bolt Aksling.SLDDRW
WORK/PARTS/Fasteners/M10 Bolt Aksling.SLDPRT
WORK/PARTS/Fasteners/hex nut gradec_iso.SLDPRT
WORK/RightShoulder/Akslingsupport.SLDPRT
WORK/RightShoulder/BracketBottomCutSpacer.SLDPRT
WORK/Skulderledd/ThrustBearingLidOverarmSkulderside.SLDPRT
WORK/Skulderledd/TorsjonOverarmMotorBrakett.SLDPRT
WORK/Skulderledd/TorsjonOverarmMotorBrakettFesteside.SLDPRT
WORK/Skulderledd/TorsjonOverarmMotorBrakettMotorside.SLDPRT
WORK/Skulderledd/TorsjonOverarmMotorBrakettSveis.SLDPRT
WORK/Testing/testing.SLDPRT
plate tester/HullplateTEST.STL
plate tester/TestPlateIAssembly.STL
