DAwesomEL/BachelorProsjekt/WORK/ASSEMBLY/FørsteSammenstillingBeggeArmer.pdf

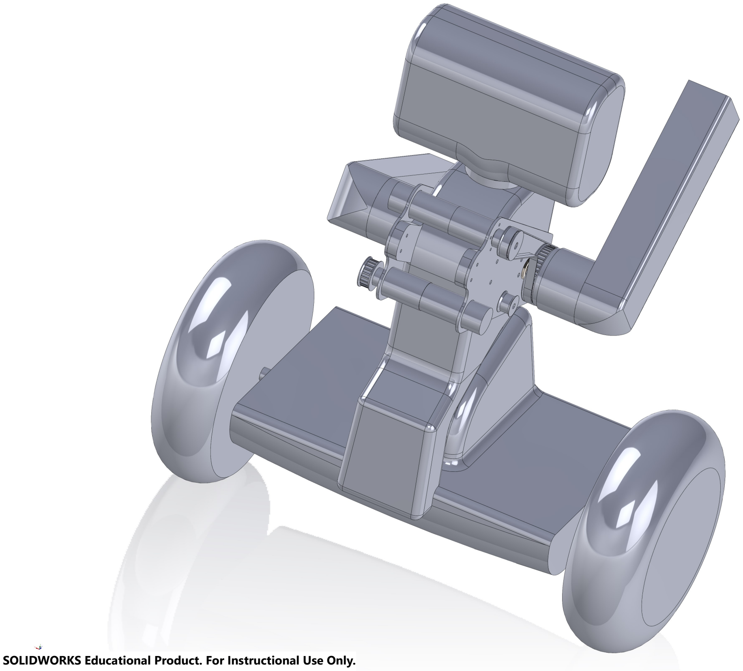
[picture p240: page 1]

SOLIDWORKS Educational Product. For Instructional Use Only.
