DAwesomEL/BachelorProsjekt/Pictures/Bearing/Complete torsion axle bearing setup.jpg

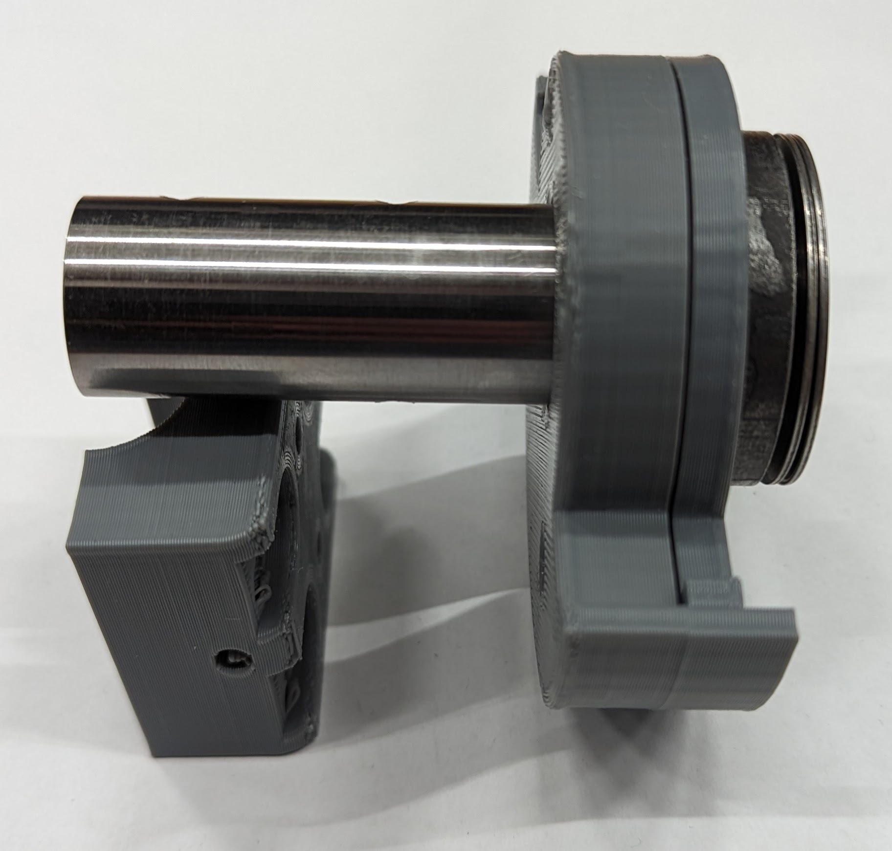
Pictures/Bearing/Complete torsion axle bearing setup.jpg
