DAwesomEL/BachelorProsjekt/WORK/Skulderledd/PerformanceLog.txt

Number of Contacts: 289
Number of contact data: 299255
