DAwesomEL/BachelorProsjekt/NOTES/FEM figur test.pdf

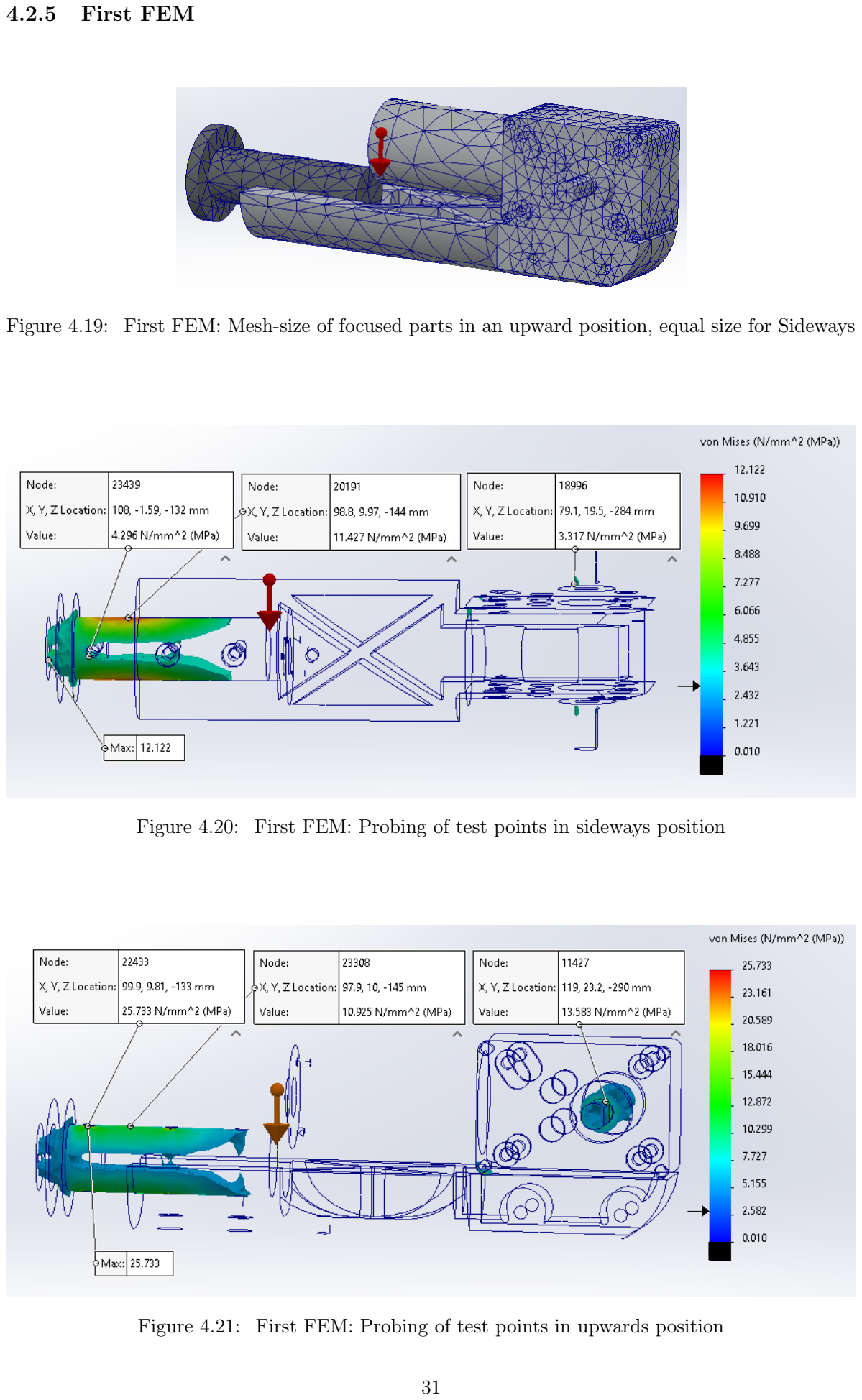
[picture p242: page 1]

### 4.2.5 First FEM

Figure 4.19: First FEM: Mesh-size of focused parts in an upward position, equal size for Sideways

Figure 4.20: First FEM: Probing of test points in sideways position

Figure 4.21: First FEM: Probing of test points in upwards position

31
