DAwesomEL/BachelorProsjekt/Pictures/FEM/New FEM/Result force.PNG

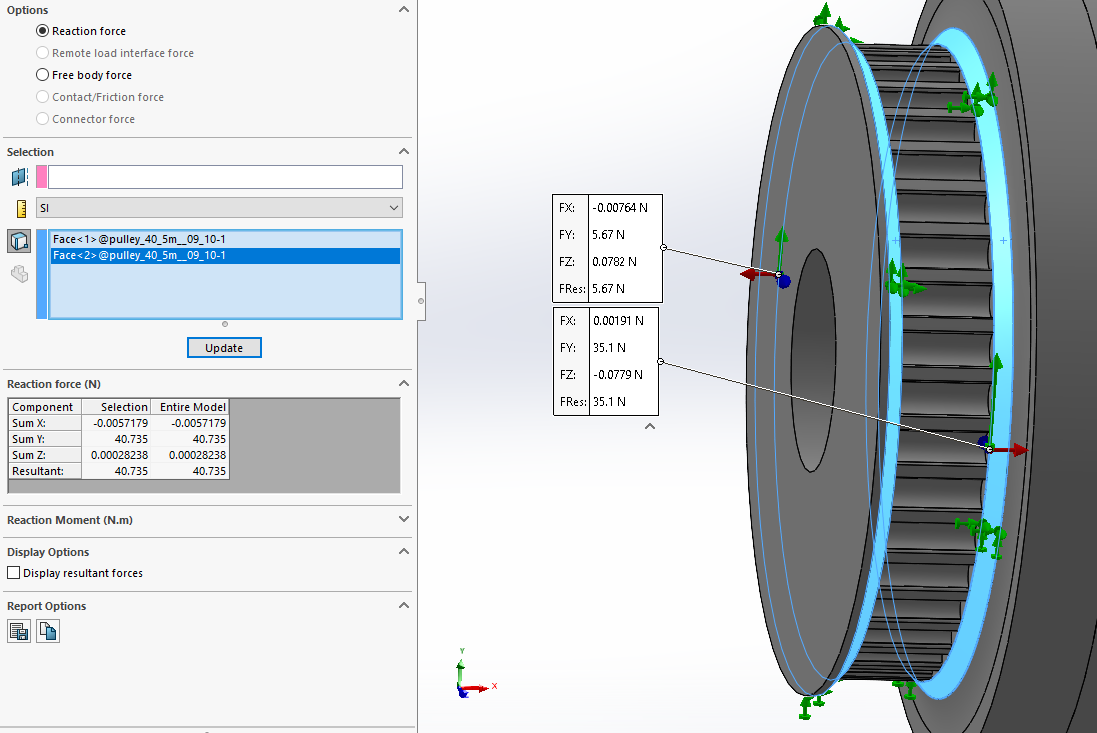
Pictures/FEM/New FEM/Result force.PNG
