DAwesomEL/BachelorProsjekt/Loomo model/stand-for-loomo-model_files/163367-stand-for-loomo-65432c3b-c2e8-4f3f-a194-d8b28d916c8e.pdf

## Stand for Loomo

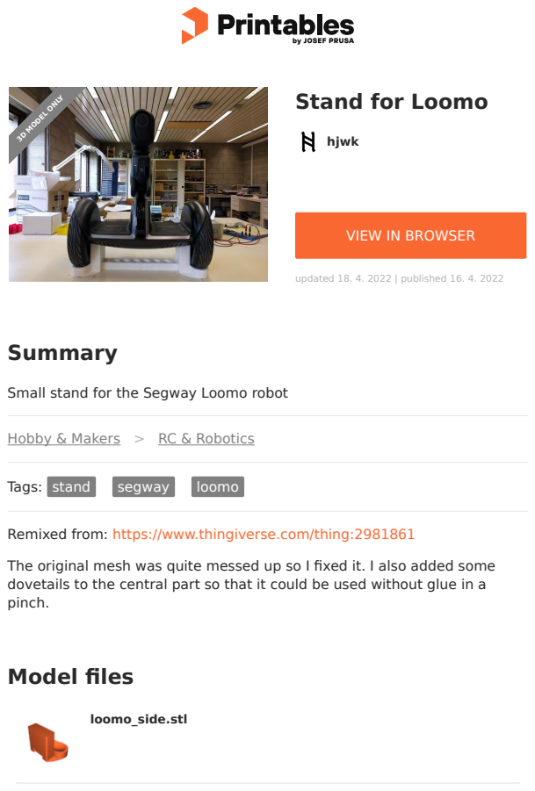
[picture p244: page 1]
Model files; Summary; Hobby & Makers; RC & Robotics; Tags: stand; segway; loomo; hjwk; updated 18. 4. 2022 | published 16. 4. 2022; loomo_side.stl; 3D MODEL ONLY

VIEW IN BROWSER (https://www.printables.com/model/163367-stand-for-loomo)

Small stand for the Segway Loomo robot

Remixed from: https://www.thingiverse.com/thing:2981861

The original mesh was quite messed up so I fixed it. I also added some
dovetails to the central part so that it could be used without glue in a
pinch.

## License

This work is licensed under a

Creative Commons (4.0 International License)

Attribution—Noncommercial—Share Alike (http://creativecommons.org/licenses/by-nc-sa/4.0/)

✖ | Sharing without ATTRIBUTION
✔ | Remix Culture allowed
✖ | Commercial Use
✖ | Free Cultural Works
✖ | Meets Open Definition

nologo_central_right.stl

nologo_central_left.stl
