DAwesomEL/BachelorProsjekt/Deler til maskinering/AkslingTorsjonOverarm.pdf

8 | 7 | 6 | 5 | 4 | 3 | 2 | 1

## ISO 2768-1 (c), ISO 2768-2 (K) & ISO 13920 BF

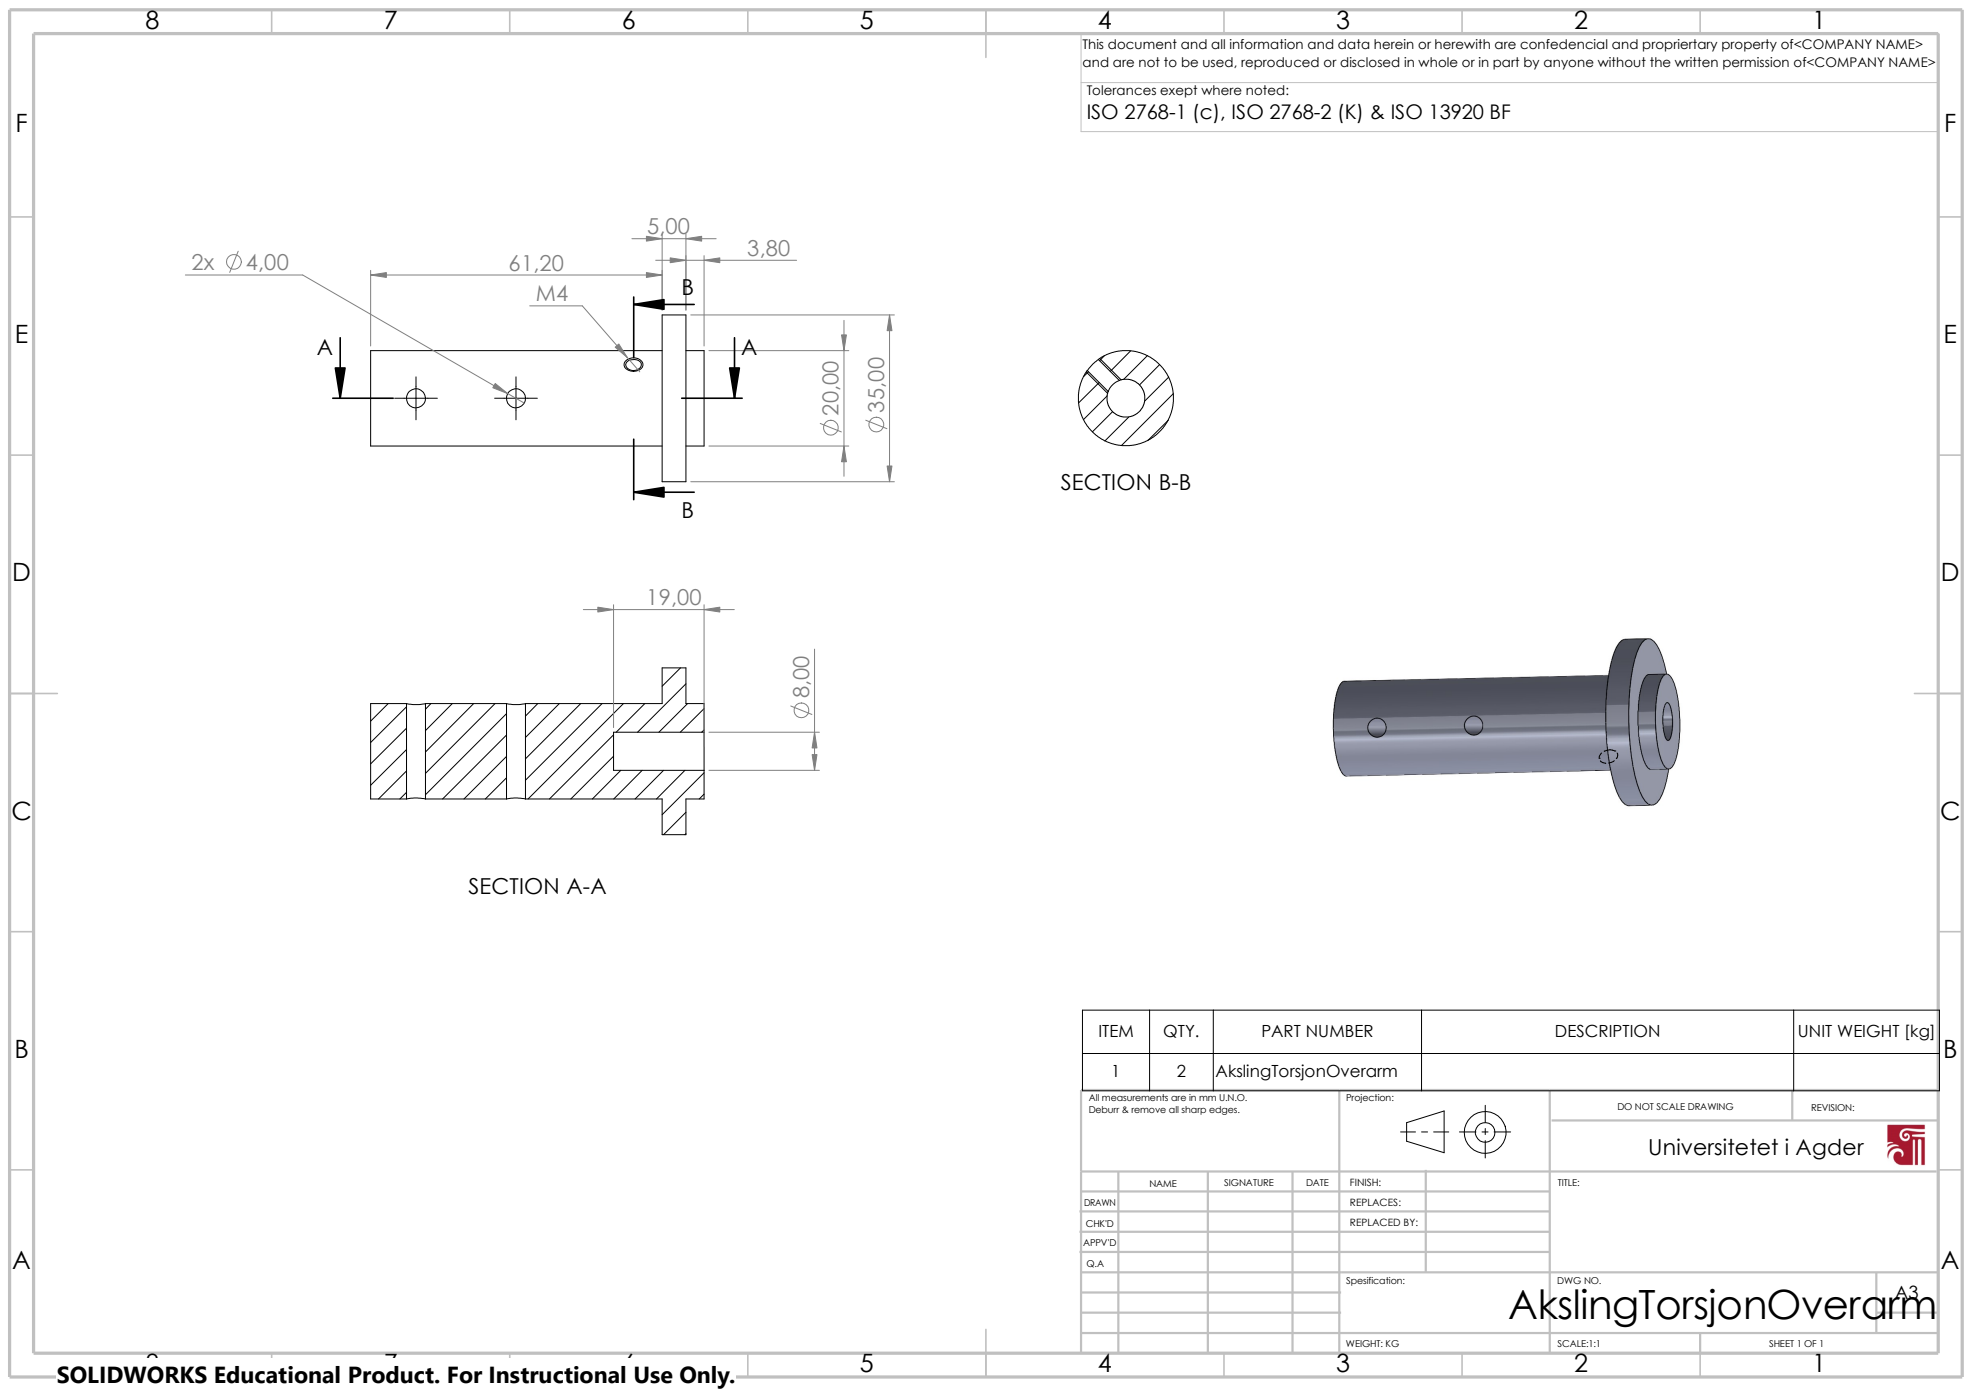
[picture p245: page 1]
SCALE:1:1; SHEET 1 OF 1; WEIGHT: KG; Universitetet i Agder; SECTION A-A; SECTION B-B ²⁰,00

5,00 | This document and all information and data herein or herewith are confedencial and propriertary property of<COMPANY NAME> and are not to be used, reproduced or disclosed in whole or in part by anyone without the written permission of<COMPANY NAME>

Tolerances exept where noted:

ITEM | QTY. | PART NUMBER | DESCRIPTION | UNIT WEIGHT [kg]

1 | 2 | AkslingTorsjonOverarm

All measurements are in mm U.N.O. Deburr & remove all sharp edges. | Projection: | | DO NOT SCALE DRAWING | REVISION:

NAME | SIGNATURE | DATE | FINISH: | | TITLE:

DRAWN | | | | REPLACES:

CHK'D | | | | REPLACED BY:
APPV'D

Spesification: AkslingTorsjonOverarm | DWG NO. | A3

SOLIDWORKS Educational Product. For Instructional Use Only.
