DAwesomEL/BachelorProsjekt/Deler til maskinering/Belt tightening mechanism.pdf

## ISO 2768-1 (c), ISO 2768-2 (K) & ISO 13920 BF

E E

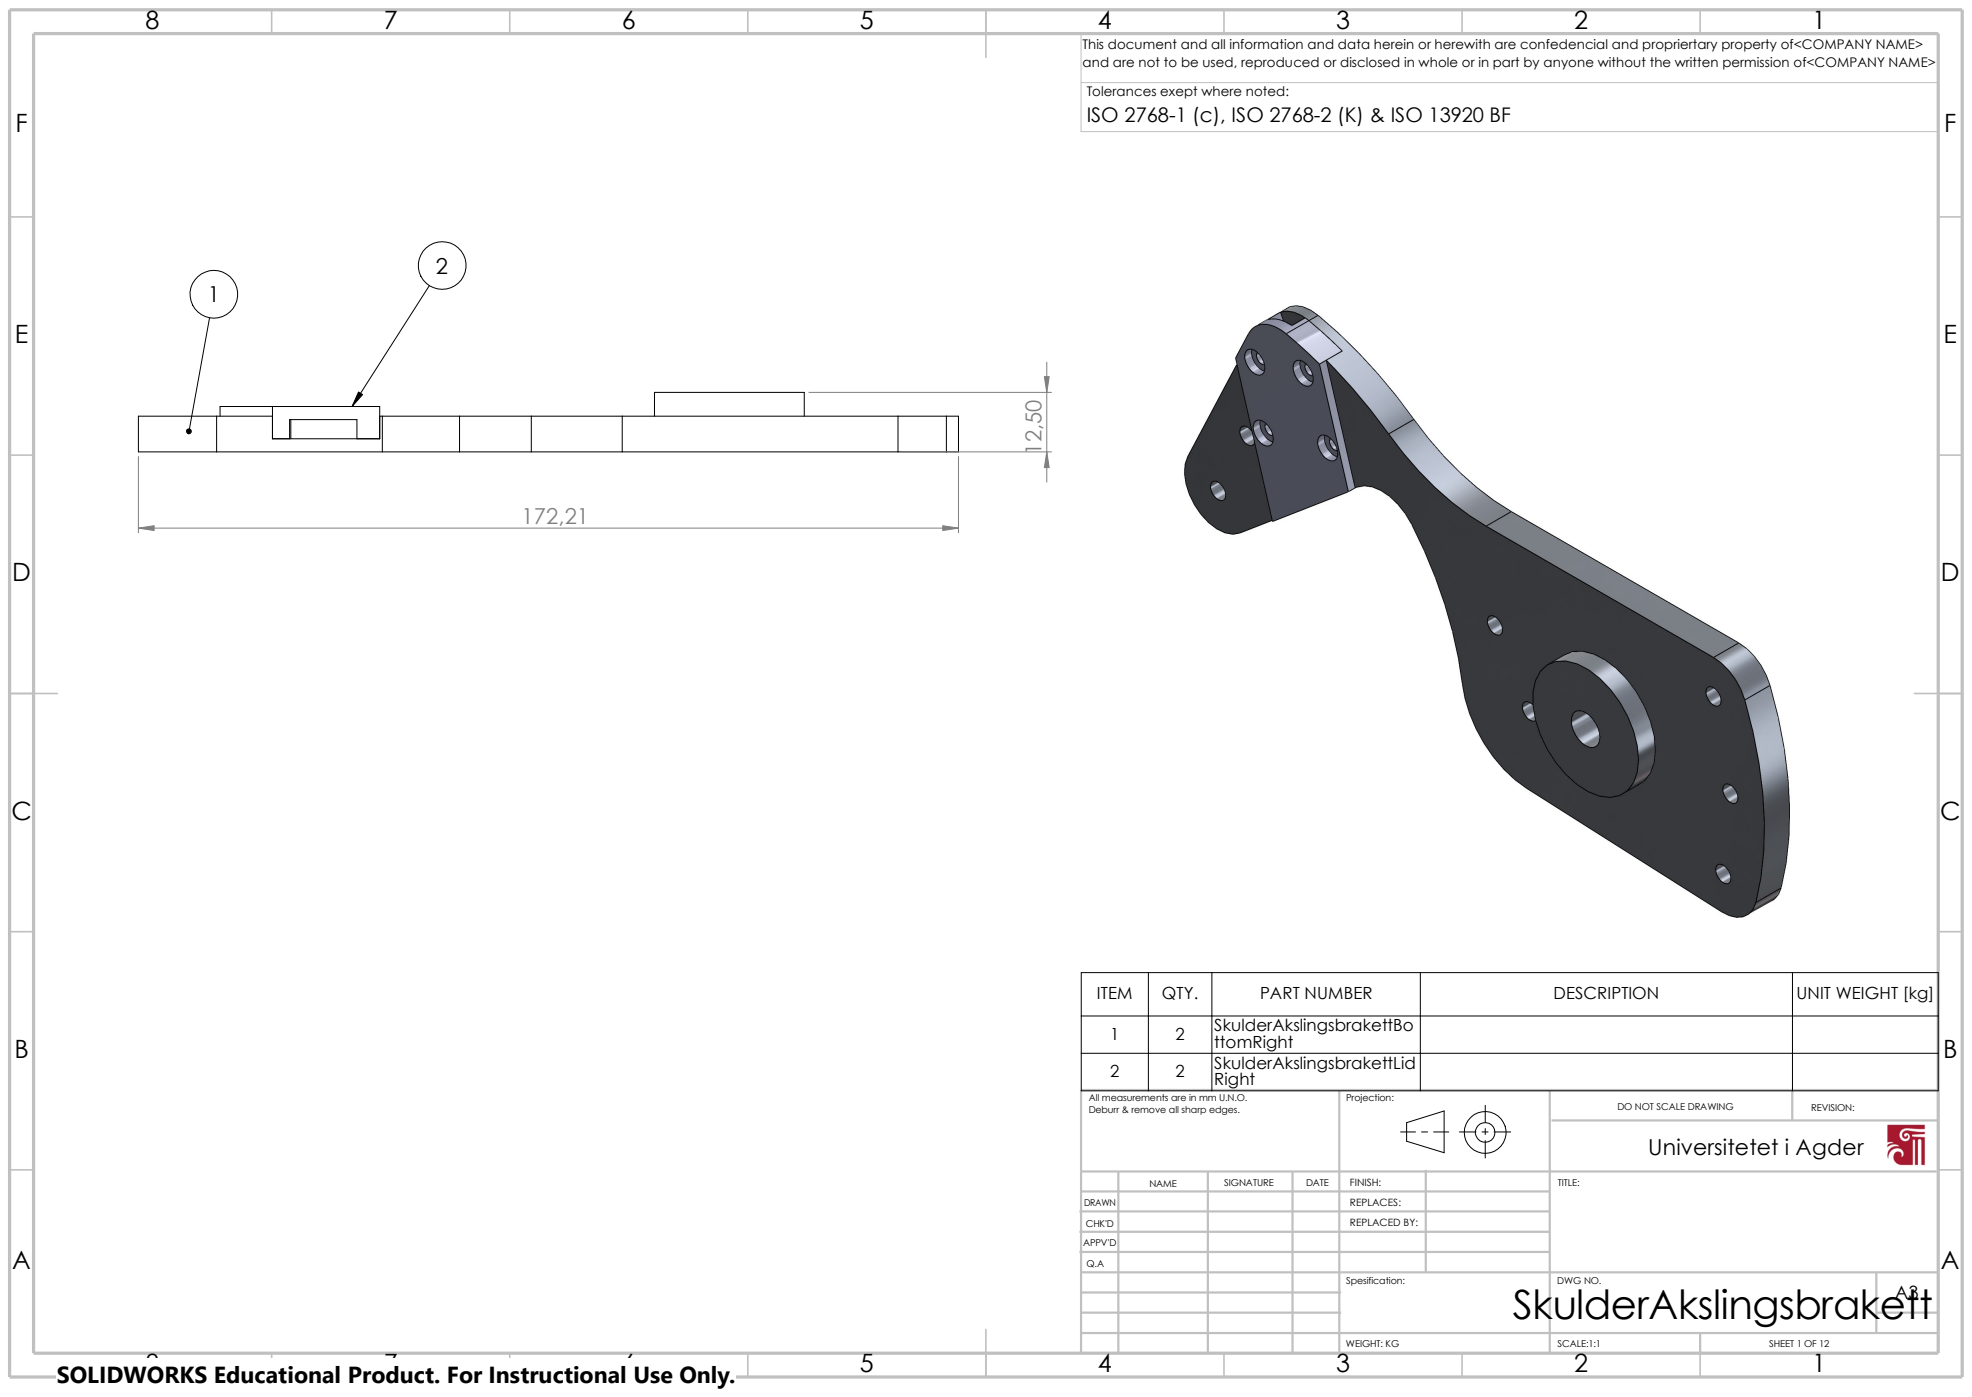
[picture p246: page 1]
SCALE:1:1; SHEET 1 OF 12; WEIGHT: KG; Universitetet i Agder

This document and all information and data herein or herewith are confedencial and propriertary property of<COMPANY NAME>
and are not to be used, reproduced or disclosed in whole or in part by anyone without the written permission of<COMPANY NAME>
Tolerances exept where noted:

ITEM | QTY. | PART NUMBER | DESCRIPTION | UNIT WEIGHT [kg]
1 | 2 | SkulderAkslingsbrakettBo ttomRight
2 | 2 | SkulderAkslingsbrakettLid Right

All measurements are in mm U.N.O. Deburr & remove all sharp edges. | Projection: | | DO NOT SCALE DRAWING | REVISION:

NAME | SIGNATURE | DATE | FINISH: | | TITLE:

DRAWN | | | | REPLACES:

CHK'D | | | | REPLACED BY:
APPV'D

Spesification: SkulderAkslingsbrakett | DWG NO. | A3

SOLIDWORKS Educational Product. For Instructional Use Only.

## ISO 2768-1 (c), ISO 2768-2 (K) & ISO 13920 BF

E E

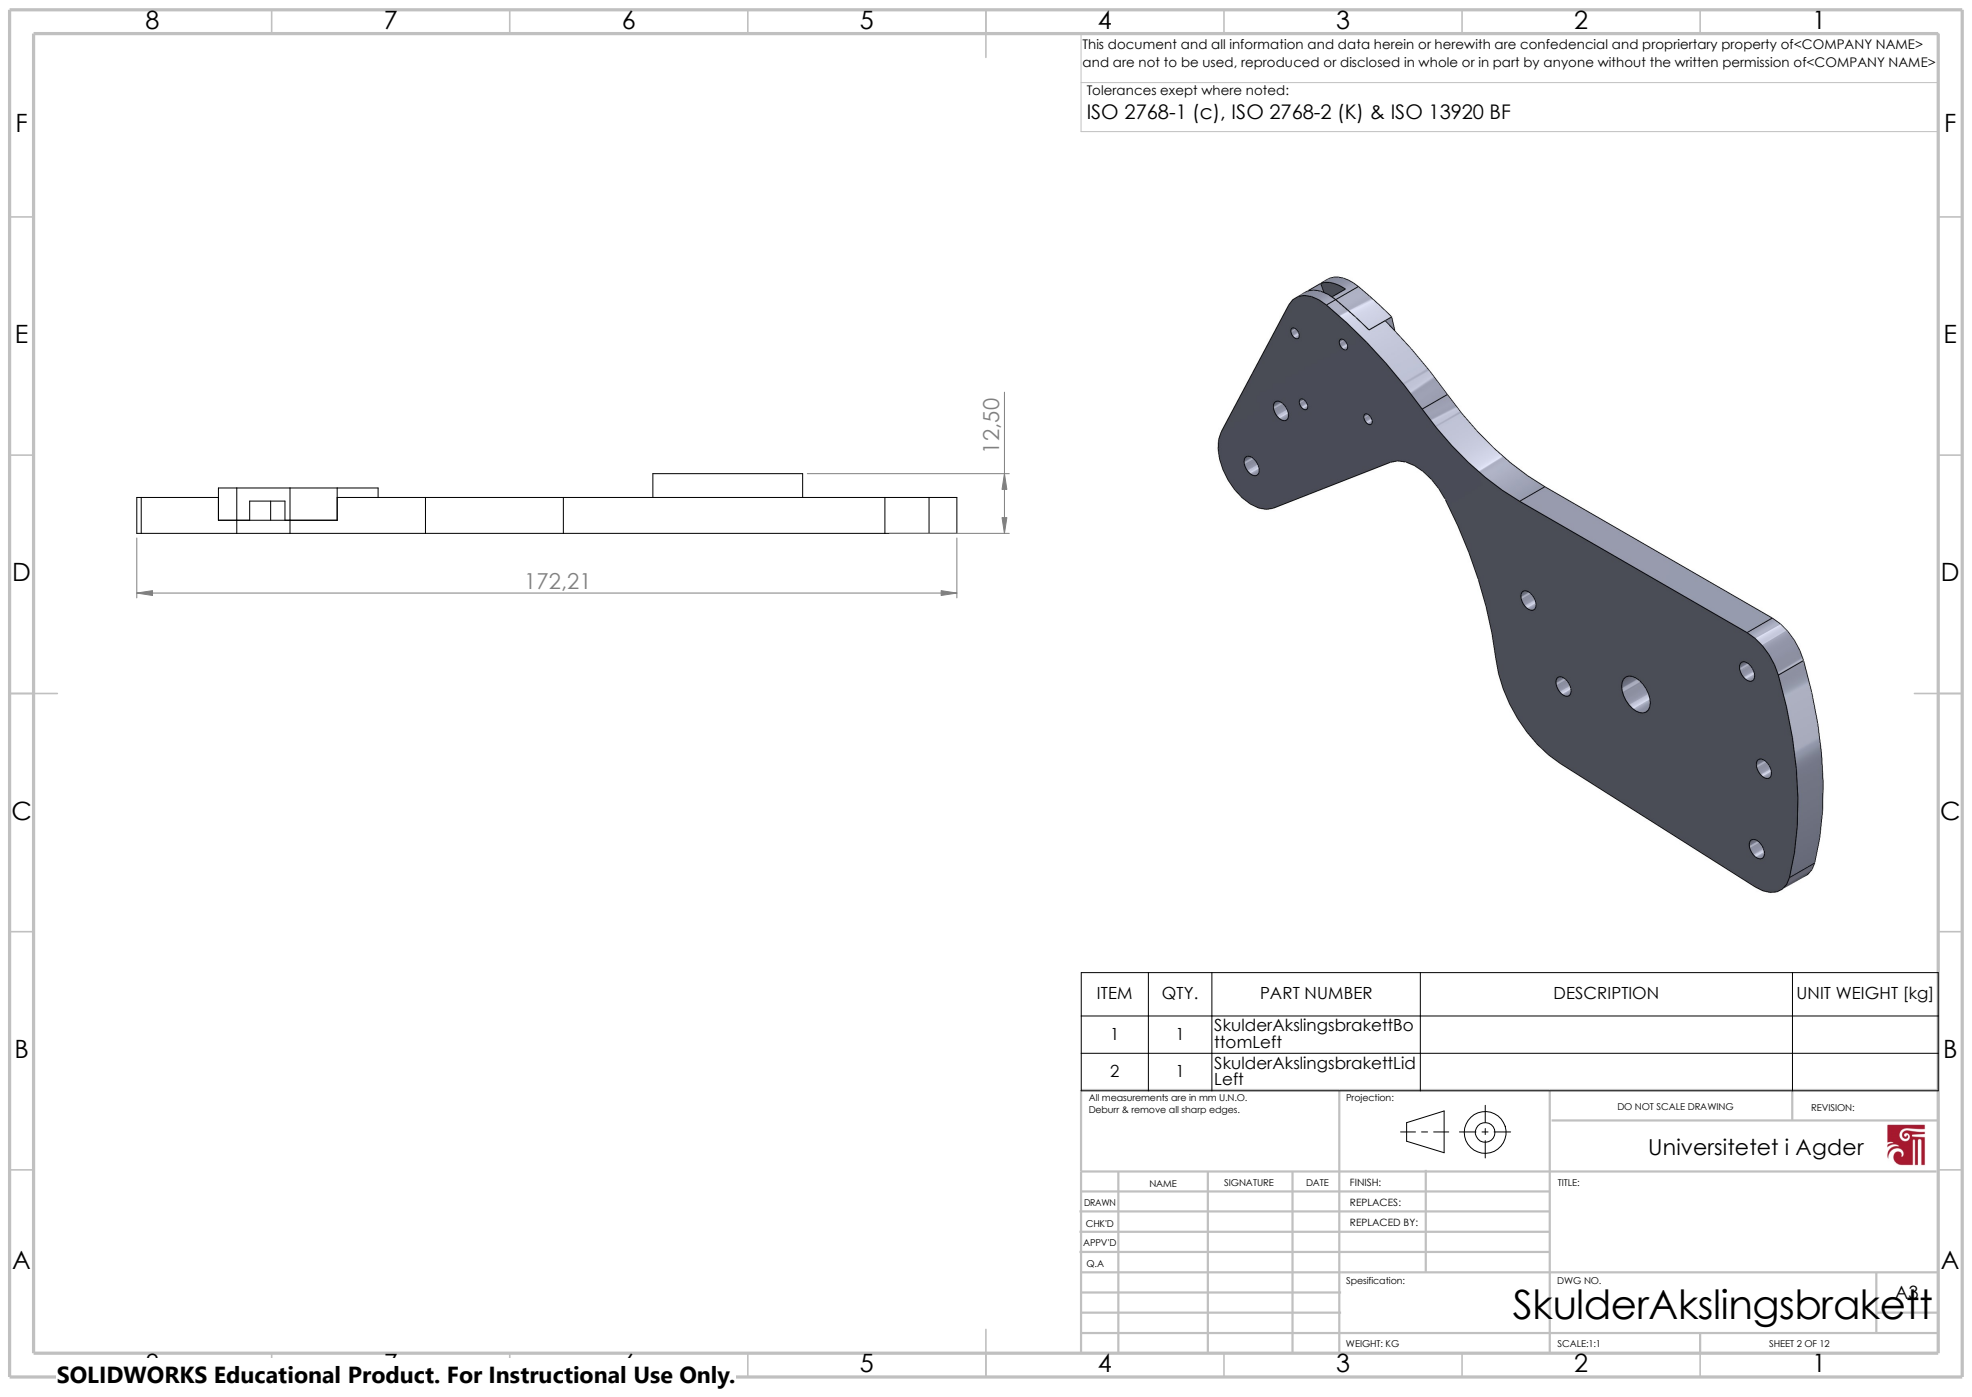
[picture p247: page 2]
SCALE:1:1; SHEET 2 OF 12; Universitetet i Agder

Deburr & remove all sharp edges. 12,50

ITEM | QTY. | PART NUMBER | DESCRIPTION | UNIT WEIGHT [kg]
1 | 1 | SkulderAkslingsbrakettBo ttomLeft
2 | 1 | SkulderAkslingsbrakettLid Left

All measurements are in mm U.N.O. | Projection: | | DO NOT SCALE DRAWING | REVISION:

NAME | SIGNATURE | DATE | FINISH: | TITLE:

DRAWN | | | | REPLACES:

CHK'D | | | | REPLACED BY:
APPV'D

## ISO 2768-1 (c), ISO 2768-2 (K) & ISO 13920 BF

E E

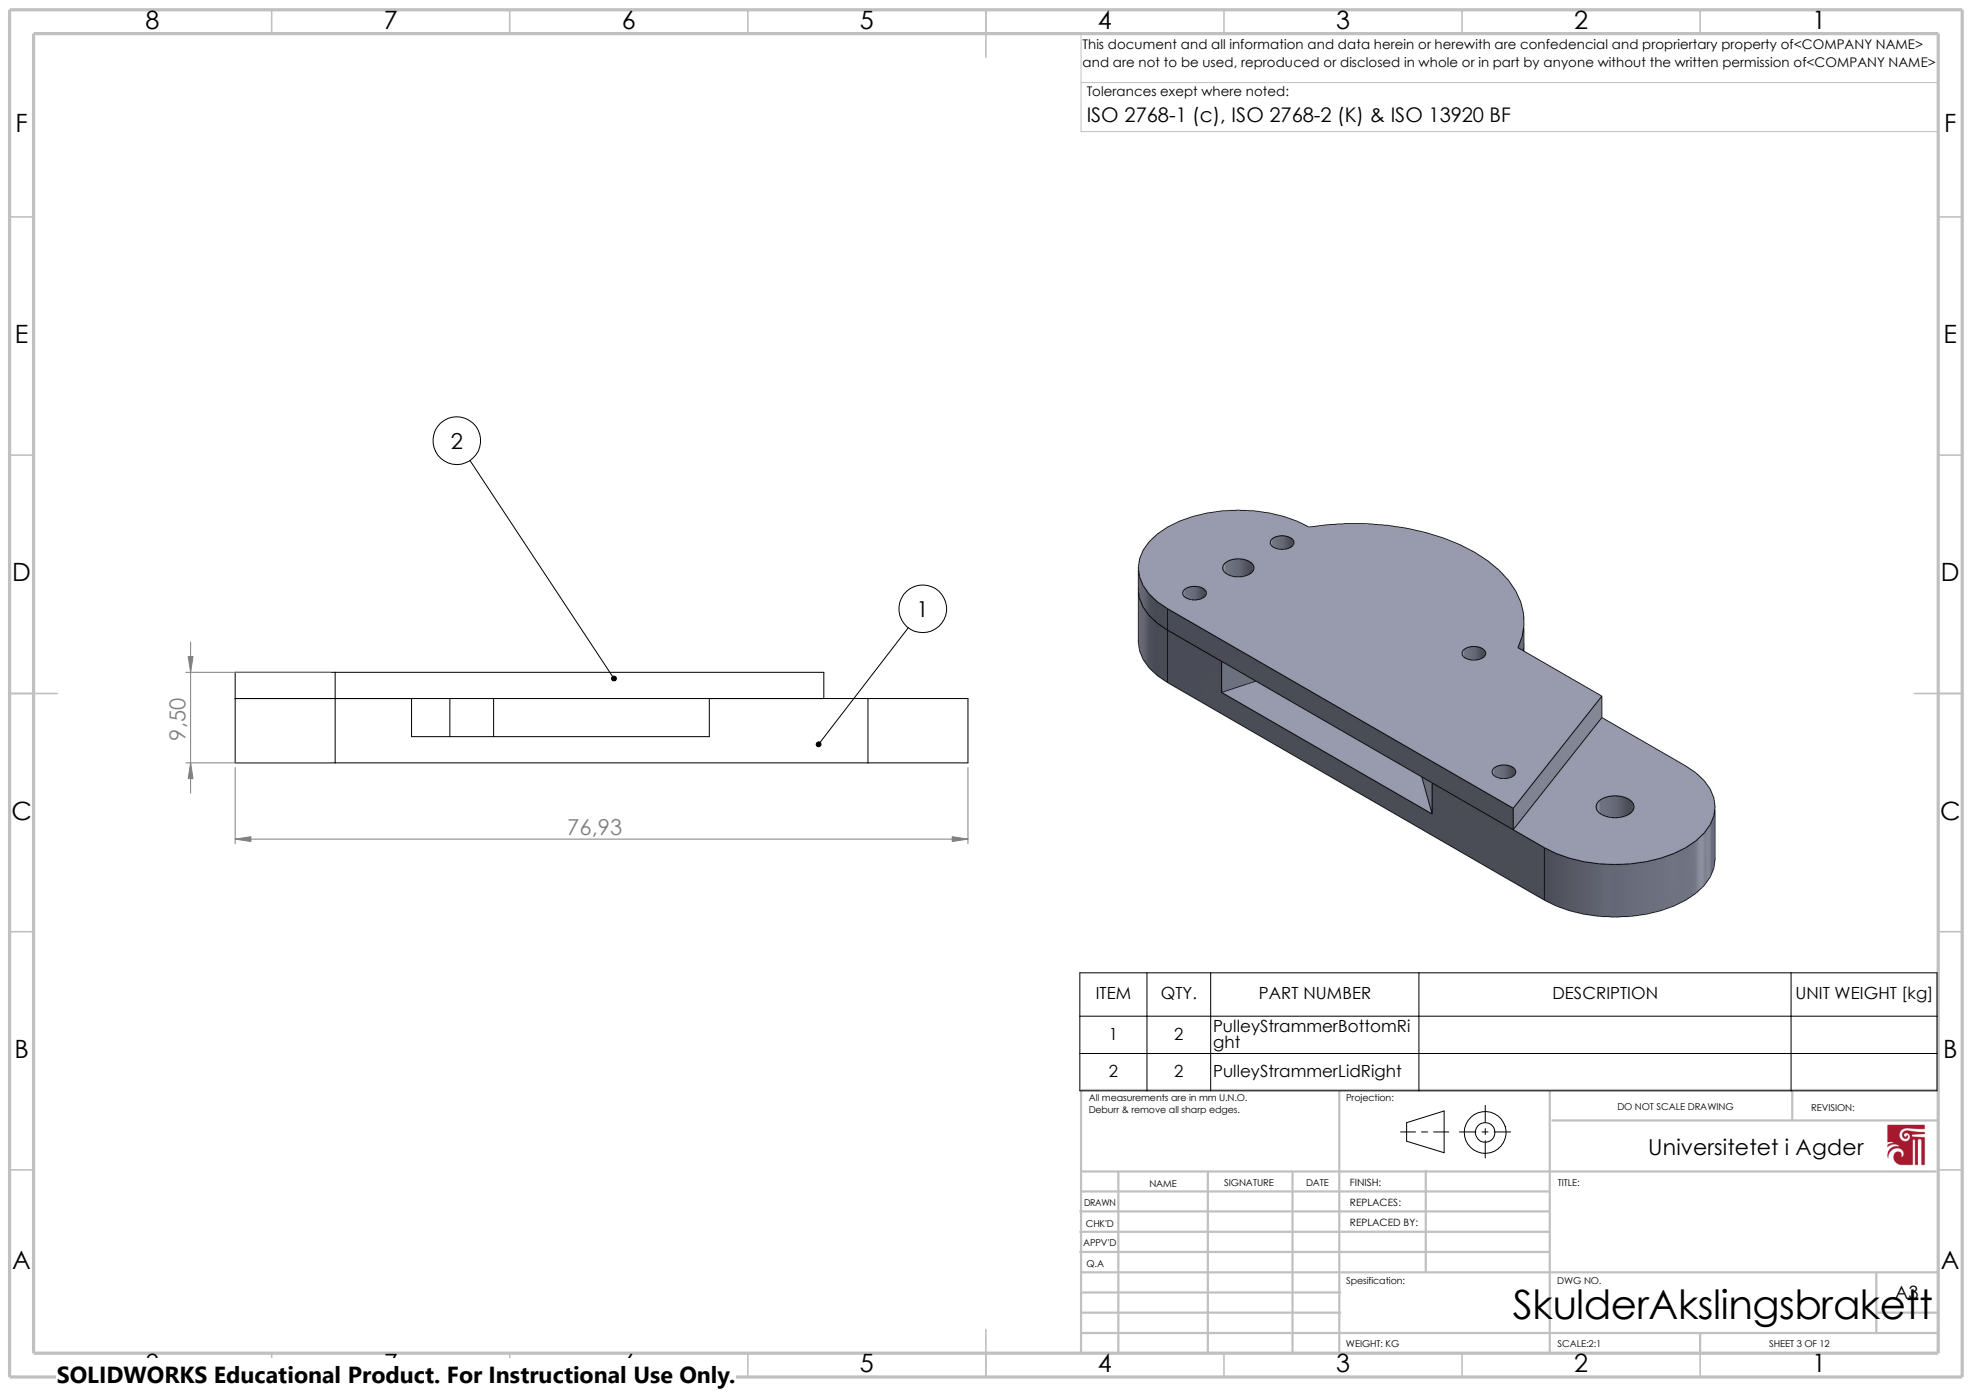
[picture p248: page 3]
SCALE:2:1; SHEET 3 OF 12; Universitetet i Agder

ITEM | QTY. | PART NUMBER | DESCRIPTION | UNIT WEIGHT [kg]
1 | 2 | PulleyStrammerBottomRi ght

2 | 2 | PulleyStrammerLidRight

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

NAME | SIGNATURE | DATE | FINISH: | TITLE:

DRAWN | | | | REPLACES:

CHK'D | | | | REPLACED BY:
APPV'D

## ISO 2768-1 (c), ISO 2768-2 (K) & ISO 13920 BF

E E

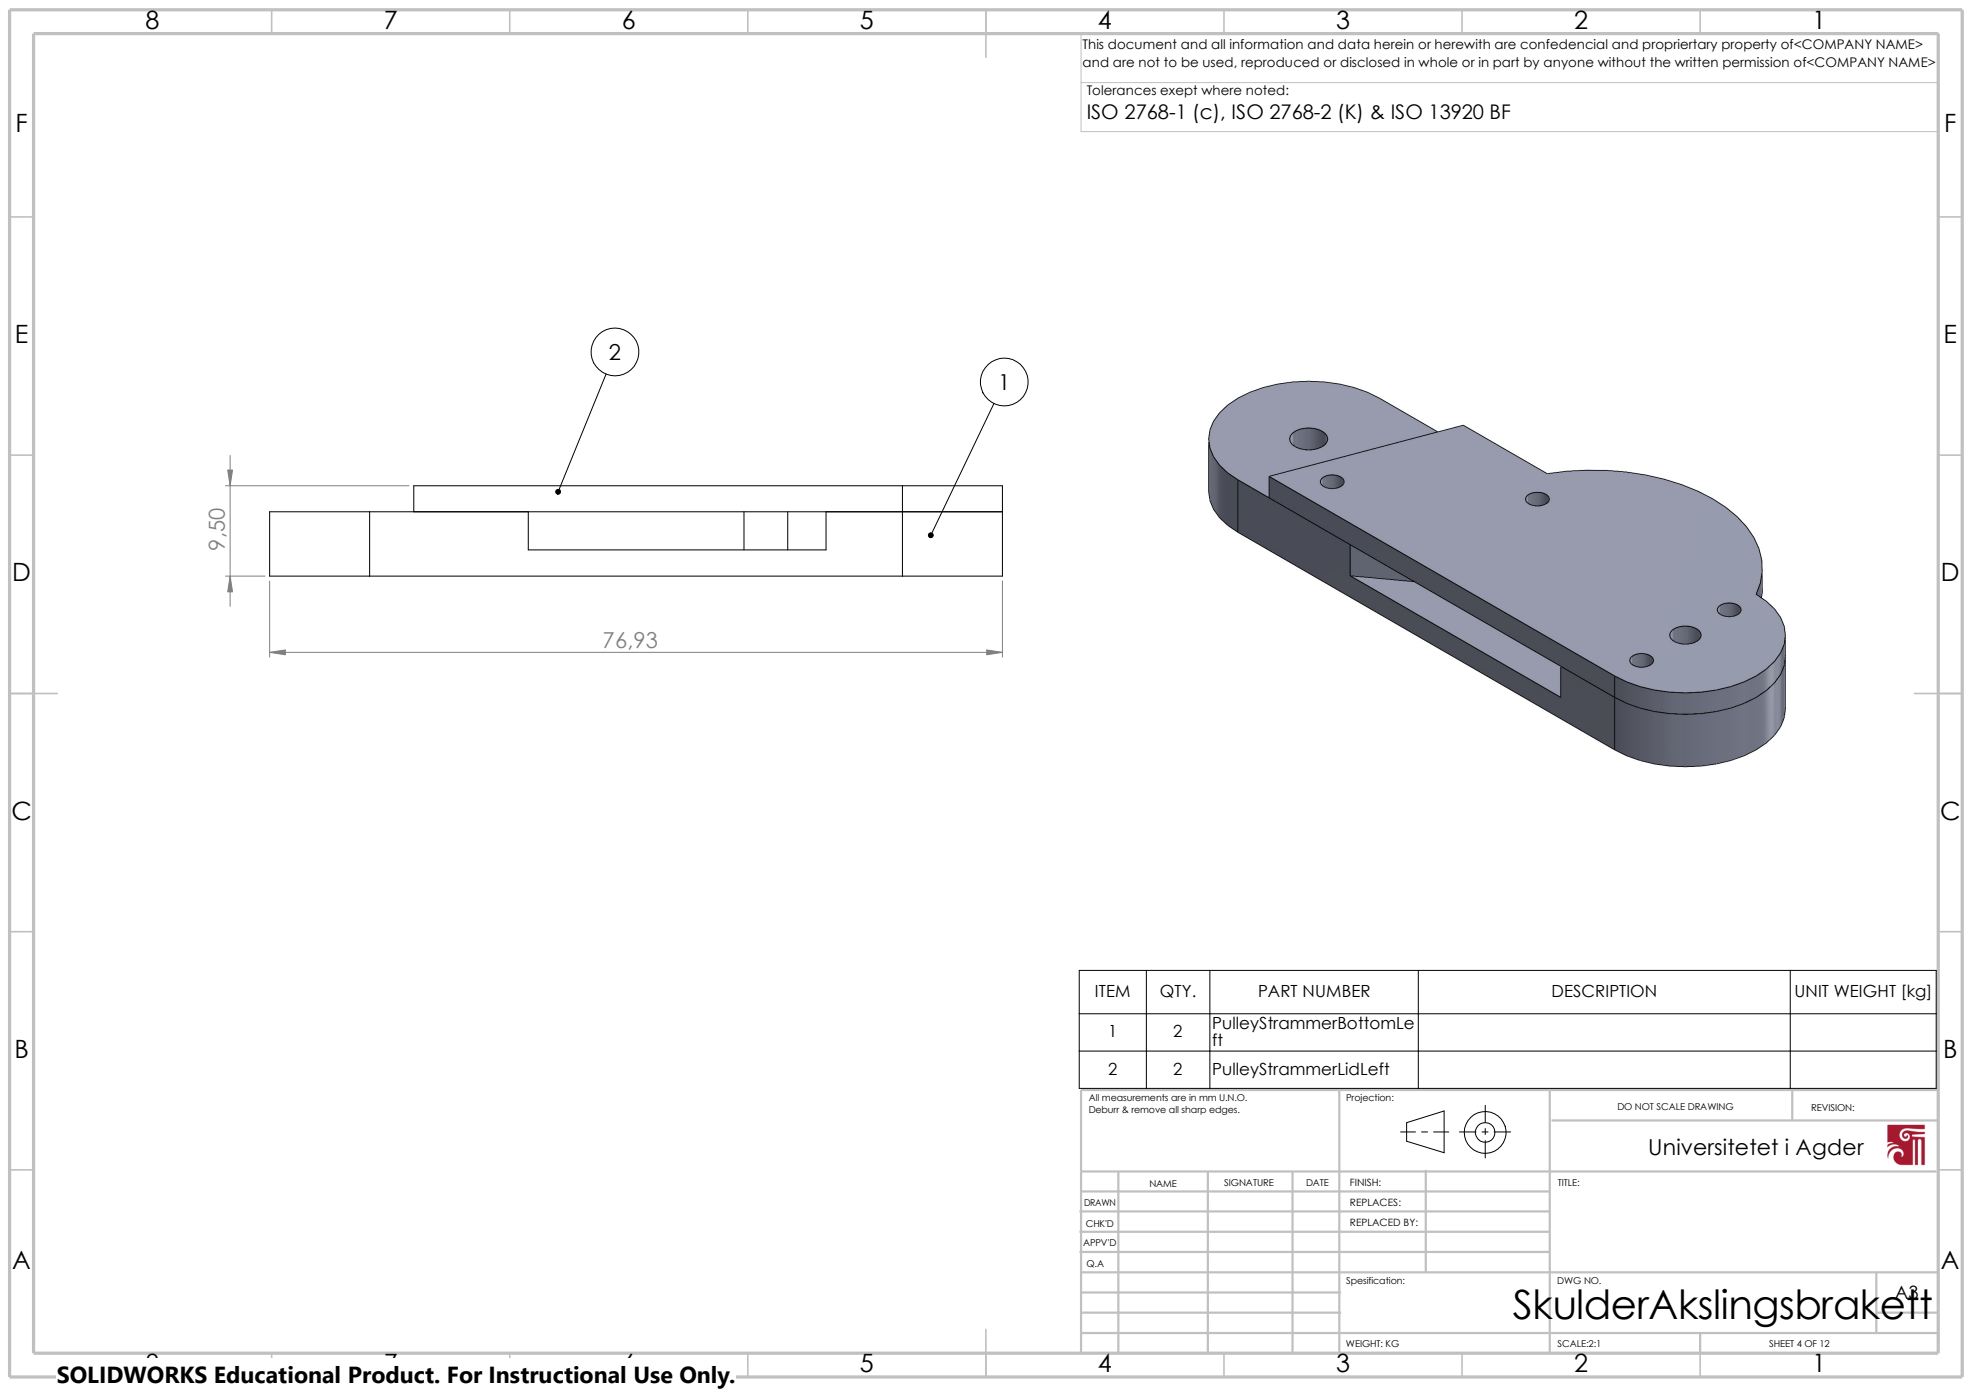
[picture p249: page 4]
SCALE:2:1; SHEET 4 OF 12; Universitetet i Agder

ITEM | QTY. | PART NUMBER | DESCRIPTION | UNIT WEIGHT [kg]
1 | 2 | PulleyStrammerBottomLe ft

2 | 2 | PulleyStrammerLidLeft

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

NAME | SIGNATURE | DATE | FINISH: | TITLE:

DRAWN | | | | REPLACES:

CHK'D | | | | REPLACED BY:
APPV'D

## ISO 2768-1 (c), ISO 2768-2 (K) & ISO 13920 BF

E E

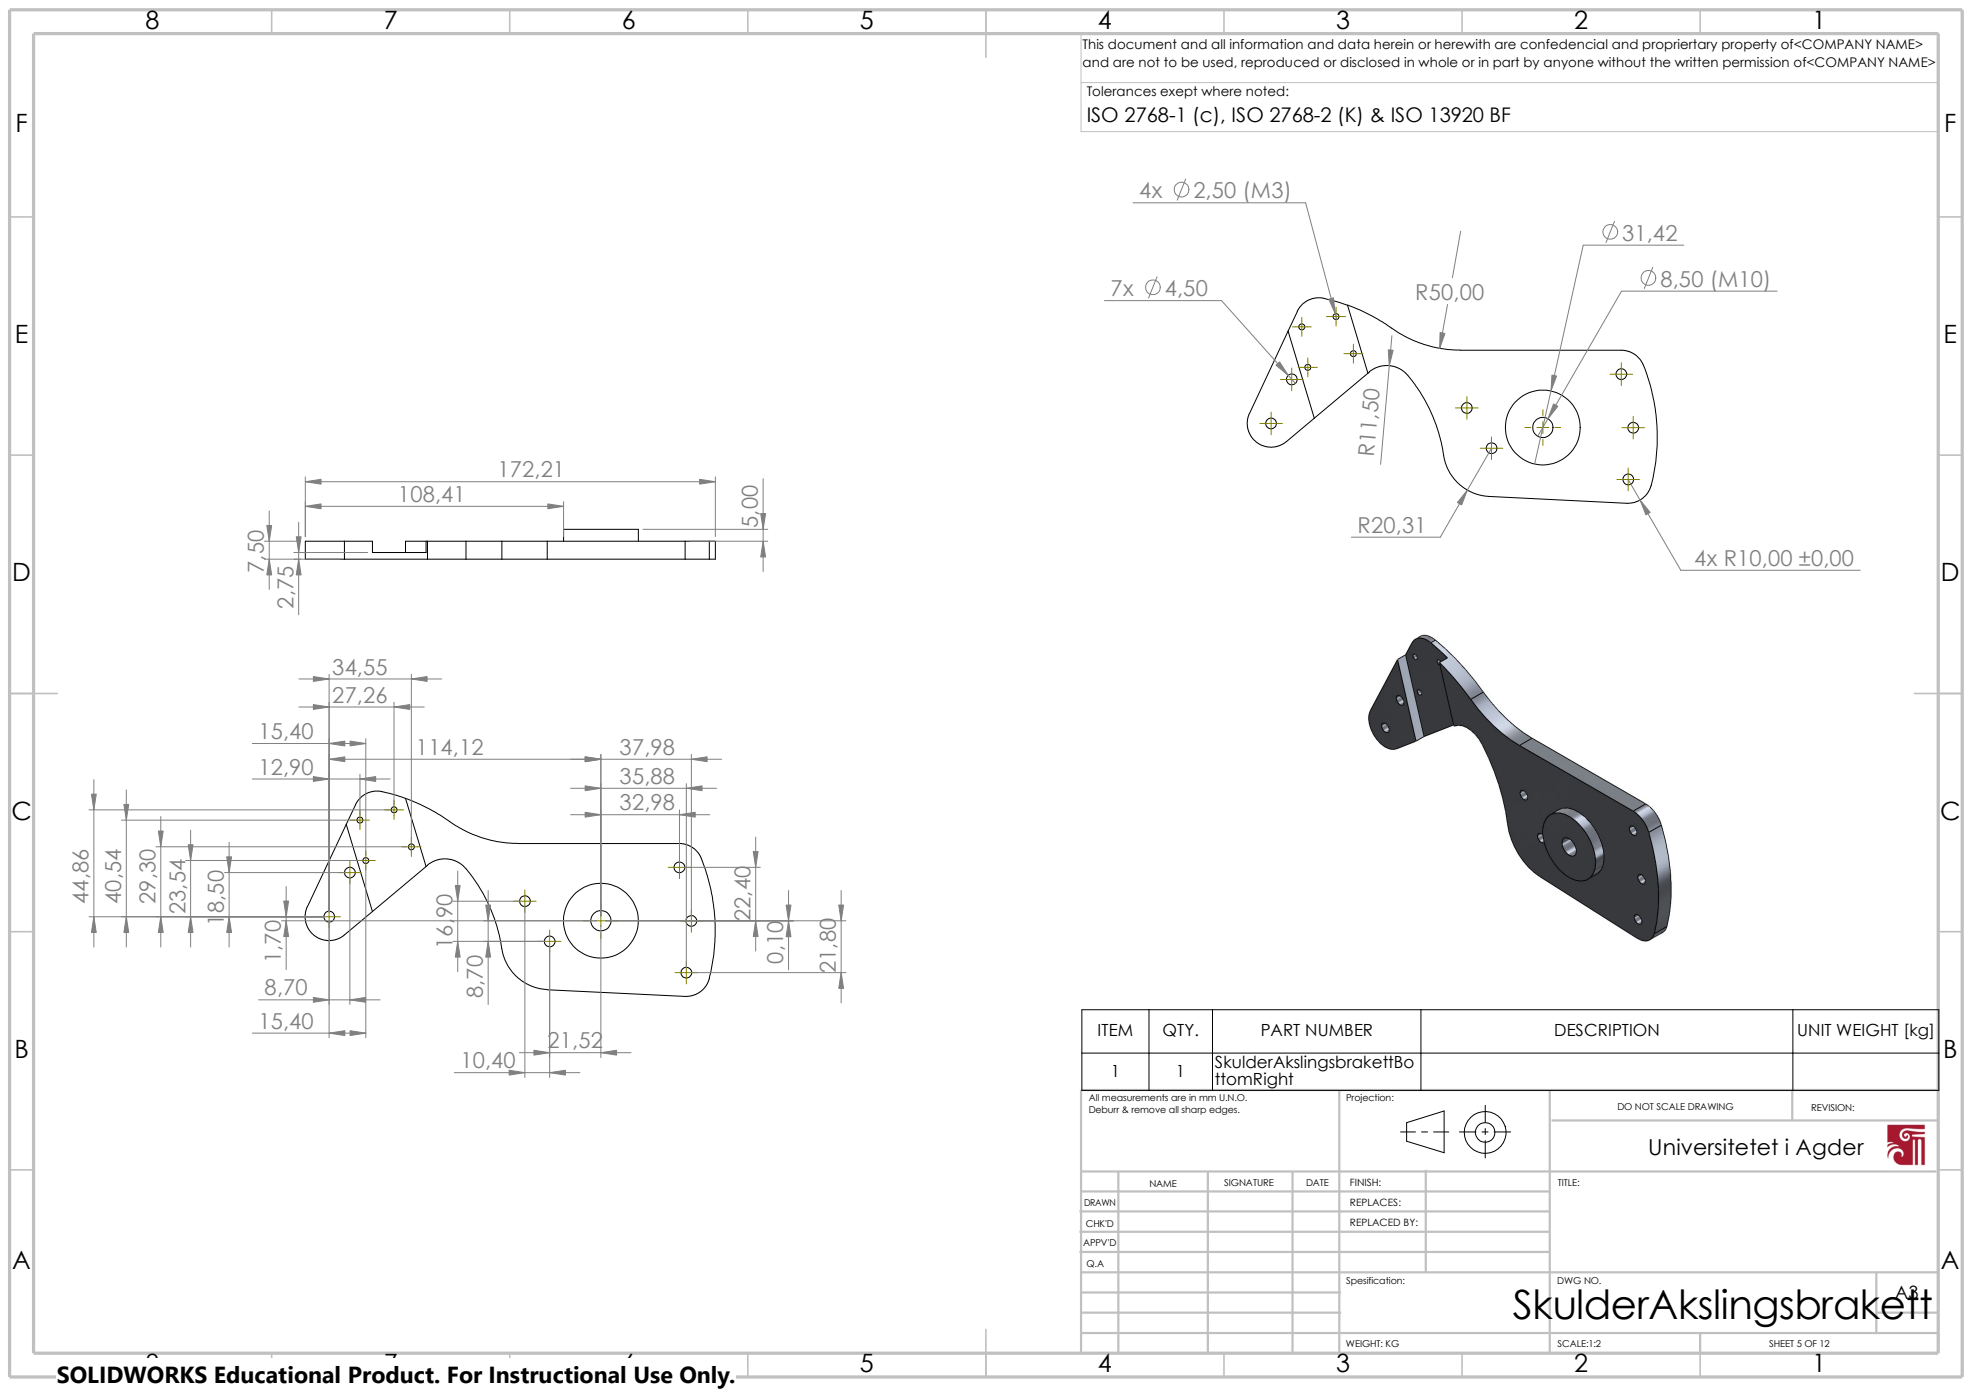
[picture p250: page 5]
SCALE:1:2; SHEET 5 OF 12; Universitetet i Agder

ITEM | QTY. | PART NUMBER | DESCRIPTION | UNIT WEIGHT [kg]
1 | 1 | SkulderAkslingsbrakettBo ttomRight

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

NAME | SIGNATURE | DATE | FINISH: | TITLE:

DRAWN | | | | REPLACES:

CHK'D | | | | REPLACED BY:
APPV'D

## ISO 2768-1 (c), ISO 2768-2 (K) & ISO 13920 BF

E E

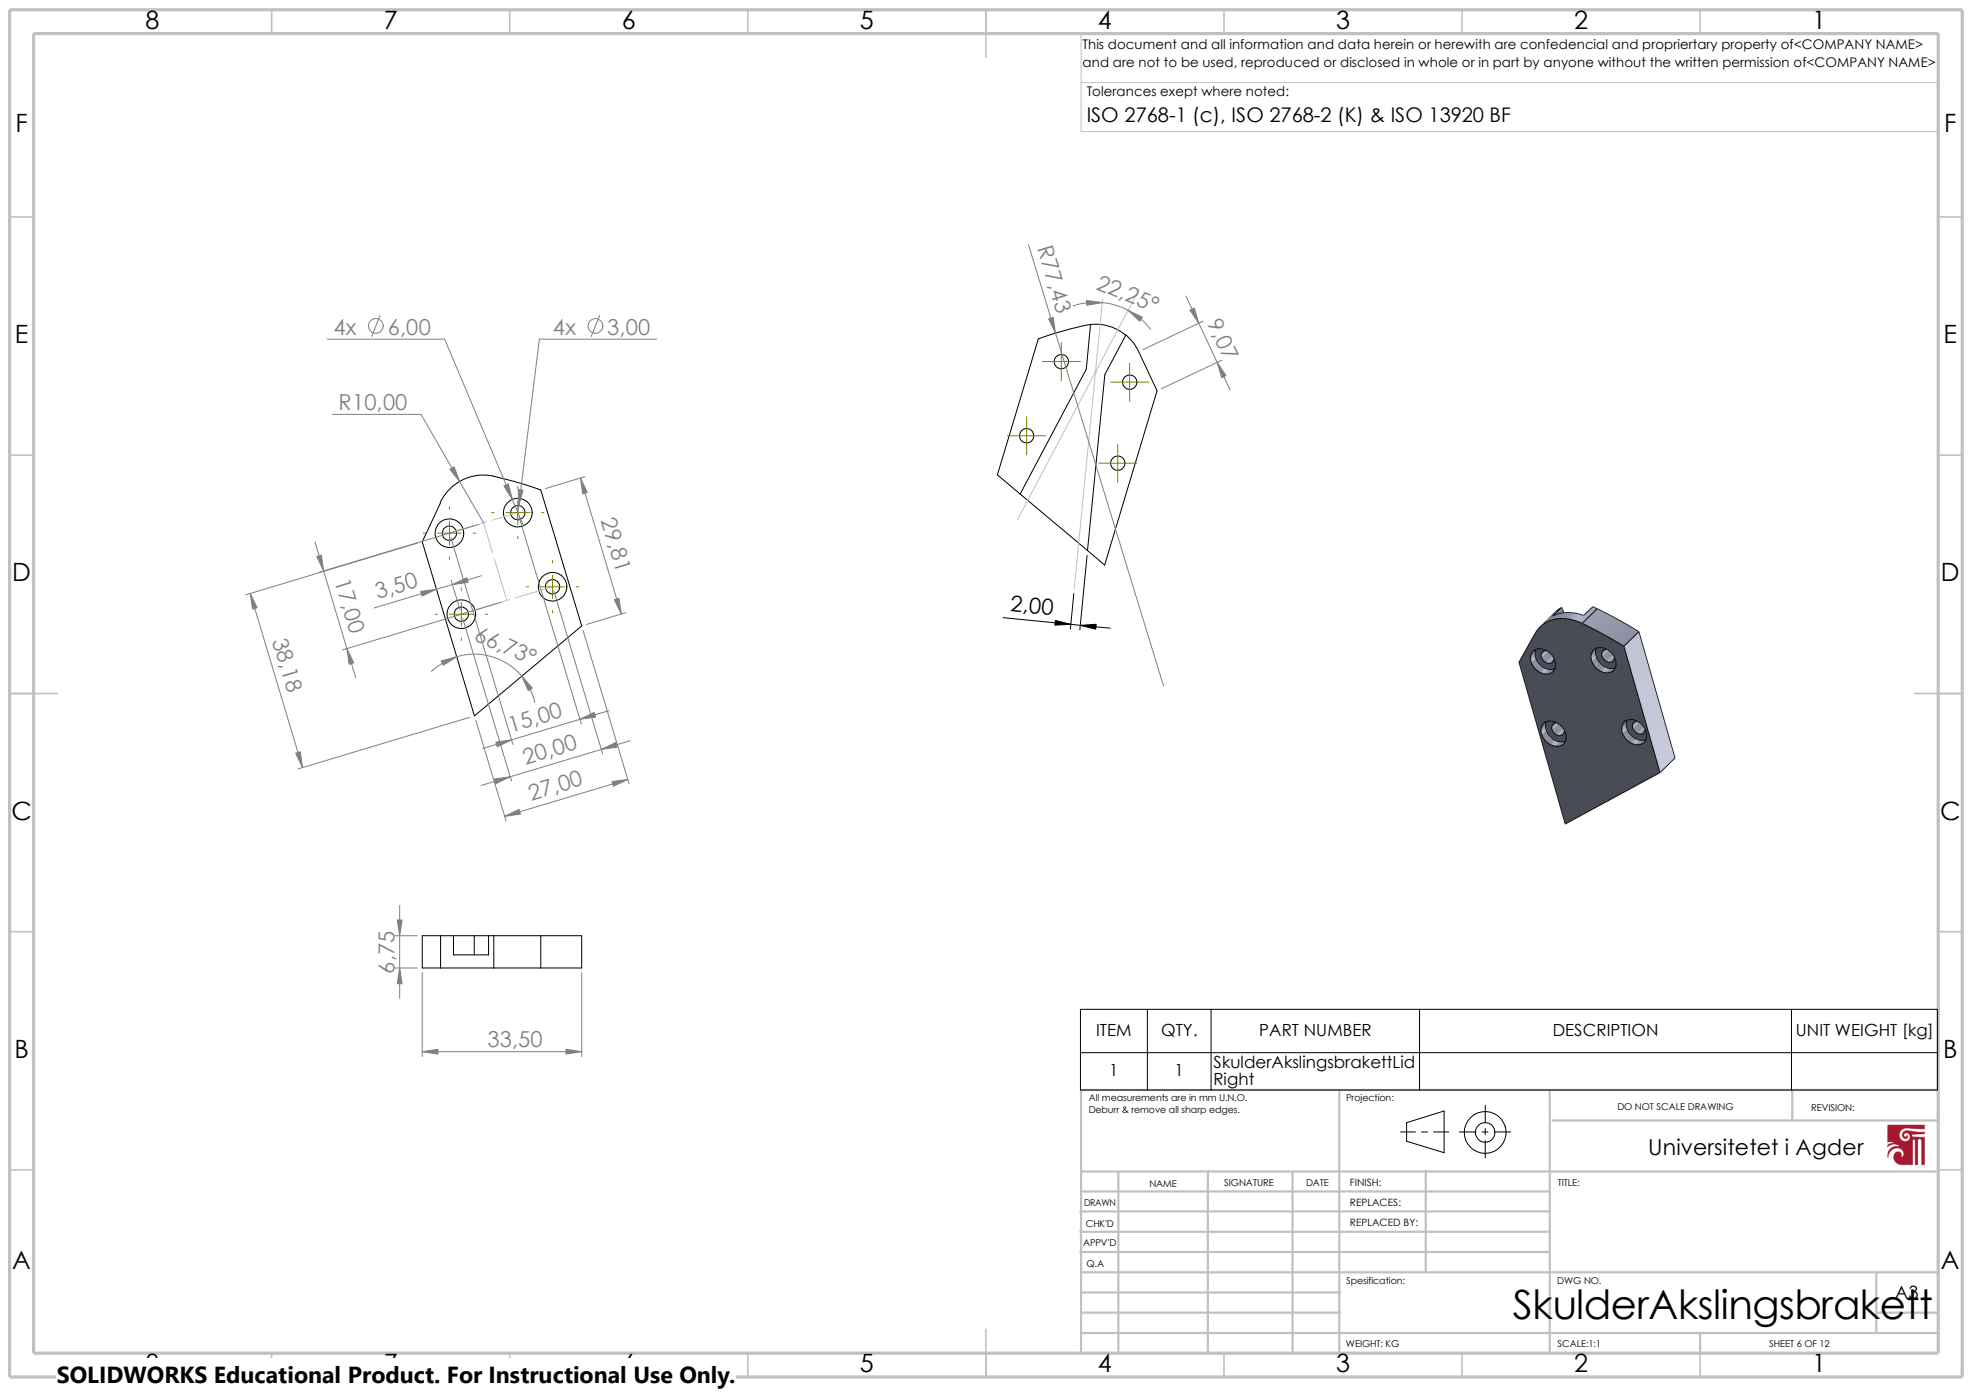
[picture p251: page 6]
SCALE:1:1; SHEET 6 OF 12; Universitetet i Agder

ITEM | QTY. | PART NUMBER | DESCRIPTION | UNIT WEIGHT [kg]
1 | 1 | SkulderAkslingsbrakettLid Right

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

NAME | SIGNATURE | DATE | FINISH: | TITLE:

DRAWN | | | | REPLACES:

CHK'D | | | | REPLACED BY:
APPV'D

## ISO 2768-1 (c), ISO 2768-2 (K) & ISO 13920 BF

E E

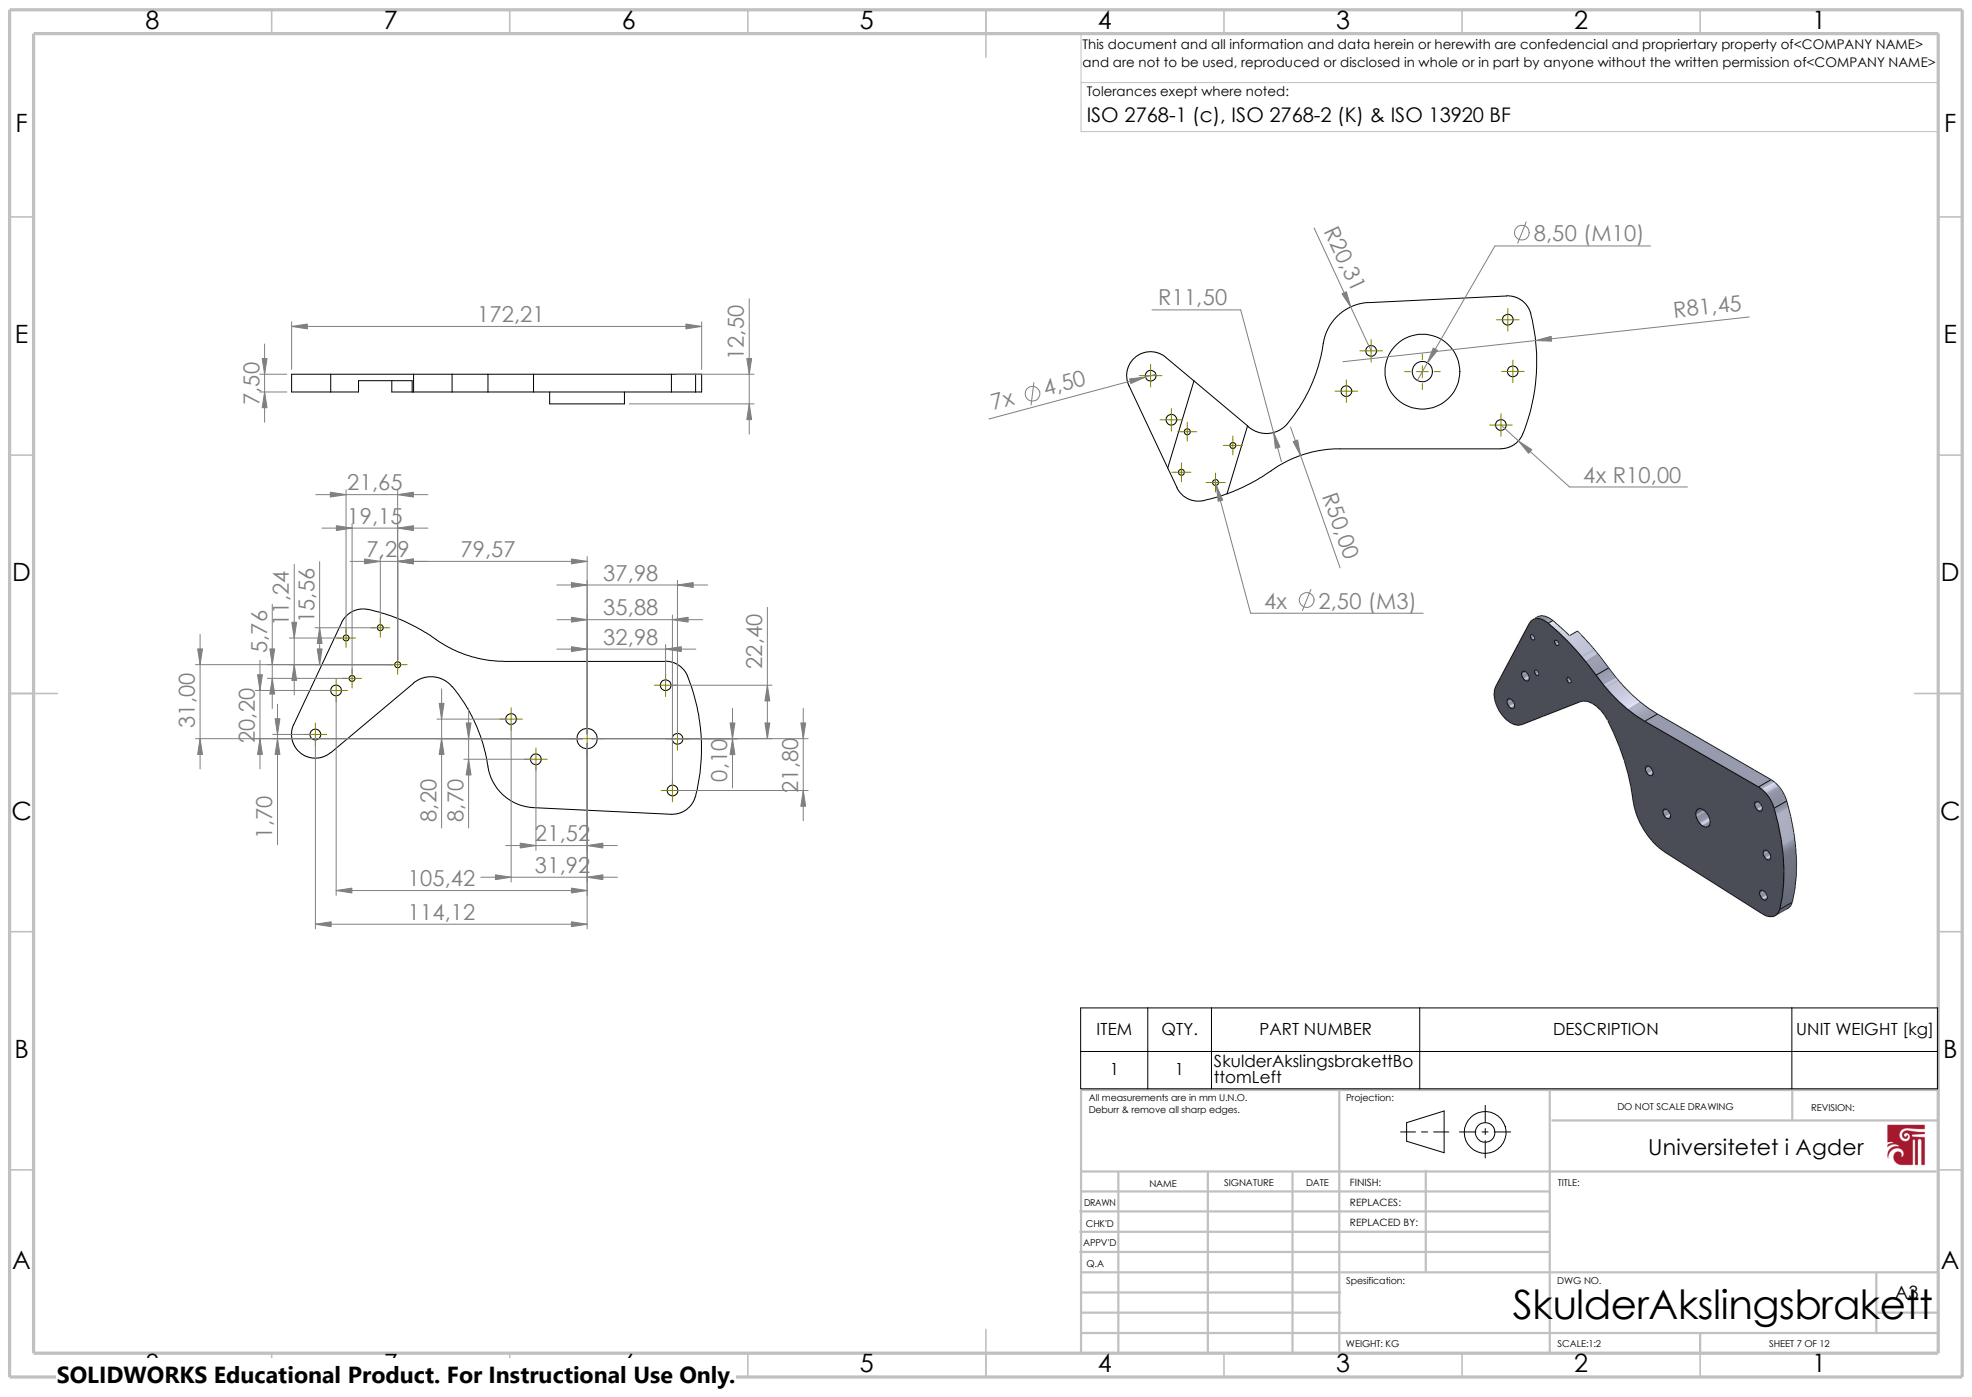
[picture p252: page 7]
SCALE:1:2; SHEET 7 OF 12; Universitetet i Agder

ITEM | QTY. | PART NUMBER | DESCRIPTION | UNIT WEIGHT [kg]
1 | 1 | SkulderAkslingsbrakettBo ttomLeft

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

NAME | SIGNATURE | DATE | FINISH: | TITLE:

DRAWN | | | | REPLACES:

CHK'D | | | | REPLACED BY:
APPV'D

## ISO 2768-1 (c), ISO 2768-2 (K) & ISO 13920 BF

E E

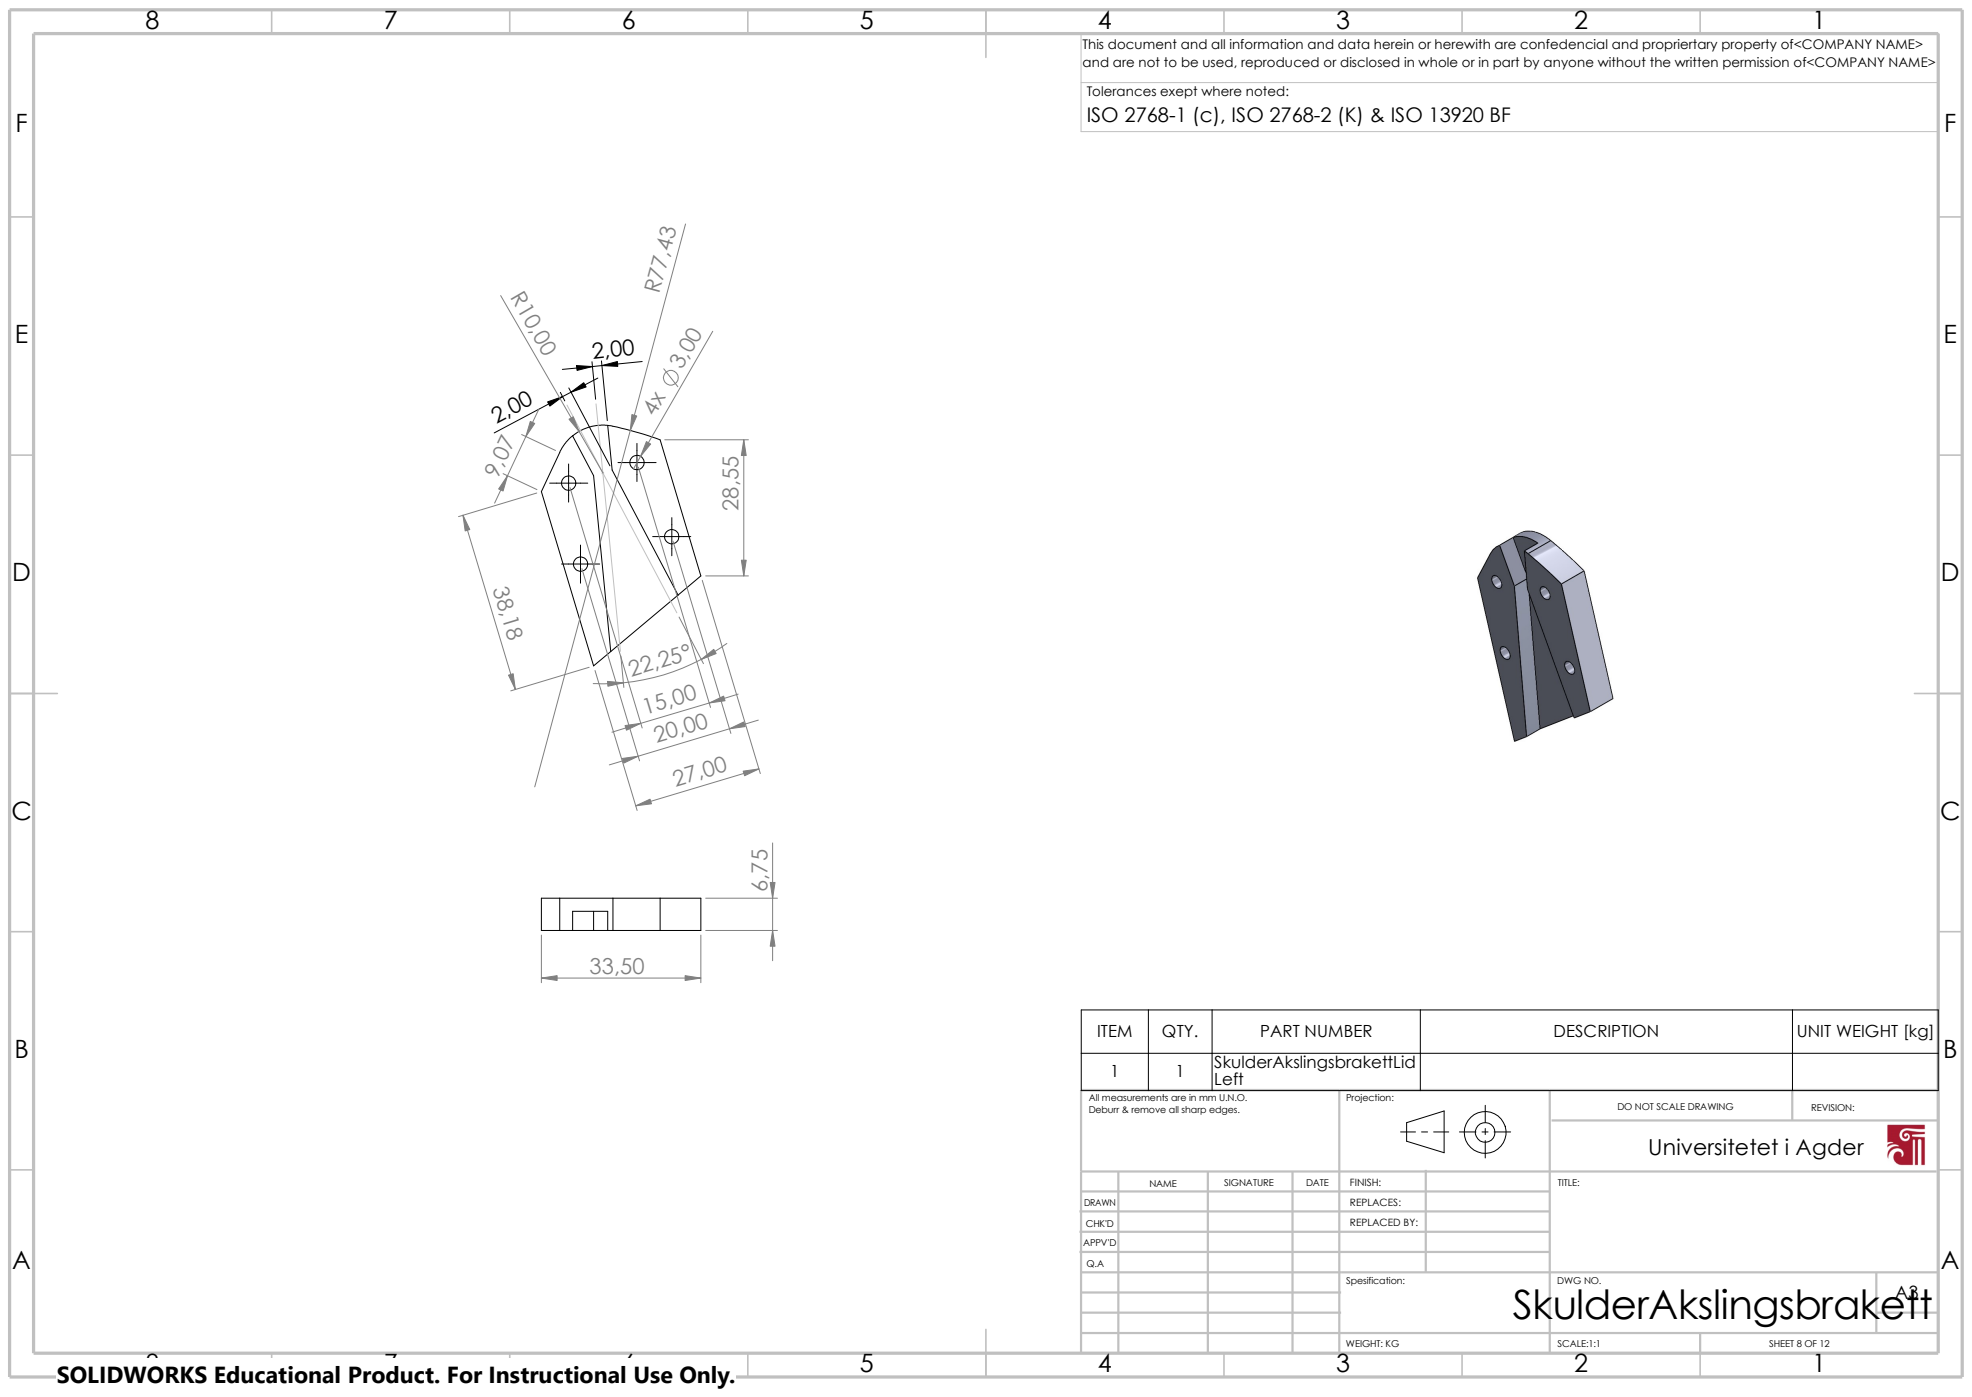
[picture p253: page 8]
SCALE:1:1; SHEET 8 OF 12; Universitetet i Agder; Left ⁶,75

ITEM | QTY. | PART NUMBER | DESCRIPTION | UNIT WEIGHT [kg]
1 | 1 | SkulderAkslingsbrakettLid

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

NAME | SIGNATURE | DATE | FINISH: | TITLE:

DRAWN | | | | REPLACES:

CHK'D | | | | REPLACED BY:
APPV'D

## ISO 2768-1 (c), ISO 2768-2 (K) & ISO 13920 BF

E E

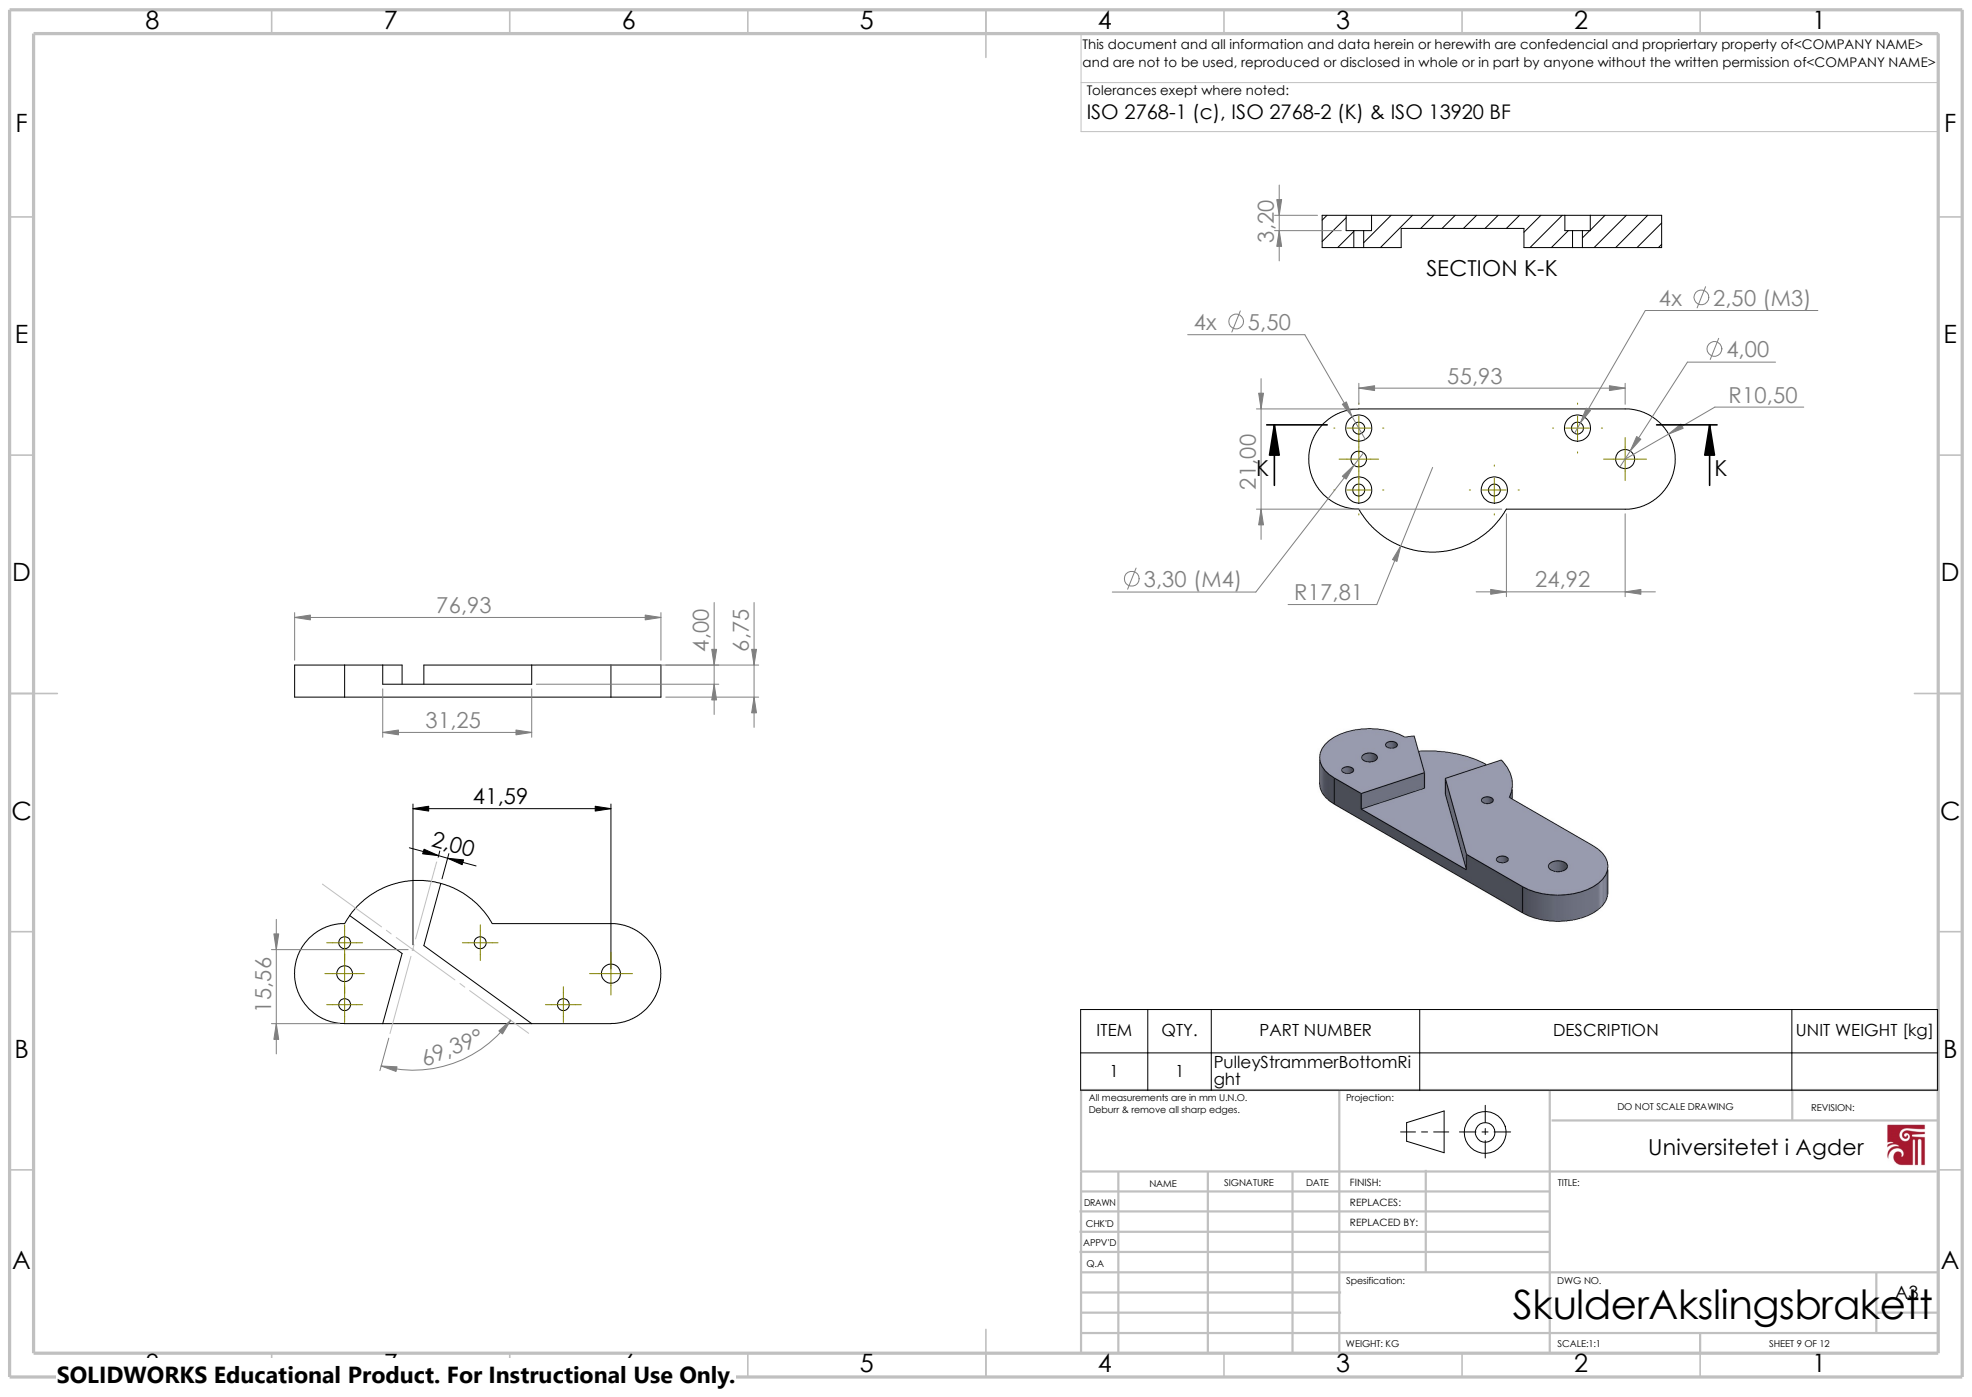
[picture p254: page 9]
SCALE:1:1; SHEET 9 OF 12; Universitetet i Agder; SECTION K-K ³,20

ITEM | QTY. | PART NUMBER | DESCRIPTION | UNIT WEIGHT [kg]
1 | 1 | PulleyStrammerBottomRi ght

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

NAME | SIGNATURE | DATE | FINISH: | TITLE:

DRAWN | | | | REPLACES:

CHK'D | | | | REPLACED BY:
APPV'D

## ISO 2768-1 (c), ISO 2768-2 (K) & ISO 13920 BF

E E

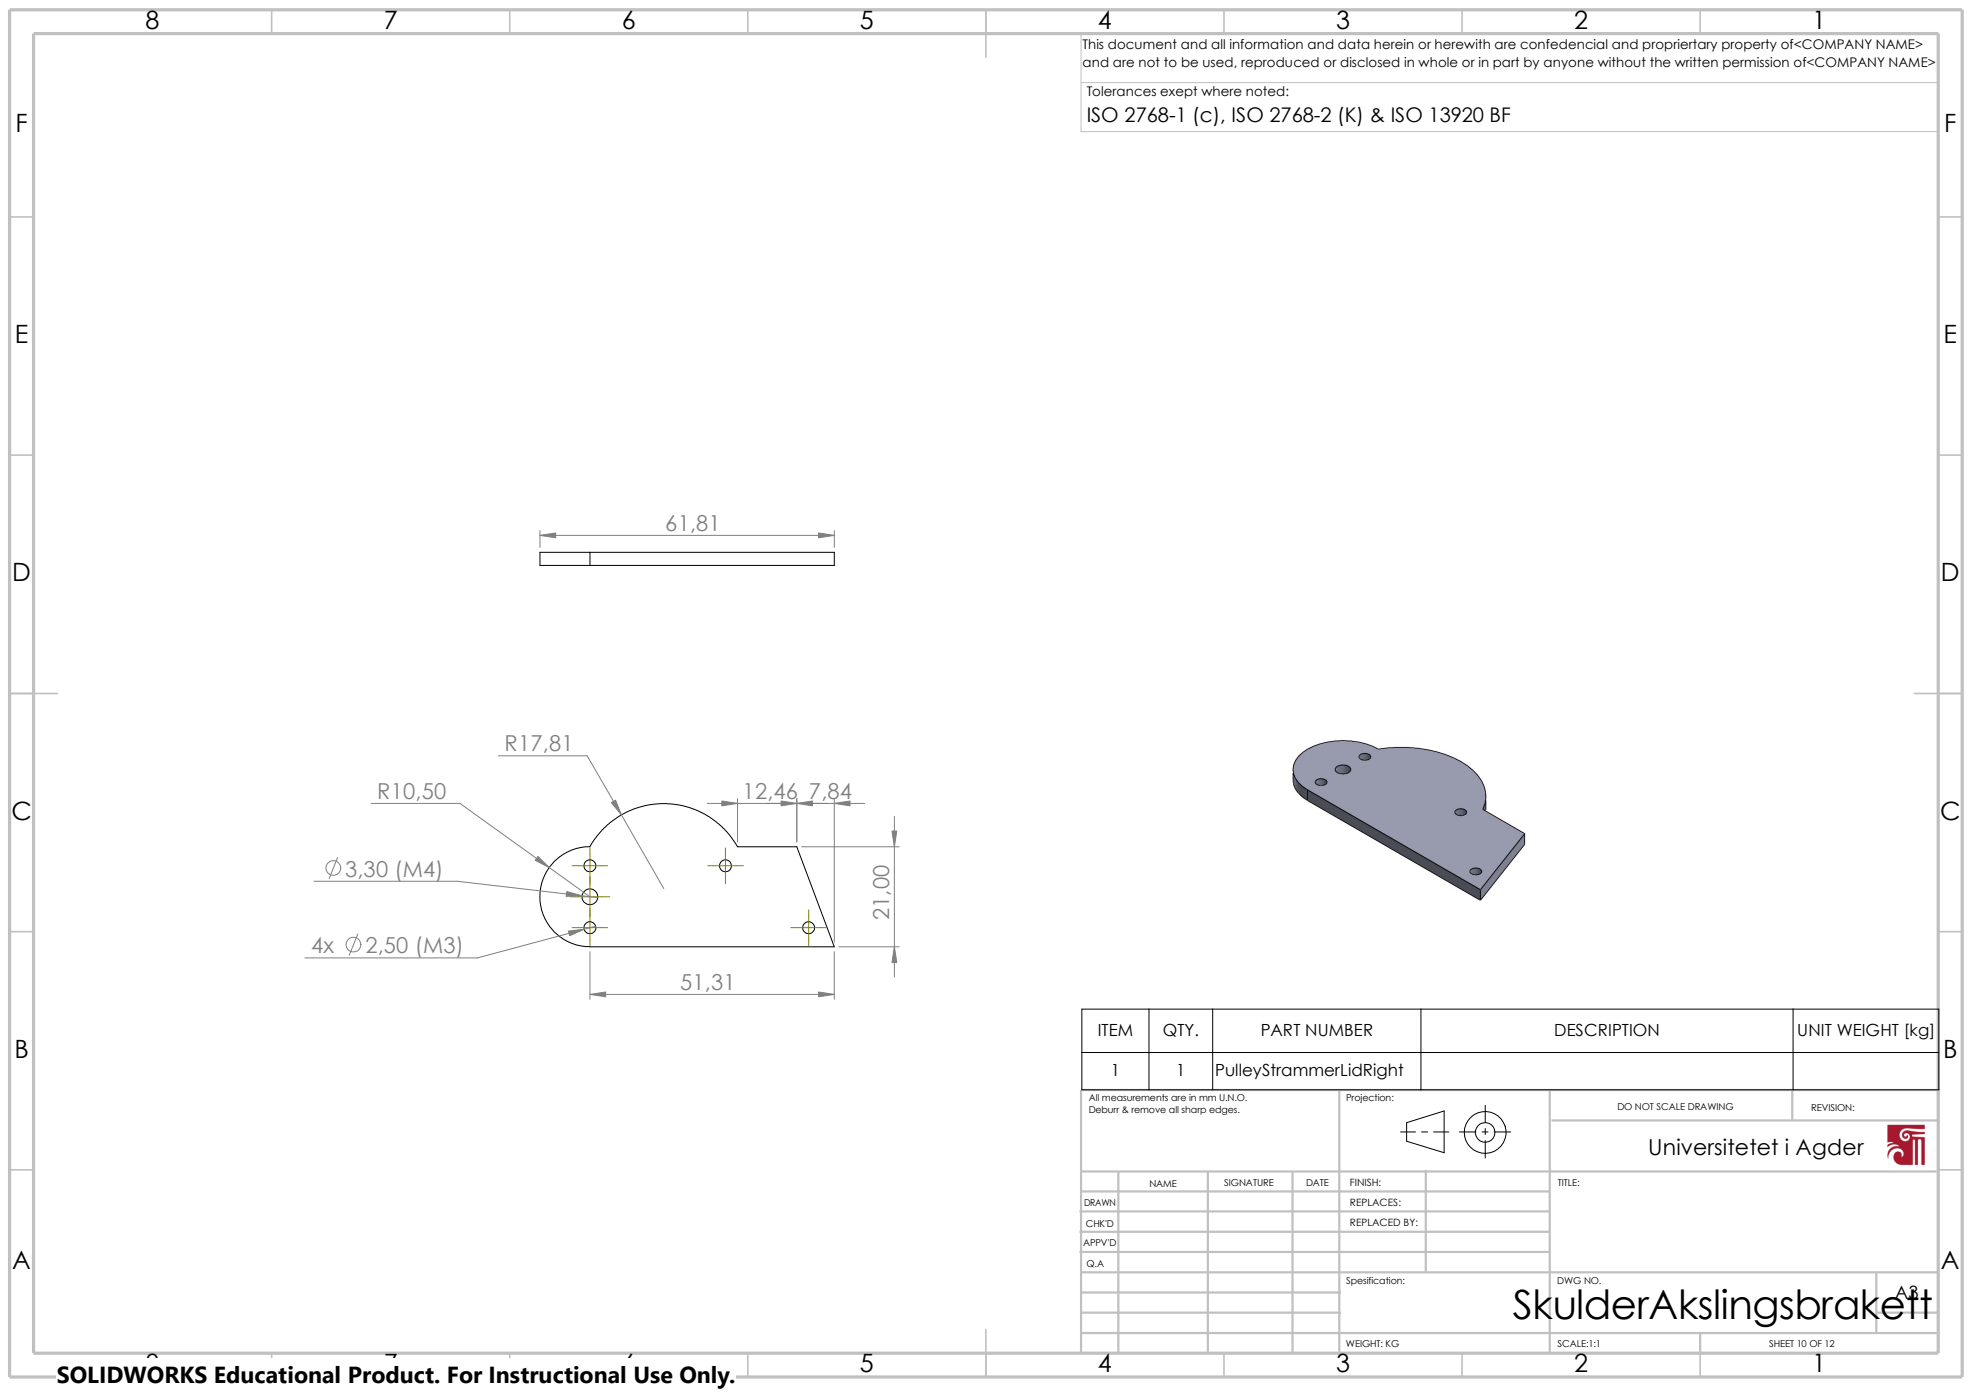
[picture p255: page 10]
SCALE:1:1; SHEET 10 OF 12; Universitetet i Agder

ITEM | QTY. | PART NUMBER | DESCRIPTION | UNIT WEIGHT [kg]

1 | 1 | PulleyStrammerLidRight

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

NAME | SIGNATURE | DATE | FINISH: | TITLE:

DRAWN | | | | REPLACES:

CHK'D | | | | REPLACED BY:
APPV'D

## ISO 2768-1 (c), ISO 2768-2 (K) & ISO 13920 BF

E E

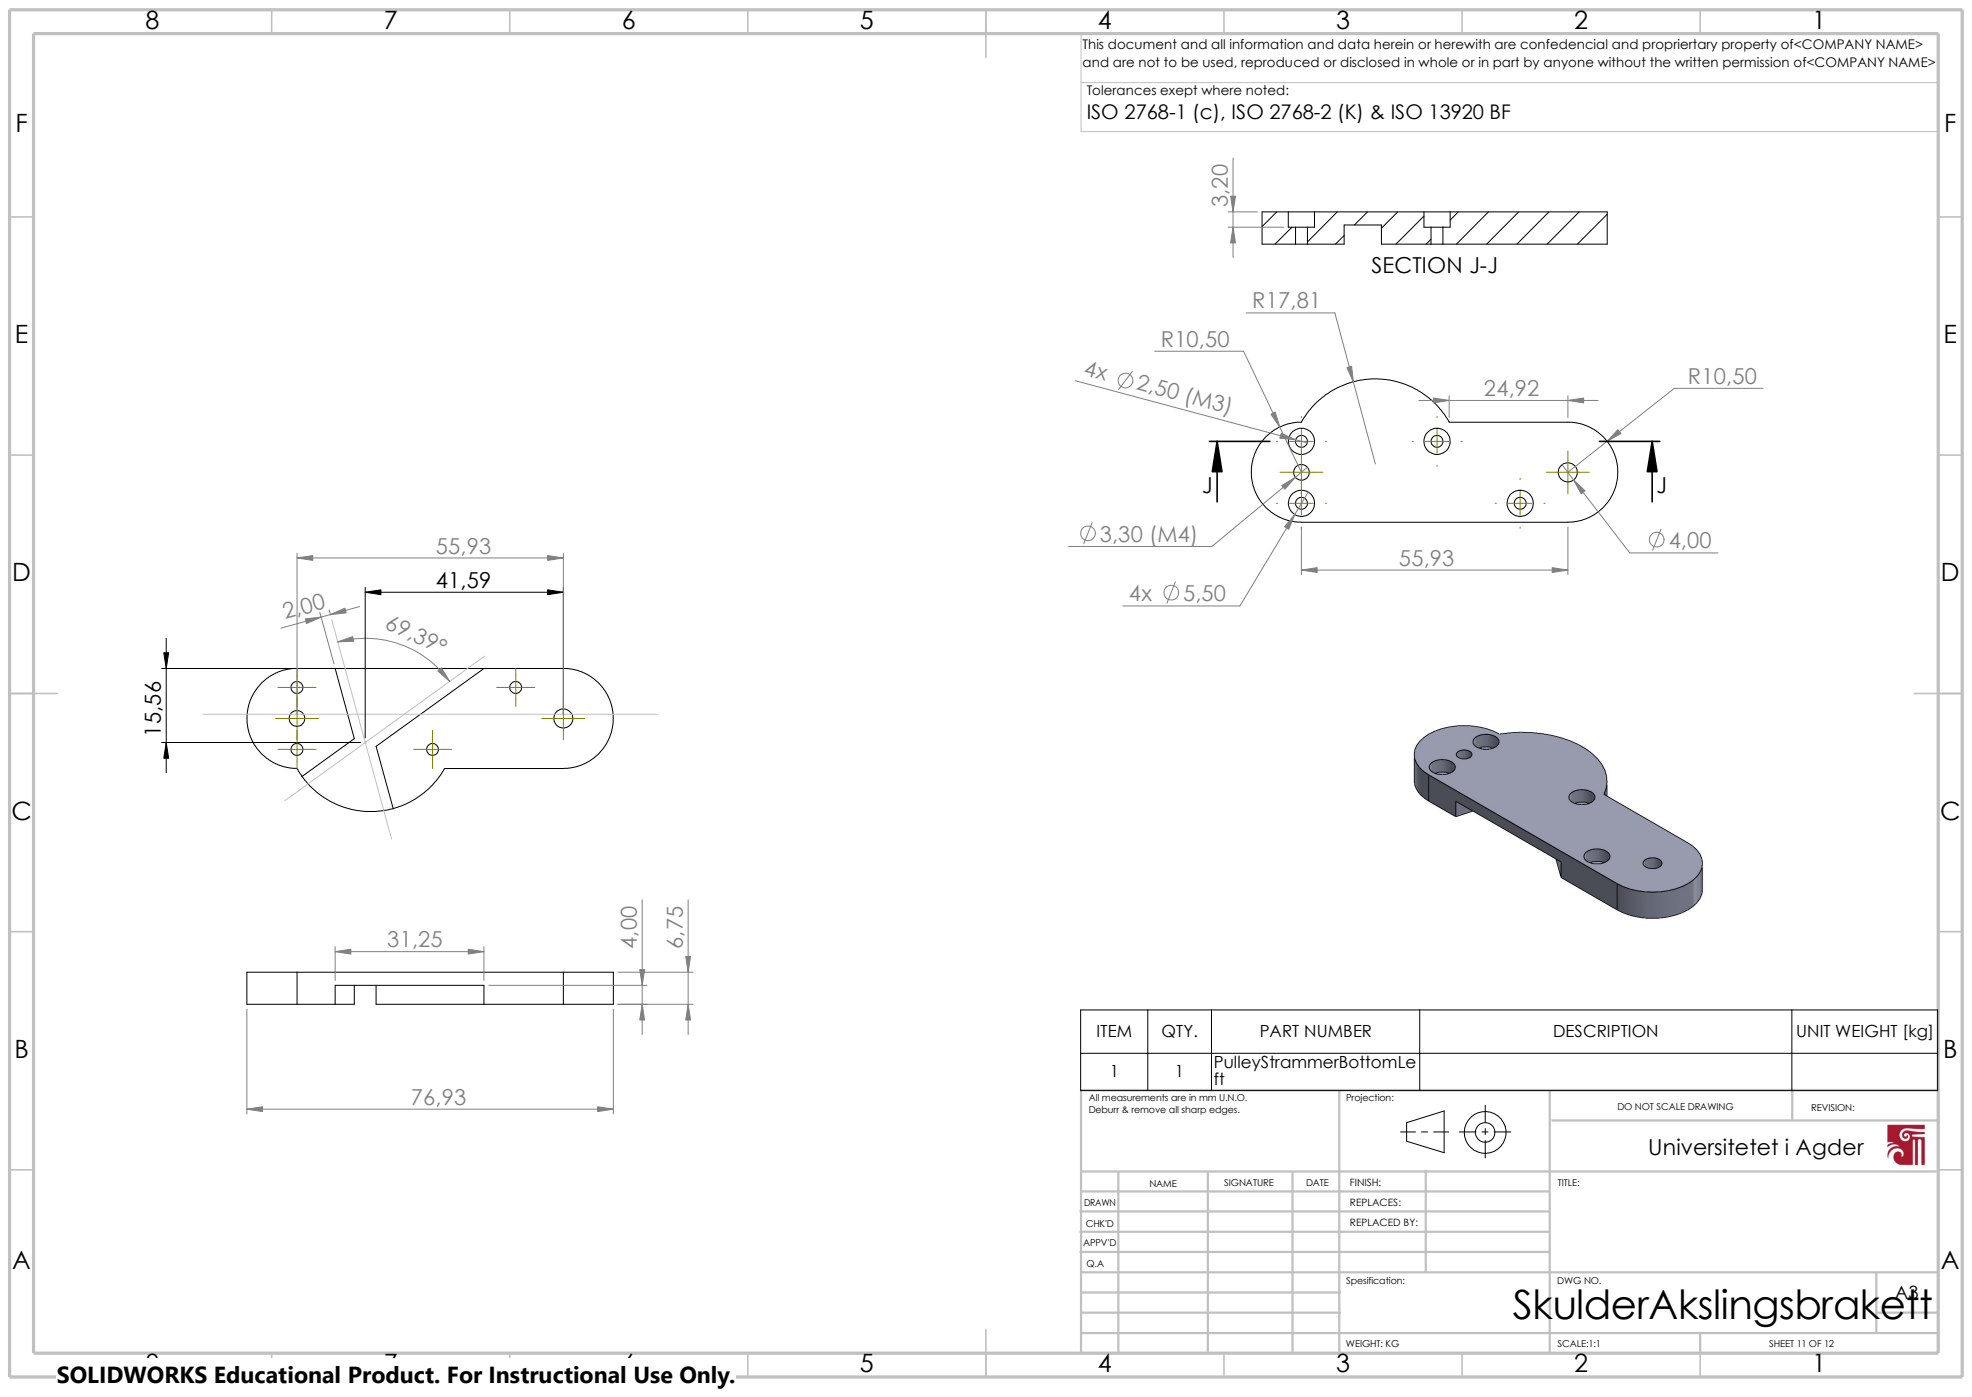
[picture p256: page 11]
SCALE:1:1; SHEET 11 OF 12; Universitetet i Agder; SECTION J-J ³,20

ITEM | QTY. | PART NUMBER | DESCRIPTION | UNIT WEIGHT [kg]
1 | 1 | PulleyStrammerBottomLe

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

NAME | SIGNATURE | DATE | FINISH: | TITLE:

DRAWN | | | | REPLACES:

CHK'D | | | | REPLACED BY:
APPV'D

## ISO 2768-1 (c), ISO 2768-2 (K) & ISO 13920 BF

E E

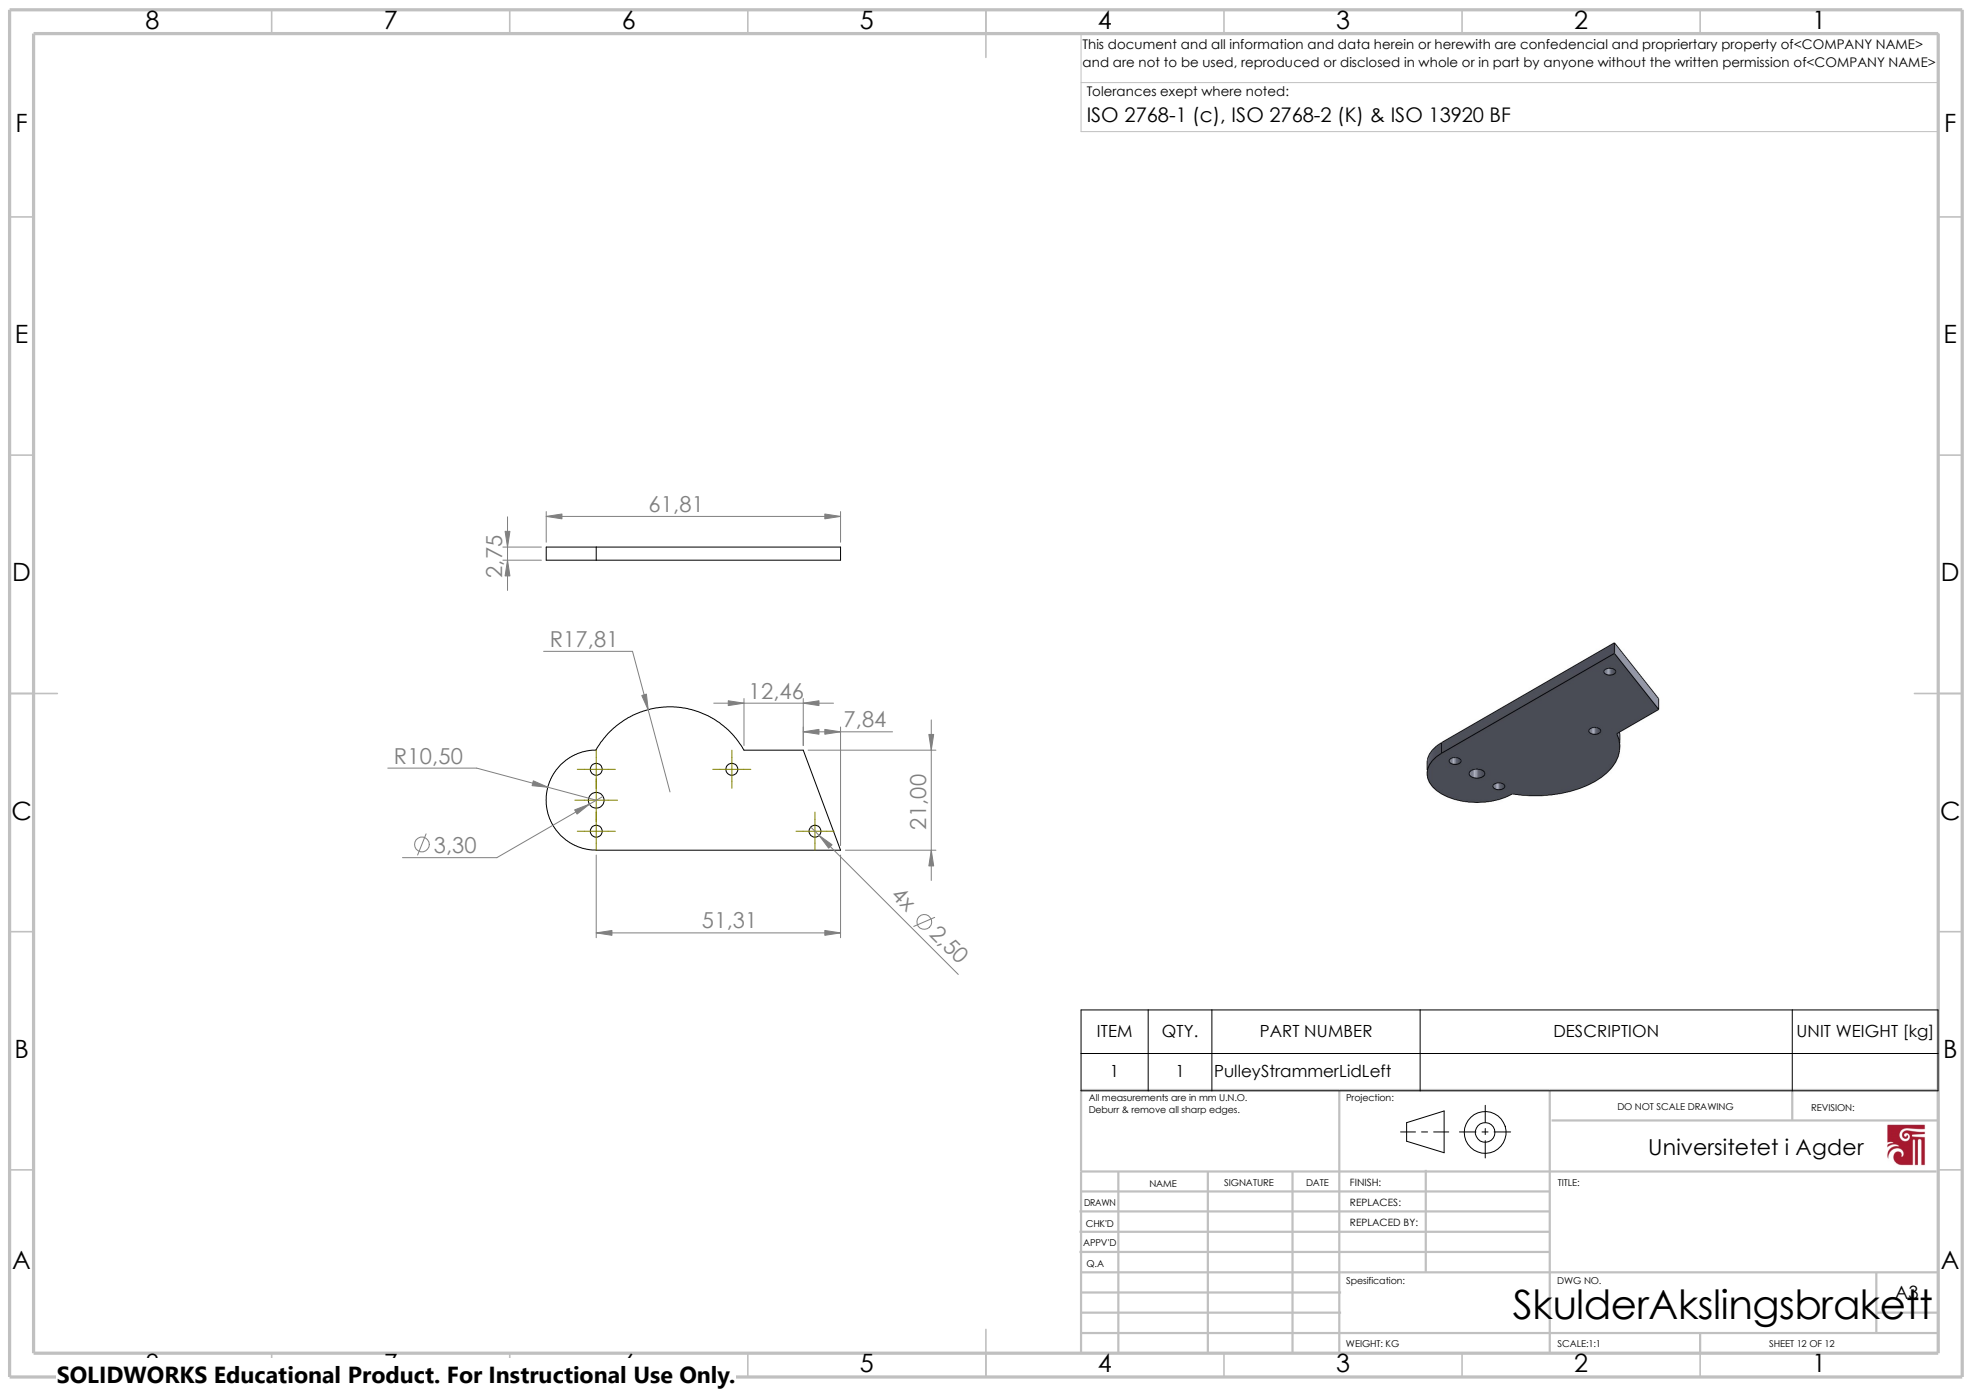
[picture p257: page 12]
SCALE:1:1; SHEET 12 OF 12; Universitetet i Agder

ITEM | QTY. | PART NUMBER | DESCRIPTION | UNIT WEIGHT [kg]

1 | 1 | PulleyStrammerLidLeft

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

NAME | SIGNATURE | DATE | FINISH: | TITLE:

DRAWN | | | | REPLACES:

CHK'D | | | | REPLACED BY:
APPV'D
