DAwesomEL/BachelorProsjekt/Deler til maskinering/ElbowWormgear.pdf

8 | 7 | 6 | 5 | 4 | 3 | 2 | 1

## ISO 2768-1 (c), ISO 2768-2 (K) & ISO 13920 BF

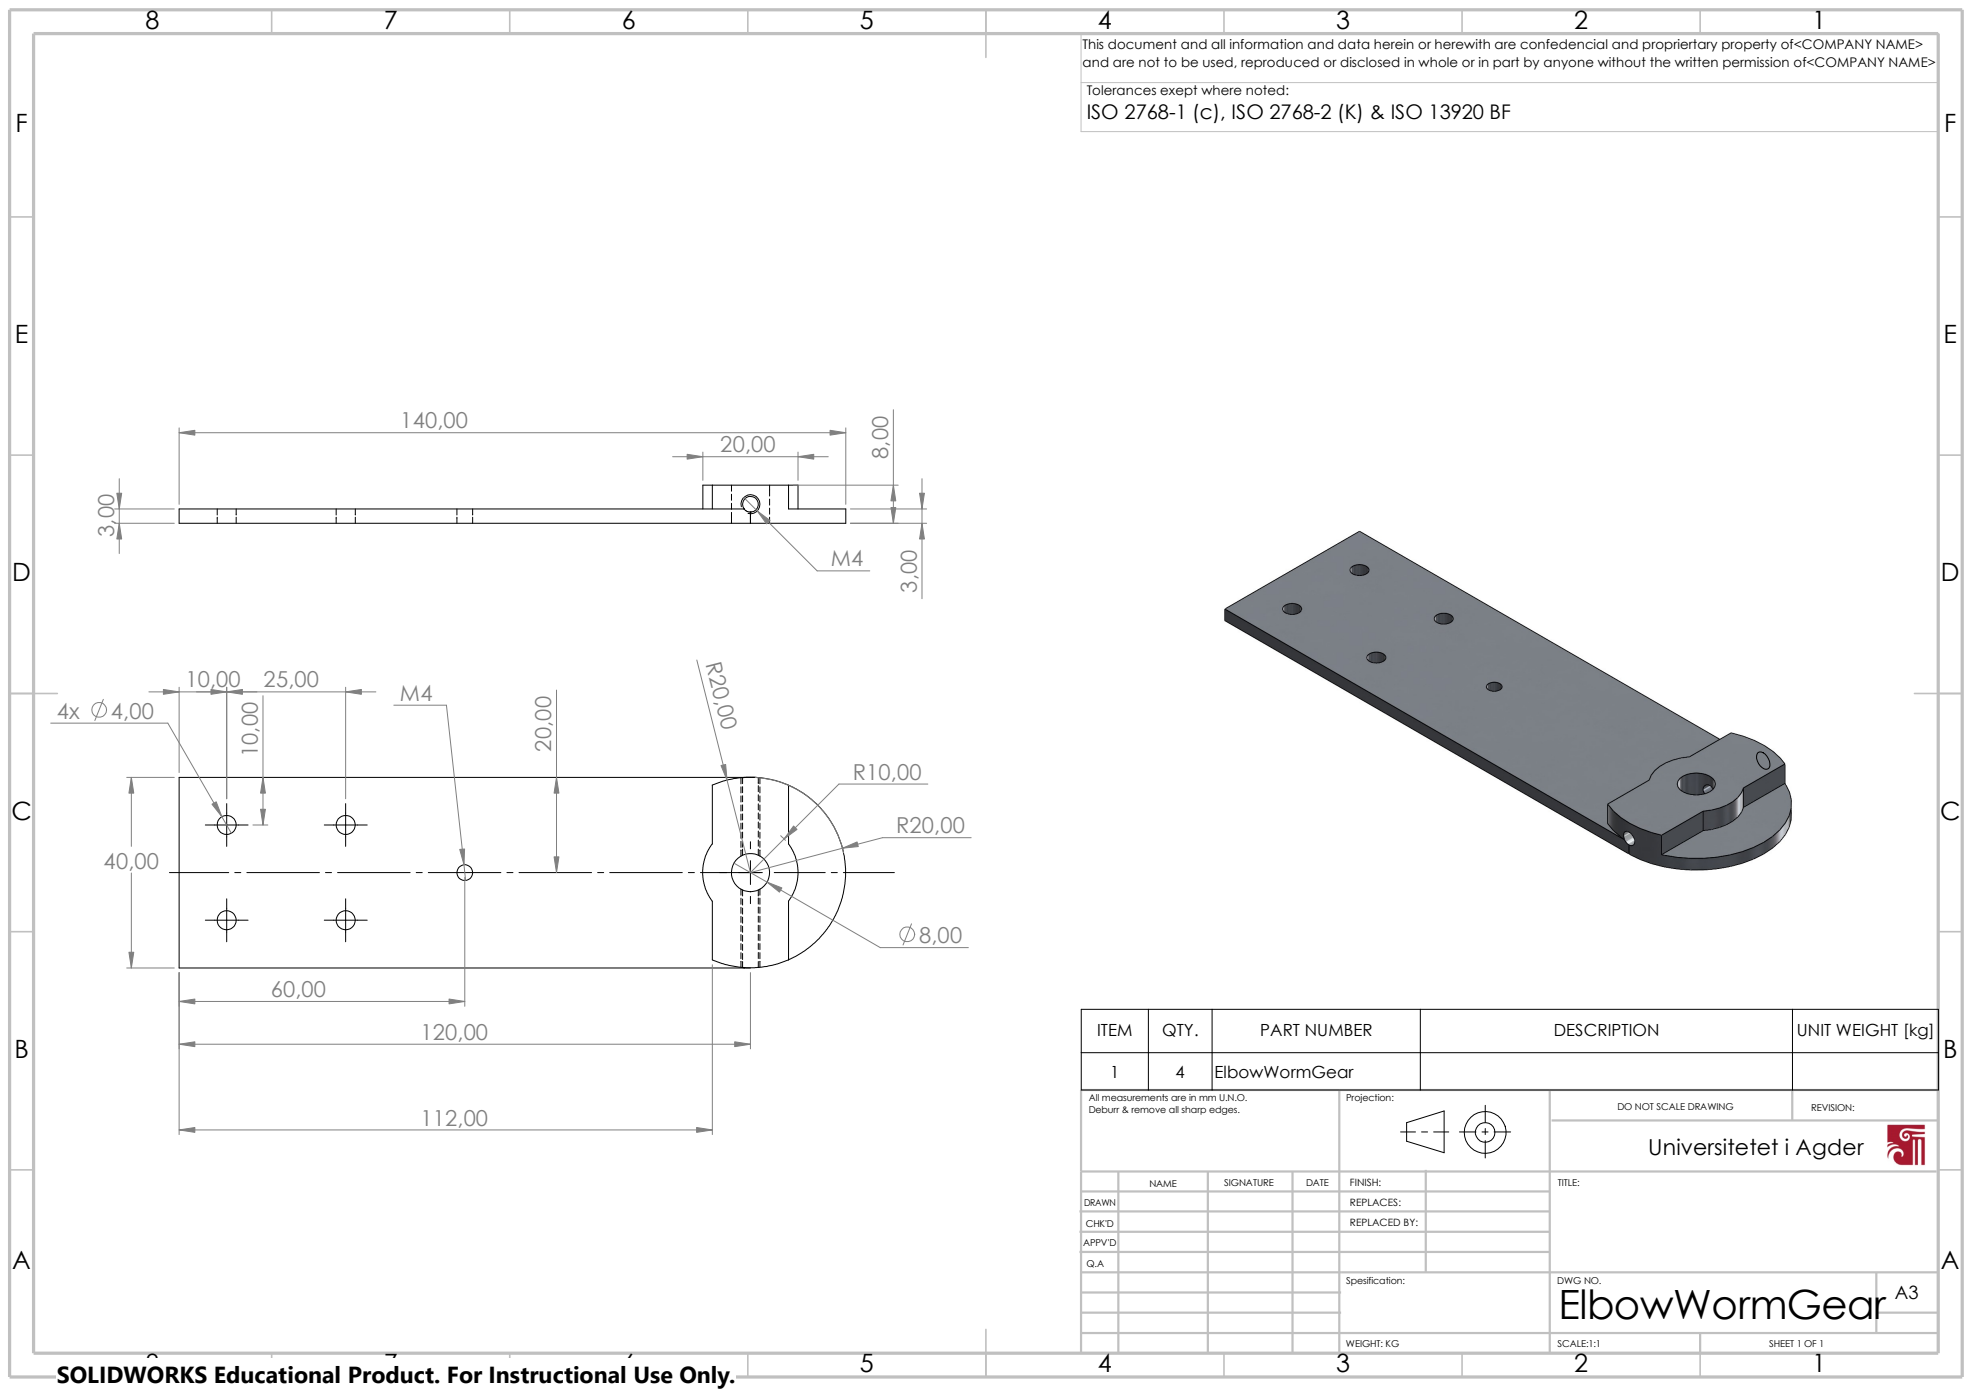
[picture p258: page 1]
SCALE:1:1; SHEET 1 OF 1; WEIGHT: KG; Universitetet i Agder; Deburr & remove all sharp edges. 10,00

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

Tolerances exept where noted:

ITEM | QTY. | PART NUMBER | DESCRIPTION | UNIT WEIGHT [kg]

1 | 4 | ElbowWormGear

All measurements are in mm U.N.O. | Projection: | | DO NOT SCALE DRAWING | REVISION:

NAME | SIGNATURE | DATE | FINISH: | | TITLE:

DRAWN | | | | REPLACES:

CHK'D | | | | REPLACED BY:
APPV'D

Spesification: | DWG NO. ElbowWormGear | A3

SOLIDWORKS Educational Product. For Instructional Use Only.
