DAwesomEL/BachelorProsjekt/Deler til maskinering/Monteringsplate.pdf

## ISO 2768-1 (c), ISO 2768-2 (K) & ISO 13920 BF

E E

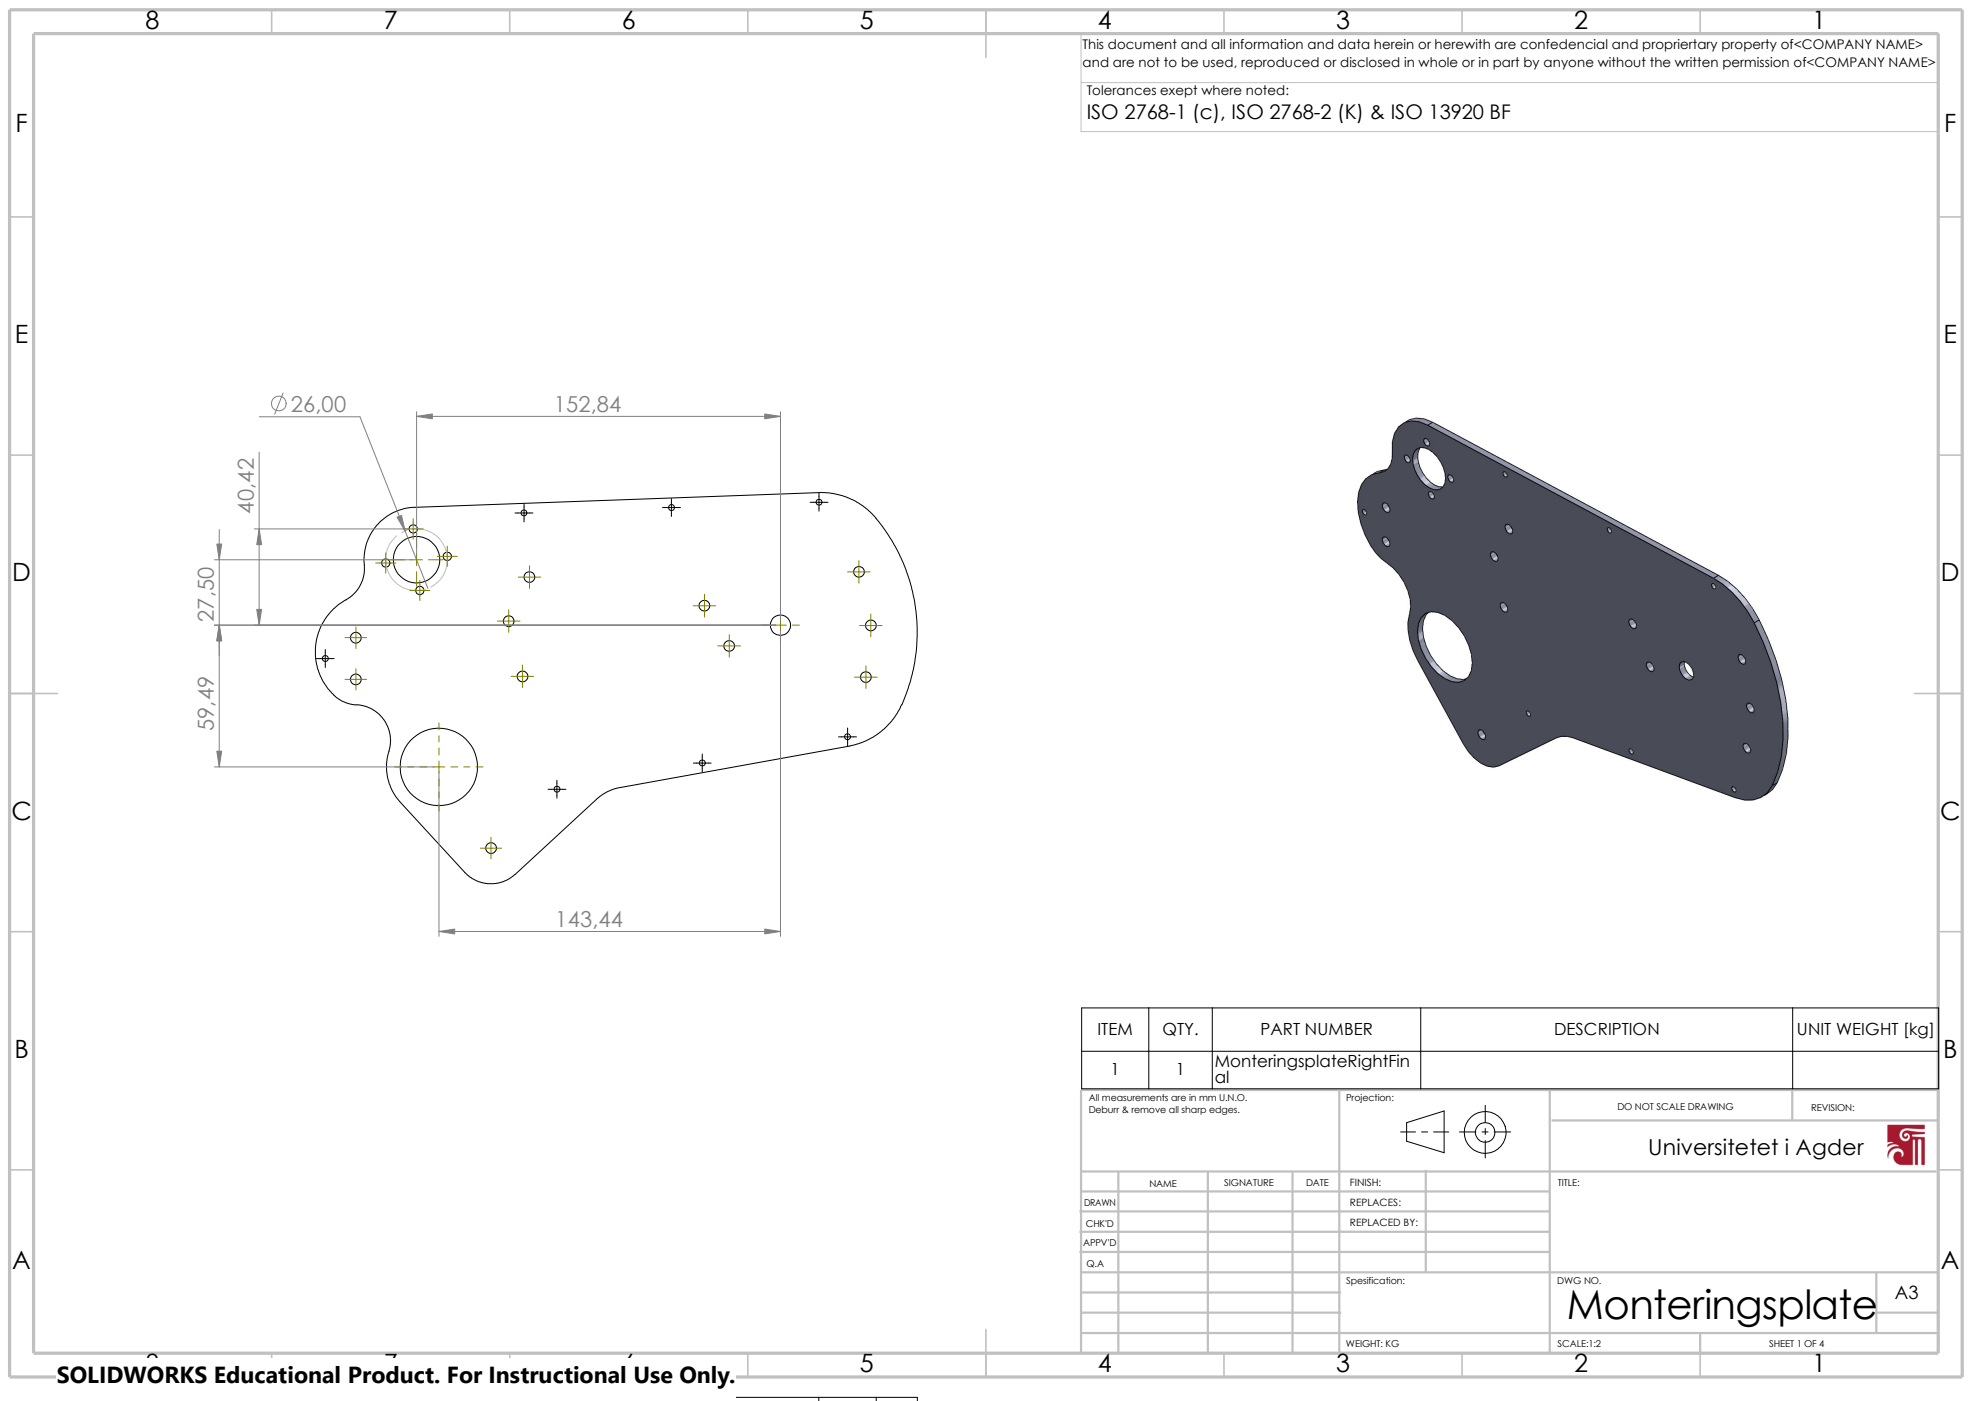
[picture p259: page 1]
SCALE:1:2; SHEET 1 OF 4; WEIGHT: KG; Universitetet i Agder

This document and all information and data herein or herewith are confedencial and propriertary property of<COMPANY NAME>
and are not to be used, reproduced or disclosed in whole or in part by anyone without the written permission of<COMPANY NAME>
Tolerances exept where noted:

ITEM | QTY. | PART NUMBER | DESCRIPTION | UNIT WEIGHT [kg]
1 | 1 | MonteringsplateRightFin al

All measurements are in mm U.N.O. Deburr & remove all sharp edges. | Projection: | | DO NOT SCALE DRAWING | REVISION:

NAME | SIGNATURE | DATE | FINISH: | | TITLE:

DRAWN | | | | REPLACES:

CHK'D | | | | REPLACED BY:
APPV'D

Spesification: | DWG NO. Monteringsplate | A3

SOLIDWORKS Educational Product. For Instructional Use Only.

## ISO 2768-1 (c), ISO 2768-2 (K) & ISO 13920 BF

E E

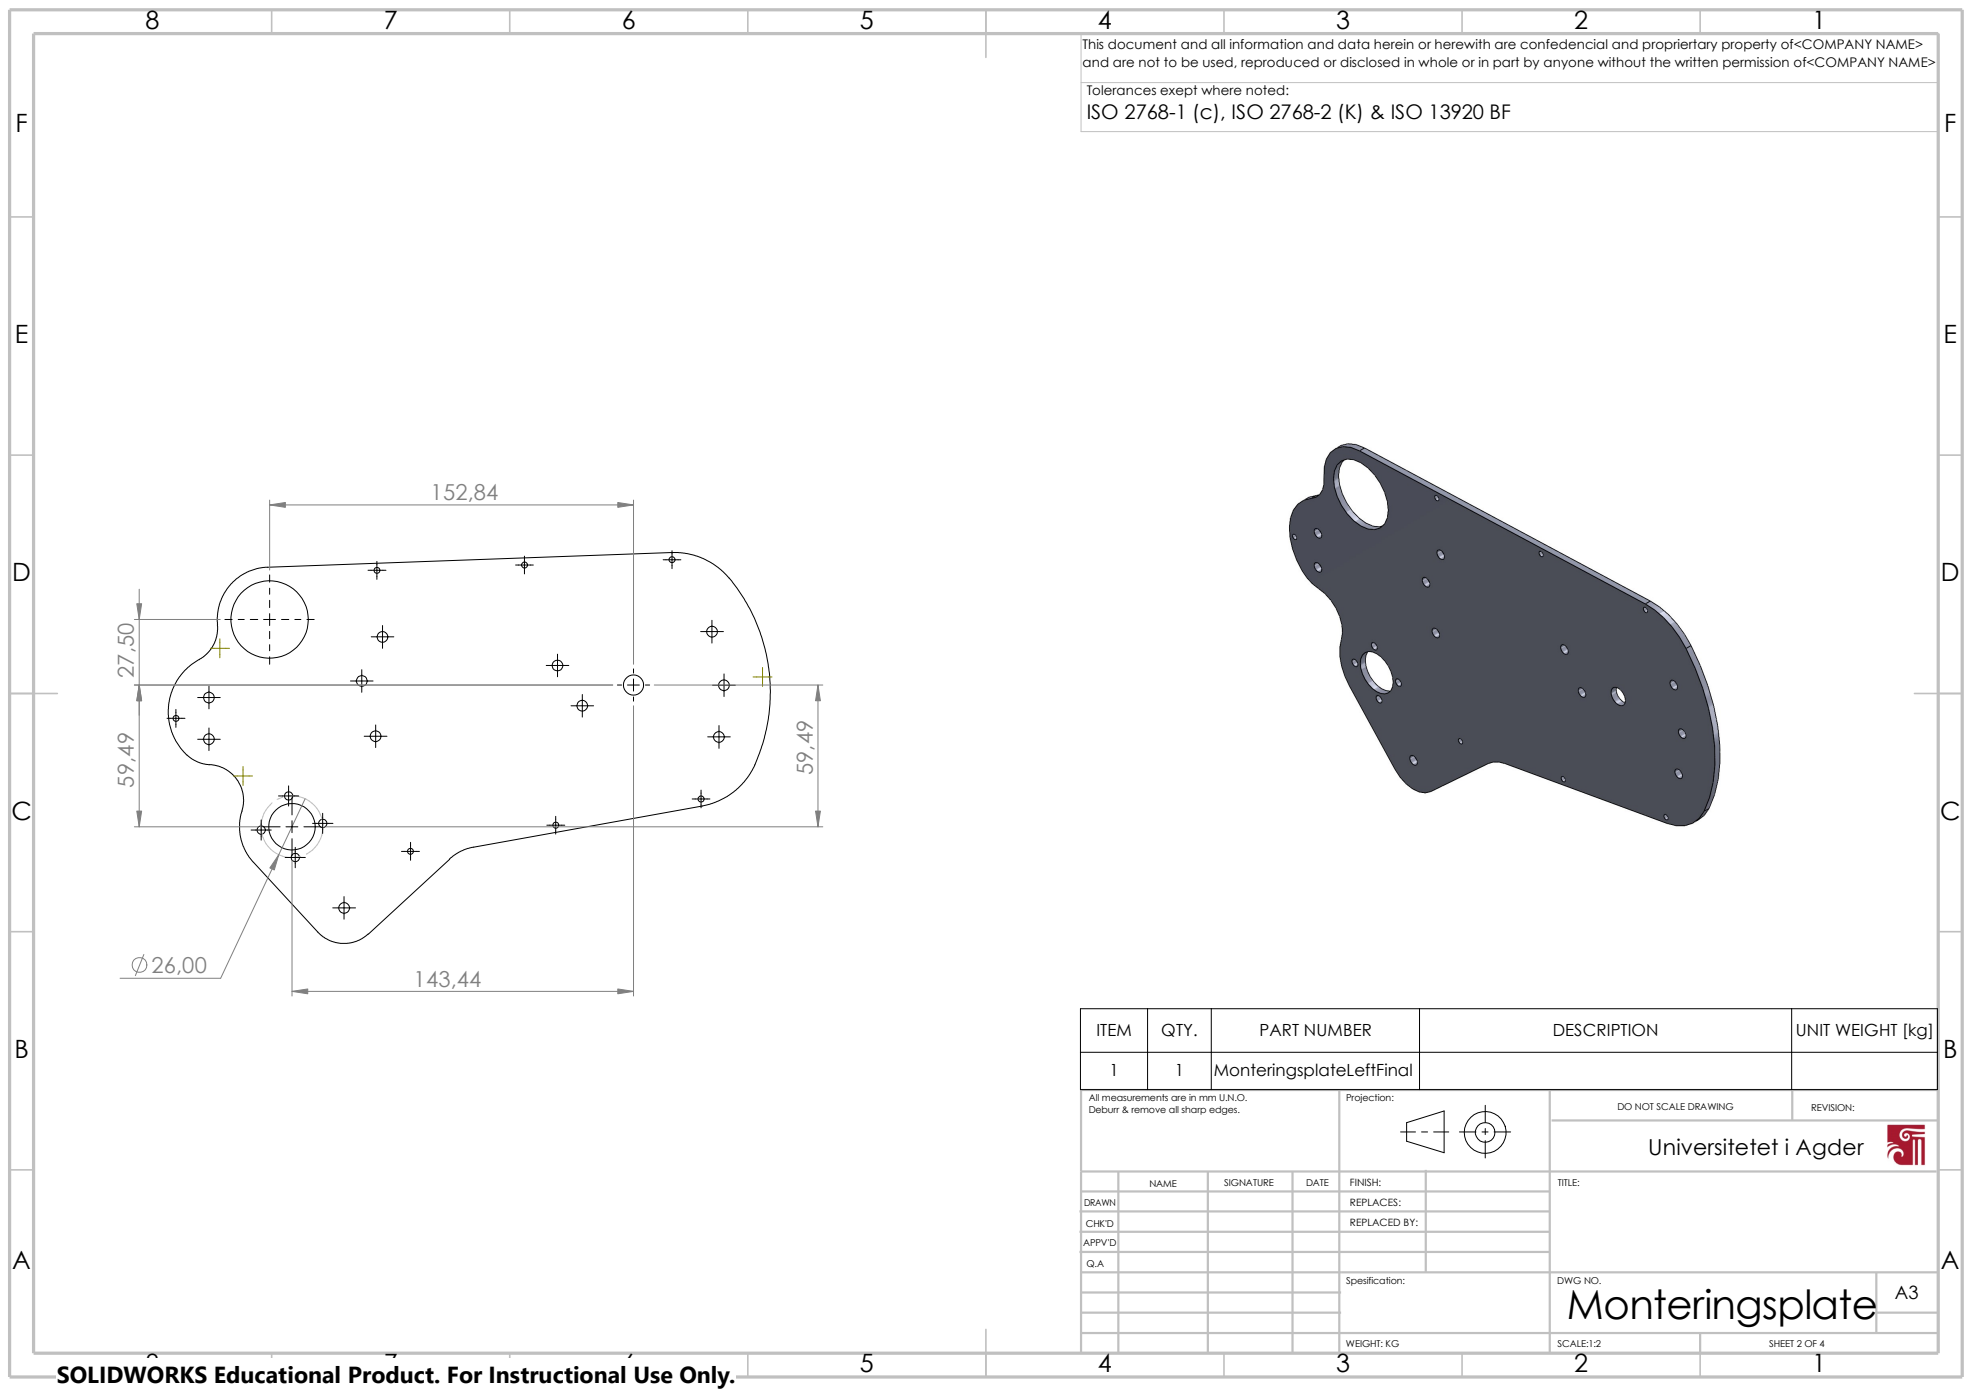
[picture p260: page 2]
DRAWN; DO NOT SCALE DRAWING; REVISION:; SCALE:1:2; SHEET 2 OF 4; Universitetet i Agder; Projection:; ITEM; QTY.; PART NUMBER; DESCRIPTION; UNIT WEIGHT [kg]; MonteringsplateLeftFinal ⁵⁹,49

All measurements are in mm U.N.O.
Deburr & remove all sharp edges.

NAME | SIGNATURE | DATE | FINISH: | TITLE:

REPLACES:

CHK'D | | | | REPLACED BY:
APPV'D

## ISO 2768-1 (c), ISO 2768-2 (K) & ISO 13920 BF

E E

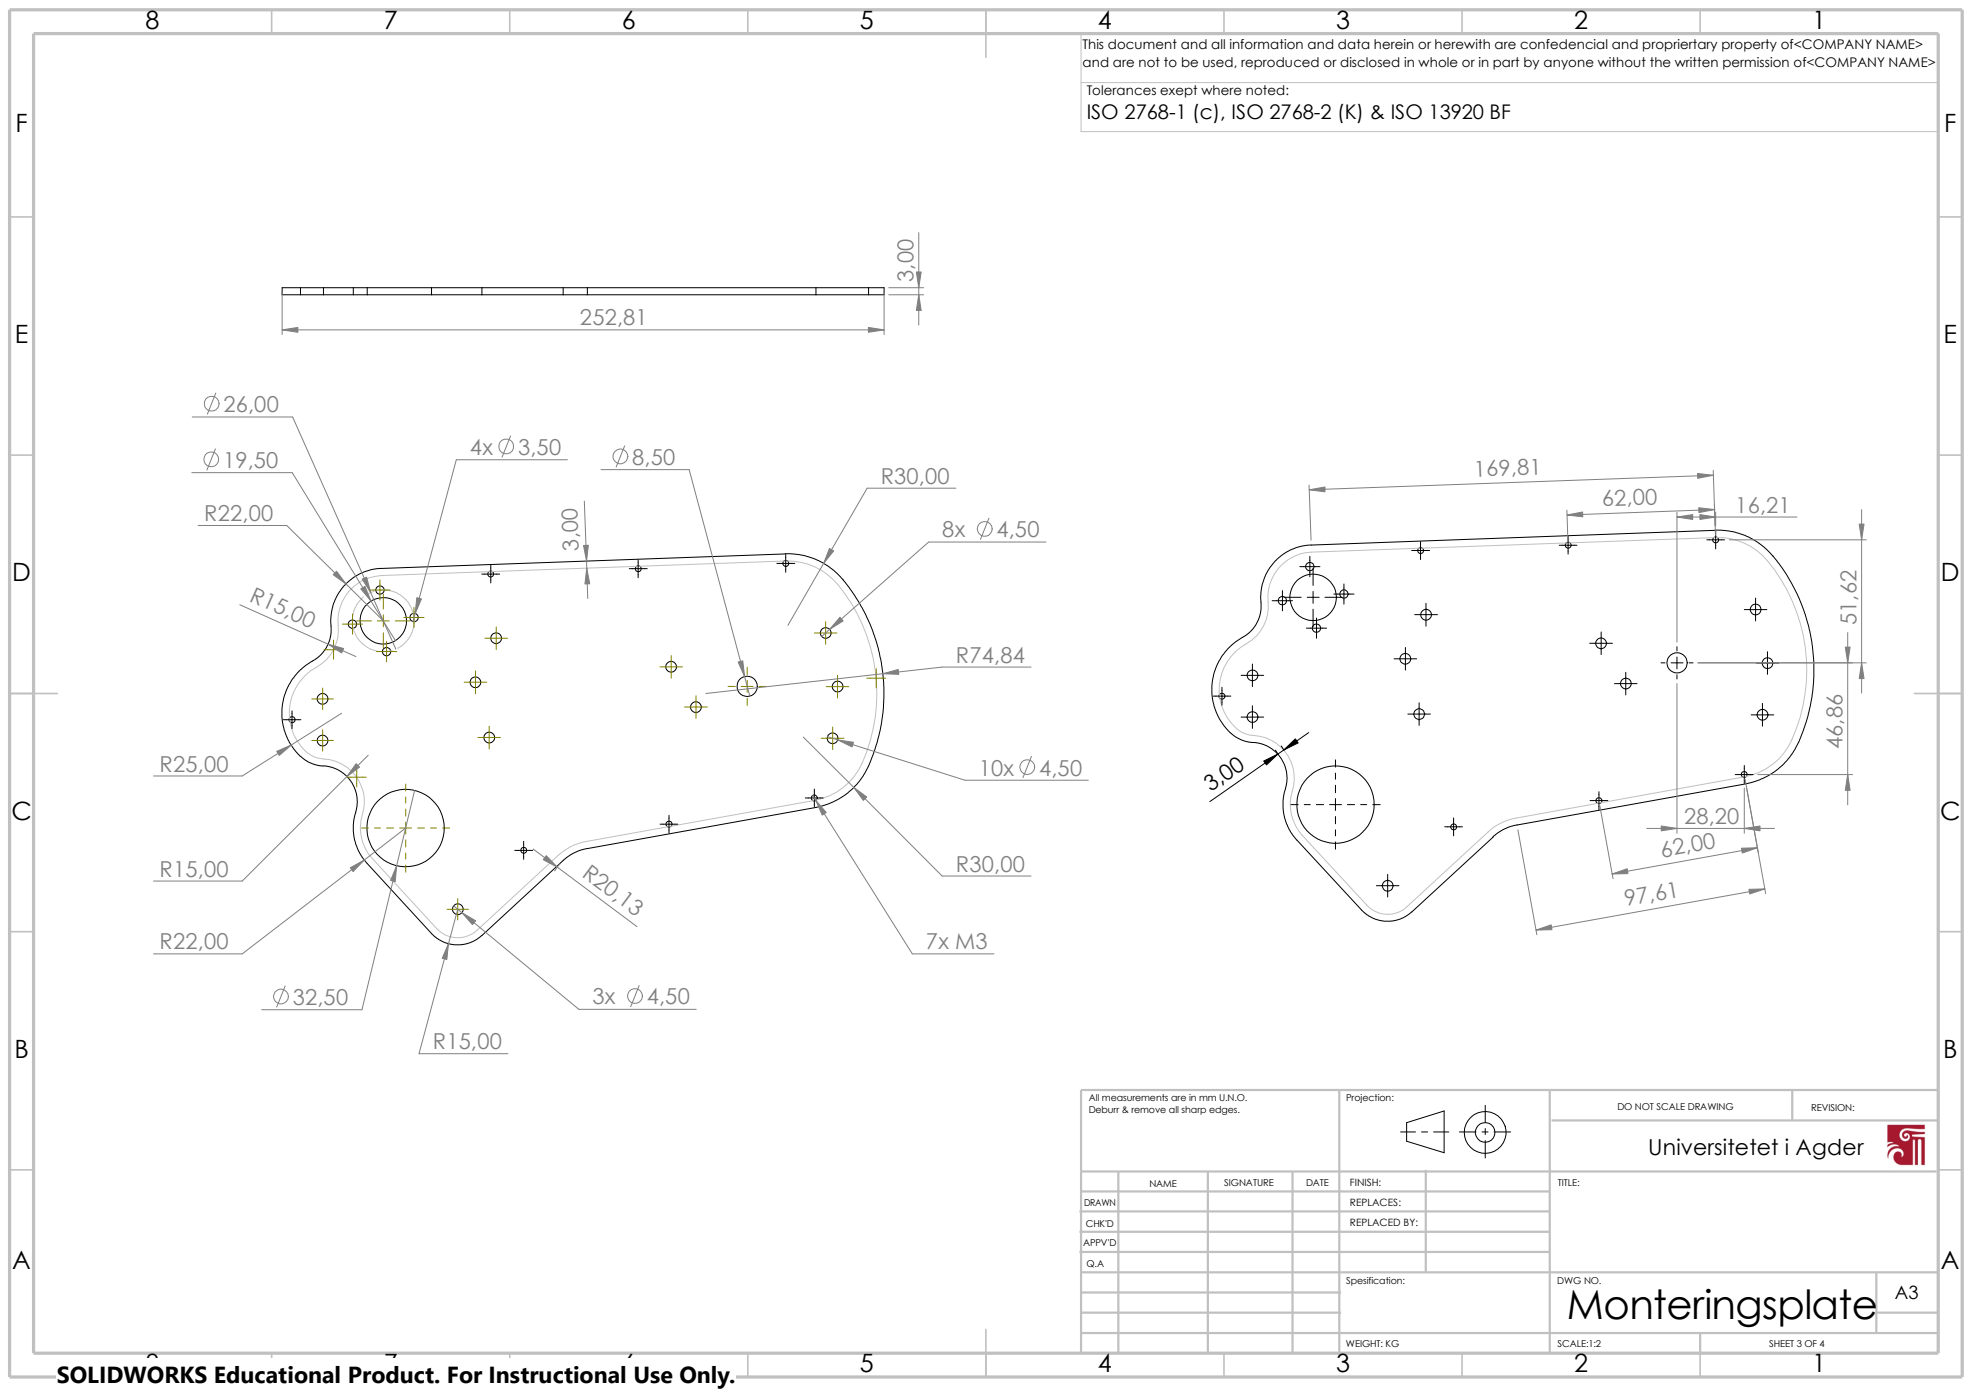
[picture p261: page 3]
3,00 DRAWN; DO NOT SCALE DRAWING; REVISION:; SCALE:1:2; SHEET 3 OF 4; Universitetet i Agder; Projection:

All measurements are in mm U.N.O.
Deburr & remove all sharp edges.

NAME | SIGNATURE | DATE | FINISH: | TITLE:

REPLACES:

CHK'D | | | | REPLACED BY:
APPV'D

## ISO 2768-1 (c), ISO 2768-2 (K) & ISO 13920 BF

E E

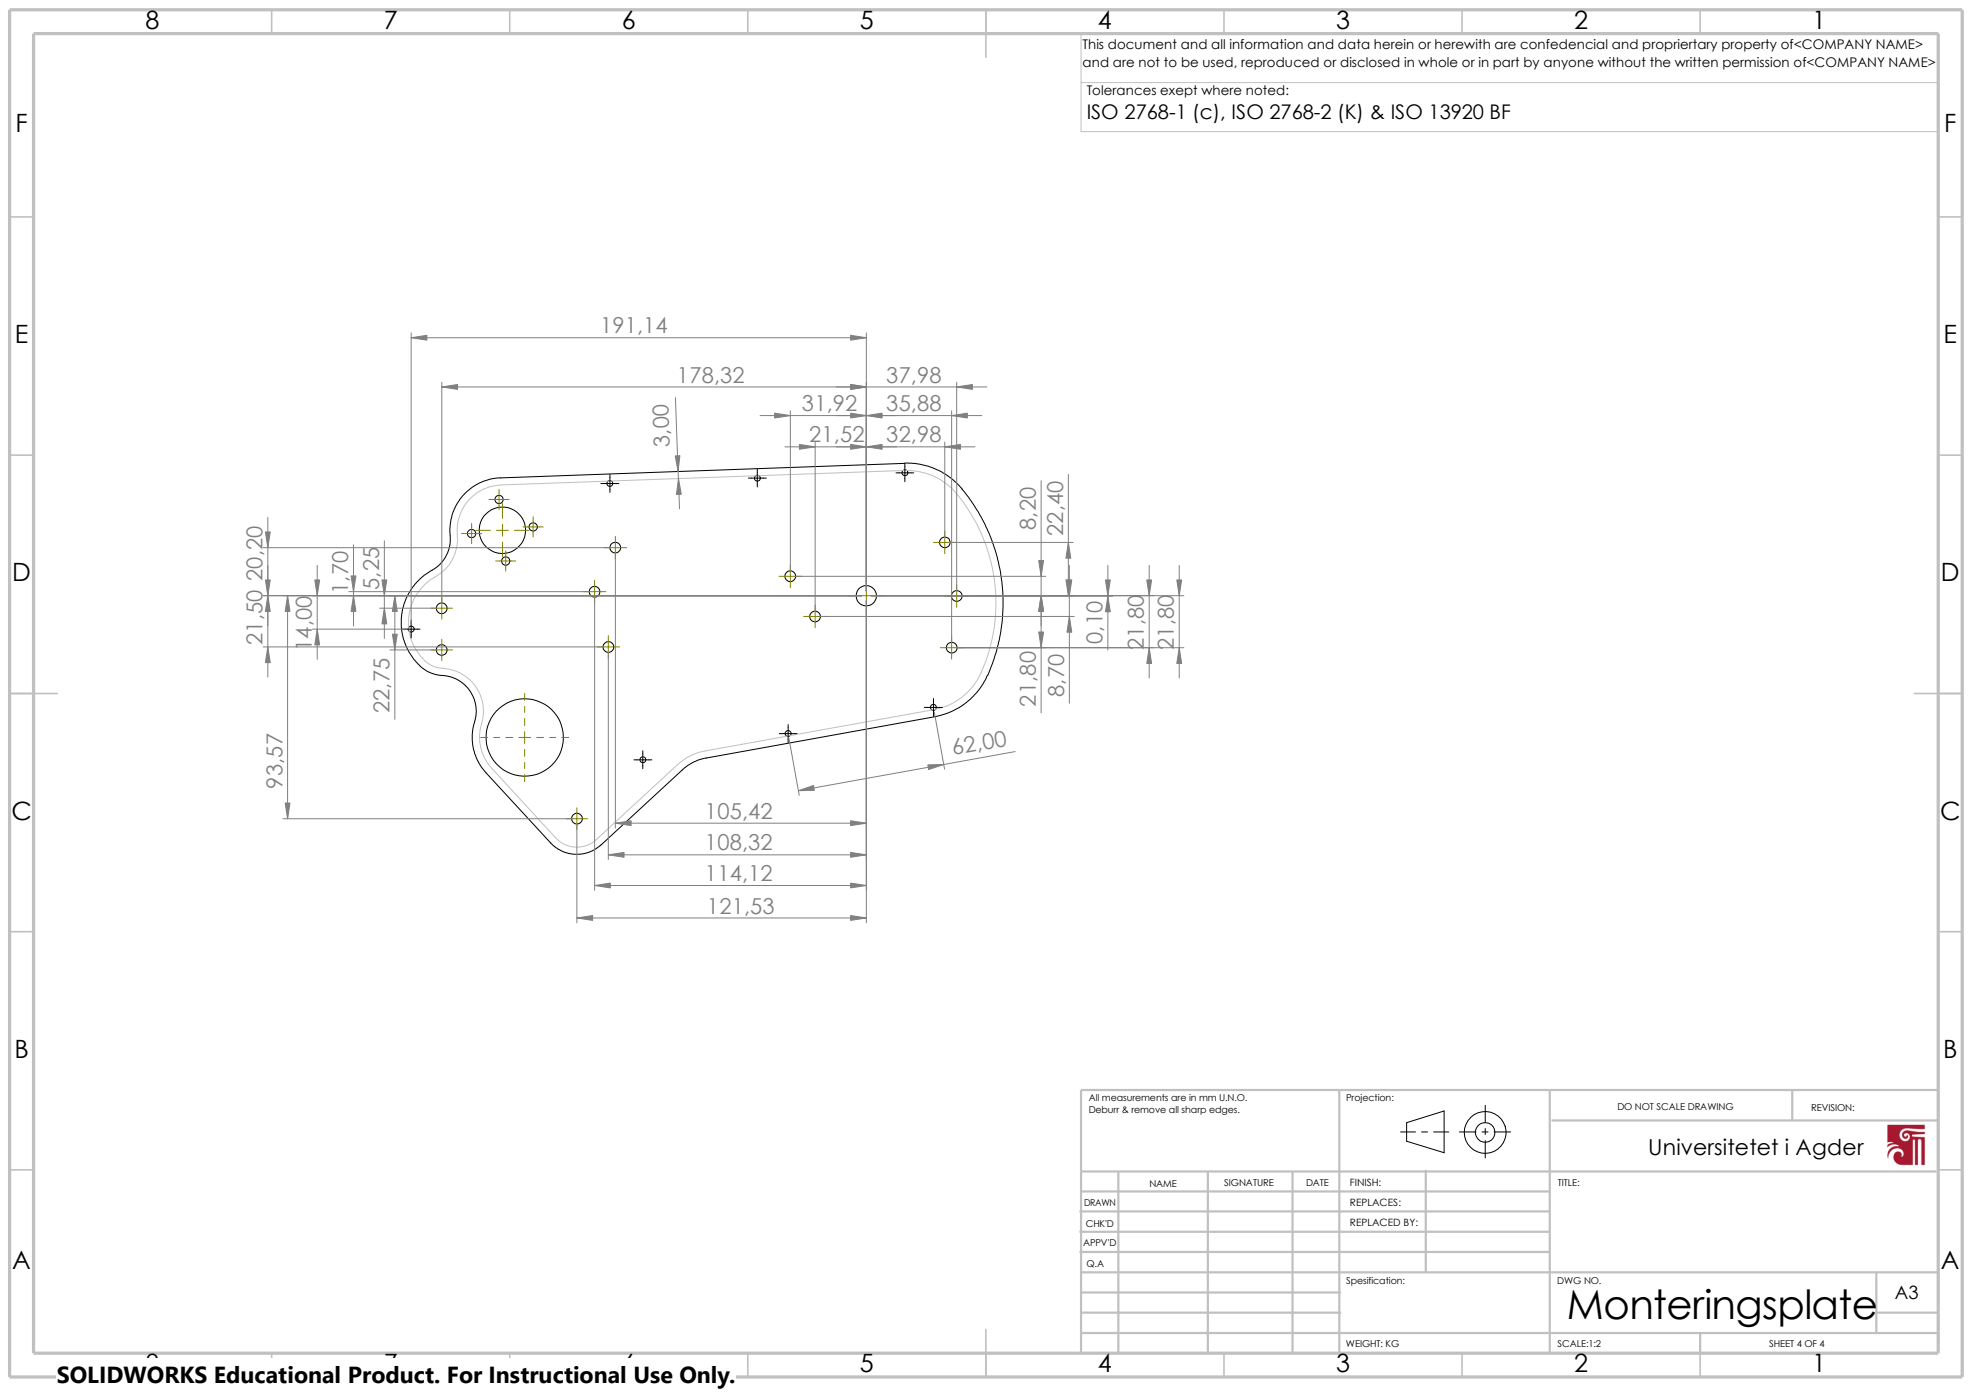
[picture p262: page 4]
DO NOT SCALE DRAWING; REVISION:; SCALE:1:2; SHEET 4 OF 4; Universitetet i Agder; Projection:

All measurements are in mm U.N.O.
Deburr & remove all sharp edges.

NAME | SIGNATURE | DATE | FINISH: | TITLE:

DRAWN | | | | REPLACES:

CHK'D | | | | REPLACED BY:
APPV'D
