DAwesomEL/BachelorProsjekt/Deler til maskinering/MotorBracket.pdf

## ISO 2768-1 (c), ISO 2768-2 (K) & ISO 13920 BF

E E

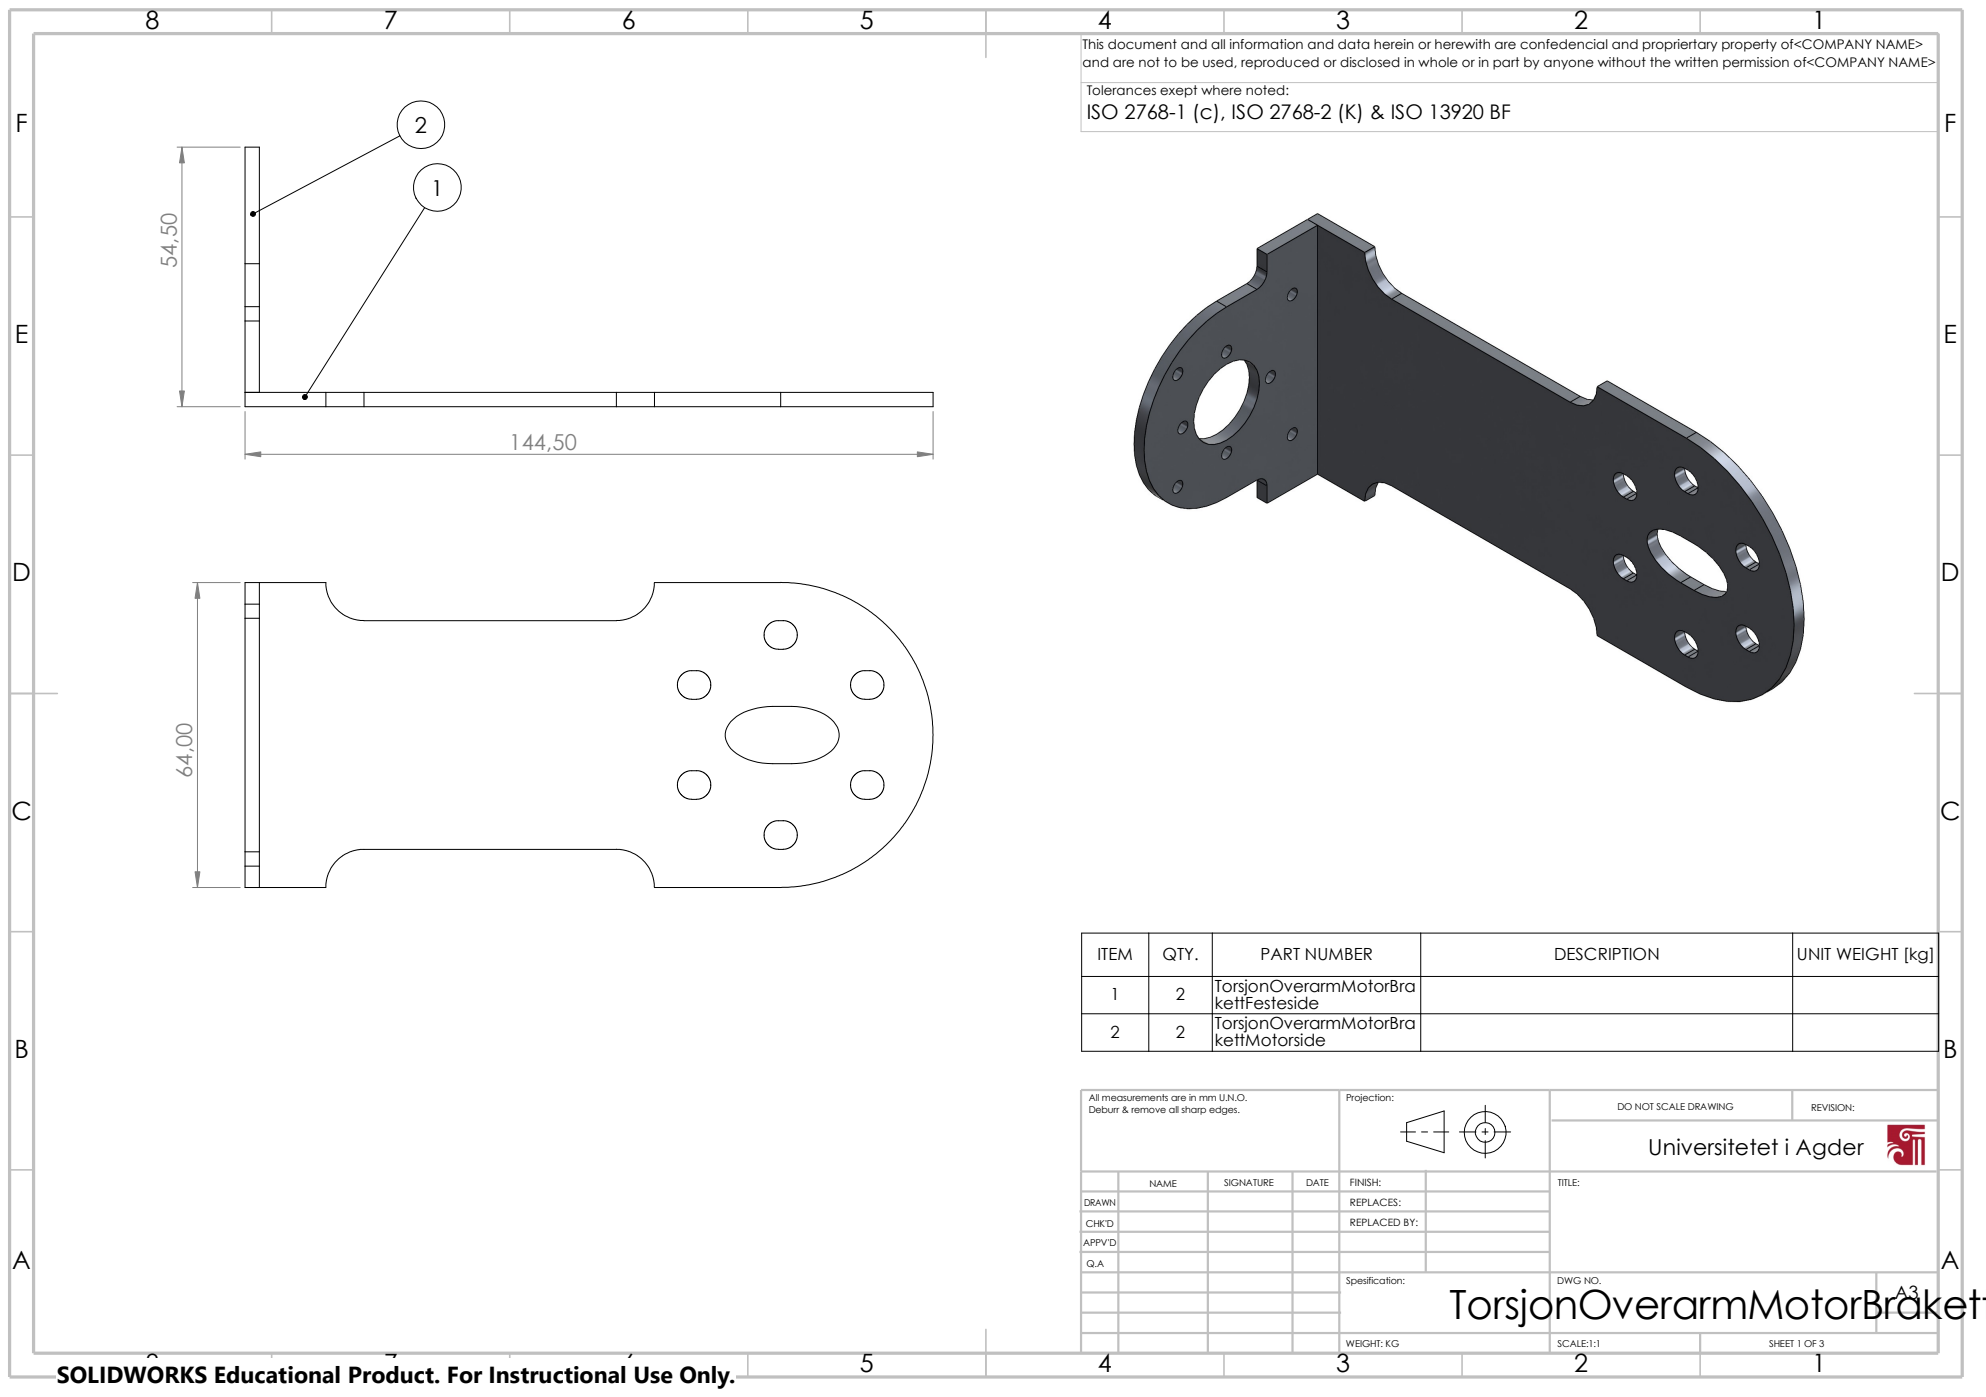
[picture p263: page 1]
WEIGHT: KG; SHEET 1 OF 3 DRAWN; DO NOT SCALE DRAWING; REVISION:; SCALE:1:1; TorsjonOverarmMotorBrakett; Universitetet i Agder; Projection:; kettMotorside ⁶⁴,00

This document and all information and data herein or herewith are confedencial and propriertary property of<COMPANY NAME>
and are not to be used, reproduced or disclosed in whole or in part by anyone without the written permission of<COMPANY NAME>
Tolerances exept where noted:

ITEM | QTY. | PART NUMBER | DESCRIPTION | UNIT WEIGHT [kg]
1 | 2 | TorsjonOverarmMotorBra kettFesteside
2 | 2 | TorsjonOverarmMotorBra

All measurements are in mm U.N.O.
Deburr & remove all sharp edges.

NAME | SIGNATURE | DATE | FINISH: | | TITLE:

REPLACES:

CHK'D | | | | REPLACED BY:
APPV'D

Spesification: | DWG NO. | A3

SOLIDWORKS Educational Product. For Instructional Use Only.

## ISO 2768-1 (c), ISO 2768-2 (K) & ISO 13920 BF

E E

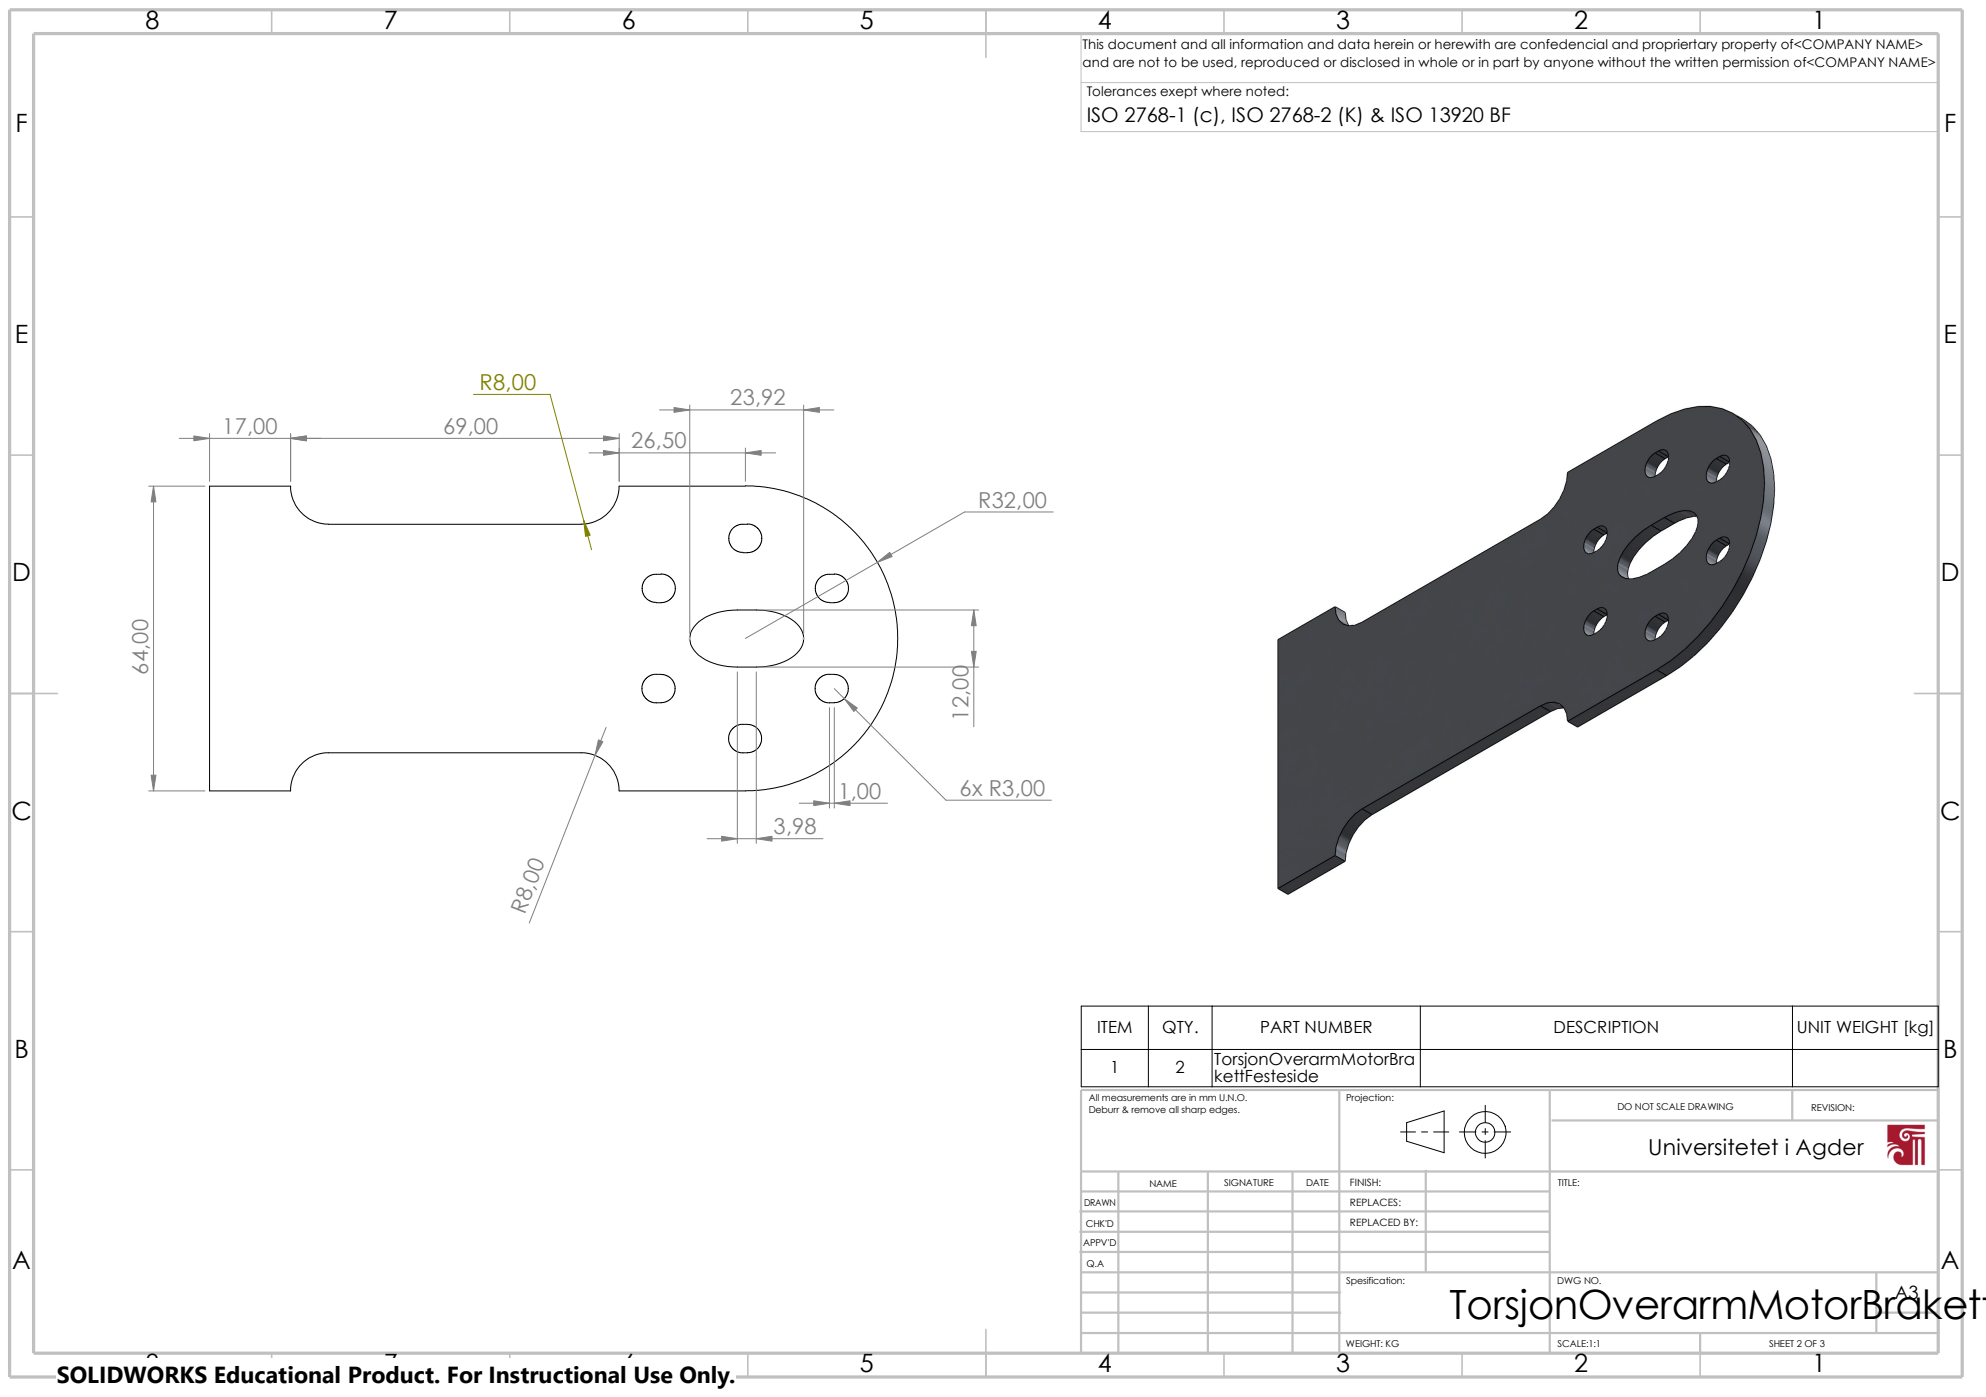
[picture p264: page 2]
WEIGHT: KG; SHEET 2 OF 3; Universitetet i Agder

ITEM | QTY. | PART NUMBER | DESCRIPTION | UNIT WEIGHT [kg]
1 | 2 | TorsjonOverarmMotorBra kettFesteside

All measurements are in mm U.N.O. Deburr & remove all sharp edges. | Projection: | | DO NOT SCALE DRAWING | REVISION:

NAME | SIGNATURE | DATE | FINISH: | TITLE:

CHK'D | | | | REPLACED BY: | DWG NO. DRAWN

REPLACES:

APPV'D

## ISO 2768-1 (c), ISO 2768-2 (K) & ISO 13920 BF

E E

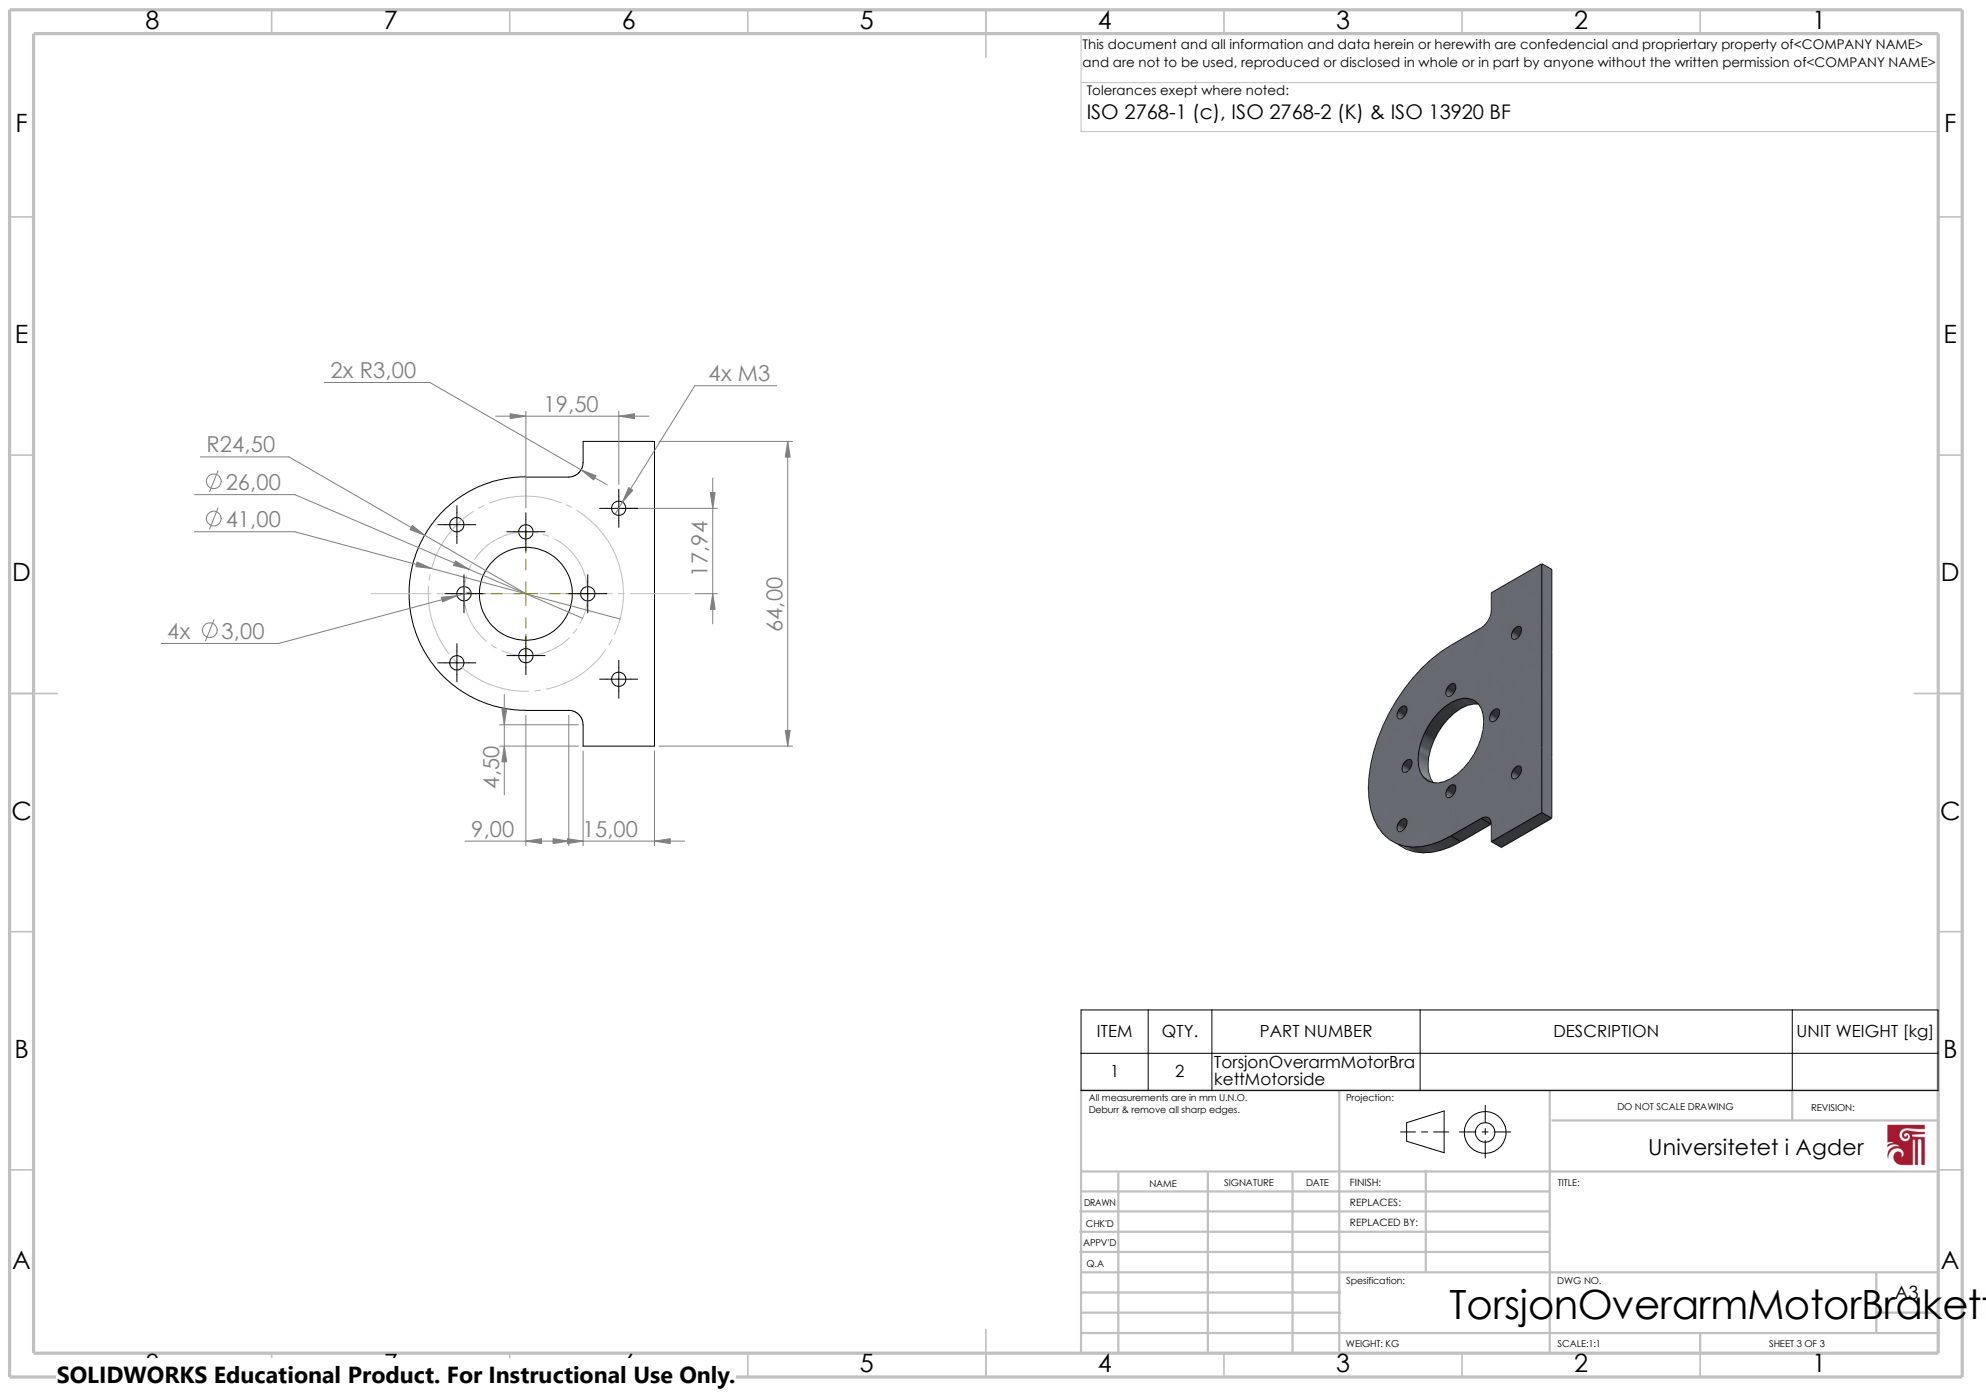
[picture p265: page 3]
Universitetet i Agder; kettMotorside ⁴,50

ITEM | QTY. | PART NUMBER | DESCRIPTION | UNIT WEIGHT [kg]
1 | 2 | TorsjonOverarmMotorBra

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

NAME | SIGNATURE | DATE | FINISH: | | TITLE:

DRAWN | | | | REPLACES:

CHK'D | | | | REPLACED BY:
APPV'D

DWG NO.

WEIGHT: KG | | SHEET 3 OF 3
