DAwesomEL/BachelorProsjekt/Gammel Arbeidstegninger/M10 Bolt/M10 Bolt Aksling.pdf

8 | 7 6 | 5 | 4 | 3 | 2

## ISO 2768-1 (c), ISO 2768-2 (K) & ISO 13920 BF

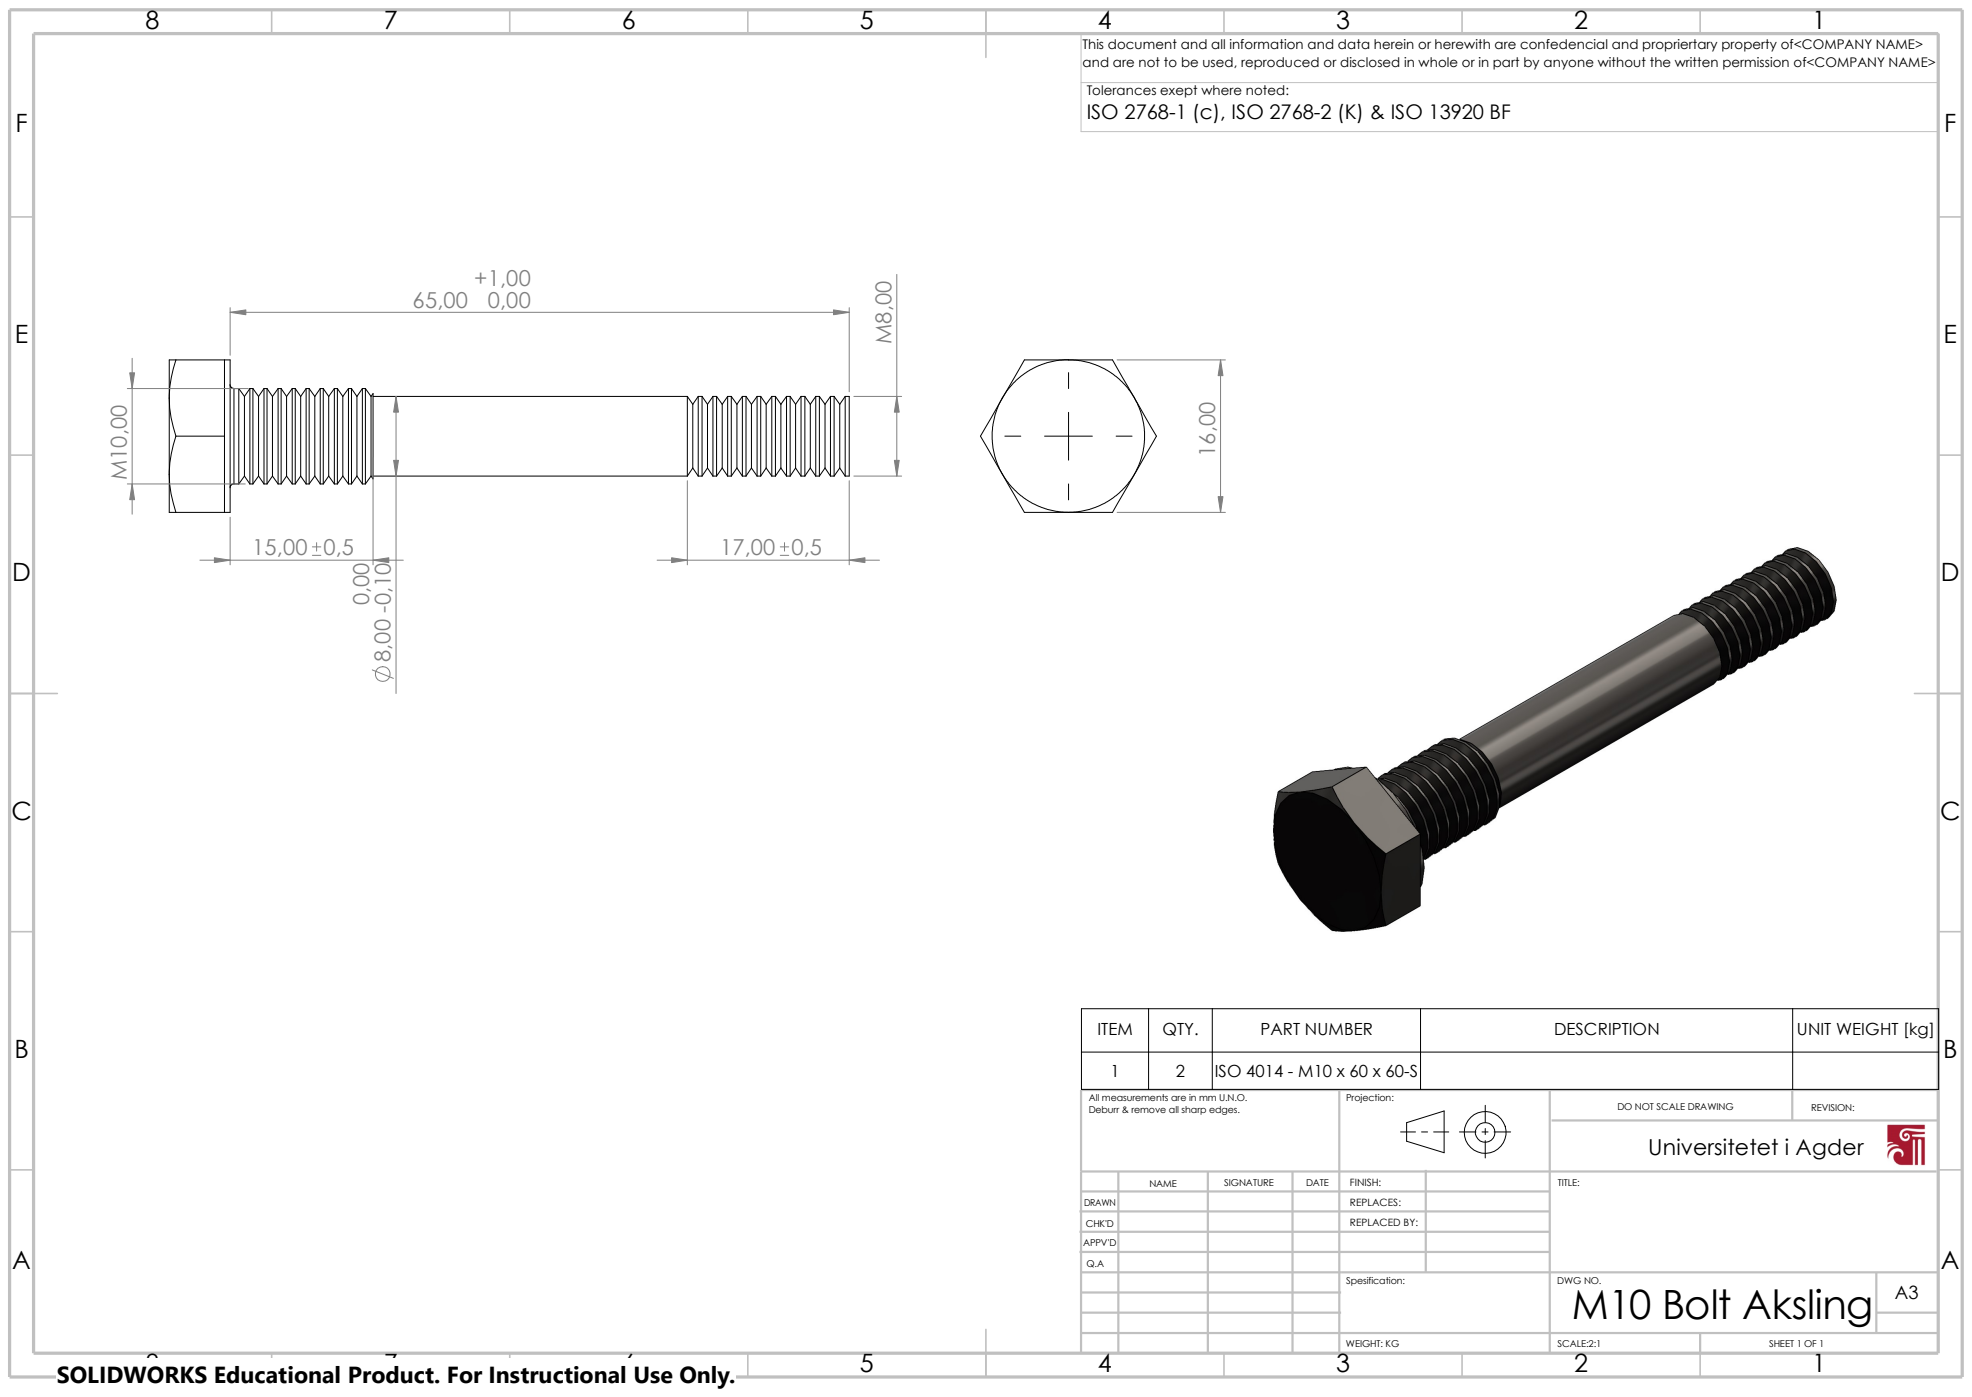
[picture p266: page 1]
SCALE:2:1 2; WEIGHT: KG; Universitetet i Agder; 17,00 M¹⁰,00

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

Tolerances exept where noted:

ITEM | QTY. | PART NUMBER | DESCRIPTION | UNIT WEIGHT [kg]

1 | 2 | ISO 4014 - M10 x 60 x 60-S

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

NAME | SIGNATURE | DATE | FINISH: | | TITLE:

APPV'D | | | | | | SHEET 1 OF 1 DRAWN
CHK'D | | | | REPLACED BY:

REPLACES:

Spesification: | DWG NO. M10 Bolt Aksling | A3

SOLIDWORKS Educational Product. For Instructional Use Only.
