DAwesomEL/BachelorProsjekt/Arduino/sketch_apr26a/sketch_apr26a.ino

#include <Wire.h> //This is for i2C


// i2C OLED
#define I2C_ADDRESS 0x3C

//I2C pins:
//STM32: SDA: PB7 SCL: PB6
//Arduino: SDA: A4 SCL: A5

//---------------------------------------------------------------------------
//Magnetic sensor things
int magnetStatus = 0; //value of the status register (MD, ML, MH)

int lowbyte; //raw angle 7:0
word highbyte; //raw angle 7:0 and 11:8
int rawAngle; //final raw angle 
float degAngle; //raw angle in degrees (360/4096 * [value between 0-4095])

int quadrantNumber, previousquadrantNumber; //quadrant IDs
float numberofTurns = 0; //number of turns
float correctedAngle = 0; //tared angle - based on the startup value
float startAngle = 0; //starting angle
float totalAngle = 0; //total absolute angular displacement
float previoustotalAngle = 0; //for the display printing

void setup()
{
  Serial.begin(115200); //start serial - tip: don't use serial if you don't need it (speed considerations)
  Wire.begin(); //start i2C  
	Wire.setClock(800000L); //fast clock

  checkMagnetPresence(); //check the magnet (blocks until magnet is found)

  ReadRawAngle(); //make a reading so the degAngle gets updated
  startAngle = degAngle; //update startAngle with degAngle - for taring



  
}

void loop()
{    
    //Serial.print("Helloooo Are you there?");
    ReadRawAngle(); //ask the value from the sensor
    correctAngle(); //tare the value
   
    
    //delay(100); //wait a little - adjust it for "better resolution"
   

}

void ReadRawAngle()
{ 
  //7:0 - bits
  Wire.beginTransmission(0x36); //connect to the sensor
  Wire.write(0x0D); //figure 21 - register map: Raw angle (7:0)
  Wire.endTransmission(); //end transmission
  Wire.requestFrom(0x36, 1); //request from the sensor
  
  while(Wire.available() == 0); //wait until it becomes available 
  lowbyte = Wire.read(); //Reading the data after the request
 
  //11:8 - 4 bits
  Wire.beginTransmission(0x36);
  Wire.write(0x0C); //figure 21 - register map: Raw angle (11:8)
  Wire.endTransmission();
  Wire.requestFrom(0x36, 1);
  
  while(Wire.available() == 0);  
  highbyte = Wire.read();
  
 
  highbyte = highbyte << 8; //shifting to left

  rawAngle = highbyte | lowbyte; //int is 16 bits (as well as the word)

  degAngle = rawAngle * 0.087890625; 
  
  Serial.print("Deg angle: ");
  Serial.println(degAngle, 2); //absolute position of the encoder within the 0-360 circle
  
}

void correctAngle()
{
  //recalculate angle
  correctedAngle = degAngle - startAngle; //this tares the position

  if(correctedAngle < 0) //if the calculated angle is negative, we need to "normalize" it
  {
  correctedAngle = correctedAngle + 360; //correction for negative numbers (i.e. -15 becomes +345)
  }
  else
  {
    //do nothing
  }
  Serial.print("Corrected angle: ");
  Serial.println(correctedAngle, 2); //print the corrected/tared angle  
}


void checkMagnetPresence()
{  
  //This function runs in the setup() and it locks the MCU until the magnet is not positioned properly

  while((magnetStatus & 32) != 32) //while the magnet is not adjusted to the proper distance - 32: MD = 1
  {
    magnetStatus = 0; //reset reading

    Wire.beginTransmission(0x36); //connect to the sensor
    Wire.write(0x0B); //figure 21 - register map: Status: MD ML MH
    Wire.endTransmission(); //end transmission
    Wire.requestFrom(0x36, 1); //request from the sensor

    while(Wire.available() == 0); //wait until it becomes available 
    magnetStatus = Wire.read(); //Reading the data after the request

    Serial.print("Magnet status: ");
    Serial.println(magnetStatus, BIN); //print it in binary so you can compare it to the table (fig 21)      
  }      
  
  //Status register output: 0 0 MD ML MH 0 0 0  
  //MH: Too strong magnet - 100111 - DEC: 39 
  //ML: Too weak magnet - 10111 - DEC: 23     
  //MD: OK magnet - 110111 - DEC: 55

  Serial.println("Magnet found!");
  delay(1000);  
}
