DAwesomEL/BachelorProsjekt/(commit log)

2023-02-21 Remove junk
    [20mm77gMotor.SLDPRT, Bracket11jan.STL, Bracket12jan.STL, CCR10SPRO_LoomoMini.3mf, hatt.STL]
2023-02-21 Timing belt added
    [FastSkulderMotorBak.SLDASM]
2023-02-22 Lagd en bracket til motor og fiksa sammenstilling
    Var bare uendelig med errors
    [FastSkulderMotorBak.SLDASM, MotorBracket.SLDPRT]
2023-02-23 Nytt filsystem
    [20mm77gMotor.SLDPRT, 31mm360WormMotor.SLDPRT, 31mm360gMotor.sldprt, BracketBottom.SLDPRT, BracketLeft.SLDPRT, BracketRight.SLDPRT, FastSkulderMotorBak.SLDASM, Loomo Body.SLDPRT]
2023-02-23 Some changes
    [FastSkulderMotorBak.SLDASM, Loomo Body.SLDPRT, Loomo arm.SLDASM, Loomo.SLDASM, MotorBracket.SLDPRT, Skulderledd.SLDASM, Thrust50mm70mm.SLDPRT]
2023-02-23 kven veit
    [Overarm.SLDPRT, Skulderledd.SLDASM]
2023-02-23 Made left shoulder Asm
    And put it in the Loomo Model Assembly
    [Belt1-1.SLDPRT, Belt2.SLDPRT, BracketBottom.SLDPRT, BracketBottomLeft.SLDPRT, BracketBottomRight.SLDPRT, FastSkulderMotorBak.SLDASM, FastSkulderMotorBakL.SLDASM, Loomo arm.SLDASM]
2023-02-24 Change in skulderledd
    Lagd klaring for aksling i overarm/skulder
    [31mm360gMotor.sldprt, 45mmLedd.SLDPRT, Belt1-1.SLDPRT, BracketBottom.SLDPRT, BracketBottom.STL, BracketBottomCutSpacer.SLDPRT, BracketBottomLeft.SLDPRT, BracketBottomLeft.STL]
2023-02-24 Overarm version2
    Alternativ 2 for skulderledd overarm
    [Belt1-1.SLDPRT, FastSkulderMotorBak.SLDASM, FastSkulderMotorBakL.SLDASM, Loomo arm.SLDASM, Overarm.SLDPRT, Overarm2.SLDPRT, Skulderledd.SLDASM, pulley_40_5m__09_10.sldprt]
2023-03-02 Strammemekanisme skulderbelter
    [Belt1-1.SLDPRT, BracketBottom.SLDPRT, BracketBottomLeft.SLDPRT, FastSkulderMotorBak.SLDASM, FastSkulderMotorBakL.SLDASM, Loomo arm.SLDASM, MonteringsplateRightFinal.SLDPRT, SkulderAkslingsbrakett.SLDPRT]
2023-03-03 Endring skulder
    [Overarm2.SLDPRT, Skulder.SLDPRT, Skulderledd.SLDASM]
2023-03-03 Midt i strammeløsning
    [BracketBottom.SLDPRT, BracketBottomLeft.SLDPRT, FastSkulderMotorBak.SLDASM, FastSkulderMotorBakL.SLDASM, IdelerM4100mmFasteningScrew.SLDPRT, Loomo arm.SLDASM, SkulderAkslingsbrakett.SLDPRT, Skulderledd.SLDASM]
2023-03-03 Oppdatert budsjett og skulder ledd
    [Budsjett.xlsx, Skulder.SLDPRT, Skulderledd.SLDASM]
2023-03-05 Fortsettelse strammeløsning
    Laget geometri som gjør at det alltid er plass for strammeskruen å gå gjennom
    [BracketBottom.SLDPRT, BracketBottomLeft.SLDPRT, FastSkulderMotorBak.SLDASM, FastSkulderMotorBakL.SLDASM, Loomo arm.SLDASM, MonteringsplateLeft.SLDPRT, MonteringsplateLeftFinal.SLDPRT, SkulderAkslingsbrakett.SLDPRT]
2023-03-06 STL files and changes after getting motors
    [31mm360gMotor.sldprt, BracketBottom.SLDPRT, BracketBottom.STL, BracketBottomLeft.SLDPRT, BracketBottomLeft.STL, FastSkulderMotorBak.SLDASM, FastSkulderMotorBakL.SLDASM, Loomo arm.SLDASM]
2023-03-06 Testplate til wormgear motor
    [31mm360WormMotor.SLDPRT, Body1.SLDPRT, Body2.SLDPRT, Budsjett.xlsx, Motor test.SLDASM, Overarm.STL, Skulder.SLDPRT, Testplate.SLDPRT]
2023-03-07 Opprydning
    Rydding i filsystemet
    [15toothMod08.SLDPRT, 200gMotor.SLDPRT, 20mm77gMotor.SLDPRT, 31mm360WormMotor.SLDPRT, 31mm360gMotor.STL, 31mm360gMotor.sldprt, 45mmLedd.SLDPRT, 80toothmod08 Cut.SLDPRT]
2023-03-07 Hull i PulleystrammerAlu deler
    [FastSkulderMotorBak.SLDASM, FastSkulderMotorBakL.SLDASM, Loomo arm.SLDASM, PulleyStrammerAlu.SLDPRT, PulleystrammerBigLeft.SLDPRT, PulleystrammerBigRight.SLDPRT, PulleystrammerLid.SLDPRT, SkulderAkslingsbrakett.SLDPRT]
2023-03-07 Plate to the wormgear motor
    [31mm360WormMotor.SLDPRT, Motor test.SLDASM, Testplate.SLDPRT, Testplate.STL, Testplate2.SLDPRT, testing.SLDPRT, testing.STL]
2023-03-08 Flytta på noen filer oppretta en liten testmappe
    [BracketBottom.STL, BracketBottomLeft.STL, Motor test.SLDASM, Testplate.SLDPRT, Testplate2.SLDPRT, pulley_40_5m__09_10.STL, testing.SLDPRT]
2023-03-08 Plate for wormgear motor
    [Budsjett.xlsx, Testplate2.SLDPRT, Testplate2.STL, Testplate3.SLDPRT, Testplate3.STL]
2023-03-08 Drawing for bracket bottom and spacer
    [BracketBottomCutSpacer.SLDDRW, BracketBottomLow.SLDDRW, BracketBottomLow.SLDPRT, Budsjett.xlsx]
2023-03-08 Fikse hullene i skulderbraketter før maskinering
    [31mm360gMotor.sldprt, BracketBottom.SLDPRT, BracketBottomNewHole.STL, Skulder.SLDPRT, Skulderledd.SLDASM, TorsjonOverarmMotorBrakett.SLDPRT]
2023-03-09 Overgang mellom motorene i overarm
    [BracketBottomLeft.SLDPRT, FastSkulderMotorBak.SLDASM, FastSkulderMotorBakL.SLDASM, Loomo Body.SLDPRT, Loomo arm.SLDASM, Loomo.SLDASM, MonteringsplateRightFinal.SLDPRT, Skulder.SLDPRT]
2023-03-09 Lagd arbeidstegning av bracketbottom, spacer og monterringsplate
    [BracketBottom.SLDPRT, BracketBottomCutSpacer.SLDPRT, BracketBottomLow.SLDDRW, BracketBottomLow.SLDPRT, Budsjett.xlsx, Monteringsplate.SLDDRW, MonteringsplateRightFinal.SLDPRT]
2023-03-10 Festet i overarm
    [AkslingTorsjonOverarm.SLDPRT, AxialRotationUpperArmLid.SLDPRT, Skulder.SLDPRT, Skulderledd.SLDASM, TorsjonOverarmMotorBrakett.SLDPRT]
2023-03-13 Ferdig Mekanisk design Skulderledd
    [AkslingTorsjonOverarm.SLDPRT, AxialRotationUpperArmLid.SLDPRT, Elbow.SLDASM, Skulder.SLDPRT, Skulderledd.SLDASM, Thrust203504.SLDPRT, TorsjonOverarmMotorBrakett.SLDPRT]
2023-03-13 Flytta filer til arbedistegning
    [BracketBottomCutSpacer.SLDDRW, BracketBottomLeft.SLDPRT, BracketBottomLeftLow.SLDPRT, BracketBottomLow.SLDDRW, BracketBottomLow.SLDPRT, BracketBottomRightLow.SLDPRT, Monteringsplate.SLDDRW]
2023-03-13 Fortsettelsen på arbeidstegning
    [BracketBottomCutSpacer.SLDDRW, BracketBottomCutSpacer.SLDPRT, BracketBottomLow.SLDDRW, Monteringsplate.SLDDRW, SkulderAkslingsbrakett.SLDPRT]
2023-03-13 Elbow ymse
    [Elbow.SLDASM, Skulderledd.SLDASM, TorsionElbowSide.SLDPRT]
2023-03-14 Kabelgate i høyre arm Start
    [BelteDekselRight.SLDPRT, Elbow.SLDASM, FastSkulderMotorBak.SLDASM, FastSkulderMotorBakL.SLDASM, Loomo arm.SLDASM, Loomo.SLDASM, MonteringsplateRightFinal.SLDPRT, PulleyStrammerLeft.SLDPRT]
2023-03-14 Den grønne prinsen til Ormen Lange og arbeidstegninger
    [BracketBottomLow.SLDDRW, Grønne prinsen.SLDPRT, GrønnePrinsenHøyre.STL, GrønnePrinsenVenstre.STL, Monteringsplate.SLDDRW, PulleyStrammer.SLDDRW, Testplate3.SLDPRT]
2023-03-15 Arduino code for motor controller
2023-03-15 Litt videre på albue
    [AkslingTorsjonOverarm.SLDPRT, AlbueMotorBrakett.SLDPRT, Elbow.SLDASM, TorsionElbowSide.SLDPRT]
2023-03-15 Satt sammen albueledd
    [AlbueMotorBrakett.SLDPRT, BelteDekselRight.SLDPRT, Elbow.SLDASM, FastSkulderMotorBak.SLDASM, FastSkulderMotorBakL.SLDASM, Grønne prinsen.SLDPRT, GrønnePrinsSideUtenSkruer.SLDPRT, GrønnePrinsen.SLDPRT]
2023-03-16 Arbeidstegning og arduino kode
    [BracketBottomLeftLow.SLDPRT, BracketBottomLow.SLDDRW, BracketBottomRightLow.SLDPRT, Monteringsplate.SLDDRW, PulleyStrammer.SLDDRW, hoyremontering.STL]
2023-03-16 Utviklet albue videre
    [AlbueMotorBrakett.SLDPRT, AxialRotationUpperArmLid.SLDPRT, BelteDekselRight.SLDPRT, DekselKabelgateOrmegir.SLDPRT, Elbow.SLDASM, FastSkulderMotorBak.SLDASM, FastSkulderMotorBakL.SLDASM, GrønnePrinsSideUtenSkruer.SLDPRT]
2023-03-17 Økt armtjukkelse til Ø80
    [AlbueMotorBrakett.SLDPRT, AxialRotationUpperArmLid.SLDPRT, BelteDekselRight.SLDPRT, DekselKabelgateOrmegir.SLDPRT, Elbow.SLDASM, FastSkulderMotorBak.SLDASM, FastSkulderMotorBakL.SLDASM, GrønnePrinsSideUtenSkruer.SLDPRT]
2023-03-20 Småjusteringer albue og stl filer
    [AkslingTorsjonOverarm.SLDPRT, AkslingTorsjonOverarm.STL, AlbueMotorBrakett.SLDPRT, AlbueMotorBrakett.STL, AxialRotationUpperArmLid.SLDPRT, BelteDekselRight.SLDPRT, BracketBottom.SLDPRT, BracketBottomLeft.SLDPRT]
2023-03-21 monteringsplate arbeidstegning
    [Monteringsplate.SLDDRW]
2023-03-21 Endelig arbeidstegning
    [Monteringsplate.SLDDRW]
2023-03-31 Updated budsjett excel
    [Budsjett.xlsx]
2023-04-04 Oppdatert tegning på M10 Bolt aksling
    [M10 Bolt Aksling.SLDDRW, M10 Bolt Aksling.SLDPRT]
2023-04-04 Elbow continuation
    [AkslingTorsjonOverarm.STL, AlbueMotorBrakett.SLDPRT, AlbueMotorBrakett.STL, AxialRotationUpperArmLid.SLDPRT, AxialRotationUpperArmLid.STL, BelteDekselRight.SLDPRT, Body1.SLDPRT, Body2.SLDPRT]
2023-04-12 Oppdatert arbeidstegning
    Lagt inn mål på gjenger (pulleystrammer, hesten og monteringsplate)
    [Monteringsplate.SLDDRW, PulleyStrammer.SLDDRW]
2023-04-12 Split motorbrakett Torsjon Overarm ++
    [Elbow.SLDASM, FastSkulderMotorBak.SLDASM, FastSkulderMotorBakL.SLDASM, LokkOverarmSkulderside.SLDPRT, Loomo arm.SLDASM, Loomo.SLDASM, Monteringsplate.SLDDRW, PulleyStrammerRight.SLDPRT]
2023-04-12 Starta på arbeidstegning på aksel lund svindel og thrust bearing lid
    [AkslingTorsjonOverarm.SLDPRT, ThrustBearingLidOverarmSkulderside.SLDPRT]
2023-04-12 Lagd arbeidstegning
    [AkslingTorsjonOverarm.SLDDRW, AkslingTorsjonOverarm.SLDPRT, ThrustBearingLidOverarmSkulderside.SLDDRW, TorsjonOverarmMotorBrakettFesteside.SLDDRW, TorsjonOverarmMotorBrakettFesteside.SLDPRT, TorsjonOverarmMotorBrakettMotorside.SLDDRW, TorsjonOverarmMotorBrakettMotorside.SLDPRT]
2023-04-13 Oppdatert arbeidstegning med BOM liste
    [BracketBottomCutSpacer.SLDDRW, BracketBottomCutSpacer.SLDPRT, BracketBottomLow.SLDDRW, Monteringsplate.SLDDRW, PulleyStrammer.SLDDRW, PulleyStrammerLeft.SLDPRT, SkulderAkslingsbrakett.SLDDRW, ThrustBearingLidOverarmSkulderside.SLDDRW]
2023-04-13 Oppdatert torsjonfesteside
    [BracketBottomLow.SLDDRW, TorsjonOverarmMotorBrakettFesteside.SLDDRW, TorsjonOverarmMotorBrakettMotorside.SLDDRW]
2023-04-13 Laget hylle
    [Hylle.SLDPRT, Hylle.STL]
2023-04-13 Rydda litt i aludeler mappen
    [AkslingTorsjonOverarm.SLDDRW, AkslingTorsjonOverarm.SLDPRT, BracketBottomCutSpacer.SLDDRW, BracketBottomLow.SLDDRW, MonteringsplateLeftFinal.SLDPRT, MonteringsplateRightFinal.SLDPRT, PulleyStrammer.SLDDRW, PulleystrammerBigLeft.SLDPRT]
2023-04-13 Små endringer til monteringsplater osv
    [Budsjett.xlsx, DekselKabelgateOrmegir.SLDPRT, Elbow.SLDASM, FastSkulderMotorBak.SLDASM, FastSkulderMotorBakL.SLDASM, Loomo arm.SLDASM, Loomo.SLDASM, MonteringsplateLeftFinal.SLDPRT]
2023-04-13 Fullført arbeidstegninger til maskinering
    [AkslingTorsjonOverarm.SLDDRW, AkslingTorsjonOverarm.SLDPRT, BracketBottom.SLDPRT, BracketBottomCutSpacer.SLDDRW, BracketBottomCutSpacer.SLDPRT, BracketBottomLeft.SLDPRT, BracketBottomLeftLow.SLDPRT, BracketBottomLow.SLDDRW]
2023-04-13 Kabelføring albue
    [DekselKabelgateOrmegir.SLDPRT, Elbow.SLDASM, GrønnePrinsessen.SLDPRT, Underarm.SLDPRT]
2023-04-13 Noen små oppdateringer på dekselkabelgate
    [Budsjett.xlsx, DekselKabelgateOrmegir.SLDPRT, DekselKabelgateOrmegirIndre.SLDPRT, DekselKabelgateOrmegirIndre.STL, DekselKabelgateOrmegirYtre.SLDPRT, DekselKabelgateOrmegirYtre.STL, Elbow.SLDASM, TorsionElbowSide.STL]
2023-04-14 Kuttet hesten
    [SkulderAkslingsbrakett.SLDPRT, Skulderledd.SLDASM]
2023-04-14 Endring av arbeidstegning lokk til pulleystrammer
    [BracketBottom.SLDPRT, FastSkulderMotorBak.SLDASM, PulleyStrammer.SLDPRT, PulleyStrammerAlu.SLDPRT, PulleyStrammerBottomLeft.SLDPRT, PulleyStrammerBottomRight.SLDPRT, PulleyStrammerLeft.SLDPRT, PulleyStrammerLidLeft.SLDPRT]
2023-04-14 Lagt til bedre feste for lokk på overarm skulderside
    [AxialRotationUpperArmLid.SLDPRT, Elbow.SLDASM, Skulder.SLDPRT, Skulderledd.SLDASM, TorsjonOverarmMotorBrakett.SLDPRT]
2023-04-14 Rydda litt i Arbeidstegning mappen
    [AkslingTorsjonOverarm.SLDDRW, AkslingTorsjonOverarm.SLDPRT, BracketBottom.SLDPRT, BracketBottomCutSpacer.SLDPRT, BracketBottomLeftLow.SLDPRT, BracketBottomLow.SLDDRW, BracketBottomRightLow.SLDPRT, FastSkulderMotorBak.SLDASM]
2023-04-14 Fiksa det mystiske motor hull som ingen vet hvor kommer fra
    [DekselKabelgateOrmegir.SLDPRT, Elbow.SLDASM, FastSkulderMotorBak.SLDASM, FastSkulderMotorBakL.SLDASM, Loomo arm.SLDASM, MonteringsplateLeftFinal.SLDPRT, MonteringsplateRightFinal.SLDPRT, SkulderAkslingsbrakett.SLDPRT]
2023-04-14 Den Grønne prinsssen til Thomas
    [DekselKabelgateOrmegir.SLDPRT, Elbow.SLDASM, FastSkulderMotorBak.SLDASM, FastSkulderMotorBakL.SLDASM, GrønnePrinsessen.SLDPRT, Skulderledd.SLDASM]
2023-04-16 Endra Arbeidstegning slik at Harald kan åpne den
    [AkslingTorsjonOverarm.SLDDRW, AkslingTorsjonOverarm.SLDPRT, ElbowWormGear.SLDDRW, ElbowWormGear.SLDPRT, HoveddelOverarmSkulderside.STL, Lower.SLDPRT, Lower.STL, Monteringsplate.SLDDRW]
2023-04-16 småpuss på albue
    [BracketBottom.SLDPRT, BracketBottomLeft.SLDPRT, DekselKabelgateOrmegir.SLDPRT, Elbow.SLDASM, FastSkulderMotorBak.SLDASM, FastSkulderMotorBakL.SLDASM, GrønnePrinsSideUtenSkruer.SLDPRT, GrønnePrinsen.SLDPRT]
2023-04-16 arm etter albue smalere
    [DekselKabelgateOrmegir.SLDPRT, Elbow.SLDASM, FastSkulderMotorBak.SLDASM, FastSkulderMotorBakL.SLDASM, Loomo arm.SLDASM, Loomo.SLDASM, Skulderledd.SLDASM, Underarm.SLDPRT]
2023-04-17 Grønneprinsessen har blitt slankere
    [GrønnePrinsessen.SLDPRT, GrønnePrinsessen.STL, Lower.STL, PulleyStrammerRight.STL, SkulderAkslingsbrakett.STL, pulley_40_5m__09_10.STL]
2023-04-17 Endra pulley hjul
    [Elbow.SLDASM, Skulder.SLDPRT, Skulderledd.SLDASM, pulley_40_5m__09_10.STL, pulley_40_5m__09_10.sldprt]
2023-04-17 Redigert arbeidstegninger
    [ElbowWormGear.SLDDRW, ElbowWormGear.SLDPRT, ThrustBearingLidOverarmSkulderside.SLDDRW, ThrustBearingLidOverarmSkulderside.SLDPRT, TorsjonOverarmMotorBrakett.SLDASM, TorsjonOverarmMotorBrakett.SLDDRW, TorsjonOverarmMotorBrakettFesteside.SLDPRT, TorsjonOverarmMotorBrakettMotorside.SLDPRT]
2023-04-17 Grønne prinsessen fikk en betydelig slankekur
    [DekselKabelgateOrmegir.SLDPRT, Elbow.SLDASM, FastSkulderMotorBak.SLDASM, FastSkulderMotorBakL.SLDASM, GrønnePrinsessen.SLDPRT, Loomo arm.SLDASM, Skulderledd.SLDASM, Underarm.SLDPRT]
2023-04-17 Endring på skulder
    [Skulder.SLDPRT]
2023-04-17 Avogtilnårjegeribarnehagen grønn prinsesse ferdi
    [BracketBottom.SLDPRT, BracketBottomLeft.SLDPRT, DekselKabelgateOrmegir.SLDPRT, Elbow.SLDASM, FastSkulderMotorBak.SLDASM, FastSkulderMotorBakL.SLDASM, GrønnePrinsessen.SLDPRT, Loomo Body.SLDPRT]
2023-04-17 Kom og tørk
    [AkslingTorsjonOverarm.SLDDRW, BracketBottom.SLDPRT, BracketBottom.STL, BracketBottomLeft.SLDPRT, ElbowWormGear.SLDDRW, ElbowWormGear.SLDPRT, HoveddelOverarmSkulderside.SLDPRT, HoveddelOverarmSkulderside.STL]
2023-04-17 Forhåpentligvis ferdigstilt arbeidstegningene
    [ElbowWormGear.SLDDRW, ElbowWormGear.SLDPRT, FastSkulderMotorBak.SLDASM, PulleyStrammer.SLDPRT, PulleyStrammerAlu.SLDPRT, PulleyStrammerBottomLeft.SLDPRT, PulleyStrammerBottomRight.SLDPRT, PulleyStrammerLidLeft.SLDPRT]
2023-04-18 Endringer på pulley, skulder og motorbraket
    [AxialRotationUpperArmLid.STL, GrønnePrinsen.STL, GrønnePrinsessen.STL, LokkOverarmSkulderside.SLDPRT, LokkOverarmSkulderside.STL, Lower.STL, PulleyStrammerRight.SLDPRT, PulleyStrammerRight.STL]
2023-04-19 Endringer her og der
    [AkslingTorsjonOverarm.SLDDRW, Akslingsupport.SLDPRT, Akslingsupport.STL, DekselKabelgateOrmegir.SLDPRT, Elbow.SLDASM, FastSkulderMotorBak.SLDASM, GrønnePrinsSideUtenSkruer.SLDPRT, GrønnePrinsen.SLDPRT]
2023-04-19 STICKY FINGA
    [DekselKabelgateOrmegir.SLDPRT, Elbow.SLDASM, FastSkulderMotorBak.SLDASM, FastSkulderMotorBakL.SLDASM, Finger.SLDPRT, Loomo arm.SLDASM, Magnetisk Abs Enkoder AS5600.SLDPRT, PulleyStrammerLeft.SLDPRT]
2023-04-19 OBS Locked External References!!!!!! Har låst external references på deler til 3d print
    [Akslingsupport.SLDPRT, AlbueMotorBrakett.SLDPRT, GrønnePrinsSideUtenSkruer.SLDPRT, GrønnePrinsen.SLDPRT, ThrustBearingLidOverarmSkulderside.SLDPRT, TorsionElbowSide.SLDPRT, idler_09_4.SLDPRT, pulley_20_5m__09_8.SLDPRT]
2023-04-19 Lagde ei sleiv vettu
    [DekselKabelgateOrmegir.SLDPRT, Elbow.SLDASM, Finger.SLDPRT, Sleiv.SLDPRT, Underarm.SLDPRT]
2023-04-20 Simulering og la til gitignore på simuleringsfilene
    [AkslingTorsjonOverarm.SLDPRT, BracketBottom.SLDPRT, BracketBottomLeft.SLDPRT, DekselKabelgateOrmegir.SLDPRT, Elbow.SLDASM, FastSkulderMotorBak.SLDASM, FastSkulderMotorBakL.SLDASM, Finger.SLDPRT]
2023-04-21 Endringer på aribeidstegninger lagt inn mulighet for gjenging
    [BatteryHolder.SLDPRT, BatteryHolder.STL, DekselKabelgateOrmegir.SLDPRT, Elbow.SLDASM, ElbowWormGear.SLDDRW, ElbowWormGear.SLDPRT, FastSkulderMotorBak.SLDASM, FastSkulderMotorBakL.SLDASM]
2023-04-21 Endra navn på sammenstilling til skudlerakslingbrakett
    [SammenstillingSkulderAkslingsbrakettLeft.SLDASM, SammenstillingSkulderAkslingsbrakettRight.SLDASM, SammenstillingTorsjonOverarmMotorBrakett.SLDASM, SkulderAkslingsbrakett.SLDDRW, TorsjonOverarmMotorBrakett.SLDDRW]
2023-04-21 IMUer i skulder for absolutt enkoder
    [BracketBottom.SLDPRT, BracketBottomLeft.SLDPRT, DekselKabelgateOrmegir.SLDPRT, Elbow.SLDASM, FastSkulderMotorBak.SLDASM, FastSkulderMotorBakL.SLDASM, Finger.SLDPRT, IdelerM4100mmFasteningScrew.SLDPRT]
2023-04-24 Danielscript pwm motor og arduino loomo
2023-04-24 Android studio loomo-arduino kommunikasjon
2023-04-24 Start arduino posjekt i visual studio
    [DekselKabelgateOrmegir.SLDPRT, DekselKabelgateOrmegirIndre.SLDPRT, DekselKabelgateOrmegirIndre.STL, DekselKabelgateOrmegirYtre.SLDPRT, DekselKabelgateOrmegirYtre.STL, Elbow.SLDASM, HoveddelOverarmSkulderside.SLDPRT, HoveddelOverarmSkulderside.STL]
2023-04-26 Endra hull størrelse på monteringsplate
    Håper Roy kan maskinere disse på nytt
    [ElbowWormGear.SLDDRW, ElbowWormGear.SLDPRT, FastSkulderMotorBak.SLDASM, Monteringsplate.SLDDRW, MonteringsplateLeftFinal.SLDPRT, MonteringsplateRightFinal.SLDPRT, PulleyStrammerBottomRight.SLDPRT, PulleyStrammerLeft.SLDPRT]
2023-04-26 AS5600 encoder code
    [UnderarmBottom.SLDPRT, UnderarmBottom.STL, UnderarmLokk.SLDPRT, UnderarmLokk.STL]
2023-04-26 Startet koding i visual Studio
    Har fått til kommunikasjon over I2C til magnetsensoren, og seriell til sekundærarduino og pc (loomo) samtidig.
    [Batteri vekt kompensasjon.SLDPRT, DekselKabelgateOrmegir.SLDPRT, Elbow.SLDASM, FastSkulderMotorBak.SLDASM, FastSkulderMotorBakL.SLDASM, Loomo Body.SLDPRT, Loomo arm.SLDASM, Loomo.SLDASM]
2023-04-28 Serial og I2C communikasjon
2023-04-29 Første PID regulering og IMU library lagt til og deklarert torsjonsensorer
2023-05-02 Printa ut deler til begge armene og fjernet noen stl filer
    [BatteriCase.SLDPRT, BatteriCase.STL, BatteryHolder.SLDPRT, BatteryHolder.STL, BracketBottomLeft.STL, DekselKabelgateOrmegirIndre.STL, DekselKabelgateOrmegirYtre.STL, GrønnePrinsSideUtenSkruer.STL]
2023-05-02 Teori temaer dokument
    [KameraLokk.STL]
2023-05-04 Oppdatert kretstegning og endra pulley med gjennomgangbolt til askling
    [pulley_20_5m__09_8.sldprt]
2023-05-04 Simulation study for FEM analasys
    [AlbueMotorBrakett.SLDPRT, Elbow.SLDASM, Skulderledd.SLDASM, Underarm.SLDPRT]
2023-05-05 kabel hull til elbow motor + mest rapport fremmover
    [AlbueMotorBrakett.SLDPRT, DekselKabelgateOrmegir.SLDPRT, Elbow.SLDASM, FastSkulderMotorBak.SLDASM, FastSkulderMotorBakL.SLDASM, Loomo arm.SLDASM, Skulderledd.SLDASM, Underarm.SLDPRT]
2023-05-07 fiksa loomo modell slik at armen er festet riktig sted
    [Arm.SLDPRT, Bracket.SLDPRT, DekselKabelgateOrmegir.SLDPRT, Elbow.SLDASM, FastSkulderMotorBak.SLDASM, FastSkulderMotorBakL.SLDASM, Kragemekanisme.SLDASM, Loomo Body.SLDPRT]
2023-05-07 fortsettelse kinematics
2023-05-09 Bilder av armbevegelse og klar for FEM analyse
    [DekselKabelgateOrmegir.SLDPRT, Elbow.SLDASM, FastSkulderMotorBak.SLDASM, FastSkulderMotorBakL.SLDASM, Loomo.SLDASM, Skulderledd.SLDASM, Underarm.SLDPRT]
2023-05-09 FEM start
    [AxialRotationUpperArmLid.SLDPRT, DekselKabelgateOrmegir.SLDPRT, Elbow.SLDASM, FastSkulderMotorBak.SLDASM, FastSkulderMotorBakL.SLDASM, Loomo arm.SLDASM, Skulder.SLDPRT, Skulderledd.SLDASM]
2023-05-10 FEM analyse cont
    [Skulderledd.SLDASM]
2023-05-10 More FEM
    [AkslingTorsjonOverarm.SLDPRT, Elbow.SLDASM, Skulderledd.SLDASM]
2023-05-10 FEM cont
    [Skulderledd.SLDASM]
2023-05-11 Figurer til arduino-loomo kode
    [Hub.SLDPRT, RoterendePlate.SLDPRT, pulley_40_5m__09_10.sldprt]
2023-05-11 Endringer på arduino kode, mer generell
2023-05-11 Mann på Loomo oioi
    [BelteDekselRight.SLDPRT, FastSkulderMotorBak.SLDASM, FastSkulderMotorBakL.SLDASM, Loomo arm.SLDASM, Loomo.SLDASM, Skulderledd.SLDASM]
2023-05-11 FEM analyse snart ferdig nå gøbben
    [AkslingTorsjonOverarm.SLDPRT, BelteDekselRight.SLDPRT, Elbow.SLDASM, FastSkulderMotorBak.SLDASM, FastSkulderMotorBakL.SLDASM, Loomo arm.SLDASM, Skulderledd.SLDASM]
2023-05-12 lagt inn bilder + endringene gjort på aksling torsion
    [AlbueMotorBrakett.SLDPRT, GrønnePrinsen.SLDPRT, TorsionElbowSide.SLDPRT]
2023-05-13 Litt bilder workspace og homeposition
    [DekselForBelte.SLDPRT, DekselForBelteR.SLDASM, FastSkulderMotorBak.SLDASM, FastSkulderMotorBakL.SLDASM, GrønnePrinsessen.SLDPRT, Loomo Body.SLDPRT, Loomo arm.SLDASM, Loomo.SLDASM]
2023-05-15 Fiksa tegninger for n'te gang
    [AkslingTorsjonOverarm.SLDDRW, PulleyStrammerBottomLeft.SLDPRT, PulleyStrammerBottomRight.SLDPRT, PulleyStrammerLidLeft.SLDPRT, PulleyStrammerLidRight.SLDPRT, PulleyStrammerRight.SLDPRT, SammenstillingPulleystrammerLeft.SLDASM, SammenstillingPulleystrammerRight.SLDASM]
2023-05-16 Final steps of FEM
    [AkslingTorsjonOverarm.SLDPRT, AlbueMotorBrakett.SLDPRT, Elbow.SLDASM, GrønnePrinsSideUtenSkruer.SLDPRT, GrønnePrinsen.SLDPRT, Skulderledd.SLDASM, TorsionElbowSide.SLDPRT]
2023-05-16 Masse diverse småtteri
    Bilder, speed calc, konvergens, osv.
    [Konvergens FEM.xlsx]
2023-05-16 Force and bending diagram ++
    [DekselKabelgateOrmegir.SLDPRT, Elbow.SLDASM, GrønnePrinsSideUtenSkruer.SLDPRT, Skulder.SLDPRT, Skulderledd.SLDASM, TorsjonOverarmMotorBrakett.SLDPRT, Underarm.SLDPRT]
2023-05-16 Krise hjemme
    [AkslingTorsjonOverarm.SLDPRT, FastSkulderMotorBak.SLDASM, FastSkulderMotorBakL.SLDASM, GrønnePrinsessen.SLDPRT, Loomo arm.SLDASM, Loomo.SLDASM, Skulder.SLDPRT, Skulderledd.SLDASM]
2023-05-21 Mål endringer på armen
    Klargjøring til å printe på fancy printer
    [Akslingsupport.STL, AlbueMotorBrakett.STL, AxialRotationUpperArmLid.SLDPRT, AxialRotationUpperArmLid.STL, BatteriCase.SLDPRT, BatteriCase.STL, BracketBottom.SLDPRT, BracketBottom.STL]
2023-05-24 Mål endringer på deler til stratasys
    [AkslingTorsjonOverarm.SLDDRW, AkslingTorsjonOverarm.SLDPRT, AxialRotationUpperArmLid.SLDPRT, AxialRotationUpperArmLid.STL, BatteriCaseV2.SLDPRT, BatteriCaseV2.STL, Elbow.SLDASM, HoveddelOverarmSkulderside.SLDPRT]
2023-05-24 Presentasjon og mål endringer på deler
    [LokkOverarmSkulderside.SLDPRT, Underarm.SLDPRT, UnderarmBottom.SLDPRT, UnderarmLokk.SLDPRT]
2023-05-24 Solidworks Tweaks deksel klaringer
    [BracketBottomLeft.SLDPRT, DekselKabelgateOrmegir.SLDPRT, Elbow.SLDASM, FastSkulderMotorBak.SLDASM, FastSkulderMotorBakL.SLDASM, Loomo arm.SLDASM, Loomo.SLDASM, Skulderledd.SLDASM]
2023-05-25 Krage mekanisme
    [15toothMod08.STL, 200gMotor.SLDPRT, 200gMotor.STL, 31mm360WormMotor.STL, 31mm360gMotor.STL, Aksling.SLDPRT, Aksling.STL, AkslingTorsjonOverarm.SLDPRT]
2023-05-28 Batteri ++
    [AxialRotationUpperArmLid.SLDPRT, BMSV2.SLDPRT, BMSV2.STL, BatteriCaseV3.SLDPRT, BatteriCaseV3.STL, DekselKabelgateOrmegir.SLDPRT, DekselKabelgateOrmegirIndre.SLDPRT, DekselKabelgateOrmegirYtre.SLDPRT]
2023-05-28 Konstant PWM og beltdeksel endringer
    [BelteDekselLeftMain.SLDPRT, BelteDekselLeftMain.STL, Elbow.SLDASM, FastSkulderMotorBak.SLDASM, FastSkulderMotorBakL.SLDASM, Loomo arm.SLDASM, Skulder.SLDPRT, Skulderledd.SLDASM]
2023-05-28 Hand print
    [HAND.STL, LeftHand.STL, RightHand.STL]
